wsarachai/smartfarm/web-server/wireframes/smart_farm_camera/screen.png

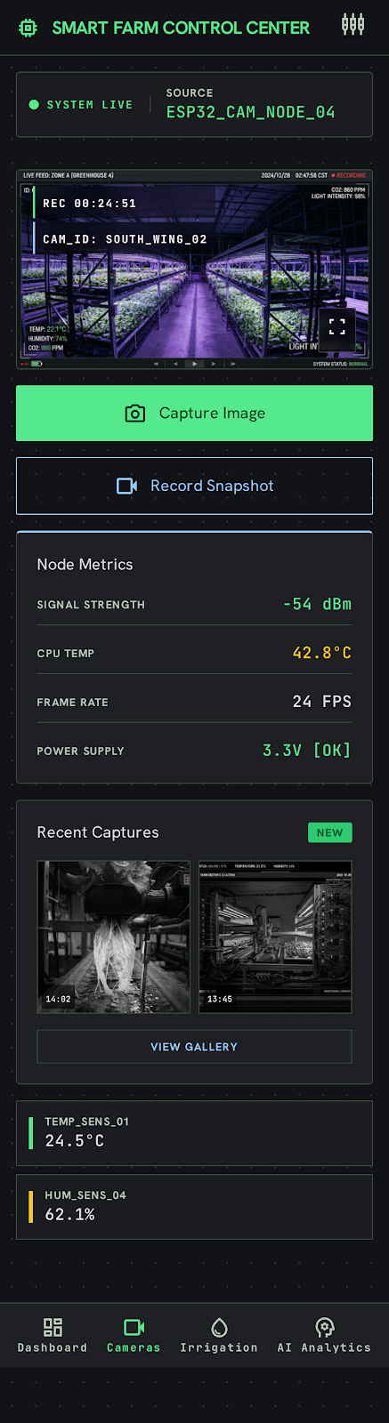
web-server/wireframes/smart_farm_camera/screen.png
