wsarachai/smartfarm/web-server/scripts/leaf.jpg

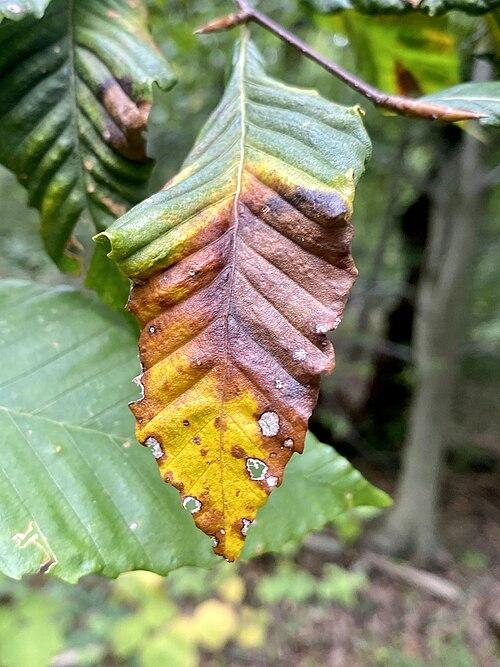
web-server/scripts/leaf.jpg
