wsarachai/smartfarm/water-temp-node/README.md

# water-temp-node

**Solar-powered** (24 V bank) **water + air** LoRa sensor node on a
**NUCLEO-WL55JC1** (STM32WL55JC). Every 15 minutes it wakes from **Stop2**, powers
the sensor rail through an **AO3401A P-MOSFET**, reads **water temperature from up
to six DS18B20 probes**, **air temperature + humidity from three remote SHT45s**
and **CO2** (Sensirion **SCD41** over I2C), measures the 24 V bank
through a divider, transmits one compact **AS923** LoRa uplink, and sleeps. It is
**uplink-only** — it never listens for a downlink.

**The MCU box lives outside the mushroom house; only sensors go inside.** Four
sensors sit at four places on ≤5 m cables, all four on the same I2C bus behind a
TCA9548A bus switch: SHT45s at the head of the house, at the tail, and one outside
as an ambient reference — and the **SCD41 at mid-house, at crop level**, which is
where CO2 stratifies and where a ventilation decision has to be made.

The probes and SHT45s sit on the **one gated rail**, so that part of the front-end
is dead between wakes; each probe owns its own pin, so all six convert **in
parallel** and rail-on time is one 750 ms conversion no matter how many are fitted.
**Everything is gated, including CO2** — the SCD41 takes on-demand single shots, so
so nothing on this board needs an always-on rail. See
[CO2 on a solar node](#co2-on-a-solar-node).

It does **not** talk to the web-server directly (that server only speaks HTTP on
the WiFi LAN). The uplink is received by [`../lora-gateway`](../lora-gateway),
whose host [`bridge`](../lora-gateway/bridge) POSTs it to `/api/v1/telemetry`.

```
water-temp-node --LoRa AS923--> lora-gateway --USB CDC JSON--> bridge.js --HTTP--> web-server:3000
```

## Signal chain

```
RTC wake (Stop2, 15 min)
  -> gate ON  (P-MOSFET, active-low)  -> settle 10 ms
  -> DS18B20 x6 start convert (12-bit, 750 ms)  <- one pin each, so they run
  |                                                CONCURRENTLY: 750 ms total,
  |                                                not 6 x 750 ms
  -> read probes P0..P5  (~7 ms each, inside the 750 ms conversion)
  -> SHT45 x3 read (~10 ms each)       -> air temp + humidity, one mux
  |                                       channel at a time (all three are 0x44,
  |                                       each at the end of its own 5 m cable)
  -> SCD41 CO2: 2x single shot (~10 s) <- LAST, still INSIDE the gate: 205 mA
  |  on mux ch3, warm-up shot discarded    bursts must not overlap the probes
  -> gate OFF -> park 1-Wire + I2C pins analog
  -> bank_mv: VREFINT (real VDDA) + 300k/30k divider on PB3
  -> pack 36-byte v5 frame -> LoRa TX (923.2 MHz SF9BW125, 14 dBm)
  -> radio cold-sleep -> Stop2
```

## Hardware / wiring

> Building the **real hardware**? It is two PCBs joined by a **cable** — the
> NUCLEO-WL55JC1 plus a large custom front-end carrying the six probe connectors,
> **four connectors for the remote I2C branches** (three SHT45s and the SCD41),
> the TCA9548A bus switch, the P-MOSFET gate, protection, and
> **a 24 V solar input feeding two off-the-shelf buck modules**. Logic
> travels one **2×19 IDC ribbon on morpho CN10**; the 3.3 V feed takes its own
> keyed 2-pin lead to **CN6**, deliberately kept off the ribbon so a reversed
> insertion cannot put the supply rail on a GPIO. See
> [`docs/hardware-interface.md`](docs/hardware-interface.md) for the full CN10
> pin map, the **eighteen** signals crossing the joint, the ribbon keying trick,
> the schematic + BOM, the power tree, and the bring-up order; and
> [`docs/sourcing-th.md`](docs/sourcing-th.md) for part numbers and where to buy
> them in Thailand. The wiring below is the bench setup.

Board: **NUCLEO-WL55JC1**. Powered from a **24 V solar bank behind a charge
controller** → a buck → **3.3 V** on the 3V3 domain at CN6-4. Radio uses the
board's TCXO (DIO3-powered) and the on-board RF switch.

Pins (see [`include/node_config.h`](include/node_config.h) — change to match your
build). They deliberately avoid the RF-switch pins **PC3/PC4/PC5**, SWD
**PA13/PA14**, and the TCXO **PB0**:

| Function | Pin  | Morpho |
|---|---|---|
| DS18B20 `DQ_P0` (1-Wire) | PA5  | CN10-11 |
| DS18B20 `DQ_P1` (1-Wire) | PA4  | CN10-17 |
| DS18B20 `DQ_P2` (1-Wire) | PA9  | CN10-19 |
| DS18B20 `DQ_P3` (1-Wire) | PC2  | CN10-21 |
| DS18B20 `DQ_P4` (1-Wire) | **PB8** | **CN10-27** |
| DS18B20 `DQ_P5` (1-Wire) | PB10 | CN10-25 |
| **SDA** (3x remote SHT45 via mux) | PA11 | CN10-5 |
| **SCL** (3x remote SHT45 via mux) | PA12 | CN10-3 |
| Sensor-rail power gate (P-MOSFET) | PA8  | CN10-16 |
| **24 V bank sense** (ADC1_IN2) | **PB3** | **CN10-31** |
| Signal grounds | — | CN10-9, CN10-20 |
| 3.3 V in (from the buck) | — | CN6-4 (own cable) |
| Debug log (**USART1 → 3-pin header**) | **PB6** (TX) / **PB7** (RX) | CN10-35/37 |

> **`DQ_P4` moved from PC1 to PB8** in 2026-08 to free PC1 for the Senseair S88.
> That sensor is gone and PC1 is free again, but `DQ_P4` **stays on PB8** — moving
> it back would churn the connector contract and the board for no gain.
> **The debug log moved off the ST-LINK VCP**: feeding 3V3 directly at CN6-4
> leaves the ST-LINK unpowered, and PA2/PA3 are not on the morpho at all — so
> USART1 goes out to a 3-pin header for a USB-serial adapter instead.

Every logic pin is on **morpho CN10**, so one 2×19 IDC ribbon carries the whole
interface — see [`docs/hardware-interface.md`](docs/hardware-interface.md). The
probe pins are not arbitrary: they were placed so each DQ line sits next to a
**GND or NC** position in the ribbon, since six bit-banged open-drain lines
sharing one flat cable is the new signal-integrity problem in this build.

The gate is **PA8** (CN10-16), inside the DQ block, so it rides the same ribbon
as the lines it powers. It has no boot strap on the WL (BOOT0 is PH3), so it
resets floating — which is what lets the external 100 k pull-up hold the sensor
rail off before firmware runs.

I2C is **PA11/PA12**. The alternatives are worse: I2C1 is **PA9/PA10** (PA9 is a
probe) and I2C3 is **PB10/PB11** (PB10 is a probe, and PB11 is the Nucleo's
LED3).

**The three SHT45s add no pins and no connector signals.** They sit behind a
TCA9548A bus switch, which is itself an I2C device. That is not a convenience:
the SHT4x address is fixed at the factory (`SHT45-AD1B` = 0x44, no address pin),
so three of them cannot share a bus — and power-gating them individually does
not work either. An unpowered SHT45 still clamps SDA/SCL to its own VDD through
its ESD diodes, so the bus pull-ups phantom-power it to ~2.7 V, where it answers
at 0x44 regardless. **What has to be switched is the bus, not the power.**

**The mux now does a second job.** Each channel drives its own ≤5 m cable to a
sensor somewhere else in the greenhouse, so only the selected branch's ~320 pF
loads the bus at any moment — three 5 m branches never add up to a 15 m bus. That
is what keeps plain I2C viable at this distance, and it is why the **downstream
pull-ups are 2.2 kΩ, not 4.7 kΩ**: at 5 m, 4.7 kΩ gives a 1.27 µs rise against a
1000 ns budget, so it passes on a bench lead and starts NACKing on the real cable.
**Nothing sits upstream of the switch** — the SCD41's 0x62 would not collide with
0x44, but it is 5 m away, and an unswitched branch would park ~320 pF on the bus
permanently. It gets **channel 3**. See
[`docs/hardware-interface.md`](docs/hardware-interface.md) §3.

Power gate + sensors (Q1 = **AO3401A** or equivalent — pick on the
R_DS(on) @ V_GS = −2.5 V row, not the −4.5 V one). The six probes, their pull-ups,
the bus switch, every I2C pull-up **and the SCD41** sit on the switched rail —
there is no always-on sensor rail in this revision:

```
                3V3 ──S│ Q1    │D──┬──────────── VSENS (switched rail)
                       │ (P-ch)│   │
              100k ────┤gate   │   ├──[4.7k]──┬── DQ_P0  (PA5)
             to 3V3    │       │   │          └── VDD P0
   (OFF when Hi-Z) ────┘       │   ├──[4.7k]──┬── DQ_P1  (PA4)
                  PA8 ─────────┘   │          └── VDD P1
              (LOW = ON)           │              ... x6, one per probe ...
                                   ├──[4.7k]──┬── DQ_P5  (PB10)
                                   │          └── VDD P5
                                   │
                                   ├──[4.7k]───── SDA (PA11) ─┬─ TCA9548A (0x70)
                                   ├──[4.7k]───── SCL (PA12) ─┘        │
                                   │      ch0 ─[2.2k x2]══5 m══ SHT45 #0  หัว
                                   │      ch1 ─[2.2k x2]══5 m══ SHT45 #1  ท้าย
                                   │      ch2 ─[2.2k x2]══5 m══ SHT45 #2  นอก
                                   └── GND rail ── probe + sensor GNDs

  24 V ─[F1]─[Q2]─[TVS]───[U7 TSR1-2433]─ 3.3 V ──> CN6-4 and Q1 above
```

The buck is a single **off-the-shelf module** — Traco **TSR 1-2433**, 36 V input,
1 A, three pins, no external network. A second module supplied 5 V until revision
2.0; nothing on the current BOM needs it. It
replaced two discrete TI LM5164 converters in revision 1.0 (2026-09) because ~30
hand-tuned passives were too much to get right on a first board; the price is a
36 V ceiling instead of 100 V and ~1.15 Wh/day of module no-load current. Why a
**36 V** module and not a cheaper 28 V one: a 24 V bank sits at 28.8 V every
afternoon. See [`docs/hardware-interface.md`](docs/hardware-interface.md) §5 *The
buck modules* ([ฉบับภาษาไทย](docs/hardware-interface.th.md)); the LM5164 design is
kept in [`docs/hardware-interface-back.md`](docs/hardware-interface-back.md).

Which probe is which is fixed by **which connector it is plugged into** — SKIP
ROM, no ROM addressing, so two probes can never get swapped in software and there
is no "which address is the inlet?" problem. That is also why each probe gets its
own pin rather than sharing one bus: a shorted or flooded probe takes down only
itself.

The **air** sensors are the opposite problem. All three SHT45s answer to the same
factory-fixed 0x44, so which one is which is decided by **which mux channel it is
wired to** (`I2C_MUX_CHANNELS` in `node_config.h`) — channel = frame slot =
dashboard metric name. Three identical parts are otherwise indistinguishable, so
silkscreen the channel number **and the destination** next to each: `CH0 หัว`,
`CH1 ท้าย`, `CH2 นอก`. Swapping two branch cables silently exchanges "inside the
greenhouse" for "ambient reference" and the data still looks plausible — label
both ends. CO2 needs no channel at all; it is not on this bus.

Fewer than six probes fitted? Leave the pin table alone and just don't plug them
in. An unconnected line sees no presence pulse, goes out as the invalid sentinel,
and is dropped by the gateway rather than showing up as a convincing `0.00 °C`.

> **The 205 mA CO2 burst is back on this rail**, and it is the number that sizes
> Q1: `VSENS` carries the six probes (~9 mA), the SHT45s and mux (µA) and the
> SCD41's 175 mA typ / 205 mA max bursts. `main.cpp` reads the SCD41 **last**, so
> those bursts never overlap a DS18B20 conversion. The AO3401A passes 205 mA with
> two orders of magnitude to spare. See the settle-time
> constraint in [`docs/hardware-interface.md`](docs/hardware-interface.md),
> because more bulk fights the 10 ms `DS_POWER_SETTLE_MS`.

## What goes over the air

A **36-byte binary** frame, **v5** (see
[`src/lora/lora_packet.h`](src/lora/lora_packet.h)):

| Bytes | Field | Notes |
|---|---|---|
| 0 | magic | `0xA5` = v5. Rejects noise and older/newer frames cheaply |
| 1–3 | node id, seq, flags | `flags` says which fields below are valid |
| 4–7 | probe 0, probe 1 | int16 centi-°C; sentinel `0x8000` if the probe failed |
| 8–9 | `battery_mv` | uint16 mV |
| 10–13 | `air_temp`, `humidity` | int16 centi-°C, uint16 %RH ×100 — **SHT45 #0** |
| 14–15 | `pressure` | uint16 deci-hPa; **0 on this node** (no barometer) |
| 16–17 | `co2` | uint16 ppm |
| 18–25 | probes 2, 3, 4, 5 | int16 centi-°C each; sentinel if absent or failed |
| 26–33 | air sensors 1, 2 | int16 centi-°C + uint16 %RH×100 each; sentinels if absent |
| 34–35 | reserved, CRC-8 | CRC over bytes 0..34 |

The gateway expands it to the server's `{device_id, metrics}` JSON and adds
`rssi`/`snr`. LoRa PHY (`src/lora/lora_params.h`) — **AS923 / 923.2 MHz / SF9 /
BW125 / CR4-5 / syncword 0x34-equiv / 14 dBm** — must stay identical to the
gateway's copy. Airtime grows ~41 ms per 8 bytes at SF9BW125: 20 B ≈ 185 ms,
28 B ≈ 226 ms, 36 B ≈ 267 ms. The whole v3→v5 growth costs ~4 mAs every 15
minutes — irrelevant beside a 24 V solar bank.

**Versioning:** v1 (12 B, water temps + battery), v2 (18 B, + BME280 ambient),
v3 (20 B, + CO2) and v4 (28 B, + probes 2–5) are still on the wire from other
builds and are **byte-for-byte unchanged**. Each version only appends, so a
field never moves, and `lora_packet_unpack()` accepts all five — an older node
in the field keeps working against a current gateway, and keeps its metric
names. (Verified, not asserted: regenerating the test vectors from the C header
after adding v5 reproduced every earlier vector byte for byte.)

**Probes 0 and 1 stay in the original two temperature slots.** That is deliberate:
the gateway labels them `temp_hot` and `temp_cold` by default (see
`lora-gateway/include/gateway_config.h`), so the dashboard's existing history is
one continuous series across the upgrade instead of dead-ending beside four new
ones. Probes 2–5 arrive as `temp_p2`…`temp_p5`. Rename any of them in the
gateway config to suit the install — but a renamed probe starts a **new** series.

**Air sensor 0 likewise keeps the v2 slots** (bytes 10–13) and its AIR/HUM flags,
so `air_temp`/`humidity` history is continuous; sensors 1 and 2 arrive as
`air_temp_2`/`humidity_2` and `air_temp_3`/`humidity_3`.

**v4 and v5 add no valid-flags, and cannot:** all eight `flags` bits are already
spoken for. Probes 2–5 and air sensors 1–2 therefore signal "no reading" with
sentinels — `LORA_TEMP_INVALID` for temperatures, `LORA_HUM_INVALID` (0xFFFF, a
value outside humidity's 0..10000 range) for humidity. Ask `lora_probe_valid()`,
`lora_air_valid()` and `lora_hum_valid()` rather than testing either mechanism by
hand — they know which slot uses which. A version that needs a genuine new flag
has to add a second flags byte.

`LORA_FLAG_SHT` (bit 7) says air temp/humidity came from an **SHT45** rather than
a BME280. Same units either way, so the receiver need not branch on it; it exists
so a swapped sensor is visible in the logs rather than silently changing what the
numbers mean.

## CO2 on a solar node

**This section has been rewritten twice, and the direction is the point.** It was
about rationing an SCD41; then about a Senseair S88 that could not be rationed at
all; it is now about a CO2 sensor that costs **0.0136 Wh/day** and is no longer
worth arguing about. The sensor is a **Sensirion SCD41** on I2C at `0x62`, on mux
channel 3, at mid-house crop level, and it is **power-cycled with everything else**.

### Why it goes back behind the gate

An NDIR CO2 sensor usually has to run continuously — warm-up, a filter needing
measurement history, a self-calibration period measured in days. None of those
bind here:

- **Warm-up** is handled per wake by a **throwaway first shot**. The first
  single-shot after the rail comes up reads low, so `scd41_read_single_shot(1)`
  takes two and discards one. ~10 s of sensor-on time per wake, and not optional.
- **Filter history** is irrelevant: τ63 is 60 s and the node samples every 15 min.
- **ASC is switched off here anyway** (below), so the 8-day period is moot — and
  the datasheet's warning that *ASC is unavailable in power-cycled single-shot
  operation* costs us nothing as a result.

So the node has **no always-on sensor rail at all**, and `SENS_GATE` can recover a
latched CO2 branch exactly as it recovers a latched SHT45 branch.

### ASC must be OFF, and this is the most dangerous default in the design

The SCD41 ships with **ASC enabled** and a 400 ppm baseline target. ASC assumes the
sensor sees outdoor air at 400 ppm for >3 minutes every week and calibrates the
lowest reading it has seen toward that.

**A mushroom house never reaches 400 ppm.** A well-ventilated fruiting room sits at
800–1500 ppm. ASC would drag every reading down, the controller would believe the
air is fine, the house would be **under-ventilated** — long stems, small caps —
and nothing on the dashboard would look wrong.

`scd41_ensure_asc()` therefore enforces ASC-off on **every** wake (a 1 ms read;
EEPROM is written only on a mismatch), and recalibration is done by hand with
**FRC in outdoor air at each crop changeover**, when the house is emptied and
cleaned anyway. Full procedure and its preconditions:
[`docs/hardware-interface.md`](docs/hardware-interface.md) §3.

### Why that is affordable

| Load | Draw | Per day |
|---|---|---|
| U7 no-load input current | 1 mA typ @ 24 V | **0.58 Wh** |
| MCU + LoRa + probes + SHT45s | ~1 mA avg @ 3.3 V | <0.1 Wh |
| Module conversion loss | | ~0.1 Wh |
| **SCD41** — 96 power-cycled single shots | 154 mC per useful shot | **0.0136 Wh** |
| **Total** | | **≈0.8 Wh/day** |

Against ~80 Wh/day from a 20 W panel at four peak-sun hours the whole node is
**~1 %** of the yield — of which **72 % is a regulator doing nothing** and the CO2
sensor is 3 %. There is no load left on this node worth optimising.

### The one thing the SCD41 is worse at

The SCD41 dissipates ~1.5 mW averaged, nowhere near enough to hold itself above
the dew point — and a sensor that runs a degree or two warm gets that protection
for free. **This board has no passive answer to condensation**, in a house that is
misted daily. A **heater resistor pad is laid out at the head and left DNP**:
~220 Ω / ~50 mW would add ~1.2 Wh/day, taking the node to ~2.0 Wh/day, still less
than this board drew before the 5 V rail was deleted. Whether to fit it is a
question for the SHT45 dew-point logs, not for the schematic.

### Staged deployment

1. **Build the full board and all cabling now** — including J12, the channel-3
   pull-ups and the heater pad. Nothing needs rework later.
2. **Deploy with the three SHT45s only.** Log T/RH for a few weeks, including at
   mid-house where the SCD41 will go, and compute the **dew point** — that, not RH
   alone, is what the sensor cares about.
3. **Fit the SCD41** (the `SEK-SCD41-SENSOR` breakout is the sane choice — the bare
   part is reflow-only), and the heater resistor only if the logs call for it.

Mount it in a vented, splash-protected housing with the **diffusion opening facing
downward**, behind a PTFE/Gore membrane, **never sealed**, and **not in a misting
nozzle's path**. **No radiation shield** — a mushroom house is dark.

**Why the F103 prototype also uses an SCD41:** it always did. The 2026-08 detour to
a Senseair part applied to the WL55 node only, and revision 2.0 brings the two back
into line — the same `src/scd41.{h,cpp}` driver now serves both.

## Build / flash

```
cd water-temp-node
pio run                 # first run pulls the STM32duino core (large, one-time)
pio run -t upload       # flash over the onboard ST-LINK (USB)
pio device monitor      # 115200 — shows the per-wake debug log
```

**Verified: compiles clean** — RAM 3.1%, Flash 15.5% of the STM32WL55JC.

### Why `framework = arduino`, not `stm32cube`

PlatformIO's ststm32 platform has **no** STM32Cube framework for the STM32WL
family (no `framework-stm32cubewl` package exists — the `nucleo_wl55jc` board only
advertises `arduino`/`zephyr`). **STM32duino *is* the STM32Cube HAL underneath**,
so the HAL SubGHz driver, DS18B20, and battery code compile unchanged; we only
enable `HAL_SUBGHZ` via `include/hal_conf_extra.h` (STM32duino's HAL override
hook). Deep sleep (Stop2) + RTC wake are done with **raw HAL** in `main.cpp` — we
avoid the STM32duino Low Power/RTC libraries because their 2.0.0 releases
hard-`#error` against the core PlatformIO bundles.

An **external ST-Link V2** works too (same `upload_protocol = stlink`): wire
SWDIO=PA13, SWCLK=PA14, NRST, GND, 3V3 and remove the onboard ST-LINK jumpers.

## Config knobs (`include/node_config.h`)

- `NODE_ID` — this node's wire id (the gateway maps it to `water-temp-01`).
- `WAKE_INTERVAL_S` — sleep interval (default `900`).
- `DS_*` pins, `DS_POWER_SETTLE_MS`, `DS_CONVERT_MS`.
- `I2C_SDA_PIN` / `I2C_SCL_PIN` / `I2C_CLOCK_HZ`, `SHT45_ADDR`,
  `I2C_MUX_ADDR` / `I2C_MUX_CHANNELS` (channel = greenhouse location = frame slot).
- `I2C_POWER_SETTLE_MS` — **10 ms**. It was 1000 ms for years, on the strength of
  an SCD41 power-up figure the datasheet does not give: SCD4x v1.7 Table 7 says
  **30 ms**. Corrected in 2026-09.
- `SCD41_ADDR` (`0x62`), `SCD41_MUX_CHANNEL` (3), **`SCD41_ASC_ENABLED` (0 — the
  factory default is 1 and it is wrong here)**, `SCD41_SITE_ALTITUDE_M` (330 m for
  Maejo; EEPROM-backed, unlike ambient pressure which would be lost every wake),
  and `SCD41_FRC_TARGET_PPM` for the service recalibration. See
  [CO2 on a solar node](#co2-on-a-solar-node).
- `VBAT_SENSE_PIN` / `VBAT_SENSE_NUM` / `VBAT_SENSE_DEN` — the 24 V divider.
  Change these two if you fit different resistors, or every reported bank voltage
  is wrong by exactly that ratio.
- `DEBUG_UART_ENABLED` / `DEBUG_UART_TX_PIN` / `DEBUG_UART_RX_PIN` — USART1 out to
  the 3-pin header, **not** the ST-LINK VCP. Comment out to drop serial logging.
- **Gone:** every `S88_*` symbol, and `CO2_ENABLED` / `CO2_EVERY_N_WAKES` /
  `CO2_SINGLE_SHOT_WARMUP` — the SCD41 is read once per wake with no pacing, and
  its warm-up is a discarded shot rather than a delay.

## DS18B20 bring-up test on an STM32F103C8T6 (Blue Pill)

While the NUCLEO-WL55JC1 boards are on back-order, extra PlatformIO envs let you
validate the DS18B20 wiring + the **same `ds18b20.cpp` driver** the node ships, on
a cheap Blue Pill — no LoRa, no sleep, just the sensor. **Hardware-verified:** both
probes read real, independent room temperature (`hot=23.75 C  cold=23.87 C`).

Two envs, differing only in how the readings get off the board — both reuse
`src/ds18b20.cpp` unchanged (`build_src_filter` compiles only that driver +
`src/test/ds18b20_test_main.cpp`; the WL55 firmware is filtered out, and vice-versa):

| Env | Output path | When to use |
|-----|---|---|
| `bluepill_f103c8` | **USB CDC** (`Serial`, the board's micro-USB) | if the board's native USB enumerates |
| `bluepill_f103c8_semihosting` | **semihosting over SWD** (the ST-Link) | no working USB / UART / adapter |

Output (~1 Hz), either path:

```
DS18B20 F103 test | hot=PB6 cold=PB7 | direct 3V3, external 4.7k pull-up
hot=23.62 C  cold=23.18 C
hot=23.62 C  cold=FAULT(no presence)
```
(the banner always states which pull-up the running build configured, so it can
never silently disagree with the wiring — see the switch below)

### Diagnosing a bad bus (`bluepill_f103c8_dump`)

When the test prints `FAULT(crc)` or a suspicious `0.00 C`, flash the dump env
instead: it probes each DQ pin electrically at boot, then prints the **raw 9-byte
scratchpad** + CRC verdict per probe (same pins, semihosting over SWD).

```
pio run -e bluepill_f103c8_dump -t upload
openocd -f interface/stlink.cfg -f target/stm32f1x.cfg \
        -c init -c "arm semihosting enable" -c "reset run"
```

Reading the output:

| Line | Meaning |
|---|---|
| `pull-up=1 pull-down=1` | a strong external pull-up (4.7 kΩ) is winning — wiring OK |
| `pull-up=1 pull-down=0` | **no** external pull-up; only the MCU's internal ~40 kΩ |
| `pull-up=0 pull-down=0` | DQ **held low** by something stronger than 40 kΩ — a short to GND, or the pull-up resistor tied to the GND rail instead of 3V3 |
| `FF FF FF …` | nothing drives the line — probe absent / DQ not connected |
| `00 00 00 …` | line stuck low (the fake-`0.00 C` case `ds18b20_read()` rejects) |
| `LO HI 4B 46 7F FF 0C 10 CRC` | a healthy 12-bit probe |

### Wiring (direct 3V3, **no** MOSFET gate — that's only for battery saving)

| Function | Blue Pill pin |
|---|---|
| DS18B20 **hot** data | PB6 |
| DS18B20 **cold** data | PB7 |
| Heartbeat LED (onboard) | PC13 |

Each probe: VDD→3V3, GND→GND, DQ→PB6/PB7, plus a pull-up on each DQ line.

**As wired today: an external 4.7 kΩ per line, DQ→3V3** — hardware-verified reading
both probes, with the dump env reporting `pull-up=1 pull-down=1` on both (the 4.7 kΩ
beating the MCU's internal 40 kΩ pull-down is the proof the resistor really is on
3V3). Mind that polarity: tying it to GND instead holds the bus low and every read
comes back all-zero (see *Diagnosing a bad bus* above).

### The pull-up switch

The pull-up is a fact about the **wiring**, so it lives in **one** place —
`ds18b20_pullup` in `[bluepill_base]` — and every F103 env interpolates it. Change
it there and reflash; no env needs touching:

| `ds18b20_pullup =` | Wiring it matches |
|---|---|
| *(empty)* | external 4.7 kΩ DQ→3V3 per probe; `ds18b20_init()` uses `GPIO_NOPULL` **← current** |
| `-D DS18B20_INTERNAL_PULLUP` | no resistor; the MCU's internal ~40 kΩ. Weaker, so a **short** bench bus only — never the WL55 node or a real cable run |

The WL55 env is separate and never sets the flag: the real node always has its
external resistors.

### Probe cable runs (design point: 5–10 m)

The node is built for **5–10 m** probe cables, and every value in
`docs/hardware-interface.md` §3 is sized for that. Plain 1-Wire covers it with
room to spare, and is good to **10–20 m** (per Maxim/ADI **AN148**) if you ever
extend — you do **not** need RS-485 for any of this. In particular a **MAX485 cannot
go on the DS18B20 data line**: 1-Wire is bidirectional open-drain with the
direction reversing *inside each bit slot*, while a MAX485 is a directional
differential UART transceiver (needs `DE/RE` control) and the DS18B20 only speaks
single-ended 1-Wire. RS-485 only helps if a small MCU at the sensor end digitizes
the reading first and sends it as serial/Modbus (an architecture change, warranted
only past ~30 m).

For a reliable 5–10 m run:

1. **External pull-up 4.7 kΩ** DQ→VDD **at the MCU end**. At the 10 m end of the
   range on Cat5 (~56 pF/m) the line reaches VIH in **~3 µs**, against the 9 µs
   the firmware allows between releasing the line and sampling it — 3× margin.
   Use **3.3 kΩ** if you run shielded (roughly double the capacitance per metre),
   and **2.2 kΩ** only past ~15 m. **Do not** use the internal ~40 kΩ
   (`DS18B20_INTERNAL_PULLUP`) on any real cable run — it is a bench-only
   shortcut.
2. **Twisted pair: DQ twisted with GND** (its return); VDD on a separate conductor.
   Cat5/telephone cable, one pair = DQ+GND. Biggest single reliability factor.
3. **3-wire power (VDD)** — already how the node is wired; never parasitic on long lines.
4. Optional: ~**100 Ω series** at the MCU DQ pin (reflection damping) + **100 nF**
   across VDD/GND at the sensor end.
5. Each probe is its **own point-to-point line** (separate GPIO) — no stubs, the
   most forgiving topology.

```
MCU DQ ──[100Ω opt]──┬─────── twisted pair (DQ + GND) ─────── DQ (DS18B20)
       [4.7k]→VDD ────┘
VDD ───────────────────── separate conductor ──────────────── VDD (+100nF)
GND ───────────────────── (paired with DQ) ─────────────────── GND
```

**Firmware:** no timing change needed (standard-speed slots are valid to ~100 m).
When you fit the external pull-up, **remove `-D DS18B20_INTERNAL_PULLUP`** from the
node env so `ds18b20_init()` uses `GPIO_NOPULL` + your resistor. If passive 2.2 kΩ
proves marginal past ~20–30 m, escalate to a **DS2483/DS2482** (I²C→1-Wire) or
**DS2480B** (UART→1-Wire) line-driver IC with hardware active pull-up.

### Option A — USB CDC (`bluepill_f103c8`)

```
pio run -e bluepill_f103c8 -t upload     # ST-Link V2 on the SWD header
pio device monitor -e bluepill_f103c8    # the board's micro-USB COM port
```

**USB caveat:** many Blue Pill *clones* have a wrong USB pull-up (R10 = 10 kΩ
instead of 1.5 kΩ) and never enumerate — no COM port appears at all. Fix with a
1.5 kΩ from PA12→3V3, or just use the semihosting env below (no USB needed).

### Option B — semihosting over SWD (`bluepill_f103c8_semihosting`)

Prints through the **ST-Link/SWD** you already use to flash — no USB, UART, or
adapter. The output shows only while a **debugger is attached** (the board's
`BKPT` faults standalone), so this is a bench-viewing mode.

**CLI:**
```
pio run -e bluepill_f103c8_semihosting -t upload
# then stream the readings (Ctrl+C to stop):
openocd -f interface/stlink.cfg -f target/stm32f1x.cfg \
        -c "init" -c "arm semihosting enable" -c "reset run"
```
(OpenOCD ships with PlatformIO at
`~/.platformio/packages/tool-openocd/bin/openocd` — pass its
`.../openocd/scripts` dir via `-s` if run from outside PlatformIO.)

**VSCode (PlatformIO extension):**
1. Bottom **status bar** → switch the active env to `env:bluepill_f103c8_semihosting`.
2. **Run → Start Debugging** (**F5**). It builds, flashes, and the env's
   `debug_extra_cmds = monitor arm semihosting enable` turns semihosting on.
3. It halts at `main()` — press **Continue (F5)**.
4. Readings stream into the **Debug Console** (`Ctrl+Shift+Y`); if empty, check the
   OpenOCD **Terminal** tab. Stop with the ■ button.

> Use **Debug (F5)**, not the Upload/Monitor buttons — the Monitor button grabs a
> serial COM port (semihosting isn't one), so it shows nothing here.

### The full prototype node (`bluepill_f103c8_node`)

Beyond the DS18B20-only bring-up envs, two envs run the **whole node** on the
Blue Pill — every sensor, the shared v3 frame, and an external **SX1278 at
433 MHz** talking to [`../lora-pi-receiver`](../lora-pi-receiver). This is where
the SHT45 and SCD41 drivers get their real-hardware hours before the WL55 boards
arrive, since both envs build the **same driver files** the WL55 node ships
(`build_src_filter`, no copies).

| Env | Output | Use |
|---|---|---|
| `bluepill_f103c8_node` | semihosting over SWD | Bench, with a debugger attached |
| `bluepill_f103c8_node_standalone` | none (silent) | Flash once, run from any USB/battery supply |

```
pio run -e bluepill_f103c8_node -t upload
```

Wiring beyond the DS18B20 probes (PB6/PB7):

| Part | Bus | Address | Supplies |
|---|---|---|---|
| BME280 | I2C2 PB10=SCL / PB11=SDA | `0x76` | `pressure` **only** |
| SHT45 | same bus | `0x44` | `air_temp` + `humidity` |
| SCD41 | same bus | `0x62` | `co2` |
| SX1278 | SPI1 | — | NSS=PA4 SCK=PA5 MISO=PA6 MOSI=PA7 RESET=PB0 DIO0=PB1 |

One pair of 4.7 k pull-ups serves the whole I2C bus. I2C**2** is used because
I2C1's PB6/PB7 are the DS18B20 probes.

Two behaviours differ from the WL55 node, deliberately:

- **The SCD41 runs in periodic mode** (free-running, one sample per 5 s) rather
  than single-shot. This board is mains-powered and awake continuously, so
  periodic is both simpler and more accurate — the cell stays warm.
- **The SHT45 supersedes the BME280 for temp/RH** (±0.1 °C / ±1 %RH beats it on
  both), and `LORA_FLAG_SHT` is set to record that. If the SHT45 does not answer,
  the BME280 takes those two fields back and the flag clears — a dead SHT45 costs
  accuracy, not telemetry.

The measured pressure is fed back to the SCD41 (`scd41_set_ambient_pressure`) for
CO2 density compensation, which is worth roughly 1 % of reading per 10 hPa.

> **Power:** the SCD41 peaks at ~205 mA. A marginal 3V3 LDO browns out
> mid-measurement, and the symptom looks like a flaky I2C bus rather than a power
> problem. Use a supply with headroom.

### Driver note
`ds18b20_read()` rejects an all-zero scratchpad: a data line stuck low (missing
pull-up / short) returns all zeros, which passes CRC (`crc8(0..0)=0`) and would
otherwise decode to a **fake 0.00 °C**. It now reports a fault instead — this
guard benefits the WL55 node too.

## Status / caveats

- **Compiles clean, but not yet hardware-verified.** `pio run` succeeds (RAM
  3.1%, Flash 15.5%); the radio, sleep current, and DS18B20 timing still need a
  real board. Do the first flash + monitor before trusting it.
- **The SHT45 and SCD41 are compile-verified only on this board.** Both drivers
  are hand-rolled from the datasheets against the shared
  [`sensirion_i2c`](src/sensirion_i2c.h) helper — no vendor library — and the
  wire format is cross-checked end to end (see below), but neither part has been
  on a WL55 yet. Bring them up on the F103 prototype env first, where the same
  driver files run against real sensors.
- **The frame format IS verified**, in both directions: the C header is compiled
  on the host to generate wire vectors, and
  [`lora-pi-receiver/test_lora_packet.py`](../lora-pi-receiver/test_lora_packet.py)
  decodes them, covering v1 through v5, a partly-populated six-probe node, a
  three-SHT45 node with only one sensor answering, a slot-0 failure, the
  `probe_valid()` / `air_valid()` / `hum_valid()` rules, and every single-byte
  corruption. Run it after any change to the wire format.
- The LoRa driver ([`src/lora/subghz_lora.c`](src/lora/subghz_lora.c)) is a lean,
  self-contained SX126x command driver over `HAL_SUBGHZ` — it does **not** vendor
  the full STM32CubeWL SubGHz_Phy middleware. RF-switch truth table and TCXO
  config are taken verbatim from ST's NUCLEO-WL55JC BSP.
- Advisory sensor only — this node never actuates anything.
