wsarachai/smartfarm/water-temp-node/docs/hardware-interface.th.md

# water-temp-node — สเปกอินเทอร์เฟซฮาร์ดแวร์

> **หมายเหตุเรื่องการแปล**
> เอกสารนี้เป็นฉบับแปลภาษาไทยของ [`hardware-interface.md`](hardware-interface.md)
> **ฉบับภาษาอังกฤษถือเป็นฉบับจริง (source of truth)** — เมื่อสองฉบับขัดแย้งกัน
> ให้ยึดฉบับภาษาอังกฤษ และเมื่อแก้สเปก **ต้องแก้ฉบับภาษาอังกฤษด้วยเสมอ**
> เพราะเป็นไฟล์ที่โค้ดเฟิร์มแวร์อ้างถึง
>
> สิ่งที่ **ไม่แปล** โดยเจตนา: เลขรุ่นอุปกรณ์ ชื่อขา (`PA8`) ชื่อสัญญาณ (`SENS_GATE`)
> ตำแหน่งขั้วต่อ (`CN10-16`) ชื่อตัวแปร/มาโครในโค้ด พาธไฟล์ และหน่วยวัด
> เพราะแปลแล้วใช้งานจริงไม่ได้
>
> **แผนภาพ ASCII ทุกอันคงไว้เป็นภาษาอังกฤษ** เพราะอักษรไทยมีความกว้างไม่คงที่
> ในฟอนต์ monospace ถ้าแปลข้างในแผนภาพจะเพี้ยนทั้งหมด — คำอธิบายภาษาไทยอยู่รอบ ๆ แทน

งานประกอบจริง (ไม่ใช่บนเบรดบอร์ด) คือ **PCB สองแผ่นเชื่อมกันด้วยสายเคเบิล**:

| บอร์ด | คืออะไร | มีอะไรอยู่บนนั้น |
|---|---|---|
| **Brain (สมอง)** | NUCLEO-WL55JC1 (ของสำเร็จรูป) | STM32WL55JC, ภาคสื่อสารวิทยุ, RF switch, TCXO, สายอากาศ, ST-LINK |
| **Front-end (ภาคหน้า)** | PCB ออกแบบเองขนาดใหญ่ ตามสเปกนี้ | **ขั้วต่อโพรบ DS18B20 6 ตัว**, **ขั้วต่อกิ่ง I2C ระยะไกล 4 เส้น** หลัง bus switch (SHT45 3 ตัว + หัววัด CO2 SCD41), เกตรางไฟ AO3401A, ตัวต้านทานพูลอัพ, วงจรป้องกันสาย, **อินพุตโซลาร์ 24 V และโมดูล buck สำเร็จรูปหนึ่งตัว** |

Front-end เป็น **บอร์ดใหญ่ที่วางอยู่ข้าง ๆ Nucleo** ไม่ได้ซ้อนทับ และเชื่อมกันด้วย
สายสั้น ๆ เอกสารนี้กำหนดรอยต่อนั้น: ตัวขั้วต่อ, สัญญาณที่วิ่งข้าม, และวงจร front-end
ที่อยู่หลังขั้วต่อ

ทุกอย่างในเอกสารนี้คือ **ข้อตกลงที่เฟิร์มแวร์สมมติไว้แล้ว** จุดไหนที่ค่าถูกบังคับด้วยโค้ด
จะมีการอ้างอิงโค้ดกำกับ — แก้อย่างหนึ่งต้องแก้อีกอย่างตามด้วย

- ตารางขาในเฟิร์มแวร์: [`include/node_config.h`](../include/node_config.h)
- การจัดการเกตและโหมดสลีป: [`src/main.cpp`](../src/main.cpp)
- รูปแบบเฟรมที่ส่งออกอากาศ (probe → metric): [`src/lora/lora_packet.h`](../src/lora/lora_packet.h)
- คำแนะนำเรื่องความยาวสาย: [README → *Probe cable runs*](../README.md)

> **รุ่น 2.0 (2026-09) — เซนเซอร์ CO2 เป็น Sensirion SCD41 บน I2C และระบบ RS-485
> หายไปพร้อมกับ Senseair S88 ที่ต้องใช้มัน** S88 ต้องการ 4.5–5.25 V และ Modbus
> บนสายคู่ดิฟเฟอเรนเชียล 5 ม. ซึ่งทำให้บอร์ดนี้ต้องมีเรกูเลเตอร์ตัวที่สอง ตัวรับส่งสองตัว
> LDO ที่หัววัด และสัญญาณ 3 เส้นจากทั้งหมด 18 เส้นที่ข้ามรอยต่อ ส่วน SCD41 ใช้ไฟ 3.3 V
> เดียวกับทุกอย่างบนบอร์ด พูด I2C ที่มี **CRC-8 ทุก word** และวัดแบบ single shot
> ตามคำสั่ง — มันจึงเข้าไปเป็นกิ่งที่สี่ของ bus switch และกลับไปอยู่หลัง `SENS_GATE`
> พร้อมกับ front-end ที่เหลือ contract ลดเหลือ **15 สัญญาณ** ราง 5 V และโมดูลของมัน
> ถูกลบ และงบพลังงานทั้งโหนดลงมาเหลือ **~0.8 Wh/วัน**
>
> สถานที่ติดตั้งคือ **โรงเรือนเพาะเห็ด** ซึ่งเป็นเหตุผลที่ต้องเปลี่ยนชิ้นส่วน: มืด,
> 90–95 %RH, ฉีดหมอก, 15–30 °C และมี CO2 สูงโดยตั้งใจ ข้อความที่เขียนไว้สำหรับ
> โรงเรือนพืช — ภาระความร้อนจากแดด, radiation shield, พืชดึง CO2 ลงตอนกลางวัน —
> ถูกแก้ทั้งเอกสาร ไม่ใช่เฉพาะในหัวข้อนี้
>
> รุ่น S88 เก็บไว้ที่ [`hardware-interface-s88.th.md`](hardware-interface-s88.th.md)
> และยังอ่านได้อยู่ เพราะ **S88 GH** คือทางถอยถ้าความต้องการช่วงวัด CO2 ขยายเกิน
> 400–5000 ppm ที่ SCD41 ระบุไว้ **ห้ามสร้างบอร์ดจากมัน**

> **รุ่น 1.0 (2026-09) — buck แบบ discrete ถูกถอดออกแล้ว** เดิม U6/U7 คือคอนเวอร์เตอร์
> constant-on-time TI LM5164 สองตัว พร้อมวงจรฉีดริปเปิล Type-3 ที่คำนวณด้วยมือ
> อุปกรณ์ passive ราว 30 ชิ้น และวงจรแบ่งแรงดัน UVLO ที่ใช้ร่วมกัน ทั้งหมดถูกแทนที่ด้วย
> **โมดูลสำเร็จรูป Traco TSR 1 สองตัว** (5 V และ 3.3 V, SIP-3, สามขาต่อตัว)
> ดีไซน์ LM5164 ฉบับเต็มเก็บไว้โดยไม่แก้ที่
> [`hardware-interface-back.th.md`](hardware-interface-back.th.md) — อ่านได้ถ้าวันหนึ่ง
> อยากได้กระแสนิ่งระดับ µA หรือพิกัดอินพุต 100 V กลับมา แต่ **ห้าม** สร้างบอร์ดจากมัน
> หัวข้อ *โมดูล buck* ใน §5 บันทึกว่าอะไรเปลี่ยนไปและอะไรที่ยอมเสีย

---

## 1. รอยต่อ — เลือกบัสแบบไหน และทำไม

ขั้วต่อโพรบ 6 ตัว ขั้วต่อสายเซนเซอร์ระยะไกล 4 เส้น วงจรป้องกัน buck สองตัว และอินพุตโซลาร์ 24 V
**ใส่ไม่ลง** ในขนาดบอร์ด ARDUINO 68.6 × 53.4 มม. เมื่อ front-end ต้องเป็นบอร์ดใหญ่
ของตัวเอง มันก็กลายเป็นอุปกรณ์ที่ต่อผ่านสาย ไม่ใช่อะไรที่เสียบซ้อนบน Nucleo อีกต่อไป
— และนั่นคือสิ่งที่ตัดสินคำถามเรื่องขั้วต่อ

### ข้อสรุปที่แนะนำ

**ใช้สองสาย แยกกันโดยเจตนา:**

| สาย | ส่งอะไร | ปลายฝั่ง Nucleo | ปลายฝั่ง Front-end |
|---|---|---|---|
| **สัญญาณ** | `SENS_GATE`, `DQ_Pn` 6 เส้น, `SDA`, `SCL`, `GND` 2 เส้น | **ซ็อกเก็ต IDC 2×20 ครอบ morpho CN10** โดยล้ำออกไปหนึ่งคอลัมน์ | box header **2×20** แบบมีกรอบและมีคีย์ |
| **ไฟเลี้ยง** | `V3V3_MCU`, `GND` | **ซ็อกเก็ต 1×8 ครอบเต็ม ARDUINO CN6** (ต่อจริงแค่ตำแหน่ง 4/6/7) | **เฮดเดอร์ 1×8 สะท้อนพินเอาต์ของ CN6 ทีละขา** |

สายสัญญาณ: ระยะพิทช์ 2.54 มม. สายแพสีรุ้ง **40 เส้น ใช้ทั้งเส้น** เข้าหัว IDC
แบบกดทั้งแพทั้งสองปลาย ความยาว **ไม่เกิน 30 ซม.**

### ทำไมเลือกแบบนี้ ไม่เลือกแบบอื่น

**ทำไมใช้ morpho ไม่ใช้ ARDUINO header** ขั้วต่อ ARDUINO เป็นแถวเดี่ยว 4 ชุด
(8/6/8/10) และให้ขา I/O ของ MCU มาแค่ **24 ขา** ถ้าต่อสายไปที่นั่นก็ต้องใช้ 4 สาย
และยังเข้าไม่ถึง PA8 ส่วน morpho **CN10** เป็นขั้ว 2×19 ชุดเดียวที่มีสัญญาณลอจิก
ครบทุกเส้นที่ดีไซน์นี้ต้องใช้ — สายแพเส้นเดียวจบ

**ทำไมใช้ซ็อกเก็ตยาวเต็มขั้ว ไม่ใช้ตัวสั้น** ซ็อกเก็ตที่กินความยาว CN10 ทั้งขั้ว
เหลือที่ให้วางน้อยที่สุด ในขณะที่ซ็อกเก็ต 1×10 บน ARDUINO header หรือ 2×5
บนบางส่วนของ morpho เสียบเยื้องได้ — และการเยื้องแค่หนึ่งตำแหน่งจะเลื่อนสัญญาณ
ทุกเส้นพร้อมกัน ซึ่งเป็นความผิดพลาดชนิดที่ไล่หาได้ทั้งบ่าย

> **ข้ออ้างนี้เคยแข็งกว่านี้ และความต่างนั้นสำคัญ** ตอนที่ซ็อกเก็ตยังเป็น 2×19
> มันกว้างเท่า CN10 พอดี การเยื้องจึง *เป็นไปไม่ได้ในเชิงเรขาคณิต* แต่ซ็อกเก็ต
> 2×20 ที่รุ่นนี้ใช้กว้างกว่าหนึ่งคอลัมน์ การเยื้องจึงกลับมาเป็นไปได้อีกครั้ง
> และสิ่งที่กันไว้แทนคือรูคีย์ที่อุดไว้ (§1 *การใส่คีย์ให้สายแพสัญญาณ*)
> การป้องกันจึงกลายเป็น *ขั้นตอนในการประกอบ* แทนที่จะเป็น *คุณสมบัติของชิ้นส่วน*
> ซึ่งอ่อนแอกว่า เพราะขั้นตอนถูกข้ามได้ **ห้ามข้าม**

**ทำไมแยกไฟออกมาเป็นอีกสาย และข้อนี้สำคัญที่สุด** ซ็อกเก็ตสายแพบนแถวขาที่ไม่มีกรอบ
*สามารถ* ถูกกดเสียบ **กลับด้าน 180°** ได้ ถ้า `V3V3_MCU` อยู่บนสายแพเส้นนั้น
การเสียบผิดครั้งเดียวจะเอาแรงดันรางไฟไปลงขา GPIO แต่ถ้าแยกไฟไปอยู่บนสาย 2 ขา
ที่มีคีย์ของตัวเอง สิ่งที่แย่ที่สุดที่สายแพกลับด้านทำได้ก็แค่ลัด GPIO แบบ open-drain
ลงกราวด์สองสามขาและสลับสัญญาณกัน — น่ารำคาญ แก้ได้ ไม่ถึงกับบอร์ดพัง
อีกทั้งยังกันกระแสจ่ายของไฟเลี้ยงออกจากมัดสายที่มี 1-Wire แบบ bit-bang 6 เส้น

**ทำไมไม่ใช้สายจัมเปอร์ Dupont** เพราะเป็นการย้ำหัว 12 จุดแยกกัน ไม่มีล็อก ไม่มีคีย์
ทุกจุดคือความล้มเหลวหน้างานที่รอรอบร้อน-เย็นรอบแรก ถ้าจะใช้แบบนั้นตอนทดสอบก็ได้
แต่อย่าส่งของออกไปแบบนั้น

**ทำไมไม่ใช้ RS-485 หรือลิงก์แบบดิฟเฟอเรนเชียลต่อโพรบ** เพราะที่ความยาวเท่านี้ไม่จำเป็น
สายโพรบยาว **5–10 ม.** และ 1-Wire ธรรมดารับได้ถึง 10–20 ม. (Maxim **AN148**)
ส่วน MAX485 *ต่อบนสาย 1-Wire ไม่ได้เลย*
ดูหัวข้อ "Probe cable runs" ใน README เกิน ~30 ม. ค่อยขยับไปใช้ไอซีไดรเวอร์ DS2483
ไม่ใช่ไปเปลี่ยนสายระหว่างสองบอร์ดนี้

### การทำคีย์ให้สายแพสัญญาณ — ทำเถอะ แทบไม่มีต้นทุน

**CN10-6 เป็น NC บน Nucleo** ดังนั้น:

1. **ตัด (หรือถอดบัดกรี) ขา CN10-6 ออก** ขานี้ไม่ได้ต่อกับอะไรเลย —
   วัดด้วยมัลติมิเตอร์ยืนยันก่อน แล้วค่อยเอาออก
2. **อุดรูที่ตรงกันในซ็อกเก็ต IDC** ด้วยตัวอุดคีย์ที่มักแถมมากับซ็อกเก็ต IDC
   หรือหยดอีพ็อกซี

รูที่อุดแล้วเสียบลงบนขาที่มีอยู่ไม่ได้ และ **CN10-6 เป็นขาเดียวที่ถูกตัดออก**
ซ็อกเก็ตจึงลงได้ในตำแหน่งเดียวเท่านั้นและปฏิเสธทุกตำแหน่งที่เหลือ
ตัวหยุดเชิงกายภาพดีกว่าลูกศรบนซิลค์สกรีนเสมอ

> **คีย์นี้ทำงานมากกว่าที่ออกแบบไว้ และนั่นคือสิ่งที่ทำให้ขั้ว 2×20 ปลอดภัย**
> J7 เป็นขั้ว **2×20** และสายเป็นริบบอน 40 ทางพร้อมซ็อกเก็ต 40 ทางทั้งสองปลาย (§4a)
> เพราะ 2×19 ไม่ใช่ขนาดที่ผู้ผลิต IDC รายใดทำ ที่ปลายฝั่ง Nucleo ซ็อกเก็ตจึงกว้างกว่า
> CN10 อยู่หนึ่งคอลัมน์ มันจะลงตรงหรือลงเหลื่อมหนึ่งคอลัมน์ก็ได้ — และการเหลื่อม
> หนึ่งคอลัมน์คือการเลื่อนทุกสัญญาณไปสองขา ซึ่งเป็นความล้มเหลวที่ร้ายที่สุดของขั้วนี้
>
> คีย์กันไว้อยู่แล้ว ตัวอุดอยู่ที่ตำแหน่ง 6 ซึ่งอยู่บนแถว **เลขคู่** ถ้าเลื่อนซ็อกเก็ต
> ไปหนึ่งคอลัมน์ ตัวอุดจะไปตรงกับ CN10-4 ซึ่งมีขาอยู่ ถ้าหมุน 180° ตัวอุดจะย้ายไปอยู่
> แถว **เลขคี่** ซึ่งขา 1 ถึง 37 มีอยู่ครบทุกขา จากสี่วิธีที่ซ็อกเก็ตนี้ถูกยกมาเสียบได้
> มีสามวิธีที่ถูกปิดด้วยรูที่อุดไว้เพียงรูเดียว
>
> ดังนั้น: ตัดขา CN10-6 และอุดรูที่ 6 ในรุ่นนี้มันไม่ใช่ของแถม

สิ่งที่ควรทำเพิ่มเติม:

- **พิมพ์สามเหลี่ยมชี้ขา 1 บนซิลค์สกรีน** ที่ box header ของ front-end
  และทำเครื่องหมายว่าแถบสีแดงของสายแพ = ขา 1 ที่ปลายทั้งสองข้าง
- **ขนาดขั้วที่ต่างกัน** ป้องกันการสลับสองสายอยู่แล้ว: สายแพ 40 ทาง เทียบกับสายไฟ 2 ขา

```
   ┌────────────────────────────────────────────┐
   │  FRONT-END PCB (large, custom)             │
   │  J1..J6 probe terminals · Q1 gate · TVS    │   <- this spec
   │  U3 mux -> J9..J12 (3x SHT45 + SCD41, 5 m) │
   │  U7 TSR 1-2433 · J14 24 V solar in         │
   │                                            │
   │   [2x20 box header, keyed]      [2-pin]    │
   └────────────┬──────────────────────┬────────┘
                │ 40-way ribbon        │ 3V3 + GND
                │ <= 30 cm             │ (keyed, latching)
   ┌────────────┴──────────────────────┴────────┐
   │  NUCLEO-WL55JC1                            │
   │  CN10 (2x19 morpho)              CN6 (1x8) │
   │  [antenna keep-out — keep the cable clear] │
   └────────────────────────────────────────────┘
```

**เชิงกล:** สายไม่ควรรับแรงใด ๆ ให้ใส่ **เสารองไนลอน M3** ที่รูยึดของบอร์ดทั้งสอง
และเพิ่ม **จุดรั้งสาย/เคเบิลไทร์** ภายในระยะ 30 มม. จากขั้วต่อแต่ละตัว ซ็อกเก็ต IDC
ที่ยึดด้วยแรงเสียดทานของหน้าสัมผัสเพียงอย่างเดียวจะคลอนหลวมจากการสั่นสะเทือน
และการขยายตัวตามอุณหภูมิ นานก่อนที่อะไรทางไฟฟ้าจะเสียเสียอีก

**เขตห้ามวางใกล้สายอากาศ:** อย่าเดินสายทั้งสองเส้นข้ามภาค RF ของ Nucleo หรือ
ขั้ว **CN12 SMA** ในดีไซน์นี้ทำได้ง่ายเพราะ front-end ไม่ได้อยู่เหนือภาควิทยุ —
แต่สายแพยาว 30 ซม. ที่พาดผ่านสายอากาศจะทำให้จูนเพี้ยน จึงต้องเดินสายอย่างตั้งใจ

---

## 2. สัญญาณที่วิ่งข้ามขั้วต่อ

**สิบห้า** สัญญาณ ตารางนี้ถือเป็นข้อตกลงตายตัว — นี่คือตัวอินเทอร์เฟซ
ตำแหน่งอื่น ๆ ทั้งหมดบน CN10 **ปล่อยไม่ต่อ** ที่ฝั่ง front-end

สังเกตสิ่งที่ *ไม่* อยู่ในตาราง: เซนเซอร์ระยะไกล **สี่ตัว** — SHT45 สามตัวกับ SCD41 —
**ไม่เพิ่มสัญญาณเลยแม้แต่เส้นเดียว** แม้จะอยู่คนละที่กันสี่จุดในโรงเรือนเห็ด
เพราะถูกแยกกันบน front-end ด้วย bus switch ซึ่งตัวมันเองก็เป็นอุปกรณ์ I2C (§3)
นั่นคือคุณสมบัติที่มีค่าที่สุดของอินเทอร์เฟซนี้: **จำนวนเซนเซอร์ไม่ผูกกับความกว้าง
ของขั้วต่อ**

> **ข้อตกลงเดินทาง 12 → 18 → 15 ให้ดูทิศทางของมัน** รุ่น 2026-08 ทำให้มัน *โต*:
> Senseair S88 เข้ามาแทน SCD41 และพูด UART/Modbus ไม่ใช่ I2C จึงพา
> `S88_TX`/`S88_RX`/`S88_DE` เข้ามา; ไฟเลี้ยงโซลาร์ 24 V ทำให้ MCU อยู่หลัง buck
> และทำให้วิธีอ่านแบตด้วย VREFINT ใช้ไม่ได้ จึงพา `VBAT_SENSE` เข้ามา; และ ST-LINK
> ที่ไม่ได้รับไฟทำให้ล็อกดีบักต้องมีขาของตัวเอง คือ `DBG_TX`/`DBG_RX`
>
> รุ่น 2.0 (2026-09) ทำให้มัน *เล็กลง*: SCD41 กลับมา สัญญาณ `S88_*` ทั้งสามจึงหายไป
> **`PC1`, `PC0` และ `PA7` ว่างแล้วและจงใจปล่อยไม่ใช้** — front-end ต้องไม่ต่อมัน
> ส่วน `DQ_P4` **อยู่ที่ PB8 ต่อไป** แม้ `PC1` จะว่างแล้ว การย้ายกลับจะทำให้ตารางนี้
> ตารางขาในเฟิร์มแวร์ และเลย์เอาต์บอร์ดต้องรื้อโดยไม่ได้อะไรกลับมา
>
> **บอร์ด front-end รุ่นเก่าใช้กับรุ่นนี้ไม่ได้ในทุกขั้น** — และบอร์ด 18 สัญญาณไม่ได้
> แค่มีของเกิน มัน *ผิด*: มันมีราง 5 V ที่ดีไซน์นี้ไม่ได้สร้างขึ้นมา

| สัญญาณ | ขา WL55 | ขั้วต่อ | ทิศทาง | คุณสมบัติทางไฟฟ้า | ถูกบังคับโดย |
|---|---|---|---|---|---|
| `V3V3_MCU` | — | **CN6-4** (`3V3`) | เข้าสู่ brain | **3.3 V ที่ผ่านการเรกูเลต** จาก buck 24 V, พีค ≤250 mA | §5 — *ไม่ใช่แบตเตอรี่อีกต่อไป* |
| `GND` (ไฟ) | — | **CN6-6/7** | — | เส้นทางกลับของไฟเลี้ยง แยกเส้นของตัวเอง | — |
| `SENS_GATE` | **PA8** | **CN10-16** | ออกจาก brain, push-pull | **LOW** = เปิดรางไฟ; Hi-Z = ปิดผ่าน 100 k | `node_config.h` `DS_PWR_*` |
| `DQ_P0` | **PA5** | **CN10-11** | สองทาง, open-drain | 1-Wire; พักเป็น **analog** ตอนสลีป | `node_config.h` `DS_PROBE_BUSES` |
| `DQ_P1` | **PA4** | **CN10-17** | สองทาง, open-drain | 1-Wire | `DS_PROBE_BUSES` |
| `DQ_P2` | **PA9** | **CN10-19** | สองทาง, open-drain | 1-Wire | `DS_PROBE_BUSES` |
| `DQ_P3` | **PC2** | **CN10-21** | สองทาง, open-drain | 1-Wire | `DS_PROBE_BUSES` |
| `DQ_P4` | **PB8** | **CN10-27** | สองทาง, open-drain | 1-Wire — ย้ายออกจาก PC1 ในปี 2026-08 และ **อยู่ที่นี่ต่อไป** | `DS_PROBE_BUSES` |
| `DQ_P5` | **PB10** | **CN10-25** | สองทาง, open-drain | 1-Wire | `DS_PROBE_BUSES` |
| `I2C_SDA` | **PA11** | **CN10-5** | สองทาง, open-drain | I2C @ 100 kHz; พักเป็น **analog** ตอนสลีป | `node_config.h` `I2C_SDA_PIN` |
| `I2C_SCL` | **PA12** | **CN10-3** | ออกจาก brain, open-drain | I2C @ 100 kHz | `node_config.h` `I2C_SCL_PIN` |
| `VBAT_SENSE` | **PB3** | **CN10-31** | เข้าสู่ brain, **analog** | แรงดันแบงก์ 24 V ที่ผ่านวงจรแบ่งแล้ว 0–3.0 V — ADC1_IN2 | `battery.cpp` |
| `DBG_TX` | **PB6** | **CN10-35** | ออกจาก brain, push-pull | USART1 TX, 115200 → เฮดเดอร์ดีบัก 3 ขา | `DEBUG_UART_*` |
| `DBG_RX` | **PB7** | **CN10-37** | เข้าสู่ brain | USART1 RX ← เฮดเดอร์ดีบัก | `DEBUG_UART_*` |
| `GND` (สัญญาณ) | — | **CN10-9**, **CN10-20** | — | เน็ตเดียวกัน (GND); ต่อ **ทั้งสองจุด** — ดู *Return เทียบกับ Guard* | — |
| `VSENS` | — | — | ภายใน front-end | ไฟ 3.3 V ที่ **ถูกสวิตช์** ไปเลี้ยงโพรบ, กิ่ง I2C **ทั้งสี่เส้น**, mux **และ** พูลอัพทั้งหมด | `main.cpp` `gate_on()` |

**front-end สร้างรางไฟภายในรางเดียวคือ `VSENS`** ถ้าเจอรางที่สองในแบบเก่าหรือบอร์ดเก่า
บอร์ดนั้นไม่ใช่ดีไซน์นี้ — ดูหมายเหตุด้านบน

**การกำหนดขนาด `V3V3_MCU`:** โหลดเดี่ยวที่ใหญ่ที่สุดยังเป็น **~150 mA ของ LoRa TX**
แต่ตอนนี้ SCD41 อยู่บนรางนี้ด้วยและกระแสพุ่งถึง **175 mA typ / 205 mA max** ขณะวัด
ทั้งสองตัวนี้ **ไม่เคยทำงานทับกัน** — วิทยุจะได้รับไฟหลังจากเกตปิดแล้วเท่านั้น
(§7 และ `main.cpp`) รางไฟจึงออกแบบที่ ~205 mA ไม่ใช่ผลบวกของทั้งสอง
ส่วนโพรบทั้งหกเพิ่มอีกราว 9 mA ตอนแปลงค่า

> **`VBAT_SENSE` เป็นสายอนาล็อกเส้นเดียวในสายแพ** อยู่ที่ CN10-31 ระหว่าง LED3
> (CN10-30 ปล่อยว่าง) กับ AGND (CN10-32 ปล่อยว่าง) ซึ่งเป็นย่านที่เงียบที่สุดบน
> ขั้วต่อ นี่คือเหตุผลที่มันไปอยู่ตรงนั้น ไม่ใช่ขาว่างข้าง ๆ สาย 1-Wire ที่ถูก
> bit-bang ให้กรองสัญญาณที่ฝั่ง front-end (ดู §5) และสุ่มอ่านตอนที่โพรบว่างอยู่

`VSENS` ถูกสร้างขึ้น **บน front-end** และไม่เคยวิ่งย้อนกลับไปที่ Nucleo
ไฟฟ้าที่ข้ามรอยต่อมีเพียง `V3V3_MCU` กับกราวด์ของมัน บนสายของตัวเองเท่านั้น
โมดูล buck และอินพุต 24 V ที่เลี้ยงมันอยู่บน front-end ทั้งหมด

### กฎสองข้อที่ front-end ต้องทำตาม

**1. ตัวพูลอัพต้องต่อกับ `VSENS` ห้ามต่อกับ 3V3 ที่จ่ายตลอดเวลา** ซึ่งตอนนี้มี
**สิบสี่ตัว** — 1-Wire หกตัว, คู่ I2C ฝั่งต้นทางหนึ่งคู่ และอีกหนึ่งคู่ต่อช่อง mux (§3)
ถ้าไปอยู่บนรางที่จ่ายตลอด อุปกรณ์ที่ถูกตัดไฟ
แต่ละตัวจะกลายเป็นเส้นทางกระแสรั่วผ่านไดโอดแคลมป์ของมัน แล้วรอบการทำงานทุก 15 นาที
ก็จะไม่มีความหมายอีกต่อไป ฟังก์ชัน `sensor_pins_park()` ใน `main.cpp`
พักขาทั้งหมดนั้นเป็น analog ด้วยเหตุผลเดียวกัน — บอร์ดต้องให้ความร่วมมือด้วย

**2. `SENS_GATE` เป็นแบบ active-low พร้อมพูลอัพ 100 k จากเกตไปซอร์ส**
ตัวต้านทานนี้ไม่ใช่ของเสริม: มันคือสิ่งที่กด **ปิด** รางไฟเซนเซอร์ไว้ขณะที่ PA8 เป็น Hi-Z
— ทั้งตอนรีเซ็ต ตอน BOOT0 และก่อนที่เฟิร์มแวร์จะเริ่มทำงาน

### ทำไมต้องเป็นขาเหล่านี้

**ตำแหน่งโพรบถูกเลือกจากความใกล้เคียงกันในสายแพ ไม่ใช่จากความสะดวก**
สาย 1-Wire แบบ bit-bang open-drain หกเส้นที่อยู่ในสายแพเส้นเดียวกัน คือปัญหา
signal integrity ที่แท้จริงเพียงข้อเดียวของดีไซน์นี้ ในสายแพ IDC มาตรฐาน
เส้นที่ *n* จะไปลงขาที่ *n* ดังนั้นสัญญาณที่ตำแหน่ง *p* จะถูกขนาบในสายด้วยตำแหน่ง
*p−1* และ *p+1* ขากราวด์ของ CN10 ถูกกำหนดมาตายตัวโดยบอร์ด — เพิ่มเองไม่ได้ —
สาย DQ ทั้งหกจึงถูกวางให้อยู่ติดตำแหน่ง **GND** หรือ **NC** เท่าที่ทำได้

```
   Conductor n of the ribbon lands on CN10 pin n, so a line's cable
   neighbours are simply pins n-1 and n+1:

   CN10 pin :    9   10   11   12   13   14   15   16   17   18   19   20   21   22   23   24   25   26
   carries  :  GND  [g]   P0    -    -    -    - GATE   P1  [g]   P2  GND   P3    -   P4  [g]   P5    -

   Every DQ line touches a GND (9, 20) or a guard [g] (10, 18, 24).
```

รายละเอียดเต็ม:

| โพรบ | ขา | CN10 | เพื่อนบ้านด้านล่าง | เพื่อนบ้านด้านบน |
|---|---|---:|---|---|
| `DQ_P0` | PA5 | 11 | **10 = NC** (guard) | 12 = PC6, ไม่ต่อ |
| `DQ_P1` | PA4 | 17 | 16 = `SENS_GATE` (ไฟ DC นิ่ง) | **18 = NC** (guard) |
| `DQ_P2` | PA9 | 19 | **18 = NC** (guard) | **20 = GND** ✅ |
| `DQ_P3` | PC2 | 21 | **20 = GND** ✅ | 22 = PB0, ไม่ต่อ |
| `DQ_P4` | PC1 | 23 | 22 = PB0, ไม่ต่อ | **24 = NC** (guard) |
| `DQ_P5` | PB10 | 25 | **24 = NC** (guard) | 26 = PB9, ไม่ต่อ |

`SENS_GATE` ที่ CN10-16 เป็นเพื่อนบ้านที่ไม่ก่อกวนสำหรับ `DQ_P1` โดยเจตนา:
มันเปลี่ยนสถานะแค่สองครั้งต่อการตื่นหนึ่งรอบ (15 นาที) นอกนั้นเป็นระดับ DC นิ่ง ๆ

#### Return เทียบกับ Guard

สองอย่างนี้ทำหน้าที่คนละแบบ และสายแพเส้นเดียวกันมีทั้งสองอย่าง
จึงควรระบุให้ชัดว่าเส้นไหนทำหน้าที่อะไร

**Return** คือ GND ธรรมดา ที่ต่อ **ทั้งสองปลาย** กระแสสัญญาณไม่ได้หายไปในขาปลายทาง
— มันไหลกลับ และไหลกลับตามเส้นกราวด์ที่ใกล้ที่สุด ถ้าให้เส้นกลับที่อยู่ใกล้
ลูปไป-กลับจะเล็ก ซึ่งคือสิ่งที่กันไม่ให้สาย bit-bang หกเส้นรบกวนกันเอง
ถ้าเส้นกลับอยู่ไกล ลูปจะใหญ่ และกลายเป็นสายอากาศทั้งรับและส่ง

CN10 มีตำแหน่ง GND ที่ใช้ได้เพียงสองจุดคือ **CN10-9** และ **CN10-20**
และทั้งสอง **เป็นเน็ตเดียวกัน** — ไม่มีกราวด์ "A" กับ "B" ที่นี่ มีกราวด์เดียว
แต่เข้าถึงได้สองจุด ให้ต่อทั้งคู่ ตำแหน่งของมันอยู่ในจุดที่ได้ประโยชน์สูงสุด:
CN10-9 ดูแลคู่ I2C และ `DQ_P0` ที่ปลายล่าง ส่วน CN10-20 อยู่กลางกลุ่มโพรบพอดี
(CN10-32 คือ **AGND** และใช้แทนกันไม่ได้ — การดันกระแสกลับฝั่งดิจิทัลผ่านกราวด์
อนาล็อกคือวิธีทำให้ `battery_read_mv()` เพี้ยน)

**Guard** เป็นคนละเรื่อง: ตำแหน่ง **6, 10, 18, 24 และ 34 ของ CN10 เป็น NC** บน Nucleo
เส้นเหล่านั้นจึงไม่ได้ต่อกับอะไรเลยที่ฝั่ง brain และสามารถผูกลง GND
**ที่ปลายฝั่ง front-end เท่านั้น** เมื่อกราวด์แค่ปลายเดียว เส้นนั้นจะนำกระแสกลับไม่ได้เลย
— มันทำงานเชิงประจุ เป็นฉากกั้นระหว่างเพื่อนบ้านสองข้าง มีประโยชน์ ได้มาฟรี
แต่ใช้แทน return จริงไม่ได้

| | กราวด์ที่ | นำกระแสกลับหรือไม่ | หน้าที่ |
|---|---|---|---|
| **Return** (CN10-9, CN10-20) | ทั้งสองปลาย | ใช่ | ทำให้ลูปกระแสเล็ก |
| **Guard** (CN10-6/10/18/24/34) | ฝั่ง front-end เท่านั้น | ไม่ | ฉากกั้นเชิงประจุระหว่างเพื่อนบ้าน |

> วัดด้วยมัลติมิเตอร์ยืนยันว่าตำแหน่ง NC เหล่านั้นเปิดวงจรจริงบนบอร์ด *ของคุณ*
> ก่อนจะต่อลงกราวด์ ในตาราง Table 18 ของ UM2592 ระบุว่าเป็น NC แต่การต่อกราวด์
> ลงตำแหน่งที่กลายเป็น GPIO คือการลัดวงจร

#### ในแผนผังวงจร ต้องเขียนอะไรลงบน J7

ทั้ง **40** ตำแหน่งต้องมีการตัดสินใจอย่างตั้งใจ และ "ต่อกราวด์ให้ขาว่างเพื่อความเรียบร้อย"
เป็นคำตอบที่ **ผิด** สำหรับ 21 ตำแหน่ง แบ่งเป็นห้ากลุ่ม — กลุ่มที่ห้าเป็นของใหม่
ในรุ่น 2×20 และลืมง่ายที่สุด เพราะสองตำแหน่งนั้นไม่มีอยู่บน Nucleo เลย:

> **ตารางนี้ผิดมาจนถึง 2026-09-04 และผิดในทิศทางที่แย่ที่สุด** มันยังบรรยายบอร์ด
> ก่อนรุ่น 2.0 อยู่: ให้ต่อเน็ตที่ **23** (`PC1` ซึ่ง `DQ_P4` ย้ายออกไปตั้งแต่ 2026-08)
> และให้ปล่อยลอย **27** (`PB8`, `DQ_P4`), **31** (`PB3`, `VBAT_SENSE`),
> **35** (`PB6`, `DBG_TX`) และ **37** (`PB7`, `DBG_RX`) ซึ่งเป็นสัญญาณตามข้อตกลงที่ใช้งานจริงทั้งสี่เส้น
>
> การทำตามมันทำให้เสียโพรบไปหนึ่งช่อง เสียการวัดแรงดันแบตเตอรี่ และเสียพอร์ตดีบัก
> **และธง no-connect ที่มันสั่งให้วางคือสิ่งที่ทำให้ ERC ไม่รายงานอะไรเลยสักอย่าง**
> ตารางสัญญาณด้านบนกับผังขา CN10 ด้านล่างถูกต้องมาตลอด มีตารางนี้ตารางเดียวที่หลุด
> เมื่อทั้งสามขัดกัน **ให้ยึดผังขา** เพราะมันคือตารางที่ถูกตรวจกับ UM2592
> และกับ `node_config.h`

| ตำแหน่ง | จำนวน | เขียนอะไร | เหตุผล |
|---|---:|---|---|
| 3, 5, 9, 11, 16, 17, 19, 20, 21, 25, **27**, **31**, **35**, **37** | 14 | **ชื่อเน็ต** | สัญญาณตามข้อตกลงจากตารางด้านบน รวมทั้ง GND return ทั้งสอง |
| 6, 10, 18, 24, 34 | 5 | **GND** | เป็น NC บน Nucleo การต่อกราวด์ที่ปลายนี้จึงปลอดภัย และได้ guard เชิงประจุมาด้วย |
| 1, 12, 13, 14, 15, **23**, 26, 28, 29, 30, 33, 36 | 12 | **ธง no-connect** | เป็นขา MCU จริงที่เราไม่ใช้ ปล่อยลอยไว้ |
| 2, 4, 7, 8, 22, 32, 38 | 7 | **ธง no-connect** | RF switch, TCXO, AVDD, AGND — ต่อกราวด์ตัวใดตัวหนึ่งคือทำบอร์ดพัง |
| **39, 40** | **2** | **ธง no-connect** | **ไม่มีอยู่บน Nucleo เลย** J7 เป็น 2×20 ส่วน CN10 เป็น 2×19 ตัวนำของคอลัมน์นี้จึงจบลงกลางอากาศเลยปลาย CN10 ห้ามต่อกราวด์: ตัวนำที่ต่อกราวด์แล้วปลายลอยคือเสาอากาศที่ถูกต่อเข้ากับทางกลับของสาย 1-Wire หกเส้น |

**ห้ามต่อกราวด์ให้ขา MCU ที่ไม่ได้ใช้เด็ดขาด** เพราะมันคือ GPIO:
ถ้าเฟิร์มแวร์สั่งให้ขานั้นเป็น push-pull ระดับสูงเมื่อไร ก็คือการลัดวงจรทันที
และตำแหน่ง 26/28/30 คือ LED ของผู้ใช้ ซึ่งจะกินกระแสตลอดเวลา
การปล่อยลอยคือคำตอบที่ถูก เพราะขาเหล่านั้นถูกตั้งค่าและเป็นของ Nucleo ไม่ใช่ของบอร์ดนี้

**ห้ามแตะกลุ่ม ⛔ ไม่ว่ากรณีใด รวมถึงการต่อกราวด์** การต่อกราวด์ที่ CN10-7 (`AVDD`)
คือการลัดแรงดันอ้างอิงของ ADC แล้ว `battery_read_mv()` จะไม่มีความหมายอีกต่อไป;
CN10-22 (`PB0`) คือไฟเลี้ยง TCXO ของภาควิทยุ; CN10-2/4/38 คือขาควบคุม RF switch;
CN10-32 คือ `AGND` ซึ่งเป็นกราวด์คนละตัวและต้องไม่นำกระแสกลับของสายแพเส้นนี้

**ใช้ธง no-connect ให้ชัดเจน อย่าปล่อยขาว่างเปล่า ๆ** ใน KiCad หรือ Altium
ขาที่ลืมต่อกับขาที่ตั้งใจไม่ต่อ หน้าตาเหมือนกันบนแผ่นแบบ มีแต่ธงเท่านั้นที่บันทึกเจตนา
และยังทำให้ ERC เงียบ เพื่อที่การลืมต่อ *จริง ๆ* จะโผล่มาเป็น error
แทนที่จะจมอยู่ในคำเตือน 22 อันที่คุณฝึกตัวเองให้มองข้ามไปแล้ว

> ตำแหน่งที่ต้องตรวจซ้ำก่อนสั่งผลิตคือตำแหน่ง **6** เพราะมันคือคีย์ (§1):
> ขาของมันถูกตัดออกที่ฝั่ง Nucleo และรูของมันถูกอุดในซ็อกเก็ต ดังนั้นเส้นนี้ตายที่ฝั่ง
> brain อยู่แล้วไม่ว่าทางใด — ซึ่งเป็นเหตุผลว่าทำไมจึงปลอดภัยที่จะต่อกราวด์ที่ฝั่งนี้
> ให้วัดยืนยันว่า 6, 10, 18, 24 และ 34 เปิดวงจรจริงบนบอร์ด *ของคุณ* ก่อนต่อกราวด์;
> การต่อกราวด์ลงตำแหน่งที่กลายเป็น GPIO คือการลัดวงจร

**`SENS_GATE` คือ PA8** (CN10-16) มันอยู่ในกลุ่ม DQ พอดี เกตกับสายที่มันจ่ายไฟให้
จึงเดินทางไปในสายแพเส้นเดียวกัน; ฟังก์ชันสำรองของขานี้ไม่ได้ถูกใช้ในดีไซน์นี้;
และ STM32WL ไม่มี boot strap ที่ขานี้ (BOOT0 คือ PH3 ส่วน nBOOT1 เป็น option byte)
มันจึงรีเซ็ตมาเป็นอินพุตลอย — ซึ่งตรงกับที่พูลอัพเกต 100 k ต้องการพอดี
เพื่อกดรางไฟให้ปิดไว้ก่อนเฟิร์มแวร์เริ่มทำงาน

**PA10 ถูกเว้นไม่ใช้โดยเจตนา** แม้จะเป็นขา 1-Wire ที่ดีมากก็ตาม เพราะมันอยู่บน
**CN7** ไม่ใช่ CN10 และสายเส้นเดียวไม่คุ้มกับการเพิ่มสายแพสัญญาณอีกเส้น

**I2C อยู่ที่ PA11/PA12** (CN10-5 / CN10-3) ทางเลือกอื่นแย่กว่า: I2C1 คือ PA9/PA10
(PA9 เป็นโพรบไปแล้ว) และ I2C3 คือ PB10/PB11 (PB10 เป็นโพรบ ส่วน PB11 คือ **LED3**
ของ Nucleo ซึ่งจะไปคร่อมอยู่บน SDA และกินกระแสทุกครั้งที่รับส่งข้อมูล)

> **มีป้ายชื่อหนึ่งจุดที่ต้องตรวจสอบ** Table 17 ของ UM2592 เรียก PA11/PA12 ว่า
> `I2C1_SDA`/`I2C1_SCL` แต่ไฟล์ `PeripheralPins.c` ของ STM32duino ซึ่งเป็นของ ST เอง
> และนิยามบอร์ดของ Zephyr ต่างระบุว่าเป็น **I2C2** เฟิร์มแวร์ไม่ได้รับผลกระทบทั้งสองทาง
> — STM32duino หาอินสแตนซ์จากตารางขา ไม่ใช่จากชื่อ — แต่ถ้าต้องรู้อินสแตนซ์จริง
> เพื่อพอร์ตแบบ bare-HAL ให้ไปดูตาราง alternate-function ของ RM0453
> แทนที่จะเชื่อแหล่งใดแหล่งหนึ่ง

> **SCL อยู่ระหว่างสายควบคุม RF switch ทั้งสองเส้นพอดี** (CN10-2 `PC4` และ
> CN10-4 `PC5`) ซึ่งเส้นเหล่านั้นเป็นปลายเปิดที่ฝั่ง front-end
> ที่ยอมรับได้ก็เพราะการแยกกัน *ในเชิงเวลา* เท่านั้น: เฟิร์มแวร์อ่านเซนเซอร์ทุกตัว
> ปิดรางไฟ แล้วจึงค่อยจ่ายไฟให้ภาควิทยุ บัส I2C จึงไม่เคยทำงานขณะที่สายเหล่านั้นสวิตช์
> **ห้ามสลับลำดับนี้ใน `main.cpp`** ถ้าวันหนึ่งจำเป็นต้องใช้ I2C พร้อมกับการส่งวิทยุ
> ให้กรีดแยกเส้นที่ 1–4 ออกจากสายแพ

### ผังตำแหน่งขา morpho CN10

นี่คือภาพที่ควรถือไว้ข้างบอร์ดขณะเดินสายขั้ว front-end — เป็นข้อมูลชุดเดียวกับ
ตารางด้านล่าง เพียงแต่จัดวางตามตำแหน่งจริงของขั้วต่อ

คำอธิบายสัญลักษณ์: `[+]` = front-end ต่อสายเส้นนี้ · `[K]` = คีย์ (ตัดขา อุดรูซ็อกเก็ต) ·
`[g]` = guard (ต่อ GND ที่ฝั่ง front-end เท่านั้น ห้ามที่ฝั่ง Nucleo) ·
`[X]` = ห้ามต่อ · `[!]` = ใช้ได้ แต่ให้อ่านหมายเหตุ · (ว่าง) = ปล่อยเส้นลอยที่ฝั่ง front-end

```
                  CN10 - 2x19 morpho, 2.54 mm
        Nucleo component side up. Odd pins are one row, even the other.
        Confirm pin 1 against the board's own silkscreen before wiring --
        this drawing fixes the ORDER, not which end of the board it starts.

        [+] front-end wires it      [K] key: clip pin, plug socket hole
        [g] guard: GND at the FRONT-END end only, never at the Nucleo
        [X] do NOT connect          [!] usable, but read the note
            (blank) leave the conductor floating at the front-end

   front-end                MCU     odd  even MCU     front-end
   ------------------------ ------- ---- ---- ------- ------------------------
       B1 button            PA0       1 o  o 2   PC4     [X] RF FE_CTRL1
   [+] I2C_SCL              PA12      3 o  o 4   PC5     [X] RF FE_CTRL2
   [+] I2C_SDA              PA11      5 o  o 6   NC      [K] KEY - clip this pin
   [X] VREF+ - do not load  AVDD      7 o  o 8   5V_USB_CHGR
   [+] GND return 1 of 2    GND       9 o  o 10  NC      [g] guard
   [+] DQ_P0                PA5      11 o  o 12  PC6         B3 button
       spare                PA6      13 o  o 14  PC0         spare
       spare                PA7      15 o  o 16  PA8     [+] SENS_GATE
   [+] DQ_P1                PA4      17 o  o 18  NC      [g] guard
   [+] DQ_P2                PA9      19 o  o 20  GND     [+] GND return 2 of 2
   [+] DQ_P3                PC2      21 o  o 22  PB0     [X] VDD_TCXO
   [+] DQ_P4                PC1      23 o  o 24  NC      [g] guard
   [+] DQ_P5                PB10     25 o  o 26  PB9         LED2
       spare                PB8      27 o  o 28  PB15        LED1
       spare                PB5      29 o  o 30  PB11        LED3
   [!] also TRACESWO        PB3      31 o  o 32  AGND    [X] not a signal return
       spare                PB12     33 o  o 34  NC      [g] guard
   [X] VCP TX               PB6/PA2  35 o  o 36  PA1         B2 button
   [X] VCP RX               PB7/PA3  37 o  o 38  PC3     [X] RF FE_CTRL3
```

### ตารางขา morpho CN10

ถอดความจาก **UM2592 Rev 1, Table 18** และตรวจสอบซ้ำกับไฟล์ PDF ด้วยสคริปต์
ขั้ว morpho ทั้งสองเป็นแบบ 2×19 ระยะ 2.54 มม.; ขาเลขคี่อยู่แถวหนึ่ง ขาเลขคู่อยู่อีกแถว
สัญญาณที่โหนดนี้ใช้จะเป็น **ตัวหนา** ✅; เครื่องหมาย ⛔ คือตำแหน่งที่ front-end
ต้องไม่ต่อ ส่วนตาราง CN7 อยู่ใน [ภาคผนวก A](#ภาคผนวก-a--st-morpho-cn7-ไม่ได้ใช้กับสายสัญญาณ)

| คี่ | ชื่อ | การใช้งาน | คู่ | ชื่อ | การใช้งาน |
|----:|---|---|---:|---|---|
| 1 | PA0 | ปุ่ม B1 — ปล่อยว่าง | 2  | PC4 | ⛔ RF switch FE_CTRL1 |
| 3 | **PA12**  | ✅ `I2C_SCL` | 4 | PC5 | ⛔ RF switch FE_CTRL2 |
| 5 | **PA11**  | ✅ `I2C_SDA` | 6 | NC | 🔑 **คีย์: ตัดขานี้** |
| 7 | AVDD | ⛔ VREF+ — ห้ามโหลด | 8 | 5V_USB_CHGR | ปล่อยว่าง |
| 9 | **GND** | ✅ GND return 1 จาก 2 | 10 | NC | guard (GND ที่ฝั่ง front-end เท่านั้น) |
| 11  | **PA5** | ✅ `DQ_P0` | 12 | PC6 | ปุ่ม B3 — ปล่อยว่าง |
| 13  | PA6 | สำรอง | 14 | PC0 | สำรอง — **ว่างในรุ่น 2.0** ปล่อยไม่ต่อ |
| 15  | PA7 | สำรอง — **ว่างในรุ่น 2.0** ปล่อยไม่ต่อ | 16 | **PA8** | ✅ `SENS_GATE` |
| 17  | **PA4** | ✅ `DQ_P1` | 18 | NC | guard (GND ที่ฝั่ง front-end เท่านั้น) |
| 19  | **PA9** | ✅ `DQ_P2` | 20 | **GND** | ✅ GND return 2 จาก 2 |
| 21  | **PC2** | ✅ `DQ_P3` | 22 | PB0 | ⛔ VDD_TCXO |
| 23  | PC1 | สำรอง — **ว่างในรุ่น 2.0** ปล่อยไม่ต่อ | 24 | NC | guard (GND ที่ฝั่ง front-end เท่านั้น) |
| 25  | **PB10**  | ✅ `DQ_P5` | 26 | PB9 | LED2 — ปล่อยว่าง |
| 27  | **PB8** | ✅ `DQ_P4` (ย้ายจาก PC1) | 28 | PB15  | LED1 — ปล่อยว่าง |
| 29  | PB5 | สำรอง | 30 | PB11 | LED3 — ปล่อยว่าง |
| 31  | **PB3** | ✅ `VBAT_SENSE` (ADC1_IN2) | 32 | AGND | ⛔ กราวด์อนาล็อก ไม่ใช่เส้นกลับสัญญาณ |
| 33  | PB12 | สำรอง (ช่วยกันซ็อกเก็ตกลับด้าน) | 34 | NC | guard (GND ที่ฝั่ง front-end เท่านั้น) |
| 35  | **PB6** | ✅ `DBG_TX` (USART1 TX) | 36 | PA1 | ปุ่ม B2 — ปล่อยว่าง |
| 37  | **PB7** | ✅ `DBG_RX` (USART1 RX) | 38 | PC3 | ⛔ RF switch FE_CTRL3 |

> **ข้อผิดพลาดในเอกสารต้นทาง** UM2592 Rev 1 พิมพ์ขา CN10 ตำแหน่ง 37 ว่า "PB6 / PA3"
> แต่ที่ถูกคือ **PB7 / PA3** เพราะ PB6 อยู่ที่ขา 35 ไปแล้ว และ PB7 ไม่ปรากฏที่อื่นเลย
> ในตารางที่คำนำของมันเองระบุว่ามี I/O ของ MCU *ครบทุกขา* บน morpho อีกทั้งหมายเหตุ
> เหนือตารางนั้นก็ระบุว่า D0/D1 คือ USART1 บน **PB6 และ PB7** ไฟล์ variant ของ
> STM32duino ซึ่งเป็นของ ST เองก็ตรงกัน (`D0 = PB7` และ `PA3` "อาจอยู่ที่ D0")
> ตารางด้านบนใช้ค่าที่แก้ไขแล้ว

ยังเหลือขา I/O สำรองอีกสามขา (**PA6, PB5, PB12**) เผื่องานรุ่นถัดไปต้องใช้ —
และ **ไม่มีขาไหนทำ ADC ได้เลย** `PinMap_ADC` วาง ADC1 ไว้ที่ PA10–PA15, PB1–PB4,
PB13, PB14 ซึ่งในจำนวนนั้นมีเพียง **PB3** ที่อยู่บน CN10 และยังไม่ถูกใช้
(PA11/PA12 คือคู่ I2C, PA13/PA14 คือ SWD, ที่เหลืออยู่บน CN7 หรือไม่ได้ต่อออกมา)
นั่นคือเหตุผลที่ `VBAT_SENSE` ต้องไปอยู่ที่ PB3 และเหตุผลที่ **ไม่มีอินพุตอนาล็อก
เหลืออีกแล้ว** ถ้ารุ่นถัดไปต้องการอีกหนึ่งช่อง ต้องไปเอาจาก CN7

### ห้ามเดินสายไปที่ขาเหล่านี้

ทุกตำแหน่งต่อไปนี้เข้าถึงได้จริงบน CN10 ดังนั้น front-end ต้องหลีกเลี่ยงมันด้วยเจตนา
ไม่ใช่ด้วยข้อจำกัดทางกายภาพ:

| ตำแหน่ง | สัญญาณ | เหตุผล |
|---|---|--- |
| CN10-2, -4, -38 | PC4, PC5, PC3 | **RF switch** FE_CTRL1/2/3 — ภาควิทยุเป็นเจ้าของ |
| CN10-22 | PB0 | **VDD_TCXO** — ไฟเลี้ยงตัวอ้างอิงของภาควิทยุ |
| ~~CN10-35, -37~~  | PB6, PB7 | **ใช้แล้ว** — `DBG_TX`/`DBG_RX`; ดูหมายเหตุด้านล่าง |
| CN10-7 | AVDD / VREF+ | **แรงดันอ้างอิง** การโหลดขานี้ทำให้ `battery_read_mv()` เพี้ยน |
| CN10-32 | AGND | กราวด์อนาล็อก — ห้ามใช้เป็นเส้นกลับสัญญาณ |
| ~~CN10-31~~ | PB3 | **ใช้แล้ว** — `VBAT_SENSE` เสียแค่ TRACESWO เท่านั้น |
| CN10-1, -36, -12  | PA0, PA1, PC6 | ปุ่มผู้ใช้ B1/B2/B3 — มีสวิตช์ + พูลอัพติดตั้งอยู่แล้ว |
| CN10-26, -28, -30 | PB9, PB15, PB11  | LED ผู้ใช้ — LED คร่อมสาย 1-Wire ทำให้ใช้ไม่ได้ |
| CN7-13/15 | PA13, PA14 | **SWD** — เว้นไว้ให้ดีบักเกอร์ |

SWD ที่ CN7-13/15 เข้าถึงได้ ดังนั้น front-end จะเดินสายดีบักออกไปยัง test header
ก็ได้ถ้าต้องการ — เพียงแต่อย่าเดินผ่านสายแพ CN10

> **ทำไม CN10-35/37 ถึงเลิกเป็นขาต้องห้าม** เดิมมันเป็น ⛔ เพราะเข้าใจว่าเป็น
> ST-LINK VCP ซึ่งไม่จริง: **PA2/PA3 ไม่ได้ออกมาที่ morpho เลย** (ดูภาคผนวก A —
> ไม่มีอยู่ใน CN7) และทั้งหมายเหตุของ UM2592 เองกับไฟล์ variant ของ STM32duino
> ต่างระบุว่า **D0/D1 = USART1 บน PB6/PB7** ที่ตำแหน่งเหล่านั้น ส่วน `/PA2`, `/PA3`
> ในตาราง 18 คือ *ทางเลือกผ่าน solder bridge* ไม่ใช่ค่าเริ่มต้น และเมื่อ §5
> จ่ายไฟ `3V3` เข้าที่ CN6-4 โดยตรง ST-LINK จึง **ไม่ได้รับไฟโดยเจตนา** —
> "ฟีเจอร์โปรแกรมและดีบักใช้ไม่ได้ เพราะ ST-LINK ไม่ได้รับไฟ" — VCP จึงใช้งาน
> หน้างานไม่ได้อยู่แล้ว ล็อกดีบักจึงใช้ PB6/PB7 ออกไปที่เฮดเดอร์ 3 ขาของตัวเอง
> แล้วต่อ USB-serial adapter เอา **ให้ตรวจสอบ solder bridge บนบอร์ดจริงก่อนออกแบบ
> PCB** — นี่เป็นจุดเดียวในเอกสารนี้ที่อ้างอิงค่าเริ่มต้นของ bridge แทนการวัดจริง

> **ข้อควรระวัง รูปแบบเดียวกับกรณี SCL** `DBG_RX` ที่ CN10-37 อยู่ติดกับ
> **CN10-38 = PC3** (RF switch FE_CTRL3) ต่างจากกรณี I2C ตรงที่ดีบัก UART *อาจ*
> ทำงานขณะภาควิทยุสวิตช์ เพราะการล็อกเกิดระหว่าง TX มันคือ 115200 baud เทียบกับ
> สายควบคุมที่ช้ามาก ความเสี่ยงจึงต่ำ — แต่อย่าย้ายอะไรที่เร็วกว่านี้มาไว้ที่
> CN10-37 และถ้าเห็นไบต์ล็อกเพี้ยนเฉพาะตอนส่งอัปลิงก์ นี่คือสาเหตุ

### จุดต่อไฟที่ CN6

| ขา | ชื่อ | การใช้งาน |
|----:|---|-----|
| 1 | NC | — |
| 2 | IOREF | — |
| 3 | NRST | — |
| 4 | **3V3** | ✅ **ไฟ 3.3 V จาก buck เข้า** |
| 5 | 5V | — |
| 6 | **GND** | ✅ เส้นกลับของไฟเลี้ยง |
| 7 | **GND** | ✅ เส้นกลับของไฟเลี้ยง |
| 8 | VIN | อินพุต 7–12 V, ไม่ได้ใช้ |

ให้ใช้ **ซ็อกเก็ต 1×8 ครอบเต็มขั้ว** โดยต่อสายจริงเฉพาะตำแหน่ง 4, 6 และ 7
ซ็อกเก็ตที่สั้นกว่าจะเลื่อนไปตามแถวได้ และอาจเอา `V3V3_MCU` ไปลงที่ `NRST` หรือ `5V`
ส่วนตัวที่ยาวเต็มขั้วทำแบบนั้นไม่ได้ `CN7-16` เป็นเน็ต 3V3 เดียวกันถ้าอยากจ่ายไฟ
จากฝั่ง morpho แทน — แต่ก็ต้องใช้ซ็อกเก็ตยาวเต็มขั้วเช่นกัน มิฉะนั้นก็กลับไปเจอ
ขั้วต่อที่เลื่อนได้อีก

> **ต้องใส่คีย์ให้สายเส้นนี้ด้วย การครอบเต็มขั้วกันการเลื่อนได้ แต่กันการเสียบ
> กลับด้านไม่ได้** ตั้งแต่ 2026-09-04 บอร์ด front-end มี **เฮดเดอร์ 1×8 ของตัวเอง
> ที่สะท้อน CN6** — ขั้วต่อไฟ 2 ขาแบบมีคีย์อย่าง J8 ถูกลบไปแล้ว — ปลายทั้งสองข้าง
> ของสายจึงเป็น 1×8 เหมือนกัน และเสียบกลับด้าน 180° ได้ทั้งคู่
>
> ดูจากตารางด้านบนว่าสายที่กลับด้านทำอะไร: ตำแหน่ง 4 ไปลงที่ **5** คือดัน 3.3 V
> ของบอร์ดเข้ารางไฟ `5V` ของ Nucleo, ตำแหน่ง 6 ไปลงที่ **3** คือกด `NRST` ไว้ที่
> กราวด์, ตำแหน่ง 7 ไปลงที่ **2** คือกราวด์ `IOREF` ผลคือ MCU ค้างรีเซ็ตถาวรเพราะสาย
> และอาการที่เห็นคือ "บอร์ดตาย" ไม่ใช่ "สายเสียบกลับ"
>
> **CN6-1 เป็น NC** (ตารางด้านบนบอกไว้) จึงใช้กลไกเดียวกับที่ §1 ใช้กับ CN10 ได้:
> **ตัดขา CN6-1 และอุดรูที่ 1** พอหมุนกลับด้าน ตัวอุดจะไปตรงกับตำแหน่ง 8 คือ `VIN`
> ซึ่งมีขาอยู่ ซ็อกเก็ตจึงเสียบไม่ลง
>
> นี่คือการป้องกันที่เคยได้มาฟรีจากการที่ J8 เป็นขั้ว 2 ขามีคีย์ซึ่งเสียบเข้ากับ
> อะไรอื่นไม่ได้เลย การลบ J8 ย้ายความปลอดภัยข้อนี้จาก *ชิ้นส่วน* ไปเป็น
> *ขั้นตอนการประกอบ* ซึ่งอ่อนแอกว่า — ต้องทำ

---

## 3. วงจร front-end ของเซนเซอร์

มีสองโดเมนการวัดที่เป็นอิสระต่อกันแต่ใช้รางไฟที่ถูกสวิตช์ร่วมกัน: **โพรบ 1-Wire**
(อยู่นอกบอร์ด บนสาย) และ **เซนเซอร์อากาศ I2C** (อยู่บนบอร์ด) ทั้งสองไม่มีอะไร
เกี่ยวข้องกันทางไฟฟ้าเลยนอกจาก `VSENS` และ GND

### โพรบ 1-Wire — หกช่องเหมือนกันทุกประการ

หนึ่งสายต่อหนึ่งโพรบแบบจุดต่อจุด **ไม่ใช้บัสร่วม** และนี่คือการตัดสินใจเชิงออกแบบ
ไม่ใช่อุบัติเหตุทางประวัติศาสตร์:

- มันคือสิ่งที่ทำให้ **SKIP ROM** ของไดรเวอร์ถูกต้องตามหลัก — ไม่ต้องค้นหา ROM
  ไม่ต้องจดรหัส ROM ไม่มีปัญหา "แอดเดรสไหนคือโพรบขาเข้า" ตัวตนของโพรบคือ
  "เสียบอยู่ที่ขั้วไหน" เท่านั้น
- ทั้งหกตัวแปลงค่า **พร้อมกัน**: `main.cpp` สั่งเริ่มแปลงทุกตัว รอครั้งเดียว แล้วค่อยอ่าน
  โพรบหกตัวใช้เวลาแปลง 750 มิลลิวินาทีครั้งเดียว ไม่ใช่หกครั้ง
- **โพรบที่ลัดวงจรหรือน้ำเข้าจะพังแค่ตัวเอง** ถ้าอยู่บนบัสร่วม มันจะลากอีกห้าตัวไปด้วย
  — ซึ่งเมื่ออยู่บนเสากลางทุ่ง นั่นคือความต่างระหว่าง "ค่าเสียหนึ่งตัว" กับ "โหนดตายทั้งตัว"

ต้นทุนคือขา 6 ขา (เหลือว่างอยู่ 15 ขา) และชุดอุปกรณ์พาสซีฟ 6 ชุด — สามชิ้นต่อช่อง
บน PCB และอีกหนึ่งชิ้นที่ตัวโพรบ

เขียนเป็นรายการการเชื่อมต่อ (connection list) เพราะแผนผัง ASCII ของวงจรนี้
ลงเอยด้วยการลากขาของตัวเก็บประจุ 100 nF ตัดผ่านสาย DQ เสมอ ซึ่งอ่านแล้วเหมือน
เป็นจุดต่อทั้งที่ไม่ใช่:

```
   ONE channel, n = 0..5.  Repeat SIX times.
   "DQ node" is the front-end net between the series resistor and the connector.

   ON THE FRONT-END PCB
     VSENS      --[4.7k]--   DQ node        pull-up, on the SWITCHED rail
     MCU DQ_Pn  --[100R]--   DQ node        series damping
     DQ node    --[TVS ]--   GND            bidirectional, <50 pF

   ACROSS THE CABLE   (3 conductors; DQ twisted with GND)
     VSENS      -----------  probe V   (VDD)
     DQ node    -----------  probe DQ  (data)
     GND        -----------  probe G   (GND)

   AT THE PROBE  (far end of the cable)
     probe V    --[100nF]--  probe G        <-- VDD to GND.
                                                NOT to DQ. See below.
```

**ต่อหนึ่งช่องคือสามชิ้นบน PCB และหนึ่งชิ้นที่โพรบ:** พูลอัพ 4.7 kΩ หนึ่งตัว
ตัวต้านทานอนุกรม 100 Ω หนึ่งตัว และ TVS หนึ่งตัวบนบอร์ด บวกกับ **100 nF หนึ่งตัว
ที่ปลายไกลของสาย คร่อมขา VDD และ GND ของโพรบตัวนั้น**

> **100 nF ไม่เคยแตะสาย DQ และถ้าเอาไปต่อตรงนั้นบัสจะตายสนิท ไม่ใช่แค่แย่ลง**
> 100 nF เทียบกับพูลอัพ 4.7 kΩ ให้ค่า RC เท่ากับ **470 µs** แต่ช่วงอ่านของ 1-Wire
> ต้องการให้สายกลับขึ้นสูงภายในราว **9 µs** หลังปล่อย ซึ่ง ณ จุดนั้นแรงดันจะขึ้นไปได้
> เพียง **2 % ของ VDD**; แม้แต่หน้าต่างตรวจ presence ที่ 70 µs ของสัญญาณรีเซ็ต 480 µs
> ก็ขึ้นได้แค่ 14 % จะไม่มีอะไรตอบกลับเลย เทียบให้เห็นภาพ: เอกสารนี้จำกัด *TVS*
> บนโหนดเดียวกันไว้ที่ **< 50 pF** — 100 nF คือ **2000 เท่า** ของงบนั้น
> ค่าคาปาซิแตนซ์เดียวที่ DQ ยอมให้มีได้คือสิ่งที่สายเคเบิลพามาอย่างหลีกเลี่ยงไม่ได้
> ที่ระยะ **5–10 ม.** ค่านั้นคือ **250–530 pF** ซึ่งพูลอัพ 4.7 kΩ ดันขึ้นถึงระดับสูง
> ที่ถูกต้องได้ใน **1.6–3.0 µs** — อยู่ในงบ 9 µs โดยมีระยะเผื่อ 3 เท่า

### มีตัวเก็บประจุกี่ตัว และอยู่ตรงไหนบ้าง

ตัว 100 nF ข้างต้นคือตัวที่ทำให้คนสับสน เพราะมันเป็นชิ้นเดียวในช่องสัญญาณที่อยู่
**นอก** PCB นับรวมทั้ง front-end:

| Ref | ค่า | จำนวน | อยู่ที่ไหน |
|---|---|---:|---|
| *(ไม่มี ref — ไม่ได้อยู่บน PCB)* | **100 nF** | **6** | **ที่ตัวโพรบ** หนึ่งตัวต่อโพรบ คร่อม VDD/GND ของโพรบนั้นที่ปลายไกลของสาย |
| C2 | 100 nF | 1 | บน PCB — ดีคัปปลิ้งของ `VSENS` |
| C4–C6 | 100 nF | 3 | บน PCB — ตัวละหนึ่งที่ SHT45 แต่ละตัว |
| C8 | 100 nF | 1 | บน PCB — ที่ bus switch TCA9548A |
| C1 | 1–10 µF | 1 | บน PCB — บัลค์ของ `VSENS` (ถูกจำกัดโดย `DS_POWER_SETTLE_MS` ดูหัวข้อถัดไป) |
| *(ไม่มี ref — ไม่ได้อยู่บน PCB)* | **100 µF low-ESR + 100 nF** | 1 ชุด | **ที่หัววัด SCD41** รับกระแสพุ่ง 205 mA ของมัน และเป็นขาชันต์ของฟิลเตอร์ริปเปิลด้วย — ดู §3 *คำถามเรื่อง 30 mV* |

รวมแล้ว **มี 100 nF ทั้งหมดสิบสองตัวในดีไซน์นี้: หกตัวอยู่ที่โพรบ หกตัวอยู่บนบอร์ด**
— และหกตัวที่โพรบซื้อมาพร้อมชุดสายโพรบ ไม่ได้อยู่ในรายการประกอบ PCB
การเพิ่ม SHT45 จากหนึ่งเป็นสามตัวทำให้ตัวบนบอร์ดเพิ่มมาสองตัว และ mux เพิ่มอีกหนึ่ง

**หกตัวนั้นขนานกันหรือเปล่า? บนกระดาษใช่ ในทางปฏิบัติไม่ — และความต่างนี้คือประเด็นทั้งหมด**
ทั้งหกตัวอยู่ระหว่างเน็ตคู่เดียวกันจริง (`VSENS` และ `GND`) ที่ไฟ DC จึงรวมกันได้ 600 nF
แต่แต่ละตัวถูกแยกออกจากบอร์ดและจากอีกห้าตัวด้วยสายของมันเอง: ประมาณ
**0.5 µH และ 0.08 Ω ต่อเมตร** สำหรับสายคู่ตีเกลียว 24 AWG ดังนั้นโพรบที่ระยะ 10 ม.
จะอยู่หลังอิมพีแดนซ์ราว **5 µH กับ 1.7 Ω** เมื่อคิดไป-กลับ และที่ระยะ 5 ม. ก็ครึ่งหนึ่งของนั้น
ที่ความถี่ซึ่งทรานเซียนต์ไฟเลี้ยงของ DS18B20 สนใจ อิมพีแดนซ์อนุกรมนั้นแยกพวกมัน
ออกจากกันโดยสมบูรณ์ มันคือแหล่งเก็บประจุ *เฉพาะที่* หกจุด ไม่ใช่ตัวเก็บประจุบัลค์
600 nF ตัวเดียว

และนั่นคือเหตุผลว่าทำไมจึงระบุให้อยู่ที่ตัวโพรบ:

| | 100 nF หกตัวที่โพรบ | 100 nF หกตัวรวมกันบน PCB |
|---|---|---|
| รายการเน็ต | เหมือนกัน | เหมือนกัน |
| จำนวนชิ้น / ต้นทุน | เท่ากัน | เท่ากัน |
| สิ่งที่ DS18B20 เห็น | แหล่งเก็บประจุของตัวเอง ห่างไม่เกิน 100 มม. | สายยาว 5–10 ม. แล้วค่อยเจอตัวเก็บประจุ |
| ผลลัพธ์ | ใช้งานได้ | ได้บัลค์บนบอร์ด 600 nF ที่ไร้ประโยชน์ |

ให้ต่อคร่อม **ขา** VDD/GND ของตัวโพรบเอง ที่ปลายสายฝั่งเซนเซอร์
100 nF ที่วางอยู่บน PCB แทน ไม่ได้ช่วยอะไรโพรบที่อยู่ห่างออกไป 5–10 เมตรเลย

อีกทั้งมันเป็น **ของต่อโพรบ ไม่ใช่ของต่อบอร์ด**: ติดตั้งโพรบสี่ตัวก็ใช้ตัวเก็บประจุสี่ตัว
โดยไม่ต้องแก้อะไรบน front-end

โพรบที่ไม่ได้ติดตั้งไม่ต้องใส่อุปกรณ์อะไรเลย และถ้าใส่ไว้ก็ไม่เป็นอันตราย:
สายที่ไม่ได้ต่อจะไม่เห็นพัลส์ presence จึงถูกส่งออกไปเป็นค่า sentinel ที่ไม่ถูกต้อง
และถูกเกตเวย์ตัดทิ้ง แทนที่จะโผล่มาเป็น `0.00 °C` ปลอม ๆ

### เซนเซอร์ I2C — SHT45 สามตัวกับ SCD41 ทั้งหมดอยู่ปลายสาย

**สี่กิ่ง ช่องละหนึ่งกิ่ง** ทุกเซนเซอร์บนบัสนี้อยู่ปลายสายของตัวเอง ไม่มีอะไรวัดค่า
อยู่ในกล่องเลย:

| เซนเซอร์ | แอดเดรส | ช่อง mux | ตำแหน่ง | ช่องในเฟรม |
|---|---|---|---|---|
| SHT45 #0 | 0x44 | 0 | **หัวโรงเรือน** | `air_temp0` / `humidity0` |
| SHT45 #1 | 0x44 | 1 | **ท้ายโรงเรือน** | `air_temp1` / `humidity1` |
| SHT45 #2 | 0x44 | 2 | **นอกโรงเรือน** — ค่าอ้างอิงสภาพแวดล้อม | `air_temp2` / `humidity2` |
| **SCD41** | **0x62** | **3** | **กลางโรงเรือน ระดับก้อนเชื้อ** | `co2` |

กล่อง MCU อยู่ **นอกโรงเรือน** เพราะโรงเรือนเห็ดชื้นและถูกฉีดหมอก ส่วนอุปกรณ์
อิเล็กทรอนิกส์ไม่ควรอยู่ในนั้น มีเพียงเซนเซอร์เท่านั้นที่เข้าไปข้างใน ทุกสายยาว
**ไม่เกิน 5 ม.**

**SCD41 ได้ช่องของตัวเองแม้แอดเดรสจะไม่ชนกัน** 0x62 กับ 0x44 อยู่ต้นทางร่วมกันได้
และรุ่นก่อนหน้าก็เคยทำแบบนั้นจริง — ตอนที่ SCD41 ยังอยู่ *บนบอร์ด* แต่ตอนนี้ทำไม่ได้:
มันอยู่ห่างออกไป 5 ม. และกิ่งที่ไม่ผ่านสวิตช์จะเอาคาปาซิแตนซ์ ~320 pF ของมัน
มาแขวนบนบัสตลอดเวลา ด้วยพูลอัพต้นทาง 4.7 kΩ นั่นคือเวลาขอบขาขึ้นราว 2 µs
เทียบกับขีดจำกัด 1 µs ของ standard mode และแย่ลงอีกเมื่อมีช่อง SHT45 เปิดอยู่พร้อมกัน
การซ้อนทับของโหลดคือเหตุผลทั้งหมดที่มีสวิตช์ตัวนี้ เซนเซอร์ CO2 จึงไม่ได้รับการยกเว้น

เซนเซอร์ #0 ยังคงใช้ช่อง mux 0 เพราะประวัติข้อมูลของมันต่อเนื่องกับชุดข้อมูลเดิม
สมัยที่มี SHT45 ตัวเดียว — ดู *ตัวไหนคือตัวไหน* ด้านล่าง **เซนเซอร์ #2 คือค่าอ้างอิง
สภาพแวดล้อม** และเป็นตัวเดียวที่โดนแดด มันจึงต้องมี **radiation shield** ไม่ใช่แค่
กล่องธรรมดา เพราะเซนเซอร์ที่โดนแดดไทยโดยไม่มีที่บังจะอ่านค่าสูงกว่าอุณหภูมิอากาศจริง
10–15 °C และค่าอ้างอิงก็จะไร้ประโยชน์ **ส่วนสามตัวที่อยู่ในโรงเรือนไม่ต้องมีที่บังแดด**
— โรงเรือนเห็ดมืด

> **ทำไม 5 ม. จึงสำคัญ และมันพังตรงไหน** ข้อจำกัดของ I2C standard mode คือ
> ค่าคาปาซิแตนซ์บัส **400 pF** และเวลาขอบขาขึ้น **1000 ns** สาย Cat5 มีราว 56 pF/m
> และ SHT45 ยังต้องซิงก์กระแส 3 mA ที่ 0.4 V ดังนั้นพูลอัพที่แข็งที่สุดที่ใช้ได้คือ
> ราว 1.5 kΩ:
>
> | ความยาว | C ของสาย | 2.2 kΩ | 1.5 kΩ |
> |---|---|---|---|
> | **5 ม.** | ~320 pF | **0.60 µs** ✅ | 0.41 µs |
> | 10 ม. | ~600 pF | 1.12 µs ❌ | 0.76 µs ⚠️ |
> | 15 ม. | ~880 pF | 1.64 µs ❌ | 1.12 µs ❌ |
>
> ที่ **≤5 ม. ด้วย 2.2 kΩ** เหลือระยะเผื่อ 40 % และไม่ต้องเพิ่มไอซีใด ๆ เกินราว
> 10 ม. ให้ใส่ **P82B715** บัฟเฟอร์ I2C ที่ฝั่งบอร์ดของ *สายเส้นนั้นเส้นเดียว* —
> มันเพิ่มกระแสขับราว 10 เท่า ไม่ต้องแก้เฟิร์มแวร์ และสายที่มีบัฟเฟอร์กับไม่มี
> ใช้ mux ตัวเดียวกันได้ **อย่าไปใช้** PCA9615 แบบ differential I2C: มันต้องใช้ชิป
> ที่ *ปลายทั้งสองข้าง* ของ *ทุกเส้น* รวมหกตัวพร้อมไฟเลี้ยงในจุดที่เปียกสามจุด
> เพื่อแก้ปัญหาที่ P82B715 ตัวเดียวต่อเส้นก็แก้ได้

เซนเซอร์ CO2 **กลับมาอยู่บนบัสนี้แล้ว** ตั้งแต่รุ่น 2.0 — ดู *เซนเซอร์ CO2* ด้านล่าง
ว่าทำไม และมีข้อเดียวที่มันไม่เหมือนอีกสามตัว: มันกินกระแส **พุ่งถึง 205 mA**
ซึ่งมากกว่าทุกอย่างที่ front-end จ่ายไฟให้ถึงสิบเท่า

#### ทำไมต้องมี bus switch

**แอดเดรส I2C ของ SHT4x ถูกกำหนดตายตัวจากโรงงานตามรหัสสั่งซื้อ** รุ่น `SHT45-AD1B`
คือ 0x44 และไม่มีขาสำหรับตั้งแอดเดรส ดังนั้นสามตัวจึงใช้บัสร่วมกันไม่ได้
นี่คือจุดเดียวที่การมีอุปกรณ์สามตัวยากกว่าการมีตัวเดียว

**การตัดไฟทีละตัวแก้ปัญหานี้ไม่ได้** ซึ่งควรบันทึกไว้เพราะเป็นไอเดียที่คนคิดถึงก่อน
และมันล้มเหลวแบบเงียบ ๆ SHT45 ที่ไม่มีไฟเลี้ยงยังคงมีไดโอดแคลมป์ ESD จากขา SDA
และ SCL ไปยังขา VDD ของตัวมันเอง ตัวพูลอัพบัส 4.7 kΩ จะชาร์จรางไฟของอุปกรณ์
ที่ถูกตัดไฟผ่านไดโอดเหล่านั้นขึ้นไปถึงราว **3.3 − 0.6 = 2.7 V** และ SHT4x ทำงานได้
ตั้งแต่ **1.08 V** — มันจึงตื่นขึ้นมาและตอบที่ 0x44 อยู่ดี การเพิ่มตัวต้านทานพูลดาวน์
ที่รางไฟที่ถูกตัดก็ไม่ช่วยเช่นกัน:

| พูลดาวน์ที่ VDD ที่ถูกตัดไฟ | อุปกรณ์ที่ถูกตัดไฟอยู่ที่ | ผลลัพธ์ |
|---|---|---|
| ไม่มี (ลอย) | ~2.7 V | ยังทำงาน ตอบที่ 0x44 — ชนกัน |
| 10 kΩ | ~1.8 V | ยังสูงกว่า 1.08 V — ยังทำงานอยู่ดี |
| 1 kΩ | ~0.5 V | อุปกรณ์ตาย แต่ SDA ถูกดึงลงมาราว **1.1 V** ต่ำกว่า VIH ที่ 2.31 V — บัสค้างต่ำ |

ไม่มีค่าไหนที่ทั้งทำให้อุปกรณ์หยุดทำงานและปล่อยให้บัสยังใช้ได้
**สิ่งที่ต้องสวิตช์คือบัส ไม่ใช่ไฟเลี้ยง**

ดังนั้น SHT45 ทั้งสามจึงอยู่หลัง bus switch **TCA9548A** (หรือ PCA9548A)
โดยเชื่อมต่อทีละช่อง ตัวมันเองเป็นอุปกรณ์ I2C จึงไม่กิน **ขา MCU และไม่กินสัญญาณ
บนขั้วต่อเลย** ซึ่งเป็นเหตุผลที่เซนเซอร์สามตัวในสามจุดของโรงเรือนยังอยู่ในข้อตกลง
เดิมได้ — และตัวที่สี่คือ SCD41 เข้ามาสมทบในรุ่น 2.0 โดยไม่ขยายข้อตกลงแม้แต่สัญญาณเดียว
**ไม่มีอะไรอยู่ต้นทางของสวิตช์**: แอดเดรส 0x62 ของ SCD41 ไม่ชนกับ 0x44 ก็จริง
แต่มันอยู่ห่างออกไป 5 ม. จึงต้องใช้ช่อง 3 แทนการแขวนโหลดไว้บนบัสตลอดเวลา

เขียนเป็นรายการเน็ตแทนการวาดภาพ:

```
   UPSTREAM  (the MCU's bus)
     VSENS ─┬─ [4.7k] ─── SDA (PA11) ─── U3 mux SDA
            ├─ [4.7k] ─── SCL (PA12) ─── U3 mux SCL
            └─ U3 TCA9548A VDD   0x70, with [100nF] to GND at the part

   DOWNSTREAM  (one channel connected at a time, each on its OWN <=5 m cable)
     U3 ch0 SD0/SC0 ══5 m══ U1a SHT45 #0  0x44, [2.2k] pull-ups, [100nF]
     U3 ch1 SD1/SC1 ══5 m══ U1b SHT45 #1  0x44, [2.2k] pull-ups, [100nF]
     U3 ch2 SD2/SC2 ══5 m══ U1c SHT45 #2  0x44, [2.2k] pull-ups, [100nF]
     U3 ch3 SD3/SC3 ══5 m══ U2  SCD41     0x62, [2.2k] pull-ups,
                                          [100uF + 100nF], 22 AWG on V/G

   GND ─────┬─ U1a GND  ├─ U1b GND  ├─ U1c GND  └─ U3 GND
```

พูลอัพฝั่งต้นทางต่อเข้ากับ `VSENS` ไม่ใช่ 3V3 ที่จ่ายตลอด — กฎเดียวกับพูลอัพ
1-Wire ทั้งหกตัว ส่วน 100 nF ของ mux อยู่บน PCB แต่ **100 nF ของ SHT45 แต่ละตัว
ย้ายไปอยู่ที่ตัวเซนเซอร์แล้ว** คร่อม VDD/GND ที่ปลายไกลของสายเส้นนั้น เหมือนกับ
ตัวเก็บประจุที่โพรบ และด้วยเหตุผลเดียวกัน

> **ตอนนี้ bus switch ทำงานสองหน้าที่ และหน้าที่ที่สองคือสิ่งที่ช่วยดีไซน์นี้ไว้**
> เมื่อเซนเซอร์อยู่บนสายคนละเส้น mux ทำให้ MCU **เห็นค่าคาปาซิแตนซ์ของสายเพียง
> เส้นเดียวในแต่ละขณะ** สายยาว 5 ม. สามเส้นจึงไม่เคยรวมกันเป็นบัสยาว 15 ม.
> แต่ละเส้นเป็น ~320 pF ของตัวเอง นั่นคือเหตุผลที่ I2C ธรรมดายังใช้ได้อยู่เลย
> ถ้าเซนเซอร์สามตัวใช้สาย multi-drop เส้นเดียวกันจะใช้ไม่ได้ (และแอดเดรส 0x44
> ที่ตายตัวก็ห้ามอยู่แล้ว) โครงสร้างแบบดาวที่มีสายสั้นหลังสวิตช์คือรูปแบบ *ที่ถูก*
> สำหรับงานนี้ ไม่ใช่การแก้ขัด

| อุปกรณ์ | แอดเดรส | อยู่ที่ | ให้ค่าอะไร | หมายเหตุ |
|---|---|---|---|---|
| U1a SHT45 | `0x44` | mux ch0 | อุณหภูมิอากาศ 0, ความชื้น 0 | สล็อตที่ 0 ของเฟรม — ซีรีส์ `air_temp`/`humidity` เดิม วางตัวนี้ไว้ที่ **ช่องระบายอากาศ** |
| U1b SHT45 | `0x44` | mux ch1 | อุณหภูมิอากาศ 1, ความชื้น 1 | `air_temp_2` / `humidity_2` |
| U1c SHT45 | `0x44` | mux ch2 | อุณหภูมิอากาศ 2, ความชื้น 2 | `air_temp_3` / `humidity_3` |
| U3 TCA9548A | `0x70` | upstream | — | bus switch 8 ช่อง; A2/A1/A0 ลง GND **ใช้ช่อง 0–3** เหลือว่างอีกสี่ช่อง |

**ไม่มีอะไรอยู่ต้นทางของสวิตช์นอกจากตัวสวิตช์เอง** ซึ่งเป็นสิ่งที่ทำให้ขั้นตอน
**สแกน I2C โดยปิดทุกช่อง** ใน §7 เป็นการทดสอบที่สะอาด: เมื่อปิดทุกช่อง ควรเห็น
**`0x70` และไม่มีอะไรอื่นเลย** เปิดช่อง 0–2 ทีละช่องจะเห็น **`0x44`** และเปิดช่อง 3
จะเห็น **`0x62`**

**ทุกช่องปลายทางต้องมีพูลอัพของตัวเอง** เพราะ mux ส่งผ่านสัญญาณ ไม่ได้ส่งผ่านพูลอัพ:
ช่องที่ไม่มีพูลอัพจะลอย และ SHT45 บนช่องนั้นจะไม่ตอบเลย นั่นคืออีกสามคู่ —
**2.2 kΩ ไม่ใช่ 4.7 kΩ แล้ว** เพราะแต่ละคู่ขับสายยาว 5 ม. แทนลายวงจร 30 มม.
ทั้งหมดต่อกับ `VSENS` เหมือนทุกอย่างในบอร์ดนี้

> **ให้วางพูลอัพฝั่งปลายทางไว้ที่ฝั่งบอร์ด ไม่ใช่ที่ตัวเซนเซอร์** มันต้องอยู่บน
> `VSENS` เพื่อไม่ให้สายที่ถูกตัดไฟรั่วกระแส และ `VSENS` ถูกสร้างบน front-end
> ถ้าเอาไปไว้ปลายสายก็ต้องลากรางไฟออกไปด้วย และมันจะไปนั่งอยู่ในหยดน้ำ

#### วิธีต่อสาย

เป็นรายการเน็ต ไม่ใช่แผนผังวงจร ทุกบรรทัดด้านล่างระบุหนึ่งเน็ตและทุกสิ่งที่อยู่
บนเน็ตนั้น สังเกตว่าพูลอัพฝั่งปลายทางเป็น **2.2 kΩ ไม่ใช่ 4.7 kΩ** เพราะแต่ละคู่
ต้องขับสายยาว 5 ม. ส่วนคู่ฝั่งต้นทางยังเป็น 4.7 kΩ เพราะขับแค่ลายวงจร 30 มม.

```
  ON THE FRONT-END PCB
  VSENS  ─┬─ R15 4k7 ── SDA_UP          upstream pull-ups (board-local, 30 mm)
          ├─ R16 4k7 ── SCL_UP
          ├─ R23 10k ── U3.RESET        active-LOW: must NOT float
          ├─ R17 2k2 ── SD0   ┐
          ├─ R18 2k2 ── SC0   │  ONE PAIR PER CHANNEL, and 2k2 not 4k7
          ├─ R19 2k2 ── SD1   │  because each pair drives 5 m of cable.
          ├─ R20 2k2 ── SC1   │  The mux passes signals, NOT pull-ups: a
          ├─ R21 2k2 ── SD2   │  channel with no pair of its own floats
          ├─ R22 2k2 ── SC2   │  and that sensor never answers.
          ├─ R39 2k2 ── SD3   │  Channel 3 is the CO2 branch and is no
          ├─ R40 2k2 ── SC3   ┘  exception: same value, same reason.
          ├─ U3.VCC     + C8 100nF to GND     TCA9548A
          └─ J9/J10/J11/J12 pin V             3V3 out to the four branches

  SDA_UP ─┬─ PA11  (CN10-5)             SCL_UP ─┬─ PA12  (CN10-3)
          └─ U3.SDA                             └─ U3.SCL

  SD0    ─┬─ U3.SD0                     SC0    ─┬─ U3.SC0
          └─ J9.SDA                             └─ J9.SCL      -> หัวโรงเรือน
  SD1    ─┬─ U3.SD1                     SC1    ─┬─ U3.SC1
          └─ J10.SDA                            └─ J10.SCL     -> ท้ายโรงเรือน
  SD2    ─┬─ U3.SD2                     SC2    ─┬─ U3.SC2
          └─ J11.SDA                            └─ J11.SCL     -> นอกโรงเรือน
  SD3    ─┬─ U3.SD3                     SC3    ─┬─ U3.SC3
          └─ J12.SDA                            └─ J12.SCL     -> CO2 กลางโรงเรือน

  ACROSS AN SHT45 BRANCH  (4 conductors, <=5 m, 24 AWG; SDA twisted with GND)
     VSENS  ───────────  SHT45 VDD
     SDn    ───────────  SHT45 SDA
     SCn    ───────────  SHT45 SCL
     GND    ───────────  SHT45 VSS

  ACROSS THE CO2 BRANCH  (same 4 conductors, but 22 AWG -- see the 205 mA problem)
     VSENS  ───────────  SCD41 VDD + VDDH      <-- BOTH, tied at the sensor
     SD3    ───────────  SCD41 SDA
     SC3    ───────────  SCD41 SCL
     GND    ───────────  SCD41 GND

  AT EACH SHT45  (far end of the branch)
     SHT45 VDD --[100nF]-- SHT45 VSS      <-- at the SENSOR, not on the PCB

  AT THE CO2 HEAD  (far end of channel 3)
     SCD41 VDD --[100uF]-- SCD41 GND      <-- low-ESR; the burst reservoir
     SCD41 VDD --[100nF]-- SCD41 GND      <-- ceramic, right at the pads
     SCD41 VDD -- VDDH                    <-- short link, AT the sensor
     heater resistor pad ..............   <-- DNP, see "Condensation"

  GND    ─┬─ U3.GND, J9/J10/J11/J12 pin G
          ├─ U3.A0, U3.A1, U3.A2      all three LOW = address 0x70
          └─ C8 low side

  open   ─── U3.SD4..SD7, U3.SC4..SC7   four unused channels, leave unconnected
```

**ชื่อขา** ด้านบนคือสิ่งที่ต้องใช้อ้างอิงในการต่อสาย ส่วน **เลขขา** จะต่างกันระหว่าง
แพ็กเกจ TSSOP-24 กับ QFN-24 ของ TCA9548A ให้ดูจากดาต้าชีตของเบอร์ที่ซื้อจริง
สำหรับอ้างอิง SHT4x แบบ DFN-4 คือ `1 = SDA`, `2 = VSS`, `3 = VDD`, `4 = SCL` —
ตรวจสอบกับฟุตพรินต์ของคุณก่อนสั่งผลิต เพราะเซนเซอร์ทั้งสามตัวใช้ฟุตพรินต์เดียวกัน
และฟุตพรินต์ที่กลับด้านคือความผิดพลาดสามจุด ไม่ใช่จุดเดียว

#### ห้าวิธีที่วงจรนี้จะพลาด

1. **ปล่อย `RESET` ลอย** ขานี้เป็น active-LOW และไม่มีพูลอัพภายใน ดังนั้นขาที่ลอย
   หมายความว่าสวิตช์อาจค้างอยู่ในสถานะรีเซ็ต แล้ว *ไม่มีอะไร* ที่ปลายทางตอบเลย
   — อุปกรณ์ I2C ทุกตัวบนโหนดนี้อยู่หลังสวิตช์ **ไม่มีอะไรที่ต้นทางเหลือให้ทำงาน
   ได้ปกติ** เพื่อหลอกให้สบายใจ อาการที่ได้คือ I2C เงียบสนิททั้งบัส รวมทั้ง CO2
   ตัว R23 ที่ต่อไป `VSENS` แก้ปัญหานี้ได้ หรือจะต่อตรงเข้า `VSENS` เลยก็ยอมรับได้
   ถ้าไม่คิดจะสั่งรีเซ็ตจากเฟิร์มแวร์
2. **ปล่อย `A0`/`A1`/`A2` ลอย** แอดเดรสจะไม่นิ่ง และสวิตช์จะไปตอบที่แอดเดรสอื่น
   ที่ไม่ใช่ 0x70 หรือตอบบ้างไม่ตอบบ้าง ให้ผูกทั้งสามขาลง GND
3. **ลืมพูลอัพฝั่งปลายทาง** นี่คือความผิดพลาดที่มีโอกาสเกิดมากที่สุดบนบอร์ดนี้
   ตัว mux คือชุดสวิตช์อนาล็อก: มันส่งผ่าน SDA และ SCL แต่พูลอัพไม่ได้ถูกส่งผ่านไปด้วย
   ช่องที่ต่อเซนเซอร์แต่ไม่มีตัวต้านทานจะสแกนแล้วว่างเปล่า เหมือนกับเซนเซอร์ที่ตายทุกประการ
4. **ต่อ SHT45 ผิดไปอยู่ฝั่งต้นทาง** มันจะชนกับอีกสองตัวทันทีที่มีการเปิดช่องใดช่องหนึ่ง
   ขั้นตอนทดสอบข้อ 8 จะจับได้: เมื่อปิดทุกช่อง ต้องเห็นแค่ `0x62` และ `0x70`
   และ **ต้องไม่มี** `0x44`
5. **ต่อสิ่งใดก็ตามเข้ากับ 3V3 ที่จ่ายตลอด แทนที่จะเป็น `VSENS`** กฎเดียวกับทุกอย่าง
   บนบอร์ดนี้ — รวมถึง R17–R22 ซึ่งลืมง่ายเพราะอยู่คนละฝั่งของสวิตช์

> **ตัวไหนเป็นเซนเซอร์ตัวไหน ถูกกำหนดโดยช่องของ mux ไม่ใช่โดยตัวอุปกรณ์**
> ลำดับเซนเซอร์ = ช่องของ mux = สล็อตในเฟรม = ชื่อ metric บนแดชบอร์ด
> ซึ่งผูกเข้าด้วยกันโดย `I2C_MUX_CHANNELS` ใน `node_config.h` อุปกรณ์ 0x44
> สามตัวที่เหมือนกันทุกประการแยกไม่ออกด้วยวิธีอื่น ดังนั้น
> **ให้พิมพ์หมายเลขช่องบนซิลค์สกรีนข้างเซนเซอร์แต่ละตัว**

**กฎการวางตำแหน่งเดิมหายไปแล้ว เพราะเซนเซอร์ออกจากบอร์ดไปหมด** ไม่มีประเด็นเรื่อง
SHT45 อยู่ใต้ลมของเซนเซอร์ CO2 หรืออยู่เหนือทองแดงของเกต FET อีกต่อไป —
ไม่มีอะไรบน PCB นี้ที่วัดอากาศแล้ว สิ่งที่มาแทนคือ:

1. **เซนเซอร์แต่ละตัวต้องมีกล่องระบายอากาศเล็ก ๆ ของตัวเองที่จุดติดตั้งของมัน**
   และตัว #2 ต้องมี **radiation shield** (§6) ส่วนกล่อง front-end เองไม่ต้องมี
   ช่องระบายอากาศเพื่อวัดความชื้นอีกแล้ว — แต่ดูหัวข้อ *เซนเซอร์ CO2* ด้วย
   เพราะ *หัววัด* ของ SCD41 ยังต้องระบายอากาศอย่างยิ่ง
2. **พิมพ์ปลายทางลงบนซิลค์สกรีน ไม่ใช่แค่หมายเลขช่อง** `CH0 → หัว`,
   `CH1 → ท้าย`, `CH2 → นอก` ข้าง J9/J10/J11 ขั้วต่อสามตัวที่เหมือนกัน ป้อนอุปกรณ์
   สามตัวที่เหมือนกัน ผ่านสายสามเส้นที่เหมือนกัน คือสถานการณ์ที่สลับคู่กันแล้ว
   ไม่มีใครรู้ทั้งฤดู — ข้อมูลยังดูสมเหตุสมผล เพียงแต่ถูกยกให้ผิดปลายโรงเรือน
3. **ติดป้ายที่ปลายสายทั้งสองข้างของทุกเส้น** ความล้มเหลวที่ป้องกันได้ตรงนี้ไม่ใช่
   เรื่องไฟฟ้า แต่คือการที่ใครสักคนต่อ J10 กับ J11 สลับกันหลังซ่อมบำรุง แล้วสลับ
   "ในโรงเรือน" กับ "ค่าอ้างอิงภายนอก" ไปเงียบ ๆ

### เซนเซอร์ CO2 — Sensirion SCD41 บน I2C

**รุ่น 2.0 (2026-09)** ชิ้นส่วน CO2 คือ **Sensirion SCD41** (`SCD41-D-R2`,
Digi-Key TH ฿673.73) เป็น NDIR แบบ photoacoustic, I2C ที่ **0x62**, อยู่บน
**ช่อง mux 3** และสาย 5 ม. ไปกลางโรงเรือนที่ระดับก้อนเชื้อ ทุกอย่างด้านล่างมาจาก
ดาต้าชีต SCD4x **v1.7 เมษายน 2025**

มันเข้ามาแทน **Senseair S88 LP** และเหตุผลคือตัวอาคาร S88 LP มีพิกัด
**0–50 °C, 0–85 %RH** โดยขีด RH ลดลงเหลือ 45 % ที่ 50 °C ส่วนโรงเรือนเห็ดอยู่ที่
**90–95 %RH** ถูกฉีดหมอกโดยตรง และมีการควบแน่น ข้อนั้นไม่มีทางผ่านไปได้

| | S88 LP (ที่ถูกแทน) | **SCD41** |
|---|---|---|
| ไฟเลี้ยง | 4.5–5.25 V | **2.4–5.5 V** — ไฟ 3.3 V เดียวกับทุกอย่างบนบอร์ด |
| อินเทอร์เฟซ | UART/Modbus บน RS-485 | **I2C พร้อม CRC-8 ทุก 16-bit word** |
| ช่วงใช้งาน | 0–50 °C, 0–85 %RH (ลดพิกัด) | **−10–60 °C, 0–95 %RH** ห้ามควบแน่น |
| การทำงาน | ต่อเนื่อง — ABC ต้องการ | **single shot ตามคำสั่ง** |
| กระแสเฉลี่ย | 18 mA ตลอดเวลา | **0.45 mA** ที่ 1 ครั้ง/5 นาที |
| กระแสพีค | 300 mA | 175 typ / **205 max mA** |
| ช่วงเอาต์พุต | 400–10 000 ppm | **0–40 000 ppm** (ระบุสเปก 400–5000) |
| ความแม่นยำ | ±40 ppm ±3 % | ±(50 ppm + 2.5 %) 400–1000 · ±(50 + 3 %) ถึง 2000 · ±(40 + 5 %) ถึง 5000 |
| เวลาตอบสนอง τ63 | <40 วินาที | 60 วินาที |
| ต้นทุนบนบอร์ด | เรกูเลเตอร์ตัวที่ 2, U4, U5, LDO ที่หัว, TVS บน A/B, 3 สัญญาณ | **ช่อง mux หนึ่งช่อง** |

ตารางนั้นกำลังบอกว่า: **เซนเซอร์ตัวนี้ทำให้บอร์ดเสียไปแค่ขั้วต่อหนึ่งตัว** มันไม่ต้องการ
เรกูเลเตอร์ของตัวเอง ไม่ต้องการตัวรับส่งที่ปลายทั้งสองข้าง และไม่ต้องการสัญญาณข้ามรอยต่อ
— มันคือกิ่งที่สี่บน bus switch ที่มีอยู่แล้ว

> **การใช้ I2C ที่นี่ไม่ได้เสียความสมบูรณ์ของข้อมูล** ข้อโต้แย้งที่มักได้ยินคือทรานแซกชัน
> I2C ที่เสียหายให้ตัวเลขผิดที่ดูสมเหตุสมผล ในขณะที่โปรโตคอลแบบมีเฟรมจะเช็คซัมไม่ผ่าน
> แล้วส่งซ้ำ ข้อนั้นใช้ไม่ได้กับชิ้นส่วนของ Sensirion: **ทุก 16-bit word มี CRC-8 ของตัวเอง**
> (poly 0x31, init 0xFF) ซึ่ง `src/sensirion_i2c.cpp` ตรวจอยู่แล้วสำหรับ SHT45
> ค่าที่อ่านผิดจะไม่มีวันไปถึงแคชใน `main.cpp`

#### อยู่ตรงไหน และทำไมต้องตรงนั้น

**กลางโรงเรือน ที่ระดับก้อนเชื้อ** CO2 หนักกว่าอากาศ และก้อนเชื้อคือสิ่งที่ผลิตมันออกมา
มันจึงแบ่งชั้นและเข้มที่สุดที่ระดับก้อน ตัวเลขที่ควรใช้สั่งพัดลมระบายอากาศคือตัวเลข
ที่ก้อนเชื้ออยู่กับมันจริง ๆ — ไม่ใช่ที่สันหลังคา และไม่ใช่ตรงประตู

นั่นเป็นคนละจุดกับ SHT45 ทั้งสามตัว (หัว ท้าย นอก) ซึ่งเป็นเหตุผลที่ SCD41 ได้
สายของตัวเองและช่องของตัวเอง แทนที่จะไปแชร์หัววัด

#### โหนดนี้วัดอะไร และไม่วัดอะไร

**กรณีที่ออกแบบไว้คือคุมการระบายอากาศช่วงออกดอก 400–3000 ppm** นั่นคือย่านที่
SCD41 แม่นที่สุด — ±(50 ppm + 2.5 %) ที่ต่ำกว่า 1000 ppm — และเป็นย่านที่การตัดสินใจ
อยู่จริง เพราะเห็ดนางฟ้า/นางรมตอบสนอง CO2 สูงด้วยก้านที่ยืดยาวและหมวกที่เล็กลง

**ช่วงเดินเส้นใย โรงเรือนมี CO2 สูงโดยตั้งใจและจะอ่านได้เกิน 5000 ppm** SCD41 ยัง
ให้เอาต์พุตถึง **40 000 ppm** ข้อมูลจึงไม่ตัน — แต่เกิน 5000 ppm มันอยู่นอกช่วง
ความแม่นยำที่ระบุ ให้ถือว่าตัวเลขเหล่านั้นเป็นข้อมูลเชิงคุณภาพ ("ยังเดินเส้นใยอยู่")
ไม่ใช่ค่าวัดระดับงานวิจัย ถ้าแผนการเพาะในอนาคตต้องการตัวเลข spawn run ที่สอบเทียบได้
นั่นคือจุดที่ **S88 GH** (0–20 000 ppm, 0–95 %RH) ใน
[`hardware-interface-s88.th.md`](hardware-interface-s88.th.md) จะกลับมา — และมันจะ
พาราง 5 V กับ RS-485 กลับมาด้วย

#### ทำไมมันอยู่หลังเกต

เซนเซอร์ CO2 แบบ NDIR มักต้องการไฟตลอดเวลาด้วยเหตุผลสี่ข้อ ลองตรวจทีละข้อกับตัวนี้
เพราะถ้าข้อใดข้อหนึ่งเป็นจริง บอร์ดจะต้องมีรางไฟที่เปิดตลอดเวลา และ `SENS_GATE`
ก็จะมีรูโหว่:

| เหตุผลปกติที่ต้องเปิดเซนเซอร์ CO2 ทิ้งไว้ | ผูกที่นี่ไหม? |
|---|---|
| อุ่นเครื่องหลังเปิดไฟ | **ไม่** — จัดการทุกครั้งที่ตื่นด้วย **throwaway shot** ด้านล่าง |
| ฟิลเตอร์ที่ต้องมีประวัติการวัด | **ไม่** — τ63 = 60 วินาที และโหนดสุ่มทุก 15 นาที |
| ความร้อนในตัวกันเลนส์ให้อยู่เหนือจุดน้ำค้าง | **ใช้ไม่ได้** ที่ 1.5 mW — ดู *การควบแน่น* ด้านล่าง |
| คาบสอบเทียบตัวเองที่นับเป็นวัน | **ไม่** — **ASC ถูกปิดที่นี่** ดู *ASC* ด้านล่าง |

เซนเซอร์ CO2 จึงกลับไปอยู่บน `VSENS` พร้อมกับโพรบและ SHT45 และบอร์ดนี้
**ไม่มีรางไฟเซนเซอร์ที่เปิดตลอดเวลาเลย** `SENS_GATE` กู้คืนกิ่ง CO2 ที่ค้างได้
เหมือนที่กู้คืนกิ่ง SHT45

**ราคาที่ต้องจ่ายคือ throwaway shot** และ Sensirion เรียกโหมดนี้และต้นทุนนี้
ไว้ตรง ๆ การตัดไฟระหว่างการวัดคือ *power-cycled single shot operation* และกฎของมันคือ
*"เนื่องจากเซนเซอร์ต้องการการวัด single shot หนึ่งครั้งเพื่อเข้าที่หลังการตัดไฟ
ค่า CO2 จาก single shot ครั้งแรกหลังเริ่มทำงานจึงควรถูกทิ้งเสมอ"* ดังนั้น
`scd41_read_single_shot(warmup=1)` จึงวัดสองครั้งแล้วทิ้งครั้งแรก — **เวลาเปิด
เซนเซอร์ราว 10 วินาทีต่อการตื่นหนึ่งครั้ง** ไม่ใช่ของเลือกได้บนโหนดที่ตัดไฟเซนเซอร์
วันละ 96 ครั้ง

> **ข้อนี้มีความขัดแย้งของเอกสารอยู่เบื้องหลังจริง ๆ และคนถัดไปที่เปิดดาต้าชีต
> จะเจอสิ่งที่ตรงข้ามกับหัวข้อนี้** อ่านจากตรงนี้ดีกว่าไปค้นพบเอง:
>
> | เอกสาร | บอกว่า |
> |---|---|
> | ดาต้าชีต **v1.3–v1.6** | *"หลังการตัดไฟ ค่า single shot ครั้งแรกควรถูกทิ้งเพื่อความแม่นยำสูงสุด"* และมีอีกข้อแยกต่างหากบอกให้ทิ้งค่าแรกหลัง `wake_up` ด้วย |
> | ดาต้าชีต **v1.7** (เม.ย. 2025) | **ลบทั้งสองข้อออก** ประวัติการแก้ไขระบุชัด: *"removed recommendation to discard initial single shot measurement after power cycle (Section 3.11)"* |
> | App note *SCD4x Low Power Operation* v1.0 (ก.ค. 2022) §2.4 | ยังบอกอยู่ และบอกหนักกว่าเดิม — *"should always be discarded"* |
>
> Sensirion ไม่ได้บอกว่า **ทำไม** ถึงลบออก และการลบข้อความออกไม่ใช่การยืนยันว่า
> ค่าแรกใช้ได้แล้ว อีกทั้ง app note ตัวนั้นก็เก่าในอีกประเด็นหนึ่งอย่างเห็นได้ชัด —
> flowchart ของมันยังคงเวลาเปิดเครื่อง 1000 ms ที่ดาต้าชีตแก้เป็น 30 ms ไปแล้วใน
> v1.4 — ดังนั้นจะยกให้ฉบับไหนชนะขาดก็ไม่ได้
>
> **บอร์ดนี้เก็บ throwaway shot ไว้** ด้วยเหตุผลเรื่องต้นทุนที่ไม่สมมาตร ไม่ใช่
> เรื่องว่าเอกสารฉบับไหนใหม่กว่า:
>
> - **ถ้ามันไม่จำเป็น เราเสีย 0.007 Wh/วัน** บนโหนดที่ใช้ 0.8 จาก 80 ที่มี — ไม่มีนัยสำคัญ
> - **ถ้ามันจำเป็นแล้วเราข้าม เซนเซอร์จะอ่านค่าต่ำ** ซึ่งคือความล้มเหลวแบบเดียวกับ
>   หัวข้อ ASC: ตัวควบคุมเชื่อว่าอากาศปกติ โรงเรือนระบายอากาศไม่พอ และ
>   **ไม่มีอะไรบนแดชบอร์ดดูผิดปกติเลย**
>
> จ่าย 0.007 Wh/วันเพื่อสิ่งนั้น จะกลับมาทบทวนก็ต่อเมื่อ Sensirion ระบุในเชิงบวกว่า
> ค่าแรกใช้ได้ ไม่ใช่แค่เพราะดาต้าชีตฉบับหน้าเงียบอีกครั้ง

App note ยืนอยู่บนพื้นที่มั่นคงกว่าในเรื่องตัวโหมดเอง และมันยืนยันว่าเลือกถูก:
power-cycled single shot คุ้มกว่าการปล่อยเซนเซอร์ idle ระหว่างการวัด **เมื่อคาบ
การสุ่มเกิน 380 วินาที** และโหนดนี้ตื่นทุก **900 วินาที** ต่ำกว่าเส้นนั้น กระแส idle
200 µA ของเซนเซอร์ถูกกว่าการจ่ายค่า stabilisation shot ทุกครั้ง สูงกว่านั้นเกตชนะ
ดีไซน์นี้อยู่ฝั่งที่ถูกของเส้นอย่างสบาย — แต่มันเป็นเส้น และการตัดสินใจในอนาคตที่จะ
สุ่มทุก 5 นาทีจะข้ามกลับไปอีกฝั่ง

พลังงาน คำนวณจากตัวเลขของ app note เองสำหรับโหมดนี้ (สมการที่ 2: **154 mC ต่อ
single shot ที่ใช้ได้จริงหนึ่งครั้ง ที่ 3.3 V** ซึ่งรวมครั้งที่ถูกทิ้งไปแล้ว):

`154 mC × 96 ครั้ง/วัน × 3.3 V = 48.8 J ≈` **0.0136 Wh/วัน**

เทียบกับงบทั้งโหนด ~0.8 Wh/วัน และผลผลิตของแผง ~80 Wh/วัน มันคือแถวที่เล็กที่สุด
ในตารางของ §5 แบบทิ้งห่างหนึ่งอันดับ

#### ASC — ปิดมัน และเข้าใจให้ได้ก่อนจะเปิดกลับ

**SCD41 ส่งมาโดยเปิด ASC (Automatic Self-Calibration)** พร้อมเป้าเบสไลน์
**400 ppm** ASC สมมติว่าเซนเซอร์ *"ได้สัมผัสอากาศบริสุทธิ์นอกอาคารที่ 400 ppm
อย่างน้อยหนึ่งครั้งนานกว่า 3 นาที ในทุกสัปดาห์ของการทำงาน"* (ดาต้าชีต §3.8)
แล้วค่อย ๆ สอบเทียบค่าต่ำสุดที่มันเคยเห็นเข้าหาเป้านั้น

**โรงเรือนเห็ดไม่มีวันแตะ 400 ppm** ห้องออกดอกที่ระบายอากาศดีก็ยังอยู่ 800–1500 ppm
ถ้าค่าต่ำสุดจริงในสัปดาห์คือ 700 ppm แต่ ASC เชื่อว่ามันคือ 400 ASC จะดึงค่าที่อ่านได้
ลงราว 300 ppm และทำต่อไปทุกคาบจนอิ่มตัว

ตามผลลัพธ์ไปให้สุด: เซนเซอร์อ่านต่ำ → ตัวควบคุมเชื่อว่าอากาศดี →
**โรงเรือนถูกระบายอากาศน้อยเกินไป** → ก้านยืด หมวกเล็ก นั่นคือผลลัพธ์ที่ติดเซนเซอร์
มาเพื่อป้องกันพอดี และ **ไม่มีอะไรบนแดชบอร์ดดูผิดปกติเลยขณะที่มันเกิดขึ้น**
นี่คือค่าเริ่มต้นที่อันตรายที่สุดในดีไซน์นี้

และมีเหตุผลที่สองที่ตรงกว่าและไม่ขึ้นกับโรงเรือนเห็ดเลย: **ASC ใช้ไม่ได้ในโหมด
power-cycled single shot ตั้งแต่ต้น** ดาต้าชีตระบุชัด — *"for power-cycled single
shot operation, ASC functionality is not available in either case"* (§3.11 และ
"either case" หมายถึงทั้งการตัด VDD และการใช้ `power_down`/`wake_up`) การนับ
ของมันอาศัยประวัติที่ไม่รอดการตัดรางไฟ การเปิด ASC ทิ้งไว้ที่นี่จึงไม่ได้ให้เซนเซอร์
ที่สอบเทียบผิด แต่ให้เซนเซอร์ที่พฤติกรรมไม่นิยาม

นั่นทำให้การตัดสินใจปิด ASC ถูกกำหนดซ้ำสองชั้น: ผิดสำหรับอาคารนี้ และใช้ไม่ได้
ในโหมดนี้ แต่ยังต้องเขียนสั่งอย่างชัดเจนแทนที่จะปล่อยให้เป็นไปตามเซนเซอร์ เพราะ
สถานะที่ `persist_settings` เก็บไว้คือสิ่งที่เซนเซอร์ *ตัวเปลี่ยน* จะมาพร้อมกับมัน
และเซนเซอร์ตัวเปลี่ยนมาพร้อม ASC เปิด

ดังนั้น:

- **ปิด ASC** `set_automatic_self_calibration_enabled` (0x2416) ด้วยค่า 0 แล้วตามด้วย
  `persist_settings` (0x3615, 800 ms) เพื่อให้รอดการตัดไฟ
- **เฟิร์มแวร์บังคับทุกครั้งที่ตื่น** ไม่ใช่ครั้งเดียว — `scd41_ensure_asc()` อ่านก่อน
  (1 ms) และเขียนเฉพาะเมื่อไม่ตรง เซนเซอร์ที่ถูกเปลี่ยนตัวจึงถูกแก้อัตโนมัติ และ
  EEPROM ไม่เคยถูกเขียนซ้ำด้วยค่าเดิม ต่างจากทุกอย่างบนบอร์ดนี้ ข้อนี้คือค่าที่
  เฟิร์มแวร์ต้อง *เปลี่ยน* จริง ๆ เพราะค่าโรงงานคือค่าที่ผิด
- **สอบเทียบด้วยมือด้วย FRC** ในอากาศกลางแจ้ง ตามรอบการเพาะแต่ละรุ่น — ซึ่งเป็นตอนที่
  โรงเรือนถูกล้างและพักอยู่แล้ว จึงเป็นจังหวะที่มีอยู่ ไม่ใช่ภาระที่คิดขึ้นใหม่

**ขั้นตอน FRC** และเงื่อนไขก่อนหน้าเข้มงวด (ดาต้าชีต §3.8.1):

1. เอาหัววัด **ออกไปกลางแจ้ง** ในที่โล่ง ห่างจากคนและช่องระบายอากาศ
2. ให้มันทำงานในอากาศที่ CO2 นิ่งและสม่ำเสมอก่อน ดาต้าชีตบอกว่ามากกว่า 3 นาที
   ส่วน app note (§5.1) เจาะจงกว่าสำหรับโหมดที่โหนดนี้ใช้จริง และให้ยึดตามฉบับนั้น:
   **วอร์มอัพ 5 นาทีที่คาบการสุ่ม 1 นาที** — single shot ห้าครั้ง ห่างกันครั้งละหนึ่งนาที
   — *"the same procedure also applies to performing FRC if the sensor is to be
   operated in power-cycled single shot mode in the field."* FRC บนเซนเซอร์ที่ยังไม่ได้วัด
   จะคืนค่า `0xFFFF` และไม่ทำอะไรเลย
3. ต้องตั้งการชดเชยระดับความสูงไว้ก่อน (ด้านล่าง) และไฟเลี้ยงต้องเป็น 3.3 V ปกติ
   ไม่ใช่ 5 V บนโต๊ะทดลอง
4. `perform_forced_recalibration` (0x362f, 400 ms) พร้อมค่าอ้างอิง — **~420 ppm**
   สำหรับอากาศกลางแจ้ง คือ `SCD41_FRC_TARGET_PPM` ใน `node_config.h`
5. อ่านค่าการแก้ที่มันใช้กลับมา ถ้ากระโดดมากควรจดไว้

`scd41_perform_frc()` ทำตามนี้แต่ **ไม่บังคับเงื่อนไขก่อนหน้าให้** — มันเป็นคำสั่ง
สำหรับโต๊ะทดลอง/งานบำรุงรักษา และจงใจไม่ถูกต่อเข้ากับลูปการตื่น

> **อย่า "แก้" ASC ด้วยการยกเป้าขึ้นแทน** การตั้ง
> `set_automatic_self_calibration_target` เป็นค่าต่ำสุดปกติของโรงเรือนดูน่าทำและ
> เป็นกับดัก: ค่านั้นเปลี่ยนตามระยะการเพาะ จังหวะรุ่น และตารางระบายอากาศ —
> มันคือปริมาณที่คุณกำลังพยายามวัดอยู่

#### ระดับความสูง ไม่ใช่ความดัน

SCD41 อ่านสูงหรือต่ำตามความหนาแน่นของอากาศ และมันไม่มีบารอมิเตอร์
มีสองคำสั่งที่บอกมันได้ว่าอยู่ที่ไหน:

- `set_ambient_pressure` (0xe000) — อยู่ใน **RAM** และโหนดนี้ตัดรางไฟของเซนเซอร์
  ทุก 15 นาที มันจึงหายทุกครั้งที่ตื่น ใช้ไม่ได้ที่นี่
- `set_sensor_altitude` (0x2427) — **เก็บใน EEPROM** หลัง `persist_settings`
  เขียนครั้งเดียวแล้วรอดการตัดไฟ นี่คือตัวที่ต้องใช้

`SCD41_SITE_ALTITUDE_M` ใน `node_config.h` เก็บค่านี้ (**330 ม.** สำหรับแม่โจ้) และ
`scd41_ensure_altitude()` ใช้กฎอ่านก่อนเขียนแบบเดียวกับ ASC ตั้งค่านี้ก่อน FRC ครั้งแรก
— การสอบเทียบที่ทำที่ระดับความสูงผิดจะฝังความผิดพลาดนั้นไว้

#### ปัญหา 205 mA และสามอย่างที่ทำกับมัน

นี่คือแกนเดียวที่ SCD41 *ยากกว่า* ชิ้นส่วนที่มันแทน เมื่อเทียบกับทุกอย่างบนรางไฟ
มันกิน **175 mA typ / 205 mA max** เป็นช่วงพุ่งขณะวัด — สิบเท่าของค่าเฉลี่ยตัวเอง
และสิบเท่าของทุกอย่างที่ front-end จ่ายไฟให้ ดาต้าชีตยังขอว่าแรงดันไฟเลี้ยง
เมื่อวัดโดยไม่มีโหลดของเซนเซอร์เอง *"ต้องไม่แกว่งเกิน 30 mV (เช่น ริปเปิลหรือแรงดันตก
ที่เกิดจากโหลดอื่น)"* และแนะนำให้มี LDO เฉพาะตัว

สามมาตรการ และรวมกันแล้วเพียงพอ:

1. **ใช้ 22 AWG บนกิ่ง CO2** ไม่ใช่ 24 AWG แบบที่ใช้กับ SHT45 ความต้านทานไป-กลับ
   ลดเหลือ **0.53 Ω** (22 AWG คือ 52.96 Ω/กม. และ 5 ม. ไป-กลับคือ 10 ม.)
   แรงดันตกกรณีแย่สุดที่ 205 mA จึงเป็น **109 mV**: ที่หัววัดเห็น ~3.12 V เทียบกับ
   ค่าต่ำสุด 2.4 V (24 AWG จะได้ 173 mV — ยังใช้ได้ แต่ไม่มีเหตุผลที่จะจ่าย
   ระยะเผื่อนั้นทิ้ง)
2. **100 µF + 100 nF ที่หัววัด** คร่อม VDD/GND และวางใกล้เซนเซอร์ นี่คือแหล่งสำรอง
   ที่กันกระแสพุ่งไม่ให้ออกมาบนสายตั้งแต่แรก และเป็นตัวแทนที่ใช้ได้จริงของ LDO
   เฉพาะตัวที่ดาต้าชีตขอ
3. **อ่านมันเป็นตัวสุดท้าย ในหน้าต่างที่เกตเปิด** `main.cpp` จะติดต่อ SCD41 หลังจาก
   อ่านค่าการแปลงของ DS18B20 ครบทุกตัวและ SHT45 ทั้งสามเสร็จแล้วเท่านั้น ไม่มีอะไร
   ที่ต้องการไฟ 3.3 V ที่นิ่งกำลังทำงานอยู่ตอนที่กระแสพุ่งเริ่ม ลำดับนี้ยังจ่ายค่า
   เวลารอเปิดเครื่องให้ด้วย: ถึงตอนนั้นรางไฟขึ้นมาตลอด 750 ms ของการแปลงค่าแล้ว
   `SCD41_POWER_UP_MS` จึงไม่มีต้นทุน

> **`VDD` กับ `VDDH` ต้องต่อถึงกัน** ที่ตัวเซนเซอร์ และดาต้าชีตระบุชัดว่าทั้งคู่มาจาก
> รางเดียวกัน — *"VDD and VDDH must be connected to each other close to the sensor
> on the customer PCB"* (§2.3) บนบอร์ด breakout ทำมาให้แล้ว ส่วนบน LGA เปล่า
> เป็นความผิดพลาดที่พลาดง่ายครั้งเดียว และสาย 5 เมตรไม่ใช่ "close to the sensor" แน่นอน

#### คำถามเรื่อง 30 mV — สวิตชิงเรกูเลเตอร์กับข้อกำหนดที่ขอ LDO

ประโยคที่ยกมาข้างบนสมควรได้คำตอบจริง ไม่ใช่ปัดผ่าน เพราะ **ถ้าวัดที่ตัวเรกูเลเตอร์
บอร์ดนี้สอบตก**:

| | |
|---|---|
| SCD41 ขอ (§2.3 วัดตอนไม่มีโหลด) | **≤ 30 mV p-p** และ *"operating the sensor with a separate LDO is recommended"* |
| U7 ให้ (TSR 1 รุ่นอินพุต 24 V, แบนด์วิดท์ 20 MHz) | **75 mV p-p typ** ที่ **400–600 kHz** (500 kHz typ) |

บอร์ดนี้ไม่มี LDO และจะไม่มี — §5 ใช้ทั้งหัวข้ออธิบายไปแล้วว่าทำไมการเอาเรกูเลเตอร์
ตัวที่สองกลับมาไม่คุ้ม ข้อกำหนดจึงต้องถูกทำให้ผ่านที่อื่น และมันผ่าน: **ที่ตัวเซนเซอร์
ซึ่งเป็นจุดเดียวที่ดาต้าชีตระบุไว้จริง ๆ**

**สาย 5 เมตรคือฟิลเตอร์** นี่คือส่วนที่น่าพอใจของดีไซน์นี้ และควรเขียนไว้เพราะมัน
กลับด้านการอ่านแบบผิวเผิน — กิ่งที่ยาวดูเหมือนภาระที่บังคับให้ต้องใช้ 22 AWG และ
*ในเวลาเดียวกัน* มันคือสิ่งที่ทำให้สวิตชิงเรกูเลเตอร์ใช้ได้กับชิ้นส่วนที่ขอ LDO:

- สายตีเกลียว 5 เมตรมีความเหนี่ยวนำของลูปราว **0.7 µH/ม. → ~3.5 µH**
  (ค่านี้ประมาณจากเรขาคณิต ไม่ใช่ตัวเลขจากดาต้าชีต — ซึ่งเป็นเหตุผลว่าทำไม
  ขั้นตอน bring-up ต้องวัดจริงแทนที่จะเชื่อ)
- เทียบกับ **100 µF** ที่หัววัด นั่นคือโลว์พาสที่มีจุดตัดราว **8 kHz** — ต่ำกว่า
  ความถี่สวิตชิงของ U7 เกือบสองอันดับ
- ที่ 500 kHz อิมพีแดนซ์อนุกรมของสายเป็นแบบเหนี่ยวนำ ωL ≈ **11 Ω** ขณะที่
  คาปาซิเตอร์ที่หัววัดแสดงค่า ESR ของมัน — ระดับไม่กี่ร้อย mΩ สำหรับ 100 µF
  แบบ low-ESR และยังถูกชันต์ด้วย 3.2 Ω ของเซรามิก 100 nF อีก ตัวหารจึงอยู่ราว
  **1:40** และริปเปิล 75 mV p-p ของ U7 ไปถึง SCD41 เหลือ **~2 mV**
- ระยะเผื่อเกินหนึ่งอันดับ ข้อสรุปจึงยังอยู่แม้ประมาณค่าความเหนี่ยวนำผิดไป 2 เท่า
  หรือ ESR ผิดไป 5 เท่า

**มันไม่แกว่ง** ข้อโต้แย้งที่ชัดเจนต่อการเอา LC ไปคั่นระหว่างเรกูเลเตอร์กับโหลดแบบ
เป็นพัลส์คือการเปิดกิ่งจะกระตุ้นให้มันแกว่ง ความต้านทาน **0.53 Ω** ของสายเองหน่วงมันไว้:
`Q = (1/R)·√(L/C) = (1/0.53)·√(3.5 µH / 100 µF) ≈ 0.35` ต่ำกว่า 1 อย่างสบาย
สังเกตว่า 22 AWG ถูกเลือกในหัวข้อข้างบนเพราะ *ความต้านทานต่ำ* ส่วนตรงนี้ต้องการ
ความต้านทานตัวเดียวกันเพื่อการหน่วง — 20 AWG ก็ยังได้ Q ≈ 0.5 การเลือกจึงไม่ละเอียดอ่อน
ทั้งสองทิศทาง

> **100 µF ที่หัววัดทำงานสองหน้าที่ ไม่ใช่หน้าที่เดียว** มันเป็นแหล่งสำรองสำหรับ
> กระแสพุ่ง 205 mA *และ* เป็นขาชันต์ของฟิลเตอร์ริปเปิล นั่นคือเหตุผลที่ §4b ระบุว่า
> ต้องเป็น **low-ESR** ไม่ใช่แค่ "100 µF ชนิดไหนก็ได้": ตัวที่ ESR สูงทำให้เสียทั้งสองหน้าที่พร้อมกัน

เพราะค่าความเหนี่ยวนำเป็นค่าประมาณ **ขั้นตอน bring-up จึงวัดจริงแทนที่จะสมมติ** —
ดู §7 ที่ VDD ของหัววัดถูกจับด้วยออสซิลโลสโคปขณะกิ่งมีไฟแต่เซนเซอร์ยังไม่วัด
ต่ำกว่า 30 mV p-p คือผ่าน ถ้าเข้าใกล้แปลว่าสายไม่ใช่อย่างที่หัวข้อนี้สมมติไว้

#### หัววัด

SCD41 เป็น **LGA ขนาด 10.1 × 10.1 × 6.5 มม., MSL 1, บัดกรีแบบ reflow** ไม่มีรุ่นเสียบรู
มีสองวิธีที่ซื่อสัตย์ในการสร้างหัววัด:

| | ชิ้นส่วน | หมายเหตุ |
|---|---|---|
| **Breakout** | Sensirion **`SEK-SCD41-SENSOR`** (Digi-Key TH) | VDD/VDDH เชื่อมมาให้แล้ว มีพูลอัพ ขา 2.54 มม. **เป็นตัวเลือกที่ถูกต้องสำหรับงานวิจัย** — ไม่ต้อง reflow ไม่มีความเสี่ยงรื้อซ่อมบนชิ้นส่วนราคา ฿674 |
| เปล่า | **`SCD41-D-R2`** บนบอร์ดหัววัดเล็ก ๆ ที่ทำเอง | ถูกกว่าต่อชิ้นและเล็กกว่า แต่ต้อง reflow หรือลมร้อน และต้องใช้ land pattern ในดาต้าชีต §4.2 |

ไม่ว่าทางไหน หัววัดจะมีเซนเซอร์, 100 µF + 100 nF, คู่พูลอัพ 2.2 kΩ ของกิ่งนั้น
และ **แพดฮีตเตอร์ DNP** ด้านล่าง

##### การสร้างหัววัดจาก LGA เปล่า

ข้ามหัวข้อนี้ไปได้ถ้าซื้อ breakout ซึ่งเป็นคำแนะนำ หัวข้อนี้มีอยู่เพื่อให้ทางเลือกที่สอง
เป็นทางเลือกจริง ไม่ใช่แค่การยักไหล่

**ผังขา** (ดาต้าชีต §2.3 ตารางที่ 6; มองจากด้านบน 21 แพดบนตัวถัง 10.1 × 10.1 มม.):

| แพด | เน็ต | แพด | เน็ต |
|---|---|---|---|
| 1–5 | DNC | 11–18 | DNC |
| **6** | **GND** | **19** | **VDDH** |
| **7** | **VDD** | **20** | **GND** |
| 8 | DNC | **21** | **GND** — แพดกลางสี่แพด เป็นแพด 21 ทั้งหมด |
| **9** | **SCL** | | |
| **10** | **SDA** | | |

สามเรื่องในตารางนั้นพลาดง่าย และทั้งสามเรื่องล้มเหลวแบบเงียบ ๆ:

1. **แพด 8 เป็น DNC และอยู่คั่นระหว่าง VDD กับ SCL** แถวล่างคือ
   `GND · VDD · DNC · SCL · SDA` ไม่ใช่สัญญาณสี่ตัวเรียงติดกัน ฟุตพรินต์ที่วาดจาก
   ความจำจะทำให้ SCL กับ SDA เลื่อนไปทางซ้ายหนึ่งแพด แล้วเซนเซอร์จะไม่ตอบเลย
2. **"Do not connect" ไม่ได้แปลว่า "ไม่ต้องมีแพด"** ดาต้าชีตกำหนดว่าแพด DNC
   *"pads must be soldered to a floating pad on the customer PCB"* — มันทำหน้าที่
   ทางกล และตัวชิ้นส่วนยึดอยู่ได้ด้วยแพดเหล่านี้ ให้วาดครบทั้ง 21 แพด
3. **ขา 1 ถูกทำเครื่องหมายไว้สองแบบ**: จุดวงกลม และ **มุมบากบนเมมเบรนป้องกัน**
   ใช้ทั้งสองอย่าง เพราะตัวถังเกือบเป็นสี่เหลี่ยมจัตุรัสพอดี

**พูลอัพ** อยู่ที่หัววัด ไม่ใช่บนบอร์ด front-end ซึ่งเป็นเหตุผลทั้งหมดของการวาง
R39/R40 ไว้ฝั่งปลายทาง ค่าตัวอย่างในดาต้าชีตคือ 10 kΩ สำหรับบัสสั้น ๆ ส่วนกิ่งนี้
ยาว 5 เมตรและใช้ **2.2 kΩ** (§ *การต่อสาย*) เฟิร์มแวร์ **ต้องขับ SDA และ SCL
ให้ต่ำได้อย่างเดียว** ห้ามขับให้สูง — เพอริเฟอรัล I2C ของ STM32WL เป็น open-drain
อยู่แล้วจึงไม่มีปัญหา แต่โค้ด bit-bang ที่เขียนลวก ๆ ตอนแก้ปัญหาคือที่ที่กฎนี้ถูกละเมิด

**การจับต้องและการ reflow** — ชิ้นส่วนนี้บอบบางต่อกระบวนการผลิตมากกว่าตอนใช้งาน:

- **MSL 1** ตาม IPC/JEDEC J-STD-033B1 เวลาที่อยู่นอกถุงบนสายการผลิตไม่จำกัด
  ภายใต้สภาวะโรงงานปกติ (≤30 °C / 85 %RH) และควรใช้ภายในหนึ่งปีนับจากวันส่งมอบ
  นี่คือข่าวดีข้อเดียว — ไม่ต้องอบ ไม่ต้องมีตู้ควบคุมความชื้น
- **Reflow ตาม J-STD-020 อุณหภูมิสูงสุด ≤ 245 °C ไม่เกิน 30 วินาที**, อัตราการขึ้น
  < 3 °C/วินาที, อยู่เหนือ T_L = 220 °C ไม่เกิน 60 วินาที, อัตราการลง < 4 °C/วินาที
  ขณะยังอยู่เหนือ T_L
- **245 °C ต้องไม่ถูกเกินที่จุดใดของชิ้นส่วน ไม่ใช่แค่ที่แพด** ดาต้าชีตเตือนว่า
  อุณหภูมิภายในฝาครอบสูงกว่าที่เทอร์โมคัปเปิลบนแลนด์อ่านได้ ถ้าวัดโปรไฟล์ที่แพด
  ให้เผื่อระยะไว้
- **ใช้กับ vapour-phase reflow ไม่ได้** ใช้ลมร้อนหรือเตา IR/convection เท่านั้น
- **ห้ามถอด ทำให้เปียก หรือแตะต้องแผ่นกันฝุ่นสีขาว** ไม่ว่าก่อน ระหว่าง หรือหลัง
  มันไม่ใช่วัสดุห่อหุ้ม
- **ห้ามเติมฟลักซ์เพิ่ม ห้าม reflow รอบที่สอง และห้ามล้างบอร์ดหลังบัดกรี**
  บอร์ดหัววัดที่ถูกล้างหลังบัดกรีคือเซนเซอร์ที่ต้องทิ้ง
- **เคารพพื้นที่ห้ามวาง** รอบรูระบายความร้อนใน land pattern (ดาต้าชีต §4.2)
  ตะกั่วไหลเข้าไปในรูนั้นคือข้อบกพร่องคลาสสิก
- **การ reflow ทำให้ค่า CO2 เพี้ยนชั่วคราว** ความแม่นยำเต็มที่กลับมา
  **ภายในไม่เกินห้าวัน** หลังบัดกรี ไม่ว่าจะจ่ายไฟให้เซนเซอร์หรือไม่ ดังนั้น:
  อย่าตัดสินหัววัดที่เพิ่งประกอบเสร็จ และ **อย่ารัน FRC กับมัน** — ดาต้าชีตระบุชัดว่า
  การสอบเทียบควรทำหลังการประกอบไม่น้อยกว่าห้าวัน ประกอบหัววัดแล้วทิ้งไว้หนึ่งสัปดาห์
  ก่อนจะสอบเทียบอะไรก็ตาม

เลเซอร์มาร์กบน **ผนังด้านข้างของฝาครอบ** ระบุรุ่น (SCD40 / SCD41 / SCD43) และ
ซีเรียลแบบ data matrix ให้ตรวจดู: SCD40 กับ SCD41 หน้าตาเหมือนกันเมื่อมองจากด้านบน
ใช้แอดเดรส 0x62 เหมือนกัน และ SCD40 **ไม่มีคำสั่ง `measure_single_shot`**
(ดาต้าชีต §3.11: เฉพาะ SCD41 และ SCD43) ซึ่งเป็นคำสั่งเดียวที่โหนดนี้พึ่งพา
ดาต้าชีตไม่ได้บอกว่า SCD40 ตอบสนองต่อคำสั่งนั้นอย่างไร จึงอย่าวางแผนตรวจจับ
ความผิดพลาดนี้ด้วยเฟิร์มแวร์ — ให้อ่านที่ฝาครอบ

**การติดตั้ง สำหรับโรงเรือนเห็ดโดยเฉพาะ:**

- **ไม่ต้องมี radiation shield** โรงเรือนเห็ดมืด ไม่มีภาระความร้อนจากแดดให้บัง
  ข้อกำหนดนั้นเป็นของรุ่นโรงเรือนพืชและถูกลบทิ้ง ไม่ใช่แค่ผ่อนปรน
- **กล่องระบายอากาศที่กันละอองน้ำ** โดยให้ **ช่องแพร่แก๊สหันลงล่าง** เพื่อให้หยดน้ำ
  หยดทิ้งแทนที่จะขัง และมี **เมมเบรน PTFE/Gore** ที่ยอมให้ CO2 ผ่านแต่ไม่ให้น้ำเหลวผ่าน
- **ห้ามปิดผนึก** กล่องที่ปิดสนิทจะวัด CO2 ของอากาศภายในตัวเอง ซึ่งเป็นตัวเลขที่ไม่มี
  ความหมาย
- **ห้ามอยู่ในแนวที่หัวฉีดหมอกพ่นใส่โดยตรง** นี่คือกฎการวางตำแหน่งข้อเดียวที่เฉพาะกับ
  อาคารนี้ ให้เลือกจุดก่อนเจาะเคเบิลแกลนด์

#### การควบแน่น และฮีตเตอร์ที่ยังไม่ได้ใส่

**SCD41 กระจายความร้อนเฉลี่ยราว 1.5 mW** (0.45 mA × 3.3 V) ซึ่งไม่พอเลยที่จะทำให้
ตัวเองอุ่นกว่าอากาศรอบข้าง เซนเซอร์ที่อุ่นกว่าอากาศหนึ่งถึงสององศาจะกันความชื้นเฉพาะที่
ไม่ให้ถึงจุดน้ำค้างได้ฟรี ๆ ตัวนี้ทำไม่ได้ และมันกำลังจะเข้าไปอยู่ในอาคารที่ถูกฉีดหมอก
ทุกวันและอยู่ที่ 90–95 %RH พูดตรง ๆ: **นี่คือแกนเดียวที่ดีไซน์นี้ไม่มีคำตอบแบบ passive**
ส่วนบอร์ดรุ่นก่อนมีการป้องกันข้อนี้โดยบังเอิญ เพราะเซนเซอร์ของมันเผาไป 90 mW

คำตอบคือ **แพดตัวต้านทานฮีตเตอร์ที่หัววัด วางลายไว้ตอนนี้และปล่อยเป็น DNP**:

- ราว **220 Ω คร่อมไฟ 3.3 V ของกิ่งนั้น** คือราว 50 mW, 15 mA — พอที่จะทำให้กล่องเล็ก ๆ
  อุ่นกว่าอากาศราวหนึ่งองศา
- มันจะเพิ่ม **~1.2 Wh/วัน** ทำให้โหนดจาก ~0.8 เป็น ~2.0 Wh/วัน — **2.5 % ของแผง**
  และยังน้อยกว่าที่บอร์ดนี้เคยกินก่อนลบราง 5 V ทิ้ง พลังงานที่การลบนั้นปลดปล่อยออกมา
  จ่ายค่าฮีตเตอร์ได้หลายเท่า
- **มันจำเป็นหรือไม่เป็นคำถามสำหรับล็อก ไม่ใช่สำหรับเอกสารนี้** ให้ติดตั้งด้วย SHT45
  ก่อน เก็บล็อก T/RH ที่กลางโรงเรือน คำนวณจุดน้ำค้าง แล้วค่อยใส่ตัวต้านทานถ้าการควบแน่น
  เกิดขึ้นจริง การวางแพดไว้ตอนนี้คือสิ่งที่ทำให้มันเป็นงานบัดกรี ไม่ใช่งานออกแบบกล่องใหม่

> ฮีตเตอร์ต่อกับ **ไฟ 3.3 V ของกิ่งเอง** ซึ่งอยู่ปลายน้ำของเกต มันจึงให้ความร้อน
> เฉพาะตอนที่โหนดตื่น — ~11 วินาทีใน 900 วินาที ถ้าล็อกแสดงว่าการควบแน่นตอนเช้ามืด
> เกิดสม่ำเสมอ ดิวตี้ไซเคิลนั้นไม่พอ และทางแก้ที่ซื่อสัตย์คือตัวต้านทานที่รับไฟจาก
> `V3V3_MCU` ก่อนเกต อย่าไปค้นพบเรื่องนี้บนเสา — ให้ตัดสินจากล็อก

#### สิ่งที่ SCD41 รายงานแต่โหนดนี้ทิ้ง

`read_measurement` คืนค่า CO2 **และ** อุณหภูมิ **และ** ความชื้น และ `scd41_read()`
ส่งกลับมาทั้งสามค่า แต่ส่งออกอากาศเฉพาะ CO2

นั่นเป็นความตั้งใจ: SCD41 มีความร้อนในตัว ค่า T/RH ของมันเองจึงอ่านสูง — ดาต้าชีต
มีทั้งหัวข้อ (§3.7) ว่าด้วยค่าออฟเซ็ตอุณหภูมิที่ต้องใช้แก้ ส่วน SHT45 คือ ±0.1 °C /
±1 %RH และไม่มีความร้อนในตัว ค่า T/RH ของ SCD41 ถูกเปิดออกมาเพียงเพราะมันมาฟรี
และมีประโยชน์ตอน bring-up: **ถ้าอุณหภูมิของ SCD41 อ่านสูงกว่า SHT45 ตัวใกล้ที่สุดมาก
แปลว่าหัววัดระบายอากาศไม่ได้**

### เกตรางไฟ — ตอนนี้เป็นกลไกกู้คืน ไม่ใช่มาตรการประหยัดพลังงาน

**วัตถุประสงค์ของมันเปลี่ยนไปทั้งหมดเมื่อไฟเลี้ยงกลายเป็นโซลาร์** บนแบตเตอรี่
เกตมีไว้เพื่อไม่ให้กระแสรั่วระดับไมโครแอมป์มีความหมายเมื่อสะสมเป็นเดือน ๆ
งบ I_DSS 5 µA ด้านล่างเคยเป็นข้อจำกัดจริง แต่บนแบงก์ 24 V ที่มีแผงโซลาร์เลี้ยง
เลขนั้นไม่มีความหมายอีกแล้ว — ทั้งโหนดเฉลี่ยไม่ถึงหนึ่งมิลลิแอมป์ และแผงผลิตได้
มากกว่าที่ใช้แปดสิบเท่า

**แต่ให้คงเกตไว้ ด้วยเหตุผลใหม่** ตอนนี้มีสาย I2C ไม่มีชีลด์ยาว 5 ม. **สี่เส้น** วิ่ง
ผ่านโรงเรือนเห็ดที่ถูกฉีดหมอก และความล้มเหลวประจำของ I2C คือกลิตช์ที่
ล็อก SDA ค้างต่ำจนกว่าจะมีอะไรมาคล็อกบัสให้หลุด การตัดไฟแล้วจ่ายใหม่คือวิธีกู้คืน
วิธีเดียวที่ได้ผลเสมอ เกตจึงกลายเป็น **ปุ่มรีเซ็ต I2C และ 1-Wire** ของโหนดนี้
และเฟิร์มแวร์ควรใช้มันแบบนั้น: เมื่อทรานแซกชันล้มเหลว ให้ปิดเกต รอ เปิดเกต ลองใหม่

> **ทุกอย่างที่ front-end อ่านถูกสวิตช์หมด รวมทั้ง CO2** ข้อนี้ควรพูดให้ชัด เพราะมันคือ
> สิ่งที่ทำให้เกตเป็นกลไกกู้คืนที่สมบูรณ์ ไม่ใช่กู้คืนได้แค่บางส่วน: ไม่มีเซนเซอร์ตัวไหน
> บนบอร์ดนี้ที่ `SENS_GATE` ตัดไฟไม่ได้ และไม่มีรางไฟที่เปิดตลอดเวลาให้ต้องคิดถึง
> ข้อนี้ไม่เป็นจริงก่อนรุ่น 2.0 — ดู *เซนเซอร์ CO2*

อยู่ต้นทางของโพรบหกตัว กิ่ง I2C ทั้งสี่เส้น และ bus switch ที่แยกมันออกไป —
ซึ่งตอนนี้คือทุกอย่าง:

```
  U7 3V3 ─────┬──────────────── S │ Q1 (P-MOSFET) │ D ──┬──── VSENS
              │                     G                   │
            [100k]                  │                 [C1 bulk]
              │                     │                   │
              └─────────────────────┤                  GND
                                    │
   PA8 (SENS_GATE) ──[100R..1k]─────┘
```

`SENS_GATE` เป็น LOW จะดึงเกตให้ต่ำกว่าซอร์ส → P-FET นำกระแส → `VSENS` มีไฟ
ถ้าเป็น Hi-Z หรือ HIGH → ตัว 100 k จะดึงเกตให้เท่ากับซอร์ส → ปิด

| อุปกรณ์ | ค่า | เหตุผล |
|---|---|---|
| พูลอัพ DQ ×6 | **4.7 kΩ** | สำหรับสายยาว **5–10 ม.** กรณีเลวร้ายสุด (10 ม. ของ Cat5 ~56 pF/m) สายขึ้นถึง VIH ใน **3.0 µs** เทียบกับงบ **9 µs** ของช่วงอ่านในเฟิร์มแวร์ — เผื่อ 3 เท่า ใช้ **3.3 kΩ** เฉพาะเมื่อเดินสายแบบชีลด์ (~100 pF/m) ที่ปลายระยะ 10 ม. ส่วน 2.2 kΩ คือค่าของระยะ 20 ม. ยังใช้ได้อยู่ แต่กินกระแสตอนดึงลงเป็นสองเท่า |
| ตัวต้านทานอนุกรม DQ ×6 | **100 Ω** | หน่วงการสะท้อนของสัญญาณ และเป็นชิ้นส่วนที่ยอมเสียสละก่อนถึง TVS |
| TVS ×6 | สองทิศทาง, **<50 pF**, V_RWM **≥ 3.6 V** | สายเปียกกลางแจ้งยาว 5–10 ม. ก็ยังเป็นสายอากาศดี ๆ นี่เอง ระยะที่สั้นลงทำให้งบนี้ผ่อนคลายขึ้นแต่ไม่ได้ทำให้หายไป ค่าคาปาซิแตนซ์คือสเปกที่สำคัญ — อุปกรณ์ป้องกันที่ค่า C สูงจะทำให้ขอบบิตมนจนใช้ไม่ได้ ดู *การเลือก TVS* ด้านล่าง: เกณฑ์นี้ตัดอุปกรณ์ส่วนใหญ่ที่ค้นเจอจากคำว่า "TVS" ออกไป |
| ตัวเก็บประจุที่โพรบ ×6 | **100 nF** | อยู่ที่ปลาย **ไกล** คร่อม VDD/GND ของโพรบ ไม่ใช่บน PCB |
| บัลค์บน `VSENS` | **1–10 µF** | ถูกจำกัดด้วยเวลาเซตเทิลด้านล่าง |
| พูลอัพ I2C | **4.7 kΩ** | ต่อกับ `VSENS` เหมือนของ 1-Wire ที่ 100 kHz บนระยะไม่กี่เซนติเมตรบนบอร์ด ไม่ต้องการค่าที่เร็วกว่านี้ **สี่คู่**: หนึ่งคู่ต้นทาง และคู่ละหนึ่งช่อง mux |
| บัลค์เฉพาะที่ของ SCD41 | **10 µF** | รับขั้นกระแส 205 mA ไว้ใกล้ตัวชิป เพื่อไม่ให้ไปปรากฏบน `VSENS` |

> **พูลอัพหกตัวไม่ได้กินกระแสตอนสแตนด์บาย** มันอยู่ที่ระดับสูงตอนสายถูกปล่อย
> และจะดึงกระแสเฉพาะตอนที่อุปกรณ์หรือ MCU ดึงสายลงต่ำเท่านั้น — ไม่กี่มิลลิแอมป์
> เป็นเวลาไม่กี่มิลลิวินาทีต่อการตื่นหนึ่งครั้ง แต่มัน *เป็น* อุปกรณ์อีกหกชิ้น
> บนรางที่ถูกสวิตช์ ซึ่งเป็นเหตุผลข้อที่สอง (ต่อจากกระแสรั่ว) ที่มันต้องอยู่บน
> `VSENS` ไม่ใช่บน 3V3 ที่จ่ายตลอด

#### การเลือก TVS

อุปกรณ์ชิ้นเดียวนี้มีวิธีเลือกผิดง่าย ๆ อยู่สองแบบ และทั้งสองแบบทำให้บัสพัง
ไม่ใช่แค่ป้องกันได้ไม่ดี

**มันไม่ใช่ไดโอดเรียงกระแส** ตระกูล `SS` — SS110, SS120, SS210, SS220, SS310,
SS320, SS510, SS515, SS520 — คือ **ไดโอด Schottky เรียงกระแส** อ่านรหัสได้ว่า
`SS<กระแสเป็นแอมป์><แรงดัน/10>`; แพ็กเกจ SMA/SMB/SMC คือสิ่งที่ทำให้มันดูเหมือน
เป็นตัวเลือก การใส่มันลงตรงนี้ล้มเหลวพร้อมกันสามทาง:

- **มันไม่แคลมป์เลย** ไดโอดเรียงกระแส 100 V ไม่ทำอะไรบนสาย 3.3 V เลย
  จนกระทั่งนานหลังจาก DS18B20 (พิกัดสูงสุดสัมบูรณ์ +6.0 V ที่ขา DQ)
  และขา MCU พังไปแล้ว
- **ค่าคาปาซิแตนซ์** คาปาซิแตนซ์ของรอยต่อแปรตามพื้นที่ไดย์ จึงเพิ่มขึ้นตามพิกัดกระแส:
  แม้แต่ตัว 1 A ก็อยู่ในระดับหลายสิบถึงหลายร้อย pF และตัว 5 A แย่กว่ามาก
  อะไรที่ใกล้ 50 pF จะทำให้ขอบบิตของ 1-Wire มนเมื่อใช้สายยาว
- **กระแสรั่วย้อนกลับที่อุณหภูมิสูง** ข้อนี้เจ็บที่สุด กระแสรั่วของ Schottky
  เพิ่มเป็นสองเท่าทุก ๆ 10 °C โดยประมาณ ตัว TVS อยู่ระหว่าง DQ กับ GND
  ขณะที่ DQ ถูกดึงสูงผ่าน 4.7 kΩ: ระดับหลายสิบ µA คิดเป็น 47 mV ซึ่งไม่เป็นไร
  แต่ระดับมิลลิแอมป์ที่อุณหภูมิบอร์ด 60–70 °C ต้องใช้แรงดันคร่อมพูลอัพถึง 4.7 V
  สายจึงไม่มีวันขึ้นถึงระดับสูงที่ถูกต้อง นั่นคือโหนดที่ผ่านการทดสอบบนโต๊ะ แต่ตายกลางแดด
  พูลอัพ 4.7 kΩ ที่อ่อนกว่าเดิมทำให้ความล้มเหลวแบบนี้ *ไวขึ้น* กว่าตอนใช้ 2.2 kΩ
  ไม่ใช่น้อยลง — ให้คิดงบกระแสรั่วของ TVS เป็นระดับ µA เท่านั้น ห้ามถึง mA

**และมันก็ไม่ใช่ TVS แบบทั่วไปด้วย** TVS สำหรับงานกำลังที่แรงดันต่ำ — SMAJ5.0CA,
SMBJ5.0CA, SMF5.0CA และพวกเดียวกัน — โดยทั่วไปมีค่าตั้งแต่หลายร้อยถึงเกิน 1000 pF
เพราะแรงดันพังทลายต่ำหมายถึงไดย์ใหญ่ พวกมันจะทำให้บัสพังด้วยเหตุผลเดียวกันกับ Schottky

สิ่งที่ต้องการคืออุปกรณ์กลุ่ม **signal-line / ESD-array**:

| พารามิเตอร์ | ค่า |
|---|---|
| ชนิด | TVS สองทิศทาง ที่ระบุขายว่าเป็นแบบ **low-capacitance** ชัดเจน |
| แรงดันใช้งาน `V_RWM` | **≥ 3.6 V** — `VSENS` ขึ้นถึง 3.6 V เมื่อแบตเตอรี่ใหม่ ดังนั้นอุปกรณ์ 3.3 V จึงก้ำกึ่ง กลุ่ม 5 V คือตัวเลือกที่ใช้งานได้จริง |
| แรงดันแคลมป์ | ต่ำที่สุดเท่าที่หาได้; ตัว 100 Ω ของ R9–R14 รับส่วนที่เหลือ |
| คาปาซิแตนซ์ | **≤ 50 pF** และระดับ ≤ 15 pF หาซื้อได้ง่าย |
| แพ็กเกจ | SOD-323 / SOT-23 |

สังเกตว่างบคาปาซิแตนซ์นั้นหลวมมาก ช่วงบิตของ 1-Wire คือราว 60 µs; นี่ไม่ใช่ USB
อะไรก็ตามในกลุ่มอุปกรณ์ป้องกัน ESD ผ่านเกณฑ์ 50 pF ได้สบาย ๆ ดังนั้น
**อย่าจ่ายแพงเพื่อค่า 0.3 pF** — เอาความพยายามในการเลือกไปทุ่มที่ `V_RWM`
และที่กระแสรั่วแทน

อุปกรณ์สามตัวที่ตรวจสอบกับสเปกนี้แล้ว (ราคา/สต็อกจาก LCSC เดือน ส.ค. 2026):

| เบอร์ | `V_RWM` | C ทั่วไป | แพ็กเกจ | แคลมป์ | กระแสรั่ว | ราคา | คำตัดสิน |
|---|---|---|---|---|---|---|---|
| Bourns **CDSOD323-T05LC** | 5.0 V | 1.0 pF | SOD-323 | 9.8 V @ 1 A, 18.3 V @ 15 A | สูงสุด 5 µA | ~$0.47–0.71 | **แนะนำ** บัดกรีมือได้ 350 W มีระยะเผื่อเหลือเฟือทุกด้าน |
| onsemi **ESD9B5.0ST5G** | 5.0 V | 15 pF | **SOD-923** | 12.5 V | ต่ำ | ~$0.018 | **ตัวเลือกประหยัด** ถูกกว่า 30 เท่า และ 15 pF ก็ยังใช้ได้ดี — แต่ SOD-923 ขนาด 0.8 × 0.6 มม. เหมาะกับโรงงานประกอบ ไม่เหมาะกับการบัดกรีมือ |
| BORN **BSD3C031L2** | **3.3 V** | 1.4 pF | SOD-323 | 17 V | 200 nA | ~$0.06 | **ไม่ผ่าน — และเป็นตัวที่สอนอะไรได้มากที่สุด** ทุกอย่างของมันดีหมด แต่ `VSENS` ขึ้นถึง **3.6 V** เมื่อแบตเตอรี่ใหม่ ซึ่งเกินพิกัดแรงดันใช้งานของมัน และค่ากระแสรั่ว 200 nA รับประกันไว้ที่ 3.3 V เท่านั้น |

แถวสุดท้ายคือกับดักที่บรรทัด `V_RWM ≥ 3.6 V` มีไว้ดักพอดี: อุปกรณ์ 3.3 V
ดูเหมือนของถูกจนกระทั่งแบตเตอรี่ก้อนใหม่ไบแอสมันเกินพิกัด แล้วมันก็เริ่มโหลดบัส

> **วิธีคัดแยกอย่างรวดเร็ว:** ดาต้าชีตของ TVS สำหรับสายสัญญาณจะใส่ค่าคาปาซิแตนซ์
> ไว้ในสเปกหลัก ส่วนดาต้าชีตของ TVS สำหรับงานกำลังจะซ่อนหรือไม่ระบุค่านั้น
> ถ้าต้องไล่หาตัวเลข pF อยู่นาน แสดงว่าเลือกอุปกรณ์ผิดกลุ่มแล้ว

**TVS ฝั่งบอร์ดป้องกันอะไรกันแน่** มันป้องกัน **MCU** ไม่ใช่โพรบ ตัว DS18B20
อยู่ห่างออกไป 5–10 ม. หลังค่าเหนี่ยวนำของสายราว 2.5–5 µH ซึ่งที่อัตรา di/dt ของเสิร์จ
ถือว่าเป็นวงจรเปิดโดยปริยาย — ไม่มีอะไรบน PCB นี้ป้องกันมันได้ และก็ไม่มีที่ที่
เหมาะสมจะใส่วงจรป้องกันไว้ที่โพรบสามสายซึ่งหล่ออีพ็อกซีมาแล้ว
นี่คือข้อแลกเปลี่ยนที่ยอมรับได้: โพรบราคาถูกและเปลี่ยนได้ ส่วน Nucleo ไม่ใช่

**เรื่องแรงดันแคลมป์** ค่า 18.3 V ที่ 15 A สูงกว่าทั้งพิกัดสูงสุดสัมบูรณ์ +6.0 V
ของ DS18B20 และความทนทานของ MCU อยู่มาก และนั่นไม่เป็นไร — เพราะนั่นคือหน้าที่
ของ R9–R14 ตัว 100 Ω ที่ต่ออนุกรมจำกัดกระแสที่ฉีดเข้าไดโอดแคลมป์ภายในของ MCU
ไว้ที่ราว (18.3 − 3.8) / 100 ≈ 145 mA ที่พัลส์กรณีเลวร้ายสุด และราว 60 mA
ที่จุดแคลมป์ 1 A ถ้าต้องการระยะเผื่อมากขึ้น **220 Ω ก็ใช้ได้**: ระดับต่ำของ DQ
จะกลายเป็น 3.3 × 220 / 4920 ≈ **0.15 V** เมื่อใช้พูลอัพ 4.7 kΩ (เดิมคือ 0.30 V
ตอนใช้ 2.2 kΩ) ซึ่งยังต่ำกว่าเกณฑ์ 0.3 × VDD
ของ DS18B20 อย่างสบาย และกระแสที่ฉีดเข้าไปลดลงครึ่งหนึ่ง อย่าเพิ่มเกินกว่านั้นมาก
มิฉะนั้นระดับต่ำจะเริ่มไม่น่าเชื่อถือ

**ใช้อุปกรณ์แยกหกตัว ไม่ใช้อาร์เรย์** อาร์เรย์แบบ 4 หรือ 6 สายจะประหยัดพื้นที่บอร์ด
แต่อาร์เรย์ชนิด rail-clamp อ้างอิงกับขาไฟเลี้ยง ซึ่งบนบอร์ดนี้คือ `VSENS`
ที่ *ถูกสวิตช์* — เท่ากับมีอีกเรื่องให้ต้องคิดตอนปิดเกต โดยไม่ได้อะไรกลับมาเลย
บนบอร์ดที่มีพื้นที่เหลือเฟือ อีกทั้งอุปกรณ์สองขาที่เหมือนกันหกตัวยังทำให้แต่ละช่อง
เป็นอิสระต่อกันจริง ๆ ซึ่งเป็นเหตุผลเดียวกับที่ให้โพรบแต่ละตัวมี GPIO ของตัวเอง

### ข้อจำกัดเรื่องเวลาเซตเทิล

มีหน้าต่างเวลาเซตเทิล **สอง** ช่วง และทั้งสองดึงไปคนละทาง:

| ค่าคงที่ | ค่า | สิ่งที่ต้องเป็นจริงภายในเวลานั้น |
|---|---|---|
| `DS_POWER_SETTLE_MS` | **10 ms** | `VSENS` ขึ้นเต็มที่ เพื่อให้สัญญาณรีเซ็ต 1-Wire ครั้งแรกเห็นบัสที่ถูกต้อง |
| `I2C_POWER_SETTLE_MS` | **10 ms** | SHT45 พร้อมรับคำสั่ง (เวลา soft-reset ราว 1 ms) |

**หน้าต่าง 1000 ms ไม่เคยมีอยู่จริง** เฟิร์มแวร์เคยมีค่าคงที่เวลาเริ่มทำงานของ SCD41
เป็น 1000 ms และเอกสารฉบับนี้ก็เคยพูดซ้ำว่าเป็นข้อเท็จจริง มันครอบงำทุกครั้งที่ตื่น
และลำดับการทำงานถูกออกแบบมาเพื่อเอามันไปซ้อนกับการแปลงค่า 750 ms ของ DS18B20
**แต่ SCD4x v1.7 Table 7 ระบุว่าเวลาเริ่มทำงานคือ 30 ms สูงสุด** และไม่มีอะไรใน
เอกสารรุ่นนั้นรองรับเลข 1000 ค่าคงที่ถูกแก้ในปี 2026-09 ส่วนการซ้อนเวลายังอยู่
เพราะเป็นแนวปฏิบัติที่ดีและตอนนี้ไม่มีต้นทุนเลย ส่วน SHT45 ต้องการราวหนึ่งมิลลิวินาที
`I2C_POWER_SETTLE_MS` จึงอยู่ที่ **10 ms** และเวลาที่รางไฟเปิดถูกกำหนดโดย
**การแปลงค่า 750 ms**

**สิ่งที่ SCD41 เพิ่มเข้ามาคือเวลาวัด ไม่ใช่เวลาเซตเทิล:** single shot 5 วินาทีสองครั้ง
ทำให้หน้าต่างที่เกตเปิดจาก ~1 วินาทีเป็น **~11 วินาที** เฉลี่ยต่อการตื่นแล้วคือ
0.0136 Wh/วัน ซึ่งเป็นแถวที่เล็กที่สุดในงบของ §5

ให้คุมบัลค์รวมบน `VSENS` ไว้ที่ **≤10 µF** และใส่ **100 Ω–1 kΩ อนุกรมกับเกต**
เพื่อลดกระแสกระชาก — ซึ่งจะได้เวลาราวหนึ่งมิลลิวินาที ส่วนบัลค์เฉพาะที่ 10 µF
ของ SCD41 ถูกลบทิ้งไปพร้อมกับตัวอุปกรณ์ ถ้าเพิ่มบัลค์ขึ้นอีก ก็ต้องเพิ่ม
`DS_POWER_SETTLE_MS` ตามไปด้วย ทั้งสองเป็นการตัดสินใจเดียวกัน

**อย่าลืมนับตัวเก็บประจุที่โพรบเข้าไปในงบนี้ด้วย** พวกมันทำหน้าที่ดีคัปปลิ้ง ณ
ตำแหน่งที่มันอยู่ แต่เกตก็ยังต้องชาร์จมันผ่านสายอยู่ดี: 100 nF หกตัว = **0.6 µF**
ที่เพิ่มเข้ามาบน `VSENS` เทียบกับ C1 ที่ 1–10 µF คิดเป็น 6–40 % — น้อย แต่มีจริง
และจะโตขึ้นถ้าเพิ่มโพรบหรือต่อสายให้ยาวขึ้น ความต้านทานของสายเป็นตัวหน่วง
การชาร์จมากกว่าตัว FET แต่เวลา 10 ms ก็ยังมีระยะเผื่อเหลือเฟือสำหรับ 0.6 µF
ผ่านความต้านทาน 0.8–1.7 Ω ของสายยาว 5–10 ม.

> ถ้าใส่ตัวเก็บประจุใหญ่เกินไปโดยไม่แก้ค่าคงที่ อาการที่ได้คือ CRC ผิดเป็นครั้งคราว
> ในการอ่านครั้งแรกหลังตื่นแต่ละรอบ — และเมื่อมีโพรบหกตัว คุณจะได้สนุกกับการเดา
> ว่าตัวไหนใน "หกตัวคือตัวที่มีปัญหา" ซึ่งเป็นเรื่องน่าปวดหัวมากเมื่อต้องไล่หาหน้างาน

### เรื่องของ P-FET

เซนเซอร์ CO2 คือสิ่งที่กำหนดว่าอุปกรณ์ตัวนี้ต้องทำอะไรได้ และโพรบหกตัวไม่ได้
เปลี่ยนเรื่องนั้น:

1. **กระแสเดรนต่อเนื่องและ R_DS(on)** ที่แรงดันขับเกต 3.3 V โหลดคือ SCD41
   ราว 205 mA บวกโพรบอีกราว 9 mA — อุปกรณ์ระดับ AO3401 ที่ราว 50 mΩ
   ทำให้เกิดแรงดันตกราว 11 mV ซึ่งสบาย ๆ แต่ก็ไม่ได้เหลือเฟือจนไม่ต้องตรวจสอบ
2. **กระแสรั่วเดรน-ซอร์ส (I_DSS)** ยังคงเป็นพารามิเตอร์ที่สำคัญที่สุด: ที่รอบการทำงาน
   15 นาที อุปกรณ์นี้ปิดอยู่ 99.9 % ของเวลา ที่ราว 1 µA มันอยู่ในระดับเดียวกับ
   กระแส Stop2 ของ STM32 นั่นคือเกตจ่ายไฟกลายเป็นสัดส่วนที่มีนัยสำคัญของงบแบตเตอรี่
   ทางอัปเกรดคือ P-FET ที่กระแสรั่วต่ำ หรือไอซี load switch ที่ระบุกระแสขณะปิด
   ต่ำกว่า 100 nA
3. **กระแสกระชากเข้าสู่บัลค์ที่ใหญ่ขึ้น** คาปาซิแตนซ์บน `VSENS` ที่มากขึ้นหมายถึง
   กระแสกระชากตอนเปิดที่ใหญ่ขึ้นผ่าน FET ตัวเดิม ตัวต้านทานอนุกรมที่เกตคือสิ่งที่จำกัดมัน

ให้เดินลายทองแดง **3.3 V ของ U7** → Q1 → `VSENS` แบบ **กว้าง** และให้เส้นกลับ GND
ของ SCD41 สั้นและอ้วน กระแส 205 mA ที่วิ่งผ่านลายบาง ๆ คือแรงดันตกที่มองเห็นได้
บนรางที่ SHT45 และ DS18B20 ทั้งหกตัวใช้ร่วมกัน บนบอร์ดใหญ่มักมีความคิดอยากให้
`VSENS` เดินอ้อมไปหาขั้วต่อทั้งหก — อย่าทำ ให้เดินเป็นแกนหลักแล้วแยกแขนงสั้น ๆ ออกไป

---

## 4. รายการวัสดุ (BOM)

แบ่งเป็นสองส่วน เพราะบอร์ดไม่ใช่ทั้งหมดของดีไซน์อีกต่อไป: อุปกรณ์ที่อยู่บน
**PCB front-end** ในกล่องแห้ง และอุปกรณ์ที่อยู่ **ปลายสายที่ตัวเซนเซอร์**

> **ซื้อได้ที่ไหน:** ดู [`sourcing-th.md`](sourcing-th.md) ซึ่งมีเลขรุ่นของผู้ผลิต
> สำหรับทุกอย่างที่ไม่ใช่อุปกรณ์ทั่วไป สิ่งที่ต้องตรวจสอบเมื่อจะใช้ของทดแทน และ
> รายการที่ควรซื้อจากร้านในไทยมากกว่าสั่ง Digi-Key TH

> **จะวาดลงบอร์ดจริง:** ดู [`pcb-altium.md`](pcb-altium.md) (ภาษาอังกฤษ) ซึ่งพา
> ตารางนี้เข้า Altium Designer 17 ตั้งแต่การจัดโปรเจ็ค, footprint ที่แต่ละ ref ต้องใช้,
> การวางชิ้นส่วนตามกฎใน §5 ไปจนถึงไฟล์สั่งผลิต และมีหัวข้อตรวจชีต schematic
> ที่วาดไว้แล้วเทียบกับหัวข้อนี้ด้วย

### 4a. PCB front-end

| Ref | อุปกรณ์ | ค่า / สเปก | หมายเหตุ |
|---|---|---|---|
| J7 | Box header **2×20** มีกรอบ | 2.54 มม. มีคีย์ มีตัวล็อก | สายสัญญาณไป Nucleo CN10 **15 สัญญาณ** ในรุ่น 2.0 **40 ตำแหน่ง โดย 39 กับ 40 ไม่ต่อกับอะไรเลย** — 2×19 ไม่ใช่ขนาดที่ผู้ผลิต IDC ทำ ขั้วจึงกว้างกว่า CN10 หนึ่งคอลัมน์ และตัวนำส่วนเกินยื่นเลยปลาย CN10 ออกไป (§1) |
| CN6 | เฮดเดอร์ 1×8 | 2.54 มม. | **ทางออกของไฟ 3.3 V** สะท้อนพินเอาต์ของ CN6 บน Nucleo ทีละขา ต่อสายจริงเฉพาะตำแหน่ง 4, 6 และ 7 **ตัดขา CN6-1 บน Nucleo และอุดรูที่ 1 ของซ็อกเก็ต** — ดู §2 *จุดต่อไฟที่ CN6* |
| J14 | ขั้วต่ออินพุตโซลาร์ 2 ขา | มีคีย์ มีตัวล็อก ≥5 A | **ไฟเข้า 24 V** จากชาร์จคอนโทรลเลอร์ |
| J1–J6 | เทอร์มินอลบล็อกถอดได้ 3 ขา | Phoenix MC 1,5/3-ST-3,5 หรือเทียบเท่า | **หนึ่งตัวต่อโพรบ** รวมหกตัว |
| J9–J12 | เทอร์มินอลบล็อกถอดได้ 4 ขา | ตระกูลเดียวกัน | **หนึ่งตัวต่อกิ่ง I2C หนึ่งเส้น — ขั้วต่อเหมือนกันสี่ตัว เบอร์เดียว** `V / SDA / SCL / G` พิมพ์ปลายทางบนซิลค์สกรีน: `CH0 หัว`, `CH1 ท้าย`, `CH2 นอก`, **`CH3 CO2 กลาง`** |
| J13 | Pin header 1×3 | 2.54 มม. | **ดีบัก UART** `TX / RX / GND` สำหรับ USB-serial adapter |
| **เกตรางไฟ** ||||
| Q1 | P-MOSFET SOT-23 | **AO3401A** หรือเทียบเท่า: R_DS(on) ที่ **V_GS = −2.5 V** ≤85 mΩ, ≥0.5 A | เกตด้านสูงของรางไฟเซนเซอร์ 3.3 V |
| R1 | ตัวต้านทาน 0805 | 100 kΩ | พูลอัพเกต→ซอร์ส — **กดรางไฟให้ปิดตอนรีเซ็ต** |
| R2 | ตัวต้านทาน 0805 | 100 Ω–1 kΩ | อนุกรมที่เกต จำกัดกระแสกระชาก |
| **โพรบ 1-Wire** ||||
| R3–R8 | ตัวต้านทาน 0805 | **4.7 kΩ** | พูลอัพ DQ หกตัว ต่อกับ **`VSENS`** สำหรับสายโพรบ 5–10 ม. |
| R9–R14 | ตัวต้านทาน 0805 | 100 Ω | อนุกรม DQ หกตัว |
| D1–D6 | TVS สองทิศทาง ชนิด low-C สำหรับสายสัญญาณ | Bourns **CDSOD323-T05LC** (1 pF) หรือ onsemi **ESD9B5.0ST5G** (15 pF) | หนึ่งตัวต่อสาย DQ, `V_RWM` ≥ 3.6 V |
| **I2C / สาย SHT45** ||||
| U3 | **TCA9548A** | I2C `0x70`, bus switch 8 ช่อง | A2/A1/A0 ลง GND ใช้แค่ ch0–ch2 **ไม่มีอะไรอื่นบนบัสนี้แล้ว** |
| R23 | ตัวต้านทาน 0805 | 10 kΩ | พูลอัพ `RESET` ของ U3 ไป `VSENS` **ไม่ใช่ของเลือกได้** |
| R15, R16 | ตัวต้านทาน 0805 | 4.7 kΩ | พูลอัพ SDA/SCL **ฝั่งต้นทาง** บนบอร์ด ระยะ 30 มม. |
| R17–R22 | ตัวต้านทาน 0805 | **2.2 kΩ** | **ฝั่งปลายทาง** หนึ่งคู่ต่อช่อง **2.2 kΩ ไม่ใช่ 4.7 kΩ** เพราะแต่ละคู่ขับสาย 5 ม. |
| C8 | เซรามิก | 100 nF | ดีคัปปลิ้ง U3 |
| R39, R40 | ตัวต้านทาน 0805 | **2.2 kΩ** | คู่พูลอัพ SDA/SCL ฝั่งปลายทางของช่อง 3 — กิ่ง SCD41 ค่าเดียวกันและเหตุผลเดียวกับ R17–R22 |
| **ไฟเลี้ยง — ภาคป้องกันอินพุต (§5)** ||||
| Q2 | P-MOSFET ≥60 V | **DMP6023LE-13** แพ็กเกจ SOT-223 | กันต่อกลับขั้วที่อินพุต 24 V **เดรน (และแท็บ) ไปที่ J14 ซอร์สไปที่โหลด** — ดูหัวข้อ *Q2 — จงใจต่อ FET กลับด้าน* **ห้าม** ใช้เบอร์ 30 V |
| R38 | ตัวต้านทาน 0805 | 470 kΩ | เกต Q2 → GND ทำหน้าที่ทั้งเปิด FET **และ** จำกัดกระแสของ D10 — สองตัวนี้เป็นคู่กัน |
| D10 | ซีเนอร์ 250 mW | **12 V** (BZX84C12 SOT-23 / MMSZ5242B SOD-123) | เกต Q2 → ซอร์ส แคโทดอยู่ที่ซอร์ส **ไม่ใช่ของเสริม** — ถ้าไม่มี V_GS จะไปถึง −32 V เทียบกับขีด ±20 V |
| D9 | TVS ทิศทางเดียว | **SMBJ33A** (standoff 33 V, 600 W) | คร่อมอินพุต 24 V **หลัง Q2** — นั่นคือสิ่งที่ทำให้ใช้แบบทิศทางเดียวได้ |
| F1 | ฟิวส์ **หน่วงเวลา (T)** แนะนำแบบหลอด 5×20 มม. | 2 A, **I²t ≥ 0.5 A²s** | อินพุต 24 V กำหนดขนาดด้วย I²t ไม่ใช่แอมป์: กระแสกระชากตอนเสียบไฟผ่านไดโอดบอดีของ Q2 อยู่ราว 0.1 A²s และจะทำให้ฟิวส์ 1206 ที่ I²t ต่ำขาดโดยไม่มีเหตุ |
| C11 | อิเล็กโทรไลต์ / โพลิเมอร์ | 100 µF, **≥63 V** | บัลค์ 24 V ก่อนเข้า buck **63 V ไม่ใช่ 50 V** — D9 แคลมป์ได้สูงถึง 53.3 V |
| **ไฟเลี้ยง — โมดูล buck (§5)** ||||
| U7 | โมดูล buck **3.3 V คงที่** | Traco **TSR 1-2433**, SIP-3 เสียบรู | อินพุต 4.75–36 V, 1 A, ±2 % **เรกูเลเตอร์ตัวเดียวบนบอร์ด**: MCU (ผ่าน CN6) + `VSENS` และทุกอย่างบนนั้น ขา **1 = +V_in, 2 = GND, 3 = +V_out** (ดาต้าชีต rev. 2026-07-02) **ห้ามเดินลายใต้โมดูล** **ต้องเป็นเอาต์พุตคงที่เท่านั้น** — ห้ามใช้โมดูลปรับค่าได้ที่มีโพเทนชิโอมิเตอร์ CN6-4 และ STM32WL ตายที่ 3.6 V |
| C19 | อิเล็กโทรไลต์ — **ชิ้นเดียวกับ C11** | 100 µF, **≥63 V** (Nichicon **UVR1J101MPD**) | `C_IN` คร่อมขา 1 กับ 2 **22 µF คือค่า*ต่ำสุด*ของ Traco ไม่ใช่ค่าเป้าหมาย** C19 อยู่บนโหนด `24V_PROT` เดียวกับ C11 ซึ่งตารางนี้กำหนดเองแล้วว่าต้อง 63 V และ X7R 1210 ขนาด 22 µF/50 V ที่ไบอัส 24–29 V เหลือความจุไม่ถึงครึ่ง จึงให้ 22 µF ไม่จริง **ดังนั้นมันมีขั้ว** ดูตารางเน็ตลิสต์ด้านล่าง **ของที่ประกอบจริงห่างขา U7 6.9 มม. ไม่ใช่ ≤5 มม.** ดูหมายเหตุใต้กฎเลย์เอาต์ข้อ 3 |
| C21 | เซรามิก X7R | 22 µF, 16 V | `C_OUT` **ทางเลือก** — โมดูลไม่ต้องการ ใส่ไว้รับ step กระแสของ LoRa TX และ SCD41 ไม่ใส่ (DNP) ก็ไม่มีผล |
| — | LED + ตัวต้านทานอนุกรม | ×1 | **DNP** ไฟแสดงรางไฟสำหรับ bring-up เท่านั้น — ถ้าใส่ค้างไว้กินราว 0.5 Wh/วัน ซึ่งมากกว่าครึ่งหนึ่งของงบทั้งโหนด |
| **การวัดไฟเลี้ยง** ||||
| R24 | ตัวต้านทาน 0805, 1 % | 300 kΩ | ด้านสูงของวงจรแบ่ง `VBAT_SENSE` |
| R25 | ตัวต้านทาน 0805, 1 % | 30 kΩ | ด้านต่ำ — อัตราส่วน 11:1 ดังนั้น 32 V → 2.9 V |
| C10 | เซรามิก | 100 nF | คร่อม R25 ทำให้แหล่งจ่ายมีอิมพีแดนซ์ต่ำสำหรับ ADC |
| **ดีคัปปลิ้ง** ||||
| C1 | เซรามิก | 1–10 µF | บัลค์ `VSENS` |
| C2 | เซรามิก | 100 nF | ดีคัปปลิ้ง `VSENS` |
| **กลไก** ||||
| — | **สายแพ 40 เส้น + ซ็อกเก็ต IDC 2×20 สองตัว** | 2.54 มม. ≤30 ซม. | ซ็อกเก็ตชนิดเดียวกันทั้งสองปลาย **ตัดขา CN10-6 และอุดรูที่ 6** — ในรุ่นนี้ตัวอุดคือสิ่งที่กันไม่ให้ซ็อกเก็ตที่กว้างกว่าลงเหลื่อมไปหนึ่งคอลัมน์ (§1) |
| — | ปลั๊กคีย์ IDC | — | คีย์ (§1) กันทั้งการเสียบกลับด้าน **และ** การเลื่อนหนึ่งคอลัมน์ที่ซ็อกเก็ต 2×20 จะเปิดช่องให้เกิดได้ |
| — | สาย 8 ทาง + ซ็อกเก็ต 1×8 สองตัว | 2.54 มม. | จุดต่อ CN6 มีตัวนำจริงเฉพาะตำแหน่ง 4/6/7 **อุดรูที่ 1 ที่ปลายฝั่ง Nucleo** |
| — | ตัวอุดคีย์ของซ็อกเก็ต CN6 | — | คีย์ของ CN6 (§2) ถ้าไม่มี สายที่เสียบกลับด้านจะเอา 3.3 V ไปลง `5V` และกด `NRST` ค้างไว้ |
| — | สแตนด์ออฟไนลอน M3 + สกรู | ×8 | ทั้งสองบอร์ด |
| — | เคเบิลไทร์ / ตัวรั้งสาย | ×11 | ภายใน 30 มม. จากทุกจุดที่สายเข้า |
| ~~TP1–TP26~~ | แพดทดสอบ | **ไม่ใส่** | **บอร์ดรุ่น 2.0 ไม่มีแพดทดสอบเฉพาะ** เจตนาในการวินิจฉัยด้านล่างไม่เปลี่ยน — การวัดเหล่านั้นยังต้องทำอยู่ แต่ไปวัดที่แพดของชิ้นส่วนแทน ดูหัวข้อ *วัดที่ไหนเมื่อไม่มีแพดทดสอบ* |

> **แบบของจุดทดสอบ เก็บไว้เพราะมันคือเหตุผล ไม่ใช่ตัวชิ้นงาน**
> เคยกำหนดไว้สองชุดและถูกตัดออกจากบอร์ดเมื่อ 2026-09 เพื่อลดงานวาง ไม่ใช่เพราะ
> เหตุผลเปลี่ยน ถ้า bring-up ห้าแผ่นแรกทรมาน ให้ใส่กลับในรุ่นถัดไป — เลขด้านล่าง
> ถูกจองไว้เพื่อการนั้นโดยเฉพาะ และห้ามเอาเลข `TP` ไปใช้กับอย่างอื่น
>
> **ชุดภาคไฟ** — TP1 `VSENS` · TP9 `24V_PROT` · TP11 `GND` · TP23/TP24 คือ V_in กับ
> V_out ของ U7 (TP23 เป็นจุดที่จะวัดกระแสตอนไม่มีโหลด) · TP25 `24V_RAW` ·
> TP26 เกตของ Q2 สามจุด TP25/TP9/TP26 รวมกันแยกอาการ F1 ขาด, Q2 เสีย
> และแคลมป์เกตหายออกจากกันได้ในการวัดครั้งเดียว
>
> **ชุด I2C** — TP15–TP22 คือคู่ SDA/SCL ฝั่งปลายทางทั้งสี่ บวก TP14 เป็น `GND`
> ตัวที่สองวางอยู่กลางกลุ่ม ถ้าไม่มีทางเข้าถึงรายกิ่ง *เซนเซอร์ที่ตายกับช่อง mux
> ที่ตายจะแยกไม่ออก* และโพรบสโคปต้องการทางกลับใกล้จุดวัด — §3 คำนวณเวลาขาขึ้น I2C
> ไว้ที่ **0.60 µs เทียบงบ 1000 ns** ส่วนสายกราวด์ที่ยาวคือตัวเหนี่ยวนำที่ต่ออนุกรม
> อยู่กับขอบที่กำลังจะดู
>
> **ที่เหลือไม่เคยตั้งใจจะใส่อยู่แล้ว** — สาย `DQ` หกเส้น, `SENS_GATE`,
> `VBAT_SENSE` และคู่ SDA/SCL ฝั่งต้นทาง ทุกตัวมีแพดของชิ้นส่วนหรือเทอร์มินัล
> แบบขันสกรูถอดได้อยู่ห่างไม่กี่มิลลิเมตร

#### วัดที่ไหนเมื่อไม่มีแพดทดสอบ

ทุกค่าที่ §7 สั่งวัดยังวัดได้ บนแพดที่ใหญ่พอจะรับโพรบ ไม่มีตัวไหนเป็น 0805 —
เป็นขาสอดรูกับแท็บ SOT-223 ทั้งนั้น:

| ค่าที่วัด | ไปวัดที่ |
|---|---|
| `24V_RAW` | **แท็บของ Q2** แพด SOT-223 ขนาดใหญ่ ซึ่ง*คือ*เดรน |
| `24V_PROT` | **ขา 1 ของ U7** หรือขา **+** ของ C11 |
| เกตของ Q2 | **แพดของ R38** ฝั่งเกต หรือแพด**แอโนดของ D10** |
| `GND` | **ขา 2 ของ U7** หรือขา **−** ของ C11 |
| `VSENS` | **C1** หรือ **C2** ข้างที่เอื้อมถึงง่ายกว่า |
| V_out ของ U7 | **ขา 3 ของ U7** หรือ C21 |
| SDA/SCL ฝั่งปลายทางแต่ละช่อง | คู่พูลอัพของช่องนั้น — R17/R18, R19/R20, R21/R22, R39/R40 |

**แถวสุดท้ายคือแถวเดียวที่ยากขึ้นจริง** การจิ้มแพด 0805 บนบัสที่มีไฟด้วยมือเปล่า
เสี่ยงลัดกับแพดข้างเคียงที่ห่างไป 1 มม. ซึ่งแพดเฉพาะไม่มีปัญหานี้ ถ้าขั้นที่ 15
หรือ 16 พาคุณไปตรงนั้นมากกว่าหนึ่งครั้ง นั่นคือสัญญาณว่าควรใส่ชุด I2C ในรุ่นถัดไป
>
> กราวด์ตัวที่สองไปอยู่ตรงที่ที่การวัดต้องการมัน ไม่ใช่ตรงที่ที่ภาพวาดดูสมดุล

**ที่ถูกลบออกจากรุ่นก่อน:** U2 (SCD41), C3 (บัลค์ 10 µF ของมัน), C7 (100 nF ของมัน)
และ U1a/U1b/U1c พร้อม C4–C6 — SHT45 ไม่ได้อยู่บนบอร์ดนี้แล้ว

**ที่ถูกลบในรุ่น 1.0 (2026-09) พร้อมกับ buck LM5164:** L1, L2, C13, C16–C18, C20,
C22–C25, R26–R37 — ตัวเหนี่ยวนำ คาปาซิเตอร์ bootstrap วงจร `R_RON`/feedback/ฉีดริปเปิล
วงจรแบ่ง EN/UVLO ที่ใช้ร่วมกัน และพูลอัพ `PGOOD` รวมราวสามสิบชิ้น ทั้งหมดยังมีบันทึกอยู่ใน
[`hardware-interface-back.th.md`](hardware-interface-back.th.md)

### 4b. อยู่ที่ตัวเซนเซอร์ — ไม่ได้อยู่บน PCB

| ตำแหน่ง | อุปกรณ์ | หมายเหตุ |
|---|---|---|
| โพรบแต่ละตัว ×6 | **100 nF** | คร่อม VDD/GND ของโพรบตัวนั้นที่ปลาย **ไกล** |
| SHT45 แต่ละตัว ×3 | **SHT45-AD1B** + **100 nF** | คาปาซิเตอร์คร่อม VDD/VSS ที่ตัวเซนเซอร์ กล่องเล็กที่ระบายอากาศได้ |
| เฉพาะ SHT45 #2 | **Radiation shield** | แบบมีบานเกล็ด/Stevenson เซนเซอร์อยู่ใต้ที่บัง หันไปทางทิศเหนือ ถ้าไม่มี ค่าอ้างอิงจะอ่านสูงเกินจริง 10–15 °C กลางแดด |
| หัววัด CO2 | **Sensirion `SEK-SCD41-SENSOR`** breakout (แนะนำ) หรือ **`SCD41-D-R2`** เปล่าบนบอร์ดหัววัดเล็ก ๆ | กล่องระบายอากาศกันละอองน้ำ **หันช่องแพร่แก๊สลงล่าง** เมมเบรน PTFE/Gore **ห้ามปิดผนึก** และ **ห้ามอยู่ในแนวที่หัวฉีดหมอกพ่นใส่** **ไม่ต้องมี radiation shield** — โรงเรือนเห็ดมืด |
| หัววัด CO2 | **100 µF แบบ low-ESR** + **100 nF** | คร่อม VDD/GND ที่ตัวเซนเซอร์ ไม่ใช่ของเลือกได้ และ **low-ESR เป็นส่วนหนึ่งของสเปก**: คาปาซิเตอร์ตัวนี้เป็นทั้งแหล่งสำรองกระแสพุ่ง 205 mA และขาชันต์ของฟิลเตอร์ริปเปิลที่ทำให้สวิตชิงเรกูเลเตอร์จ่ายไฟให้ชิ้นส่วนที่ขอ LDO ได้ (§3 *คำถามเรื่อง 30 mV*) |
| หัววัด CO2 | **2.2 kΩ ×2** | คู่พูลอัพของช่อง 3 ถ้าบอร์ด breakout ยังไม่มีมาให้ |
| หัววัด CO2 | **แพดตัวต้านทานฮีตเตอร์ — DNP** | ราว 220 Ω คร่อมไฟ 3.3 V ของกิ่ง (~50 mW) **วางแพดไว้ ไม่ต้องใส่ของ** SCD41 มีความร้อนในตัวเพียงราว 1.5 mW จึงทำให้ตัวเองอยู่เหนือจุดน้ำค้างไม่ได้ จะต้องช่วยมันหรือไม่เป็นคำถามสำหรับล็อกของ SHT45 ดู *การควบแน่น* ใน §3 |
| หัววัด CO2 | **เชื่อม VDD กับ VDDH** | บังคับ ทั้งคู่มาจากรางเดียวกัน **และต้องเชื่อมใกล้ตัวเซนเซอร์** บอร์ด breakout ทำมาให้แล้ว บน LGA เปล่าพลาดง่าย |
| หัววัด CO2 (เฉพาะ LGA เปล่า) | **แพดลอย 21 จุด** | แพด DNC ทุกจุดต้องบัดกรีลงบนแพดที่ไม่ต่อไปไหน — ดู *การสร้างหัววัดจาก LGA เปล่า* ใน §3 |

---

## 5. ไฟเลี้ยง — โซลาร์ 24 V

**สิ่งนี้เข้ามาแทนแบตเตอรี่ทั้งหมดในปี 2026-08** โหนดรับไฟจาก **แบงก์แบตเตอรี่
24 V ที่อยู่หลังชาร์จคอนโทรลเลอร์** ไม่ใช่จากเซลล์โดยตรง และการเปลี่ยนนี้ส่งผล
ไกลกว่าสิ่งอื่นใดในรุ่นนั้น: มันคือสิ่งที่ทำให้ `battery_read_mv()` ใช้ไม่ได้อีกต่อไป
และเป็นเหตุผลที่ชิ้นส่วนหลัง J14 มีพิกัด 60 V แทนที่จะเป็นแค่ 5 mA ที่โหนดกินจริง

### สิ่งที่โหนดต้องทนได้

| พารามิเตอร์ | ค่า | เหตุผล |
|---|---|---|
| ค่าปกติ | 24 V | ตะกั่วกรด 12 V สองลูก หรือ LiFePO4 8S |
| ช่วงใช้งานจริง | **21–29 V** | คายประจุหมด → absorb/equalise |
| **ช่วงที่ออกแบบไว้** | **18–32 V ต่อเนื่อง** | เผื่อทั้งสองทาง |
| **พิกัดอุปกรณ์** | ภาคอินพุต (Q2, D9, C11) **≥60 V** เท่าเดิม; U7 **สูงสุด 36 V** | ตอนนี้โมดูลคือเพดาน คอนโทรลเลอร์เสีย แบตหลุด หรือ V_oc ของแผงตอนเช้าที่อากาศเย็น อาจดันแรงดันเกิน 29 V ไปมาก และ **ไม่มีอะไรบนบอร์ดนี้กันสิ่งนั้นได้** — ดู *สิ่งที่ภาคอินพุตไม่ได้คุ้มครองอีกต่อไป* ใน *โมดูล buck* |

ให้ใส่ **F1 (2 A หน่วงเวลา) → Q2 (P-FET กันกลับขั้ว) → D9 (SMBJ33A TVS) →
C11 (100 µF)** เรียงตาม **ลำดับการวางบนลายทองแดง** นี้จาก J14 — F1 กับ Q2
เป็นอุปกรณ์อนุกรม ส่วน D9 กับ C11 ต่อลงกราวด์แบบขนาน และหัวข้อ
*โหนด `24V_PROT`* ด้านล่างวาดให้เห็นว่ามันหมายความว่าอย่างไรจริง ๆ นี่คือสาย DC ที่ลากยาวเข้าอาคารโลหะ
ให้ปฏิบัติกับมันเหมือนสายกลางแจ้ง ไม่ใช่แหล่งจ่ายบนโต๊ะทดลอง

### Q2 — จงใจต่อ FET กลับด้าน

`Q2` เคยมีแค่หนึ่งแถวใน BOM กับหนึ่งกล่องในไดอะแกรม และมันมีวิธีต่อผิดอยู่สองแบบ
ที่ **ผ่านการทดสอบบนโต๊ะได้ทั้งคู่** หัวข้อนี้คือวงจรของมัน

**ตัวอุปกรณ์** Diodes Incorporated **DMP6023LE-13** มอสเฟตแบบ P-channel
enhancement mode ในแพ็กเกจ **SOT-223** (3 ขา + แท็บ) ตัวเลขที่สำคัญ:

| พารามิเตอร์ | ค่า | ความหมายกับดีไซน์นี้ |
|---|---|---|
| V_DS | **−60 V** | ผ่านกฎ ≥60 V ของ §5 มันต้องรับแรงดันแบงก์กลับขั้วเต็ม ๆ |
| **V_GS สูงสุด** | **±20 V** | **ตัวเลขที่กำหนดรูปร่างของวงจรทั้งหมด** — ดู *ทำไมซีเนอร์ถึงไม่ใช่ของเสริม* |
| R_DS(on) | **28 mΩ** ที่ V_GS = −10 V (35 mΩ ที่ −4.5 V) | แรงดันตก 2.8 mV ที่พีค 100 mA ของเรา |
| I_D | 7 A (T_a) / 18.2 A (T_c) | ราว 70 เท่าของพีคที่โหนดนี้กิน |
| V_GS(th) | ≤ **3 V** ที่ 250 µA | **ไม่ใช่** อุปกรณ์ระดับลอจิกแม้จะมี "LE" ในชื่อ — อย่าขับเกตด้วย 3.3 V |
| C_iss | ≈ **2.6 nF** | กำหนดความชันตอนเปิดร่วมกับตัวต้านทานเกต |
| P_D | 2 W (T_a) | เทียบกับที่สูญเสียจริงราว 0.3 mW |
| **แท็บ / ตัวถัง** | **เดรน (DRAIN)** | อยู่ที่อินพุต **ดิบ ยังไม่ผ่านการป้องกัน** มีผลต่อการวางลาย ดูด้านล่าง |

เหมือนกับ Q1 อุปกรณ์ตัวนี้ **เลือกจากพิกัดแรงดัน ไม่ใช่พิกัดกระแส**
โหนดนี้กิน **ต่ำกว่า 1 mA เฉลี่ย และราว 30 mA พีค** ที่ 24 V (กระแส 150 mA ของ
LoRa TX และ 205 mA ของ SCD41 ถูกสะท้อนผ่านโมดูล จึงมาถึงจุดนี้โดยหารด้วยราว
24/3.3) ทุกแกนของกระแสจึงเหลือเฟือเกินสองอันดับขนาด

#### วงจร

```
   J14 (+)
      │
   [ F1 ]   ฟิวส์หน่วงเวลา 2 A แบบหลอด
      │
      ●──── 24V_RAW             แท็บ (= เดรน) อยู่ที่ศักย์ไฟฟ้าจุดนี้
      │
      │ D
   ┌──┴───┐
   │  Q2  │  DMP6023LE       ไดโอดบอดี:  D ──►|── S   (ชี้ไปทาง "โหลด")
   └──┬───┘
      │ S                  G ──●
      │                        │
      ●──── 24V_PROT         ├──[ D10  12 V ]──── ไปที่ S  (แคโทดอยู่ที่ S)
      │                        │
      ├──► D9, C11, U7         └──[ R38  470 k ]─── GND
      │    (ต่อ "ขนาน" กันทั้งหมด — ดูหัวข้อถัดไป)
      │
   J14 (−) ─────────────────────────────────────── GND
```

อ่านเป็นรายการเน็ตอีกรอบ เพราะรูปข้างบนคือส่วนที่คนต่อผิดกันบ่อยที่สุด:

| ขั้ว | เน็ต | หมายเหตุ |
|---|---|---|
| **เดรน** (และแท็บ) | `24V_RAW` — ฝั่ง J14 หลัง F1 | ใช่ครับ **เดรนหันเข้าหาแหล่งจ่าย** |
| **ซอร์ส** | `24V_PROT` — ฝั่งโหลด ไปเลี้ยง D9/C11/U7 | |
| **เกต** | จุดต่อร่วมของ `R38` (ลง GND) กับแอโนดของ `D10` | |
| แคโทดของ `D10` | **ซอร์ส** คือ `24V_PROT` | ซีเนอร์คร่อมเกต-ซอร์ส วางชิดตัว FET |

> **หมายเลขขา:** มอสเฟต SOT-223 ของ Diodes โดยทั่วไปคือขา 1 = G, ขา 2 = D,
> ขา 3 = S และแท็บผูกกับ D ส่วน **แท็บ = เดรน** นั้นยืนยันจากหมายเหตุ
> case connection ในดาต้าชีตแล้ว แต่ **ให้ตรวจการไล่ขา 1/2/3 กับรูป
> "Pin Out — Top View" ในดาต้าชีตอีกครั้งก่อนยืนยันฟุตพรินต์**

#### ทำไมเดรนถึงหันเข้าหาแหล่งจ่าย

ไดโอดบอดีของมอสเฟต P-channel นำกระแสจาก **เดรน → ซอร์ส** ข้อเท็จจริงข้อเดียวนี้
เป็นตัวกำหนดทิศทางทั้งหมด และมันเป็นทิศ **ตรงข้าม** กับการต่ออุปกรณ์ตัวเดียวกัน
ในวงจร ideal-diode / ORing ซึ่งเป็นเหตุผลที่คนพลาดกันตรงนี้

- **ต่อถูกขั้ว** ไดโอดบอดีถูกไบอัสตรงทันทีที่จ่ายไฟ `24V_PROT` จึงขึ้นมาต่ำกว่า
  `24V_RAW` อยู่หนึ่งแรงดันตกคร่อมไดโอด จากนั้นเกตที่ถูก `R38` ดึงลง GND
  จะมีศักย์ต่ำกว่าซอร์สอย่างมาก ช่องนำกระแสจึงเปิด และแรงดันตก 0.7 V
  ยุบเหลือ 2.8 mV **ไดโอดทำหน้าที่สตาร์ต ช่องนำกระแสทำงานจริง**
- **ต่อกลับขั้ว** `24V_RAW` จะอยู่ *ต่ำกว่า* GND ส่วน `24V_PROT` ถูกโหลดดึงไว้ที่
  GND ไดโอดบอดีจึงถูกไบอัสกลับและบล็อก เกตอยู่ที่ GND ผ่าน `R38` และซอร์สก็อยู่ที่
  GND ดังนั้น **V_GS = 0** ช่องนำกระแสก็ปิดด้วย ไม่มีกระแสไหลที่ไหนเลย
  ไม่มีอะไรร้อน และ **F1 ไม่ขาด** — ต่อผิดขั้วแล้วไม่เสียอะไรนอกจากเวลาที่ใช้สังเกต

**ถ้าต่อกลับด้าน** — ซอร์สไปหาแหล่งจ่าย เดรนไปหาโหลด — มันจะยังทำงานได้ปกติดี
ทุกประการบนโต๊ะเมื่อต่อถูกขั้ว แต่พอต่อกลับขั้ว ไดโอดบอดีจะชี้จากโหนดโหลด
ย้อนกลับเข้าหาขั้วลบของแหล่งจ่าย กระแสจึงวิ่ง GND → โหลด → ไดโอดบอดี → แหล่งจ่าย
และ "วงจรป้องกัน" จะไม่ทำอะไรเลยนอกจากทำให้ F1 ขาดถ้าโชคดี และทำลาย buck
ถ้าโชคไม่ดี **ความผิดพลาดแบบนี้มองไม่เห็นจนถึงวันที่มันสำคัญ** นั่นคือเหตุผลที่
การทดสอบต่อกลับขั้วเป็นขั้นตอนที่มีเลขกำกับใน bring-up ไม่ใช่ของแถม

#### ทำไมซีเนอร์ถึงไม่ใช่ของเสริม

เมื่อดึงเกตลง GND และซอร์สอยู่ที่แรงดันแบงก์ จะได้ **V_GS = −V_bank** คือ
−24 V ที่ค่าปกติ และ **−32 V ที่ขอบบนของช่วงออกแบบ** เทียบกับพิกัดเกตสูงสุด
สัมบูรณ์ **±20 V** การใช้ตัวต้านทานเกตเปล่า ๆ จะทำลาย FET ตัวนี้ — ไม่ใช่ทันที
และไม่ใช่บนแหล่งจ่าย 12 V บนโต๊ะ แต่บนแบงก์ 24 V ตอนชาร์จช่วง absorb

`D10` แคลมป์ V_GS ไว้ที่ราว −12 V ส่วน `R38` คือตัวจำกัดกระแสซีเนอร์
ทั้งสองตัวจึงเป็นคู่กัน ขาดตัวใดตัวหนึ่งใช้ไม่ได้:

| ชิ้นส่วน | ค่า | ทำไมต้องค่านี้ |
|---|---|---|
| `R38` เกต → GND | **470 kΩ** | ตั้งกระแสซีเนอร์ที่ 26 µA ที่ 24 V และ 43 µA ที่ 32 V — คิดเป็น **0.6 mW หรือ 15 mWh/วัน** เทียบกับงบ 2500 mWh/วันของโหนด ถ้าใช้ 100 kΩ จะกิน 5 เท่าโดยไม่ได้อะไร ถ้าใช้ 1 MΩ จะเริ่มไวต่อสัญญาณรบกวนบนสายอินพุตกลางแจ้งที่ยาว |
| `D10` เกต → ซอร์ส | **12 V**, 250 mW (BZX84C12 แบบ SOT-23 หรือ MMSZ5242B แบบ SOD-123) | สูงกว่า −10 V ที่ใช้ระบุค่า R_DS(on) อย่างสบาย และต่ำกว่าขีด ±20 V อย่างสบายเช่นกัน **แคโทดไปที่ซอร์ส แอโนดไปที่เกต** |

> **ซีเนอร์ทำงานที่กระแสต่ำกว่าจุดทดสอบมาก และในที่นี้ไม่เป็นไร** ซีเนอร์ 12 V
> ที่ระบุค่าไว้ที่ 5 mA จะอยู่ราว 10–11 V เมื่อกระแสเพียง 26 µA ซึ่งยังสูงกว่า
> −10 V ที่ใช้ระบุค่า 28 mΩ จึงไม่เสียอะไร แต่หมายความว่า **ห้าม** เลือกตัว 16 V
> หรือ 18 V แล้วหวังว่าหัวเข่าที่นิ่มจะช่วยที่อินพุต 32 V — ให้อยู่ที่ 12 V

`R38` × `C_iss` = 470 kΩ × 2.6 nF ≈ **1.2 ms** เกตจึงค่อย ๆ ไต่ ไม่ได้กระชาก
นั่นเป็นผลพลอยได้เล็ก ๆ ต่อ EMI และต่อขั้นแรงดันที่อินพุตของโมดูล
แต่ให้อ่านกับดักเรื่องกระแสกระชากด้านล่างก่อนจะคิดว่ามันคือ soft-start — มันไม่ใช่

#### ทำไมลำดับต้องเป็น F1 → Q2 → D9 ไม่ใช่ F1 → D9 → Q2

ข้อนี้ตั้งใจ และเป็นเหตุผลที่ `D9` เป็น TVS แบบ **ทิศทางเดียว** (SMBJ33A) ได้
โดยไม่ต้องใช้แบบสองทิศทาง

ถ้าวาง TVS ไว้ **หน้า** FET การต่อกลับขั้วจะไบอัสตรงมันเต็ม ๆ คร่อมแบงก์
SMBJ นำกระแสได้หลายร้อยแอมป์ในทิศนั้น F1 จะขาดถ้าโชคดี และ TVS พังทั้งสองกรณี
ทุกครั้งที่มีคนเดาขั้วจากสายสองเส้นที่สีซีด แต่ถ้าวางไว้ **หลัง** FET อย่างในดีไซน์นี้
แรงดันกลับขั้วจะไปไม่ถึงมันเลย เพราะ `Q2` บล็อกก่อน TVS จึงเห็นแต่ทรานเซียนต์
ด้านบวกเท่านั้น ซึ่งเป็นสิ่งที่อุปกรณ์ทิศทางเดียวมีไว้ทำพอดี

ราคาที่ต้องจ่ายคือเดรนของ `Q2` ต้องเผชิญอินพุตที่ยังไม่ถูกแคลมป์อยู่ไม่กี่นาโนวินาที
ก่อน `D9` จะนำกระแส ซึ่งรอดได้ที่ระดับพลังงานนี้เพราะตอนนั้น FET **เปิดอยู่**:
เสิร์จวิ่งผ่านช่องนำกระแส `D9` แคลมป์ `24V_PROT` ไว้ที่ ≤53.3 V และ V_DS ของ
`Q2` เองอยู่ใกล้ศูนย์เทียบกับพิกัด −60 V ส่วน V_GS ถูก `D10` แคลมป์ไว้ตลอด

**อุปกรณ์แต่ละตัวมีไว้ทำอะไรกันแน่** เพราะอุปกรณ์ป้องกันสามตัวเรียงกัน
ชวนให้เข้าใจว่ามันทำงานทับซ้อนกัน:

- **F1** — กัน *การลัดวงจรฝั่งปลายน้ำ*: buck เสียแบบช็อต หรือ C11 เสียแบบช็อต
  มันไม่ได้ช่วยเรื่องต่อกลับขั้วเลย เพราะถ้า `Q2` ถูกต้อง จะไม่มีกระแสให้ฟิวส์ขาด
- **Q2** — ต่อกลับขั้ว และแค่นั้น
- **D9** — ทรานเซียนต์ด้านบวก: การสวิตช์ที่ชาร์จคอนโทรลเลอร์ ฟ้าผ่าใกล้เคียง
  และสาย DC ยาว ๆ ที่ทำตัวเป็นเสาอากาศ
- **C11** — เป็นบัลค์ และหน่วงการกำทอนระหว่างอินดักแตนซ์ของสายอินพุต
  กับคาปาซิเตอร์เซรามิกที่อินพุตของโมดูล

> **`Q2` ไม่ใช่ ideal diode และไม่ได้บล็อก *กระแส* ย้อนกลับ** เมื่อช่องนำกระแส
> เปิดแล้ว มันนำได้ทั้งสองทิศทาง ถ้าแรงดันแบงก์ตกลงต่ำกว่า `24V_PROT` เมื่อไร
> C11 จะคายประจุย้อนกลับเข้าไป ซึ่งไม่เป็นอันตรายที่ระดับพลังงานนี้ และเขียนไว้
> เพียงเพื่อไม่ให้ใครออกแบบบนสมมติฐานว่ามันเกิดขึ้นไม่ได้

#### กับดักสองข้อ

**1. กระแสกระชากตอนเสียบไฟวิ่งผ่านไดโอดบอดี ไม่ใช่ผ่านช่องนำกระแส — ดังนั้น
ความชันเกต 1.2 ms ไม่ใช่ soft-start** การต่อแบงก์ที่ชาร์จเต็มเข้ากับบอร์ดที่ยังไม่มีไฟ
จะอัดประจุราว 2.6 mC เข้า `C11` บวกกับคาปาซิเตอร์อินพุตในพื้นที่ของโมดูลอีก
ราว 44 µF ผ่านไดโอดบอดี โดยมีเพียงความต้านทานของสายเป็นตัวจำกัด ประเมิน I²t
ได้ราว 0.1 A²s **ให้ระบุ F1 ด้วยค่า I²t ไม่ใช่แค่แอมป์**: ฟิวส์หลอด 5×20 มม.
แบบ **T2A** มีระยะเผื่อเหลือเฟือ ขณะที่ฟิวส์ SMD 1206 แบบ "slow-blow" 2 A
บางเบอร์มีพิกัดราว 0.1 A²s และจะขาดโดยไม่มีเหตุตั้งแต่ตอนเสียบไฟ §4a ให้ทั้งสอง
ฟุตพรินต์ — **ให้เลือกแบบหลอด** ซึ่งเป็นแบบที่เปลี่ยนได้บนเสาด้วยไขควงอยู่แล้ว
ถ้าเพิ่มค่า `C11` ให้ตรวจพิกัดกระแสพัลส์ของไดโอดบอดีของ FET ควบคู่ไปกับฟิวส์ด้วย

**2. แท็บคือเดรน ซึ่งแปลว่ามันอยู่ที่ `24V_RAW` — อินพุตดิบที่ยังไม่ถูกป้องกัน
และยังไม่ถูกแคลมป์** มันเป็นผืนทองแดงที่ใหญ่ที่สุดบนตัวอุปกรณ์ และเป็นจุดที่ชวนให้
เทเพลนเพื่อระบายความร้อน **อย่าทำ** เหตุผลด้านความร้อนใช้ไม่ได้ที่นี่ (0.3 mW)
และทองแดงผืนนั้นอยู่ผิดฝั่งของทั้ง FET และ TVS ให้เทเพลนเดรนเท่าที่จำเป็น
เว้นระยะจากเพลน GND และจากตัวกล่องให้เหมาะกับอุปกรณ์ 60 V ที่ต่อกับสายกลางแจ้งยาว ๆ
แล้วเอาความพยายามเรื่องระบายความร้อนไปใช้ที่จุดที่ต้องการจริง ซึ่งไม่มีเลยบนบอร์ดนี้

### โหนด `24V_PROT` — D9, C11 และโมดูลต่อขนานกันทั้งหมด

**"F1 → Q2 → D9 → C11" หมายถึงลำดับการวางบนลายทองแดง ไม่ใช่การต่ออนุกรมทางไฟฟ้า**
และคำย่อนี้ทำให้เข้าใจผิดมาพอแล้ว จึงขอแทนที่ด้วยรูป มีเพียง **F1 กับ Q2 เท่านั้น
ที่เป็นอุปกรณ์อนุกรม** ทุกอย่างหลัง Q2 ห้อยอยู่บนโหนดเดียวกันหมด:

```
   ซอร์สของ Q2
       │
       ●━━━━━━┳━━━━━━━━┳━━━━━━━━━━━━┳━━━━━━━━━━┳━━━  24V_PROT
       │      │        │            │          │
            ══╪══     ═╪═         ══╪══     [R24 300k]
              │        │            │          │
            [D9]     [C11]       [C19]         ●──── VBAT_SENSE
           SMBJ33A   100 µF        22 µF       │      → PB3
          แคโทด ↑     + ↑         50 V     [R25 30k]
              │        │            │          │
              │        │        U7 V_in        │
              │        │        (TSR 1)        │
       ───────┴────────┴────────────┴──────────┴──── GND
              ↑        ↑            ↑
          ที่ J14   ถัดมาติดกัน  ≤5 มม. จาก
                                 ขาของ U7
```

อ่านเป็นรายการเน็ต เพราะขั้วคือจุดที่ทำให้โหนดนี้พัง:

| ชิ้นส่วน | ขั้ว | ต่อไปที่ |
|---|---|---|
| **D9** SMBJ33A | **แคโทด — ด้านที่มีแถบคาด** | `24V_PROT` |
| | แอโนด | `GND` ตรงกลับไปที่ขากราวด์ของ J14 |
| **C11** 100 µF ≥63 V | **`+`** | `24V_PROT` |
| | `−` | `GND` |
| **C19** 100 µF ≥63 V | **`+`** | `24V_PROT` ที่ **ขา 1 (+V_in) ของ U7** |
| | `−` | `GND` ที่ขา 2 ของ U7 |
| **U7** V_in (ขา 1) | — | `24V_PROT` |
| **R24** 300 kΩ | — | `24V_PROT` (ด้านบนของวงจรแบ่ง `VBAT_SENSE`) |
| **D10** ซีเนอร์ 12 V | **แคโทด — ด้านที่มีแถบคาด** | `24V_PROT` เพราะ **ซอร์สของ Q2 *คือ* โหนดนี้** |
| | แอโนด | **เกต** ของ Q2 ร่วมกับ R38 |

> **D10 ไม่เคยอยู่ในตารางนี้จนถึง 2026-09-09** และการที่มันหายไปควรบันทึกไว้
> มากกว่าจะแก้เงียบ ๆ มันถูกมองข้ามง่ายเพราะ D10 เป็นส่วนหนึ่งของเรื่อง *Q2* —
> มันคือ gate clamp และถูกอธิบายไว้ในหัวข้อ **Q2 — the reverse-polarity FET is
> wired backwards on purpose** จึงไม่เคยถูกลิสต์ในกลุ่มที่แขวนอยู่บนโหนดนี้
> แต่ P-FET ที่ต่อเดรนเข้าฝั่งไฟเข้า จะมี **ซอร์สอยู่ฝั่งโหลด** และฝั่งโหลดคือ
> `24V_PROT` แคโทดของ D10 จึงอยู่ตรงนี้ด้วย
>
> เรื่องนี้สำคัญเพราะตารางนี้ประกาศจุดประสงค์ตัวเองว่าเรื่องขั้ว และ **D10 ใส่กลับ
> เป็นอาการพังที่เอกสารบันทึกไว้แล้ว** (§1 ของ [`pcb-altium.md`](pcb-altium.md):
> แคโทดที่เกตแทนที่จะเป็นซอร์ส เปลี่ยน clamp 12 V ให้เหลือ 0.7 V แล้วบอร์ดดูเหมือนตาย)
> ตารางที่มีไว้จับความผิดพลาดนั้นโดยเฉพาะ กลับเป็นที่เดียวที่ไม่มีชิ้นส่วนนั้นอยู่
>
> **นับโหนดนี้: เจ็ดจุด** ซอร์ส Q2, แคโทด D10, แคโทด D9, `+` ของ C11, R24 และ —
> **เฉพาะบน `STM32WL_PT`** — เดรนของ Q3 กับ R41 ส่วนบน `STM32WL_FE` จะเป็นหกจุด
> คือไม่มี Q3 กับ R41 แต่มี C19 และขา 1 ของ U7 แทนที่จะไปอยู่บน `24V_PRE`
> เน็ตที่นับได้ไม่ตรงแปลว่ามีอะไรอยู่ผิดที่ และตรวจแบบนี้เร็วกว่าไล่อ่านรูป

**มีโมดูลตัวเดียวแตะโหนดนี้ และกฎการวางลายด้านล่างยังสำคัญอยู่** เมื่อมีคอนเวอร์เตอร์
ตัวเดียวก็ไม่มีประเด็นเรื่องรางไฟใช้อินพุตร่วมกัน — แต่กระแสเสิร์จของ D9 กับจุดแตะ
อนาล็อกอิมพีแดนซ์สูงของ R24 ใช้ทองแดงผืนนี้ร่วมกัน และนั่นคือสิ่งที่กฎเรื่องลำดับ
พูดถึงจริง ๆ (รุ่นก่อนมีโมดูลตัวที่สองแขวนอยู่ตรงนี้ข้าง U7; บอร์ดที่มีสองตัวไม่ใช่ดีไซน์นี้)

**`VBAT_SENSE` วัดที่จุดนี้ ไม่ได้วัดที่ `24V_RAW`** และนั่นเป็นความตั้งใจ:
วงจรแบ่งแรงดันจึงอยู่ในเขตที่ D9 แคลมป์และอยู่หลัง Q2 มันจึงไม่เคยเห็นทรานเซียนต์ดิบ
และจะอ่านได้ 0 V แทนที่จะเป็นแรงดันลบถ้ามีคนต่อไฟกลับขั้ว ส่วนความคลาดเคลื่อน
2.8 mV ที่ Q2 เพิ่มเข้ามานั้นต่ำกว่าค่าความคลาดเคลื่อนของตัววงจรแบ่งเองถึงสามอันดับ

#### ทำไมลำดับการวางยังสำคัญ ทั้งที่มันเป็นโหนดเดียวกัน

ทางไฟฟ้าอุปกรณ์เหล่านี้ขนานกัน แต่บนทองแดงไม่ใช่ และลำดับตามแนวลายคือ
ข้อกำหนดจริง ๆ ข้อหนึ่ง:

1. **D9 อยู่ใกล้ J14/Q2 ที่สุด** เสิร์จควรถูกทิ้งลงกราวด์ *ตั้งแต่ที่ประตู*
   เพื่อไม่ให้กระแสของมันวิ่งผ่านทองแดงส่วนที่เหลือของบอร์ด SMBJ33A ปล่อยกระแสได้
   ถึง **11.3 A** ขณะแคลมป์ (600 W ÷ 53.3 V) ถ้าวางมันไว้หลัง C11 ไป 40 มม.
   กระแสก้อนนั้นจะได้เที่ยวชมบอร์ดของคุณก่อน
2. **C11 อยู่ถัดมาทันที** เพื่อให้อิเล็กโทรไลต์อยู่ในเขตที่ถูกแคลมป์แล้ว
   ไม่ใช่เป็นสิ่งแรกที่ทรานเซียนต์เจอ
3. **`C_IN` ของโมดูลแต่ละตัวอยู่ห่างจากขา V_in/GND ของตัวเองไม่เกิน 5 มม.**
   C11 ทำหน้าที่นี้แทนไม่ได้ — ดูกฎการวางลายข้อ 1 ในหัวข้อ *โมดูล buck*
   และกฎด้านกลับก็ใช้ด้วย: โมดูลที่รับไฟผ่านลายยาวเกินไม่กี่เซนติเมตร หรือผ่านสาย
   ความยาวใด ๆ ต้องมีคาปาซิเตอร์บัลค์อยู่ต้นทาง — ซึ่งคือหน้าที่ของ C11
4. **R24/R25 อยู่ท้ายสุด** และห่างจากโมดูลทั้งสองมากที่สุด มันเป็นแหล่งสัญญาณ
   แอนะล็อกอิมพีแดนซ์ 27 kΩ ไม่มีธุระอะไรใกล้ทองแดงที่กำลังสวิตช์

**ความกว้างลายกำหนดโดยเสิร์จ ไม่ใช่โดยโหลด** กระแส DC ที่นี่พีคแค่ 100 mA
ซึ่งลายขนาดไหนก็รับได้ แต่พัลส์ 11.3 A ของ D9 และเส้นทางกลับของมันต้องการลายกว้าง
ดังนั้น **อย่าเดิน `24V_PROT` เป็นลายบาง ๆ แบบสัญญาณเพียงเพราะโหลดมันน้อย**
และ **ให้แอโนดของ D9 กับขั้ว `−` ของ C11 มีทองแดงกว้างของตัวเองกลับตรงไปที่
ขากราวด์ของ J14** โดยให้เส้นทางกลับนั้นอยู่ห่างจากกราวด์แอนะล็อกและห่างจาก R25
นี่คือโหนดเดียวบนบอร์ดนี้ที่ความคิดว่า "กราวด์ก็คือกราวด์" ใช้ไม่ได้

#### สามวิธีที่โหนดนี้ถูกสร้างผิด

**1. D9 ใส่กลับขั้ว** SMBJ33A เป็นแบบ **ทิศทางเดียว** ด้านที่มีแถบคาด (แคโทด)
ไปที่ `24V_PROT` ด้านที่ไม่มีแถบไปที่ GND ถ้าใส่กลับด้าน มันก็คือไดโอดธรรมดา
ที่ไบอัสตรงคร่อมรางไฟ 24 V ของคุณ — F1 ขาดทันทีถ้าโชคดี และ TVS ตายทั้งสองกรณี
**Q2 ช่วยไม่ได้** เพราะ D9 อยู่ปลายน้ำของมัน

**2. C11 ใส่กลับขั้ว** มันเป็นคาปาซิเตอร์มีขั้ว: `+` ไปที่ `24V_PROT`
อิเล็กโทรไลต์ 100 µF ที่ใส่กลับด้านบนรางไฟ 24 V จะระเบิดออก หมายเหตุเดียวกับข้อบน:
เมื่ออยู่ปลายน้ำของ Q2 แล้ว FET กันกลับขั้วไม่ได้ป้องกันอะไรเลยสำหรับอุปกรณ์
ที่ใส่กลับด้าน *บนบอร์ด* — Q2 กันเฉพาะ *แหล่งจ่าย* ที่ต่อกลับขั้ว แค่นั้น

**3. เลือกโพลิเมอร์ ESR ต่ำให้ C11 เพราะคิดว่า ESR ต่ำย่อมดีกว่า** ที่นี่ไม่ดีกว่า
อินดักแตนซ์ของสายอินพุต (~5 µH สำหรับระยะ 5 ม.) กำทอนกับคาปาซิเตอร์เซรามิก
ราว 44 µF ที่อินพุตของโมดูลที่ราว **11 kHz** และการต่อแบงก์ที่ชาร์จเต็มเข้าไป
จะกระตุ้นการแกว่งนั้น ความต้านทานของสายเพียงอย่างเดียว (~0.2 Ω สำหรับสาย 18 AWG
ยาว 5 ม. ไป-กลับ) ก็ให้การหน่วงส่วนใหญ่แล้ว และ D9 ยังรองรับ
ส่วนที่เหลือ — จึงเป็นเรื่องระยะเผื่อ ไม่ใช่วิกฤต แต่ **หน้าที่ของ C11 ที่นี่คือ
การหน่วง ไม่ใช่การรับกระแสริปเปิล** (เซรามิกในพื้นที่รับริปเปิล 500 kHz ไปแล้ว)
ค่า ESR ของมันจึงเป็นข้อดี **ให้เลือกอะลูมิเนียมอิเล็กโทรไลต์มากกว่าโพลิเมอร์**
และให้อ่านข้อกำหนด "≥63 V" ว่าครอบคลุมทั้งแรงดันแคลมป์ 53.3 V ของ D9 *และ*
การแกว่งนี้ด้วย

### รางไฟเดียว และทำไมรางที่สองจึงหายไป

```
  24 V ──[F1]──[Q2 rev]──[D9 TVS]──┬──[U7 TSR1-2433]── 3.3 V ──┬── CN6 ─> Nucleo CN6-4
                                   │                           │
                                   │                           └──[Q1 gate]── VSENS
                                   │                               (โพรบ, SHT45,
                                   │                                mux, SCD41)
                                   └──[R24/R25]── VBAT_SENSE ─> PB3 (ADC1_IN2)
```

**ทุกโหลดบนบอร์ดนี้ใช้ไฟ 3.3 V บอร์ดจึงสร้าง 3.3 V และไม่สร้างอะไรอีก** นั่นคือ
สถาปัตยกรรมไฟเลี้ยงทั้งหมด รางที่สองเคยมีอยู่จนถึงรุ่น 2.0 เพียงเพราะเซนเซอร์ CO2
ในตอนนั้นต้องการ 4.5–5.25 V ส่วนชิ้นส่วนใน BOM ปัจจุบันไม่มีตัวไหนต้องการ

รุ่นก่อนยังโต้แย้งว่าการมีรางแยกช่วยป้องกันวิทยุจากกิ่ง CO2 ที่เสีย ข้อโต้แย้งนั้น
ไม่รอดการเปลี่ยนแปลงครั้งนี้ และควรบอกว่าทำไม แทนที่จะปล่อยให้มันหายไปเงียบ ๆ:

- **กระแสตอนผิดพลาดเล็กลงสิบเท่า** กิ่ง CO2 ที่ช็อตเป็นโหลด 205 mA และ TSR 1-2433
  จำกัดกระแสที่ 250 % ของ 1 A แล้วกู้คืนเอง
- **ความเสี่ยงนี้ไม่เคยเป็นของ CO2 เท่านั้น** กิ่ง SHT45 สามเส้น แต่ละเส้นเป็นสาย
  ไม่มีชีลด์ 5 ม. ในอาคารเดียวกัน อยู่บนราง 3.3 V มาตลอด กิ่งที่สี่แบบเดียวกัน
  จึงไม่ใช่ความเสี่ยงชนิดใหม่
- **กู้คืนด้วยเกตได้** ทุกอย่างบน `VSENS` ถูกเฟิร์มแวร์ตัดไฟแล้วจ่ายใหม่ได้
  รางที่เกตเอื้อมไม่ถึงต่างหากคือกรณีที่ต้องเดินทางไปหน้างาน และดีไซน์นี้ไม่มีแล้ว

> **เอาต์พุตของ U7 ต้องไม่เกิน 3.6 V เด็ดขาด** CN6-4 มีพิกัด **3.0–3.6 V**
> (UM2592 ตาราง 9) และพิกัดสูงสุดสัมบูรณ์ของ VDD บน STM32WL คือ 3.6 V
> ให้ใช้อุปกรณ์แบบค่าคงที่ 3.3 V ไม่ใช่แบบปรับได้ที่มีโพเทนชิโอมิเตอร์ให้ใครมาหมุน

### โมดูล buck — U7

โมดูลสำเร็จรูป **Traco TSR 1** ตัวเดียวจ่ายไฟให้ทั้งบอร์ด (กว่าจะมาถึงจุดนี้ผ่านมา
สองรุ่น: รุ่น 1.0 เปลี่ยนคอนเวอร์เตอร์ LM5164 แบบ discrete คู่หนึ่งเป็นโมดูลคู่หนึ่ง
และรุ่น 2.0 ตัดหนึ่งในคู่นั้นทิ้ง)

| | **U7** |
|---|---|
| ชิ้นส่วน | Traco **TSR 1-2433** |
| เอาต์พุต | **3.3 V ±2 %** (3.23–3.37 V) |
| ช่วงอินพุต | 4.75–36 V |
| กระแสเอาต์พุต | 1 A |
| โหลดที่นี่ | MCU + วิทยุ (พีค ~150 mA) และทั้งหมดของ `VSENS` (SCD41 พีค 205 mA, โพรบ ~9 mA) — **ไม่เคยพร้อมกัน** ดูด้านล่าง |
| กันลัดวงจร | ต่อเนื่อง กู้คืนอัตโนมัติ จำกัดกระแสที่ **250 %** ของ I_out (typ) |
| กันความร้อนเกิน | 150 °C ภายใน กู้คืนอัตโนมัติ |
| กระแสอินพุตตอนไม่มีโหลด | **1 mA typ** |
| ริปเปิลเอาต์พุต | 50 mV_pp typ (BW 20 MHz) |
| ความถี่สวิตชิ่ง | 500 kHz typ (400–600) |
| โหลดคาปาซิทีฟสูงสุด | 470 µF |
| แพ็กเกจ | SIP-3 เสียบรู ลำดับขาแบบ 78xx, 11.7 × 7.5 × 10.1 มม. |
| อุณหภูมิใช้งาน | −40…+85 °C |
| ราคา / แหล่งซื้อ (2026-09-02) | ฿206.49 Digi-Key TH |

**โหลดใหญ่สองตัวไม่เคยเกิดพร้อมกัน และนั่นเป็นเรื่องของการออกแบบ** `main.cpp`
ปิดเกต — ซึ่งเอา SCD41 กับโพรบออกจากรางไฟทั้งหมด — *ก่อน* ที่วิทยุจะได้รับไฟ
เพื่อส่งข้อมูล โมดูลจึงเห็น ~205 mA ตอนวัด และ ~150 mA ตอนส่ง ไม่ใช่ 355 mA
ตัว 1 A มีที่เหลือทั้งสองทางอยู่แล้ว แต่ลำดับนี้เป็นสิ่งที่รับน้ำหนักไว้จริง
และ §7 ทดสอบมัน

**กรณีแย่สุดของ U7 คือ 3.37 V ต่ำกว่าเพดาน 3.6 V ของ CN6-4 และ STM32WL**
นั่นคือเหตุผลที่ต้องเป็นตัวเอาต์พุตคงที่ ไม่ใช่โมดูลปรับค่าได้: ตัวเลขที่ปกป้อง MCU
คือการทริมจากโรงงาน ไม่ใช่สิ่งที่โพเทนชิโอมิเตอร์หมุนไปถึงได้

#### ขา

สามขาตามลำดับ 78xx ยืนยันจากดาต้าชีต TSR 1 (rev. 2026-07-02 ตาราง *Pinout*)
Traco เพิ่มคำสั่งการวางลายของตัวเองอีกหนึ่งข้อ: *"หลีกเลี่ยงการเดินลาย PCB
ใต้คอนเวอร์เตอร์"*

| ขา | ชื่อ | ต่อไปที่ |
|---|---|---|
| 1 | `+V_in` | `24V_PROT` **`C_IN` = C19, 100 µF / 63 V คร่อมขา 1 กับ 2** — 22 µF ของ Traco เป็นค่าต่ำสุด ดูหัวข้อ *ตัวเก็บประจุ* |
| 2 | `GND` | กราวด์เพลน พร้อมทองแดงกว้างของตัวเองกลับไปทางขากราวด์ของ J14 |
| 3 | `+V_out` | รางไฟ 3.3 V: C21, CN6 และซอร์สของ Q1 |

ไม่มีขา enable ไม่มี power-good ไม่มี feedback — ไม่มีอะไรต้องจูน ไม่มีอะไรต้อง
ส่องสโคป และไม่มีวงจรริปเปิลของ COT ให้ทำผิด นั่นคือจุดประสงค์ของรุ่น 1.0
และมันยังเป็นจริงอยู่

```
                        ┌───────────────┐
   24V_PROT ────┬───────┤1 +Vin  +Vout 3├───────┬─────────── 3.3 V
                │       │               │       │
            [ C_IN ]    │  TSR 1-2433   │   [ C_OUT ]
         100 µF/63 V   │      U7       │  22 µF/16 V
                │       │    2 GND      │       │
               GND      └───────┬───────┘      GND
                               GND
```

#### ตัวเก็บประจุ

- **`C19` — 100 µF / ≥63 V ชิ้นเดียวกับ C11 (UVR1J101MPD)** ดาต้าชีต Traco กำหนด
  *"ต้องมีคาปาซิเตอร์อินพุตภายนอก 22 µF / 50 V เมื่อแรงดันอินพุตสูงกว่า 32 VDC"* —
  22 µF คือค่า**ต่ำสุด** และ C19 อยู่บนโหนด `24V_PROT` ที่ต้อง 63 V อยู่แล้ว ส่วน X7R
  1210 ที่ไบอัส 24–29 V เหลือความจุไม่ถึงครึ่ง จึงใช้อิเล็กโทรไลต์ตัวเดียวกับ C11
  **มันมีขั้ว ต่อกลับด้านจะระเบิด**

  > **ของที่ประกอบจริง C19 ห่างขา 1–2 ของ U7 อยู่ 6.9 มม. ไม่ใช่ ≤5 มม.** นั่นคือ
  > ขีดจำกัดทางกายภาพ — กระป๋อง φ8 มม. ข้างตัวถัง SIP-3 กว้าง 11.5 มม. เข้าใกล้กว่านี้
  > ไม่ได้ **ยอมรับได้** เพราะตัวเลข 5 มม. ของ Traco เขียนไว้สำหรับเลย์เอาต์ที่ไม่รู้ว่า
  > ทางไหลกลับเป็นอย่างไร ส่วนบอร์ดนี้มี **เพลนกราวด์ทึบที่ไม่ถูกเฉือนเลยอยู่ใต้ลาย
  > กว้าง 1.0 มม. พอดี** ลูปจึงเป็นลายต่อเพลนห่างกันแค่ FR4 หนา 1.6 มม. ระยะที่เกินมา
  > 2 มม. คิดเป็นราว 0.8 nH เทียบกับริปเปิลของ U7 เองที่ 75 mV p-p **พิสูจน์ตอน
  > bring-up:** จับสโคปที่ขา 1–2 ของ U7 ควรได้ราว 75 mV p-p และถือว่า **เกิน
  > 150 mV p-p** คือลูปอินพุตมีปัญหาจริง ส่วนเกณฑ์ ≤30 mV ที่หัว SCD41 (§7) เข้มกว่า
  > และจะจับได้ก่อน ถ้าวันหนึ่งต้องแก้จริง **อย่าย้าย C19** ให้เพิ่ม 22 µF/50 V X7R
  > 1210 สองถึงสามตัวขนานกัน ติด**ใต้บอร์ด**ตรงขา 1–2 พอดี ชั้นนั้นว่างทั้งแผ่นและ
  > 1210 หนาแค่ 1.4 มม.
- **`C21` — 22 µF / 16 V เป็นทางเลือก** โมดูลมีการชดเชยภายในและไม่ต้องการคาปาซิเตอร์
  เอาต์พุต ใส่ไว้เพราะถูกและช่วยลดขอบของ step กระแส LoRa TX และ SCD41 จะ DNP ก็ได้
- **`C11` — อิเล็กโทรไลต์ 100 µF / ≥63 V คงไว้ และคงพิกัดแรงดันไว้ด้วย** มันนั่งอยู่
  ฝั่งที่ถูกแคลมป์ของ D9 ซึ่งขึ้นถึง 53.3 V ระหว่างเสิร์จ การที่โมดูลเป็นตัว 36 V
  ไม่ได้ลดสิ่งที่ C11 ต้องเจอ
- **ไม่มีคาปาซิเตอร์บัลค์บนบอร์ดสำหรับเซนเซอร์ CO2 และนั่นเป็นความตั้งใจ**
  แหล่งสำรองของมันคือ **100 µF ที่หัววัด** — อยู่อีกฝั่งของสาย ซึ่งเป็นฝั่งเดียวที่
  กันกระแสพุ่ง 205 mA ไม่ให้ออกมาบนสายได้จริง (§3 *ปัญหา 205 mA*) รุ่นก่อนมี `C15`
  ทำหน้าที่เดียวกันอยู่ตรงนี้ และมันอยู่ผิดปลายของสาย 5 ม.

#### การวางลาย — สี่กฎ

1. **`C_IN` คร่อมขา 1 กับ 2 ภายใน 5 มม.** ลูปสวิตชิ่งอยู่ในโมดูล แต่ดีคัปปลิ้งอินพุต
   บนตัวโมดูลมีน้อย และกระแสริปเปิลอินพุต 500 kHz ยังต้องมาจากที่ใกล้ ๆ อยู่ดี
2. **โมดูลอยู่มุมเดียวกับอินพุต 24 V ห่างจาก J1–J12** สาย 1-Wire แบบ bit-bang หกเส้น
   กิ่ง I2C 5 ม. ไม่มีชีลด์สี่เส้น วงจรแบ่ง ADC 27 kΩ และวิทยุ 923 MHz อยู่บนบอร์ดนี้ทั้งหมด
3. **พาขา 2 ลงกราวด์เพลนด้วยเส้นทางที่สั้นที่สุด และกันจุดอ้างอิงอนาล็อกออกจากทางของมัน**
   มันเป็นขากราวด์ขาเดียวที่โมดูลมี บนบอร์ดสองชั้นที่ชั้นล่างเป็น `GND` ทึบ —
   ซึ่งคือสิ่งที่ §6.3 ของ `pcb-altium.md` กำหนด — แปลว่า **วาง via ติดแพดเลย**
   ไม่ใช่เดินรางยาว เพราะเพลนเป็นทางกลับที่ดีกว่ารางใด ๆ ที่วาดได้อยู่แล้ว
   และอิมพีแดนซ์ที่เหลือคืออิมพีแดนซ์ของ via เอง สิ่งเดียวที่มีผลจึงคือความสั้น

   > **กฎข้อนี้เคยเขียนว่า "ให้ขา 2 มีเส้นกลับ GND กว้างของตัวเองไปที่ J14"
   > ซึ่งเขียนขึ้นสำหรับบอร์ดที่เดินกราวด์เป็นราง** ถ้าทำตามตัวอักษรบนบอร์ดนี้
   > จะได้รางกว้าง 1 มม. ยาว 73 มม. พาดกลางบอร์ด ขนานอยู่กับเพลนที่รับกระแสนั้น
   > อยู่แล้ว และไปกีดขวางแถบที่เป็นที่อยู่ของภาค 24 V กับเกตราง
   > ถ้อยคำเปลี่ยนเมื่อ 2026-09 แต่เจตนาไม่เปลี่ยน

   ส่วนที่ยังกัดอยู่คือครึ่งหลัง: **อย่าให้กระแสกลับของสวิตเชอร์ใช้เส้นทางร่วมกับ
   จุดอ้างอิงอนาล็อก** บนเพลนกระแสกระจายตัว แต่มันหนาแน่นที่สุดบนเส้นตรงระหว่าง
   ขา 2 กับจุดที่ไฟเข้า — ให้วาง via กราวด์ของ **R25 กับ C10 นอกเส้นนั้น**
   คืออยู่ฝั่งตรงข้ามของ U7 ไม่ใช่อยู่ระหว่าง U7 กับ J14
4. **ไม่เดินอะไรใต้โมดูล** — คำสั่งของ Traco เอง ตัวโมดูลลอยเหนือบอร์ด 0.5 มม.
   ให้พื้นที่ footprint นั้นปลอดทองแดงบนชั้นบน

#### สิ่งที่ภาคอินพุตไม่ได้คุ้มครองอีกต่อไป

รุ่น LM5164 กำหนด **≥60 V** ให้ทุกชิ้นหลัง F1 เพราะ *"คอนโทรลเลอร์เสีย แบตหลุด
หรือ V_oc ของแผงตอนเช้าที่อากาศเย็น อาจดันแรงดันเกิน 29 V ไปมาก"* สิ่งนั้นยังจริง
และโมดูลเป็นตัว **36 V** จึงต้องพูดให้ชัดว่า F1/Q2/D9/C11 ทำและไม่ทำอะไรให้มัน:

- **D9 (SMBJ33A) รับ *พลังงาน* เสิร์จ ไม่ใช่กันแรงดันเกิน** มัน standoff ที่ 33 V และ
  แคลมป์ได้สูงถึง **53.3 V** ขณะทำงาน — สูงกว่าพิกัดของโมดูล ไม่มี TVS ตัวไหนที่ยังปิด
  อยู่ที่ 32 V แล้วแคลมป์ต่ำกว่า ~45 V ได้ นั่นคือฟิสิกส์ของ TVS ไม่ใช่การเลือกเบอร์ผิด
  D9 กันทรานเซียนต์ไม่ให้ทำลายบอร์ด แต่ไม่ได้รักษาโมดูลให้อยู่ในพิกัดระหว่างนั้น
  ดาต้าชีตไม่ระบุพิกัดสูงสุดสัมบูรณ์ใด ๆ นอกจากขีดใช้งาน 36 V ให้ถือ 36 V เป็นเพดาน
- **ชาร์จคอนโทรลเลอร์ที่เสียแล้วปล่อย V_oc ของแผง (~44 V สำหรับแผง "24 V") ผ่านมา
  จะฆ่าโมดูล** ไม่มีอะไรแบบ passive บนบอร์ดนี้กันได้ และการเพิ่ม OVP disconnect
  แบบ active ก็คือการเอาวงจรชนิดที่รุ่น 1.0 ตั้งใจถอดออกกลับเข้ามา
  **นี่คือข้อจำกัดที่รู้อยู่แล้ว** ทางบรรเทาเป็นเรื่องขั้นตอนและฟรี: ก่อนที่บอร์ดจะถูก
  ต่อเข้าระบบจริงครั้งแรก ให้วัด V_oc ของแผงและยืนยันว่าคอนโทรลเลอร์ไม่ปล่อยมันผ่านมา
  ตอนถอดแบต (§7 *ก่อนขั้นตอนที่ 1*)
- **ทุกอย่างอื่นที่ภาคนี้ทำยังเหมือนเดิม:** F1 กำหนดด้วย I²t สำหรับกระแสกระชากตอน
  เสียบไฟ, Q2 กันกลับขั้ว, C11 หน่วงการกำทอนของสาย

#### กับดักสองข้อเฉพาะของโมดูลนี้

**1. อย่าเอาโมดูล 28 V มาแทน** DFRobot DFR0570/0571, MP1584 และบอร์ด LM2596
ล้วนมีพิกัดอินพุตสูงสุด 28 V แบงก์ตะกั่วกรด 24 V อยู่ที่ **28.8 V ตอน absorb**
แบงก์ LiFePO4 8S เต็มที่ **29.2 V** นั่นไม่ใช่กรณีขัดข้อง แต่คือทุกบ่ายที่แดดดี
ความล้มเหลวมาช้า: โมดูลรอด 24.0 V บนโต๊ะ แล้วตายครั้งแรกที่แบงก์ขึ้นถึง absorb

**2. ลำดับขาคือ 78xx — 1 = +V_in, 2 = GND, 3 = +V_out — ยืนยันแล้ว แต่ก็ยังต้องวัด
footprint ก่อนบัดกรีโมดูลอยู่ดี** footprint ที่กลับด้านจะเอา 24 V ไปวางที่ขาเอาต์พุต
และ Nucleo อยู่ปลายน้ำของมัน

### ส่ง 3.3 V ลงสาย CO2 และขนาดสายเป็นส่วนหนึ่งของสเปก

กิ่ง CO2 พาไฟ 3.3 V เดียวกับกิ่ง SHT45 ทั้งสาม และเหมือนกันทางไฟฟ้าทุกประการ —
โดยมีข้อยกเว้นข้อเดียวที่ควรเขียนไว้หนึ่งย่อหน้า เพราะมันเป็นที่เดียวบนบอร์ดนี้
ที่ขนาดสายเป็นข้อกำหนด ไม่ใช่ความชอบ

**SCD41 กิน 175 mA typ / 205 mA max เป็นช่วงพุ่ง** บนระยะ 5 ม.:

| ขนาดสาย | Ω/กม. | R ไป-กลับ ที่ 5 ม. | ตกที่ 205 mA | VDD ที่หัววัด |
|---|---|---|---|---|
| 24 AWG (แบบที่ใช้กับ SHT45) | 84.22 | 0.84 Ω | 173 mV | 3.06 V |
| **22 AWG — ที่ระบุ** | **52.96** | **0.53 Ω** | **109 mV** | **3.12 V** |
| 20 AWG | 33.31 | 0.33 Ω | 68 mV | 3.16 V |

(VDD ที่หัววัดคำนวณจากกรณีแย่สุด ±2 % ของ U7 คือ 3.23 V ลบด้วยแรงดันตก)

ทั้งสามค่าผ่านค่าต่ำสุด **2.4 V** ของ SCD41 อย่างเหลือเฟือ เรื่องนี้จึงไม่ใช่เรื่อง
เซนเซอร์ไฟตก แต่เป็นเรื่องคำขอในดาต้าชีตที่ว่าแรงดันไฟเลี้ยง *"ต้องไม่แกว่งเกิน
30 mV (เช่น ริปเปิลหรือแรงดันตกที่เกิดจากโหลดอื่น)"* และคำแนะนำให้มี LDO เฉพาะตัว

**ไม่มี LDO และข้อกำหนด 30 mV ก็ยังผ่าน — ที่ตัวเซนเซอร์ ซึ่งเป็นจุดที่ดาต้าชีต
ระบุไว้จริง ๆ** U7 ให้ริปเปิล 75 mV p-p และสายกับคาปาซิเตอร์ที่หัววัดซึ่งคั่นอยู่
ระหว่างมันกับ SCD41 ลดทอนเหลือราว 2 mV การคำนวณ สมมติฐานที่มันตั้งอยู่ และ
ขั้นตอนตรวจตอน bring-up อยู่ใน §3 หัวข้อ *คำถามเรื่อง 30 mV* อย่าคำนวณซ้ำที่นี่
สิ่งที่ §5 ต้องให้กับข้อโต้แย้งนั้นคือขนาดสาย: **22 AWG รับภาระสองอย่างพร้อมกัน**
— ความต้านทานต่ำเพื่อแรงดันตกข้างบน และความต้านทานที่มากพอจะหน่วง LC ของฟิลเตอร์

**ทำไมไม่ส่งแรงดันที่สูงกว่าแล้วเรกูเลตที่หัววัด?** เพราะมันจะเอาเรกูเลเตอร์ตัวที่สอง
กลับขึ้นบอร์ด พร้อมคาปาซิเตอร์ของมันและครึ่งหนึ่งของกระแสว่างทั้งโหนด เพื่อแก้ปัญหา
109 mV ที่สายหนาขึ้นแก้ได้อยู่แล้ว คำตอบตามตำราถูกต้องเมื่อเซนเซอร์ต้องการแรงดันที่
บอร์ดไม่ได้สร้าง ตัวนี้ไม่ต้องการ

### งบพลังงาน และเหตุผลที่มันเลิกน่าสนใจจริง ๆ เสียที

| โหลด | กระแส | ต่อวัน |
|---|---|---|
| **กระแสอินพุตตอนไม่มีโหลดของ U7** | 1 mA typ × 24 V = 24 mW | **0.58 Wh** |
| MCU + LoRa + โพรบ + SHT45 | เฉลี่ย ~1 mA @ 3.3 V | <0.1 Wh |
| การสูญเสียในการแปลงของโมดูล | | ~0.1 Wh |
| **SCD41** — power-cycled single shot 96 ครั้ง | 154 mC ต่อ shot ที่ใช้ได้จริง @ 3.3 V | **0.0136 Wh** |
| TCA9548A ตอน standby | 0.1 µA typ | ~0 |
| ST-LINK **ถ้า** จ่ายไฟให้ | ~5 mA @ 3.3 V | ~0.4 Wh |
| **รวม** | | **≈0.8 Wh/วัน** |

เทียบกับราว 80 Wh/วันจากแผง 20 W ที่แดดเต็ม 4 ชั่วโมง ทั้งโหนดคิดเป็น **ราว 1 %**
ของพลังงานที่ผลิตได้ การแบกข้ามคืนคือ 12 ชม. × ~33 mW ประมาณ **0.4 Wh**
สามวันที่ฟ้าปิดราว 2.4 Wh เทียบกับ 480 Wh ของแบงก์ 24 V 20 Ah

**ให้ดูรูปร่างของตาราง ไม่ใช่แค่ยอดรวม** **72 % ของงบเป็นเรกูเลเตอร์ที่ไม่ได้ทำอะไรเลย**
และเซนเซอร์ CO2 — ชิ้นส่วนที่ครอบงำทุกรุ่นก่อนหน้าด้วย 2.16 Wh/วัน — คิดเป็น **3 %**
ไม่มีโหลดใดเหลืออยู่ที่คุ้มค่ากับการไปปรับแต่ง: ลดเซนเซอร์ลงครึ่งหนึ่งได้กลับมา
0.012 Wh/วัน เทียบกับแผงที่ผลิตได้แปดสิบ วัตต์-ชั่วโมงถัดไปถ้าจะใช้ ควรใช้กับฮีตเตอร์
ที่หัววัด (§3 *การควบแน่น*) ซึ่งทำให้รวมเป็น ~2.0 Wh/วัน และยังน้อยกว่าที่บอร์ดนี้
เคยกินก่อนลบราง 5 V ทิ้ง

### กับดักสามข้อ

**1. `battery_read_mv()` ใช้ไม่ได้แล้ว และทางแก้คือวงจรแบ่งแรงดัน** VREFINT วัด
VDDA ซึ่งตอนนี้คือเอาต์พุต 3.3 V ที่เรกูเลตแล้วของ U7 — ตัวเลขที่เท่าเดิมไม่ว่า
แบงก์จะเต็มหรือใกล้หมด §2 ทำนายเรื่องนี้ไว้แล้ว: *"ถ้าใส่เรกูเลเตอร์ระหว่าง
แบตเตอรี่กับ MCU มันจะเริ่มรายงานเอาต์พุตของเรกูเลเตอร์แทน"* สิ่งที่มาแทนคือ
**R24/R25 (300 kΩ / 30 kΩ อัตราส่วน 11:1) → PB3 (ADC1_IN2)** ให้ 2.9 V ที่แบงก์
32 V ส่วน C10 ที่คร่อม R25 ทำให้แหล่งจ่ายมีอิมพีแดนซ์ต่ำ ณ จังหวะสุ่มสัญญาณ
เพราะ 300 k ขนาน 30 k เท่ากับ 27 kΩ ซึ่งต้องใช้เวลาสุ่มสัญญาณ ADC ที่ยาว

> **VREFINT ยังจำเป็นอยู่ แต่ทำหน้าที่ใหม่** ให้อ่านมันเพื่อหา VDDA *จริง*
> แล้วค่อยสเกลค่าที่อ่านจากวงจรแบ่งเทียบกับค่านั้น มิฉะนั้นความคลาดเคลื่อน 3 %
> 2 % ของโมดูลจะกลายเป็นความคลาดเคลื่อน 2 % ของทุกค่าแรงดันแบงก์ที่รายงานออกไป
> เฟิร์มแวร์ยังคงอ่าน VREFINT และเพิ่มช่องที่สองเข้ามา ไม่ได้ตัดของเดิมทิ้ง

**2. ST-LINK ไม่ได้รับไฟ ดังนั้น VCP ตายไปด้วย** การจ่ายไฟ 3V3 ตรงเข้าที่ CN6-4
ทำให้ภาคดีบักไม่ได้รับไฟ — UM2592: *"ฟีเจอร์โปรแกรมและดีบักใช้ไม่ได้ เพราะ
ST-LINK ไม่ได้รับไฟ"* บนแบตเตอรี่นั่นเป็นการแลกที่ถูกต้อง บนโซลาร์ตอนนี้จ่ายไฟให้
มันได้แล้ว (~0.4 Wh/วัน) แต่ต้องตั้งจัมเปอร์ 5V/E5V ให้ถูก ดีไซน์นี้จึงเลือกเดิน
**USART1 (PB6/PB7) ออกไปที่ J13** แล้วต่อ USB-serial adapter แทน ใช้ได้ตลอด
ไม่ต้องพึ่งจัมเปอร์ ไม่ต้องพึ่ง ST-LINK ให้หักภาค ST-LINK ออกหรือปล่อยให้มันดับไว้

**3. Low-voltage disconnect ของชาร์จคอนโทรลเลอร์อาจตัดไฟคุณ** คอนโทรลเลอร์ส่วนใหญ่
มีขั้ว LOAD ที่จะตัดการเชื่อมต่อราว 11.5 V/เซลล์เพื่อป้องกันแบงก์ โหนดที่ต่ออยู่กับ
ขั้วนั้นจะเงียบไปพอดีตอนที่คุณอยากได้ข้อมูลเกี่ยวกับระบบโซลาร์ที่กำลังมีปัญหาที่สุด
**ให้ต่อกับขั้วแบตเตอรี่โดยตรง** โดยใช้ F1/Q2/D9 เป็นวงจรป้องกันของคุณเอง —
และยอมรับว่าโหนดต้องรับผิดชอบไม่ให้แบงก์หมด ซึ่งที่ ~0.8 Wh/วัน มันไม่ทำแน่นอน:
แบงก์ 20 Ah อยู่ได้เกินหนึ่งปีที่ไม่มีแดด รุ่น LM5164 เคยมี UVLO 15 V เป็น backstop
สุดท้ายใต้จุดนี้ ส่วน TSR 1 ไม่มีและทำงานลงถึง 6.5 V ดังนั้นตอนนี้โหนดจะรายงานได้จน
แบงก์ตายจริง — ซึ่งสำหรับโหนดที่หน้าที่หนึ่งคือวัดแบงก์ นั่นคือพฤติกรรมที่ต้องการ

---

## 6. สายและกล่องอุปกรณ์

**กล่องไม่ใช่กล่องเดียวอีกต่อไป** มีกล่องแห้งนอกโรงเรือนที่บรรจุ PCB ทั้งสองแผ่น
และมี **จุดติดตั้งเซนเซอร์สี่จุด** อยู่บนสาย:

| # | ปลายทาง | สาย | สิ่งที่อยู่ในสาย |
|--:|---|---|---|
| 1–6 | โพรบน้ำ `P0`–`P5` | 5–10 ม. ต่อเส้น | DQ ตีเกลียวกับ GND, VDD แยกเส้น |
| 7 | SHT45 #0 — **หัวโรงเรือน** | ≤5 ม. | `V / SDA / SCL / G` |
| 8 | SHT45 #1 — **ท้ายโรงเรือน** | ≤5 ม. | `V / SDA / SCL / G` |
| 9 | SHT45 #2 — **นอกโรงเรือน** | ≤5 ม. | `V / SDA / SCL / G` |
| 10 | **SCD41 — กลางโรงเรือน ระดับก้อนเชื้อ** | 5 ม. **22 AWG** | `V / SDA / SCL / G` |
| 11 | อินพุตโซลาร์ | — | 24 V + GND จากชาร์จคอนโทรลเลอร์ |

**สายเข้ากล่องสิบเอ็ดเส้น** และ **สี่เส้นในนั้นเป็นสายแบบเดียวกันกับขั้วต่อแบบเดียวกัน**:
`V / SDA / SCL / G` บนเทอร์มินอลบล็อกถอดได้ 4 ขา ตั้งแต่ J9 ถึง J12 กิ่ง CO2 ของรุ่น 2.0
ไม่ใช่กรณีพิเศษอีกต่อไป — มันคือกิ่ง I2C เส้นที่สี่ ต่างกันแค่ขนาดสาย นี่แหละคือสิ่งที่
กำหนดขนาดกล่อง ไม่ใช่ตัว PCB — บทเรียนเดียวกับที่เอกสารนี้เคยเรียนรู้แล้วครั้งหนึ่ง
ตอนเพิ่มโพรบเป็นหกตัว

**อาคารคือโรงเรือนเพาะเห็ด ไม่ใช่โรงเรือนพืช** และมีสามอย่างที่ตามมา ซึ่งพลาดง่าย
ถ้ารับข้อความมาจากรุ่นก่อน: มัน **มืด** (ไม่ต้องมี radiation shield ข้างใน ไม่มีภาระ
ความร้อนจากแดด) มัน **ถูกฉีดหมอก** (น้ำเหลวเกาะพื้นผิวเป็นเรื่องปกติ ไม่ใช่อุบัติเหตุ)
และมัน **มี CO2 สูงโดยตั้งใจ** (ไม่มีอะไรในนั้นเข้าใกล้อากาศภายนอกเลย ซึ่งคือสิ่งที่
หัวข้อ ASC ใน §3 พูดถึง)

- **โพรบ:** เทอร์มินอลบล็อกถอดได้ 3 ขา หกตัว การเข้าสายใหม่หน้างานด้วยมือที่เย็น
  คือกรณีที่ต้องออกแบบเผื่อ หัวย้ำ JST ไม่รอด ให้พิมพ์ `V / DQ / G` บนซิลค์สกรีน
  ทุกตัว และ **ใส่หมายเลข `P0`–`P5` ให้ตรงกับ `DS_PROBE_BUSES`** และชื่อเมตริก
- **ความยาวสายโพรบ: 5–10 ม.** ทุกค่าใน §3 ถูกกำหนดมาสำหรับระยะนี้ เกิน 20 ม.
  พูลอัพ DQ ต้องลดเหลือ 2.2 kΩ และเกิน ~30 ม. ต้องใช้ไอซีไดรเวอร์ DS2483
- **สายโพรบ:** หนึ่งคู่ตีเกลียว = **DQ + GND**, VDD ใช้เส้นแยก สาย Cat5 เหมาะที่สุด
  ให้เลือก **UTP ธรรมดามากกว่าแบบชีลด์** — ชีลด์เพิ่มคาปาซิแตนซ์ต่อเมตรราวสองเท่า
- **กิ่ง I2C: ≤5 ม. ทั้งสี่เส้น และนี่คือตัวเลขที่เข้มงวด** ที่ 5 ม. ด้วย 2.2 kΩ
  เวลาขอบขาขึ้นคือ 0.60 µs เทียบกับงบ 1000 ns ที่ 10 ม. มันพัง ถ้าจำเป็นต้องยาวกว่านี้
  ให้ใส่ P82B715 บนเส้นนั้น (§3) — อย่าแค่ต่อสายให้ยาวขึ้นเฉย ๆ
  ให้ตีเกลียว **SDA กับ GND** และเดิน SCL ในคู่ที่สอง หนึ่งเส้น Cat5 ต่อหนึ่งกิ่ง
- **กิ่ง CO2 ใช้ 22 AWG บน `V`/`G` และนั่นเป็นข้อกำหนด** มันเป็นกิ่งเดียวที่พา
  กระแสพุ่ง 205 mA ที่ 24 AWG แรงดันตกจะเป็น 173 mV แทนที่จะเป็น 109 mV
  ดู §5 *ส่ง 3.3 V ลงสาย CO2* สาย Cat5 คือ 24 AWG — สำหรับกิ่งนี้ให้ใช้สาย 4 แกน
  ที่หนากว่า หรือใช้ตัวนำคู่ขนานบน `V` และ `G`
- **ติดป้ายที่ปลายทั้งสองข้างของทุกเส้น** ขั้วต่อสี่ตัวที่เหมือนกัน และสายสี่เส้นที่
  เกือบเหมือนกัน การสลับ J10 กับ J11 จะสลับ "ในโรงเรือน" กับ "ค่าอ้างอิงภายนอก"
  ไปเงียบ ๆ และข้อมูลก็ยังดูสมเหตุสมผล ส่วนการสลับ J12 จะเอากระแสพุ่ง 205 mA
  ของเซนเซอร์ CO2 ไปลงสาย 24 AWG โดยไม่มีอะไรร้องเลย
- **กล่องเซนเซอร์ — แต่ละจุดต้องมีของตัวเอง** เล็ก ระบายอากาศได้ หันเซนเซอร์ลงล่าง
  SHT45 ทน 100 %RH และฟื้นจากการควบแน่นได้ จึงต้องการการป้องกันจากน้ำ *เหลว*
  และแดด ไม่ใช่การปิดผนึกสนิท
- **SHT45 #2 ต้องมี radiation shield ไม่ใช่แค่กล่อง** — มันเป็นเซนเซอร์ตัวเดียวที่
  เห็นแดด แบบมีบานเกล็ดหรือ Stevenson เซนเซอร์อยู่ใต้ที่บัง หันไปทางทิศเหนือ
  เซนเซอร์ที่ไม่มีที่บังกลางแดดไทยจะอ่านค่า **สูงกว่าอุณหภูมิอากาศจริง 10–15 °C**
  และค่าอ้างอิงจะแย่ยิ่งกว่าไร้ประโยชน์ — มันจะกลายเป็นค่าที่ทำให้เข้าใจผิด
  **ส่วนสามตัวที่อยู่ในโรงเรือนไม่ต้องมีที่บังแดด** ในนั้นมืด
- **หัววัด CO2 คือตัวที่เรื่องมากที่สุด** กล่องระบายอากาศที่กันละอองน้ำ โดย
  **หันช่องแพร่แก๊สลงล่าง** เพื่อให้หยดน้ำหยดทิ้งแทนที่จะขังบนทางเดินแสง
  มีเมมเบรน **PTFE/Gore** **ห้ามปิดผนึก** และ **ห้ามอยู่ในแนวที่หัวฉีดหมอกพ่นใส่โดยตรง**
  ไม่ต้องมี radiation shield SCD41 มีพิกัด 0–95 %RH ห้ามควบแน่น และอาคารนี้จะอยู่
  ชิดขีดนั้น — ดู *การควบแน่น* ใน §3 สำหรับแพดฮีตเตอร์ที่อาจต้องใส่
- **กล่อง front-end ไม่ต้องมีช่องระบายอากาศ** ไม่มีอะไรในกล่องที่วัดอากาศ
  มันควรเป็น **IP65 และปิดสนิทเท่าที่เคเบิลแกลนด์จะอำนวย** แต่ยังควรใส่สารดูดความชื้น
  ไว้ถ้าต้องเปิดกล่องบ่อยในอากาศชื้น
- **RF:** ให้เสาอากาศห่างจากโลหะ และให้สายแพห่างจากภาควิทยุและ CN12 SMA
  สายแพ 30 ซม. ที่พาดทับเสาอากาศคือปัญหาการจูนเสาจริง ๆ และตอนนี้มีสายสิบเอ็ดเส้น
  แย่งพื้นที่กันอยู่ ให้วางแผนการเดินสายไว้ก่อน อย่ารอให้ค้นพบเอาหน้างาน
- **จุดทดสอบ:** รุ่นนี้ไม่มีแพดทดสอบ ดู §4a *วัดที่ไหนเมื่อไม่มีแพดทดสอบ* — และสังเกตว่าชุด I2C ที่ถูกตัดออกคือคู่ SDA/SCL ฝั่งปลายทาง
  **สี่คู่** กิ่งละคู่ เมื่อมีโพรบหกตัวและกิ่ง I2C สี่เส้น คำถามแรกของทุกความล้มเหลว
  หน้างานคือ "เส้นไหน?"

---

## 7. ลำดับการทดสอบเปิดเครื่องครั้งแรก (bring-up)

ทำสิ่งเหล่านี้ก่อนที่บอร์ดจะเข้าไปอยู่ในกล่องที่ปิดสนิทบนเสา

**ไฟเลี้ยงก่อน และทำแยกต่างหาก** — ข้อนี้เป็นของใหม่ และเป็นขั้นตอนที่ปกป้อง
ทุกอย่างที่เหลือ:

> **ก่อนขั้นตอนที่ 1 — ทำครั้งเดียว ที่จุดติดตั้งจริง ด้วยมัลติมิเตอร์** วัดแรงดันวงจรเปิด
> ของแผงที่ขั้ว PV ของคอนโทรลเลอร์ จากนั้นถอดแบตแล้วตรวจว่าขั้วแบต/LOAD ของ
> คอนโทรลเลอร์ **ไม่** วิ่งตามขึ้นไป V_oc ของแผง "24 V" อยู่ราว 44 V ส่วน U7 เป็น
> ตัว 36 V และไม่มีอะไรบนบอร์ดนี้กันคอนโทรลเลอร์ที่ปล่อย V_oc ผ่านมาได้ ห้านาที
> และมันคือด่านป้องกันเดียวที่มี — ดู *สิ่งที่ภาคอินพุตไม่ได้คุ้มครองอีกต่อไป*

1. **เปิดภาคอินพุต 24 V โดยยังไม่ต่อโหลดใด ๆ บน PCB** F1 → Q2 → D9 → C11 แล้ว
   ยืนยันว่า **U7 = 3.3 V ±2 %** บนแหล่งจ่ายที่กวาดแรงดัน
   **18 → 32 V** ค่านี้ต้องไม่เกิน **3.6 V** ที่แรงดันอินพุตใด ๆ ถ้าเกิน ให้หยุด —
   ทั้ง CN6-4 และ STM32WL มีพิกัดสูงสุดสัมบูรณ์ 3.6 V เท่ากัน มัลติมิเตอร์พอสำหรับ
   รางไฟ ส่วนออสซิลโลสโคปที่เอาต์พุตควรเห็นริปเปิล **ราว 50 mV_pp** (ค่า
   typical ตามดาต้าชีต) ที่ราว 500 kHz และไม่มีอะไรช้ากว่านั้น ไม่มีโหนด `SW` ให้ส่อง และไม่มี COT bursting
   ให้จับ — คอนเวอร์เตอร์อยู่ในโมดูล
   **วัดและจดกระแสอินพุตตอนไม่มีโหลด** ตรงนี้ จากค่าที่แหล่งจ่ายบนโต๊ะแสดง โดยไม่ต่อ
   โหลดที่เอาต์พุต: ตารางพลังงานใน §5 ใช้ค่า typical จากดาต้าชีต 1 mA และไม่มีค่าสูงสุด
   ระบุไว้ และแถวเดียวนั้นคือ **72 % ของงบพลังงานทั้งโหนด** ให้เขียนตัวเลขที่วัดได้
   ลงในตารางนั้น
2. **จงใจลัดวงจร `VSENS` ที่ J12** U7 ต้องเข้าโหมดจำกัดกระแสและกลับมาทำงานเมื่อเอา
   การลัดวงจรออก สิ่งที่ขั้นตอนนี้พิสูจน์แคบแต่คุ้มค่า: **กิ่งเซนเซอร์ที่ช็อตไม่ทำลาย
   โมดูล** และ `SENS_GATE` เคลียร์มันได้ (รุ่นก่อนทดสอบข้อนี้ที่ราง 5 V เพื่อแสดงว่า
   CO2 ที่เสียทำให้วิทยุไฟตกไม่ได้ เมื่อเหลือรางเดียวกรอบคิดนั้นหายไป สิ่งที่สำคัญคือ
   เส้นทางกู้คืน)
   ให้ลองตัดเกตขณะที่ยังลัดวงจรอยู่แล้วยืนยันว่ารางไฟกลับมา — นั่นคือเส้นทางกู้คืนที่
   เฟิร์มแวร์พึ่งพา และเป็นเหตุผลที่เอาเซนเซอร์ CO2 กลับมาไว้หลังเกต
3. **อ่านค่าภาคอินพุตที่แท็บของ Q2, ขา 1 ของ U7 และแพดฝั่งเกตของ R38 โดยอ้างอิงขา 2 ของ U7 ก่อนอย่างอื่นทั้งหมด** บอร์ดรุ่นนี้ไม่มีแพดทดสอบ (§4a) จึงใช้แพดเหล่านี้แทน — แท็บ SOT-223 หนึ่งจุดกับขาสอดรูอีกสามจุด ใหญ่พอรับโพรบทั้งหมด
   สามค่าจากมัลติมิเตอร์ที่อินพุต 24.0 V ต่อถูกขั้ว แยกทุกรูปแบบที่ภาคนี้ถูกสร้างผิดได้:

   | `24V_RAW` ที่แท็บ Q2 | `24V_PROT` ที่ U7-1 | เกตที่ R38 | การวินิจฉัย |
   |---|---|---|---|
   | 24 V | ≈24 V | **≈12 V** | **ถูกต้อง** V_GS = −12 V ช่องนำกระแสเปิดเต็มที่ |
   | **0 V** | 0 V | 0 V | **F1 ขาด** หรือไม่มีไฟมาถึง J14 |
   | 24 V | **≈23.3 V** | ≈ เท่ากับ `24V_PROT` | **`R38` ขาด/ไม่ได้ใส่ หรือ `D10` ช็อต** → V_GS ≈ 0 กำลังวิ่งผ่านไดโอดบอดี |
   | 24 V | ≈24 V | **≈0 V** | **`D10` หาย ใส่กลับด้าน หรือผิดค่า** → V_GS = −24 V เกินขีด ±20 V แล้ว ต้องเปลี่ยนทั้ง D10 **และ** Q2 |
   | 24 V | **0 V** | 0 V | Q2 เปิดวงจร — เสีย หรือบัดกรีไม่ติดจริง |

   **แถวที่ 3 เป็นการทดสอบแบบ 0 V เทียบกับ 0.7 V ไม่ใช่การวัดที่ต้องการความละเอียด**
   ที่โหลดเฉลี่ย 5 mA แรงดันตกคร่อม Q2 จริง ๆ คือ 0.14 mV ซึ่งไม่มีมิเตอร์ภาคสนาม
   ตัวไหนอ่านออก สิ่งที่กำลังมองหาคือมันเป็น *0.7 V* หรือไม่ ซึ่งแปลว่าช่องนำกระแส
   ไม่เคยเปิดและทั้งโหนดกำลังถูกจ่ายไฟผ่านไดโอดบอดี อาการนี้รอดการทดสอบบนโต๊ะได้
   แล้วไปร้อนและแรงดันตกเอาในสนาม

   **สิ่งที่การวัดนี้จับไม่ได้: Q2 ใส่กลับด้าน** (สลับซอร์สกับเดรน) ทุกค่าข้างบน
   จะอ่านได้ปกติหมด มีแค่ขั้นตอนที่ 4 เท่านั้นที่จับได้
4. **จงใจต่อแหล่งจ่ายกลับขั้ว** Q2 ต้องบล็อก: **กระแสเป็นศูนย์** `24V_PROT`
   อยู่ที่ 0 V และต้องไม่มีอะไรร้อนที่ใดเลย ถ้ามีกระแสไหล แปลว่า Q2 ใส่กลับด้าน
   คือสลับซอร์สกับเดรน ซึ่งเป็นความผิดพลาดเดียวที่ผ่านการทดสอบขั้วถูกทุกอย่าง
   ทำตอนนี้บนโต๊ะ ดีกว่าไปค้นพบที่ชาร์จคอนโทรลเลอร์ซึ่งเดาขั้วจากฉนวนที่สีซีดแล้ว
5. **จากนั้นจึงต่อสาย CN6 เข้ากับ Nucleo** โดยตัดขา CN6-1 และอุดรูที่ 1 แล้ว (§2)

**ทดสอบสายอย่างเดียว ยังไม่ต่ออะไร** — ห้านาทีที่คุ้มค่า:

6. **ไล่วัดความต่อเนื่องของสายแพจากปลายถึงปลาย** เทียบกับตารางใน §2 ยืนยัน
   ความต่อเนื่องที่ตำแหน่งตามข้อตกลงทั้ง **สิบห้า** ตำแหน่ง และที่สำคัญที่สุดคือ
   **ต้องไม่มี** อะไรต่อถึง CN10-2, -4, -7, -22, -32 หรือ -38 สังเกตว่า
   **-35 และ -37 ถูกใช้แล้ว** (`DBG_TX`/`DBG_RX`) — มันออกจากรายการต้องห้ามในรุ่นนี้
   สายแพที่ประกอบเลื่อนไปหนึ่งตำแหน่งคือความผิดพลาดที่มีโอกาสเกิดสูงสุดในดีไซน์นี้
   และนี่คือจังหวะสุดท้ายที่การตรวจยังราคาถูก
7. **ตรวจคีย์ ขั้นนี้สำคัญกว่าที่เคยเป็น** เมื่อตัดขา CN10-6 และอุดรูที่ 6 แล้ว
   ซ็อกเก็ตต้องเสียบลงได้ใน **ตำแหน่งเดียวเท่านั้น** และปฏิเสธทุกตำแหน่งที่เหลือ
   ลองให้ครบทั้งสี่แบบ: ลงตรง, เลื่อนไปหนึ่งคอลัมน์, และทั้งสองแบบนั้นหมุน 180°
   ต้องมีสามแบบที่เสียบไม่ลง ถ้าเสียบลงได้มากกว่าหนึ่งแบบแปลว่ายังทำคีย์ไม่เสร็จ
   ให้กลับไปทำ เพราะซ็อกเก็ตกว้างกว่า CN10 อยู่หนึ่งคอลัมน์ (§1)
   และไม่มีอะไรอื่นกันไม่ให้มันลงเหลื่อมไปสองขา

**ทดสอบ front-end อย่างเดียว โดยยังไม่เสียบสายแพเข้า Nucleo** — นี่คือเหตุผลที่
ต้องมีแพดทดสอบ:

8. ดึง `SENS_GATE` ขึ้นสูง → `VSENS` = 0 V ดึงลงต่ำ → `VSENS` = 3.3 V และสาย
   สัญญาณที่ถูกสวิตช์ทั้งแปดเส้น (DQ หกเส้น, SDA และ SCL ฝั่งต้นทาง) ต้องพักที่
   ระดับสูงผ่านพูลอัพของมัน **ทุกอย่างต้องลงไปที่ 0 V** — ในรุ่นนี้ไม่มีรางไฟเซนเซอร์
   ที่ไม่ถูกสวิตช์เลย อะไรที่ยังมีไฟตอนดึงเกตขึ้นสูงคือพูลอัพที่ไปลงบน 3V3 ถาวร
9. **วัดระดับพักของทุกสาย DQ** → ต้องได้ `pull-up=1 pull-down=1` ทั้งหกเส้น
   (พิสูจน์ว่าพูลอัพอยู่บน `VSENS` จริง ไม่ใช่ลง GND) ข้อ 6 และ 7 จับความผิดพลาด
   ประเภทตัวต้านทานต่อลง GND ได้ ซึ่งให้ scratchpad ที่เป็นศูนย์ทั้งหมด ผ่าน CRC
   และถอดออกมาได้เป็น `0.00 °C` ที่ดูน่าเชื่อ
10. **ตรวจ `VBAT_SENSE` ก่อนจะเชื่อค่าแรงดันใด ๆ ที่รายงานออกมา** เมื่อป้อน 24.0 V
   ที่ J14 ขา PB3 ควรอยู่ที่ **24.0 / 11 = 2.18 V** ให้กวาดแรงดันแล้วยืนยันว่ามัน
   เปลี่ยนตามแบบเชิงเส้น วงจรแบ่งที่ผิดไปหนึ่งหลักจะรายงานค่าคงที่ที่ดูสมเหตุสมผล
   และคุณจะเชื่อมันไปอีกหลายเดือน

**ต่อครบแล้ว:**

11. ปิดเกต → เมื่อรางไฟดับ SDA และ SCL ต้องอ่านได้ **0 V** ไม่ใช่ต่ำกว่า 3.3 V
   อยู่หนึ่งไดโอดดรอป ถ้าไม่ใช่ แปลว่ามีพูลอัพ I2C ไปอยู่บน 3V3 ที่จ่ายตลอด
   แทนที่จะเป็น `VSENS`
12. **เสียบโพรบทีละตัว** เริ่มจาก `P0` และยืนยันว่าค่าปรากฏใต้ชื่อเมตริกที่ถูกต้อง
    ก่อนจะเสียบตัวถัดไป ให้ใช้มืออุ่นโพรบทีละตัวแล้วดูว่าซีรีส์ที่ถูกต้องขยับ
13. เมื่อครบหกตัว → ต้องได้อุณหภูมิหกค่าที่สมเหตุสมผลและ **อิสระต่อกัน** CRC ผ่าน
    สองช่องที่ขยับตามกันเป๊ะคือขั้วต่อสองตัวที่ต่อเข้าขา MCU ขาเดียวกัน
14. **สแกน I2C โดยปิดทุกช่องของ mux** → ต้องเจอ **`0x70` และไม่มีอะไรอื่นเลย**
    ไม่มี `0x44` (ซึ่งแปลว่ามี SHT45 ต่ออยู่ต้นทาง และจะชนกันทันทีที่เปิดช่อง)
    และไม่มี `0x62` ด้วย — SCD41 หายไปแล้ว ถ้ามีอะไรตอบที่นั่น แปลว่าคุณกำลังดู
    บอร์ดผิดตัว
15. **สแกนอีกครั้งโดยเปิดทีละช่อง** → ต้องเจอ `0x44` หนึ่งตัวพอดีในแต่ละครั้ง
    เจอสองตัวพร้อมกันแปลว่ามีมากกว่าหนึ่งช่องเปิดอยู่ ไม่เจอเลยแปลว่าช่องนั้นไม่มี
    พูลอัพหรือไม่มีเซนเซอร์ ให้ทำขั้นตอนนี้ก่อนจะลองอ่านค่า: แอดเดรสที่ไม่ปรากฏคือ
    ปัญหาการต่อสายหรือพูลอัพ ส่วนแอดเดรสที่ปรากฏแต่ CRC ไม่ผ่านคือปัญหา
    signal integrity ซึ่งต้องแก้คนละแบบ
16. **อ่าน SHT45 ทั้งสามตัวโดยใช้สายจริงยาว 5 ม. ไม่ใช่สายทดสอบสั้น ๆ**
    ขั้นตอนนี้คือตัวจับพูลอัพ 4.7 kΩ ที่ฝั่งปลายทาง: มันทำงานได้บนสายยาว 300 มม.
    แล้วเริ่ม NACK เมื่อใช้สายจริง จากนั้น **เป่าลมใส่เซนเซอร์ตัวเดียว** —
    ต้องมีซีรีส์เดียวเท่านั้นที่ขยับ ถ้าขยับสองตัวแปลว่าสองช่องเชื่อมถึงกัน
    ถ้าตัวที่ขยับเป็นคนละตัวกับที่เป่า แปลว่าการจับคู่ช่องกับตำแหน่งผิด และค่าทุกค่า
    จะถูกติดป้ายผิดตั้งแต่นั้นไป ให้ตรวจกับซิลค์สกรีน: `CH0 หัว`, `CH1 ท้าย`, `CH2 นอก`
17. **อ่านหมายเลขเครื่องของ SCD41 บนช่อง 3 โดยเสียบสาย 22 AWG จริงแล้ว**
    `get_serial_number` (0x3682) คือการพิสูจน์ว่ามันมีชีวิต และ `scd41_init()` ทำอยู่แล้ว
    ขั้นตอนนี้แยก "กิ่งใช้ได้" ออกจาก "เซนเซอร์วัดได้" ซึ่งเป็นความผิดพลาดคนละแบบและ
    แก้คนละวิธี — และเป็นขั้นตอนที่จับได้ว่ากิ่ง CO2 ถูกเดินด้วยสาย Cat5 24 AWG
    เหมือนอีกสามเส้นโดยไม่ตั้งใจ
18. **อ่านค่า CO2 และตรวจสามค่าที่เฟิร์มแวร์รับผิดชอบ** ล็อกดีบักพิมพ์
    `co2=… asc=0 t=… rh=…`:
    - **`asc=0`** ถ้าอ่านได้ 1 แปลว่า `scd41_ensure_asc()` ไม่สำเร็จ และเซนเซอร์จะค่อย ๆ
      สอบเทียบตัวเองจนใช้ไม่ได้ในอาคารที่ไม่มีวันเห็น 400 ppm นี่คือตัวเลขที่สำคัญที่สุด
      ในการ bring-up ทั้งหมด
    - **ระดับความสูง** — อ่านกลับด้วย `get_sensor_altitude` (0x2322) ต้องได้
      `SCD41_SITE_ALTITUDE_M` (330) ตั้งก่อน FRC เสมอ ไม่ใช่หลัง
    - **ตัวค่าเอง** อากาศกลางแจ้งอยู่ที่ **~420 ppm** โรงเรือนเห็ดอยู่ *สูงกว่า*
      อากาศภายนอกตลอดเวลา และสูงที่สุดตอนปิดโรงเรือน — ตรงข้ามกับโรงเรือนพืช
      อย่าใช้สัญชาตญาณเดิม ช่วงเดินเส้นใยจะอ่านได้เกิน 5000 ppm ซึ่งอยู่นอกช่วง
      ความแม่นยำที่ระบุแต่ยังอยู่ในสเกล ดู §3
    - **อุณหภูมิของ SCD41 เอง** เทียบกับ SHT45 ตัวที่ใกล้ที่สุด มันอ่านสูงกว่าโดย
      ธรรมชาติ (มีความร้อนในตัว) แต่ถ้าสูงกว่า *มาก* แปลว่าหัววัดระบายอากาศไม่ได้
    CRC ที่ไม่ผ่านคือปัญหาสาย ส่วนค่าที่อ่านได้ถูกต้องแต่ไม่สมเหตุสมผลคือปัญหาการ
    สอบเทียบ และคำตอบของข้อนั้นคือขั้นตอน FRC ใน §3 — ไม่ใช่การเปิด ASC กลับ
19. **ทดสอบด้วยการขยับสาย** เมื่อทุกอย่างอ่านค่าได้แล้ว ให้ดัดสายแพและดึงสายทั้ง
    สิบเอ็ดเส้นเบา ๆ ต้องไม่มีอะไรกระตุก นี่คือการทดสอบที่หาหัวย้ำ IDC ที่ก้ำกึ่ง
    เจอก่อนที่เสาจะหาเจอ
20. รอบการทำงานเต็มรูปแบบ → ตื่น อ่านค่า ส่ง แล้วสลีป ยืนยันว่าเกตเวย์บันทึกว่า
    `6/6 probes and 3/3 air sensors reading` พร้อมค่า CO2 และยืนยันว่า `VSENS` ดับ
    **ระหว่าง** สลีปจริง ไม่ใช่ตอนตื่นครั้งถัดไป ระหว่างนั้นให้จับเวลาหน้าต่างที่เกตเปิด
    ด้วย: ควรเป็น **~11 วินาที** โดยมี single shot 5 วินาทีสองครั้งของ SCD41 เป็นตัวหลัก
    ถ้าสั้นกว่านั้นมากแปลว่า warm-up shot ถูกข้าม ถ้ายาวกว่านั้นมากแปลว่ามีอะไรกำลัง retry
21. **ส่องออสซิลโลสโคปที่ `VSENS` ตลอดหนึ่งรอบการตื่น โดยต่อกิ่ง CO2 ไว้ด้วย**
    นี่คือการวัดข้อเดียวที่เป็นของใหม่ในรุ่น 2.0 และไม่มีในรุ่นก่อน ๆ เลย:
    กระแสพุ่ง **205 mA** ของ SCD41 ตอนนี้อยู่บนรางเดียวกับทุกอย่าง ยืนยันว่ามันเกิด
    *หลัง* การแปลงค่าของ DS18B20 และการอ่าน SHT45 เสร็จแล้ว — ถ้ามันทับกัน แปลว่า
    ลำดับใน `main.cpp` ถูกแก้ และโพรบกำลังถูกสุ่มค่าผ่านไฟเลี้ยงที่ถูกรบกวน
22. **ส่องออสซิลโลสโคปที่ VDD *ตรงหัววัด CO2* แล้วตรวจสองค่า** หัวข้อ *คำถามเรื่อง
    30 mV* ใน §3 ให้เหตุผลว่าสาย 5 เมตรกรองริปเปิลสวิตชิงของ U7 เหลือราว 2 mV
    ที่ตัวเซนเซอร์ แต่ข้อโต้แย้งนั้นตั้งอยู่บนค่าความเหนี่ยวนำของสายที่ *ประมาณเอา*
    ตรงนี้คือจุดที่ค่าประมาณถูกทดสอบ วัดคร่อม 100 nF ที่หัววัด สายกราวด์สั้น ๆ แล้วอ่าน:

    | | ควรได้ | ถ้าไม่ผ่าน |
    |---|---|---|
    | **ริปเปิล ตอนเซนเซอร์ยังไม่วัด** (AC-coupled, จำกัดแบนด์วิดท์ 20 MHz) | **< 30 mV p-p** และการคำนวณบอกว่า ~2 mV | ถ้าใกล้หรือเกิน 30 mV แปลว่าคาปาซิเตอร์ที่หัววัด ESR สูง หายไป หรือไม่ได้อยู่ที่ตัวเซนเซอร์จริง นี่คือขีดจำกัดในดาต้าชีต ไม่ใช่คำแนะนำ |
    | **แรงดันตก ขณะวัด** | VDD ที่หัววัดยังอยู่ **สูงกว่า 2.4 V มาก** (คาดไว้ ~3.12 V) | ถ้าตกลงมาใกล้ 2.4 V แปลว่าใช้ 24 AWG แทน 22 AWG หรือไม่มี 100 µF |

    ทั้งสองความผิดพลาดเงียบทั้งคู่: เซนเซอร์ยังตอบ และยังคืนค่าที่ผ่าน CRC วัดครั้งเดียว
    ตอนประกอบ แล้วจดสองค่านั้นไว้ในบันทึกการสร้าง — ไม่มีอาการตอนใช้งานใดที่จะพา
    คุณกลับมาที่จุดนี้

---

## เอกสารอ้างอิง

- **UM2592** — คู่มือผู้ใช้บอร์ด STM32WL Nucleo-64 (MB1389): เป็นเอกสารอ้างอิงหลัก
  ของบอร์ดนี้ **Table 18** ("Pin assignment of the ST morpho connectors") คือที่มา
  ของตาราง CN10 ใน §2 และตาราง CN7 ในภาคผนวก A; **Table 17** ("ARDUINO connectors
  pinout") คือที่มาของจุดต่อไฟ CN6; **Table 9** ("External power sources: 3V3")
  คือที่มาของจุดรับไฟแบตเตอรี่ที่ CN6-4; ส่วน §6.6.5 และตาราง solder-bridge
  ครอบคลุมการจัดวาง VCP/D0-D1
- ดาต้าชีต Sensirion **SCD4x** **v1.7 (เมษายน 2025)** — เซนเซอร์ CO2 §1.1 ย่านความแม่นยำ,
  §2.1 กระแสพีค 175/205 mA และค่าเฉลี่ยของ single shot, §2.2 ช่วง −10…60 °C / 0–95 %RH,
  §2.3 ตารางแพด การเชื่อม VDD/VDDH และคำขอเรื่องไฟเลี้ยงที่ต้องนิ่งภายใน 30 mV,
  §2.4 เวลาเปิดเครื่อง **30 ms**, §3.8 **ASC กับข้อสมมติเรื่อง 400 ppm ทุกสัปดาห์**
  และ FRC, §3.11 โหมด single shot และหมายเหตุว่า **ASC ใช้ไม่ได้เมื่อถูกตัดไฟเป็นรอบ**,
  §3.12 CRC-8 ที่ `src/sensirion_i2c.cpp` ทำไว้แล้ว และ §4.1–4.6 ตัวถัง land pattern
  MSL 1 กับโปรไฟล์ reflow
  **ให้อ่าน §6 ประวัติการแก้ไขด้วย** — มีสองรายการในนั้นที่เปลี่ยนวิธีอ่านส่วนที่เหลือ
  v1.4 *"[แก้ไข] power-up time and soft reset time"* (1000 ms → 30 ms; ตัวเลขเก่ายังวนอยู่
  ใน app note ของ Sensirion เอง) และ **v1.7 คือฉบับที่ลบคำแนะนำเรื่อง "ให้ทิ้งค่า
  single shot ครั้งแรกหลังตัดไฟ" ซึ่งบอร์ดนี้ยังทำตามอยู่** — ดู §3
  *ราคาที่ต้องจ่ายคือ throwaway shot* ว่าทำไมจึงยังทำตาม
- Application note ของ Sensirion **"SCD4x Low Power Operation"** v1.0 (กรกฎาคม 2022)
  — เอกสารอ้างอิงหลักของโหมดที่โหนดนี้ใช้จริง §2.4 power-cycled single shot,
  ค่าแรกที่ถูกทิ้ง และเกณฑ์ **380 วินาที** ที่การตัดไฟเริ่มคุ้มกว่าการปล่อย idle;
  §3.3 **สมการที่ 2** (154 mC ต่อ shot ที่ใช้ได้จริง ที่ 3.3 V) ซึ่งเป็นที่มาของแถว
  พลังงาน CO2 ใน §5; §5.1 การวอร์มอัพก่อน FRC **5 นาทีที่คาบ 1 นาที**
  ให้ระวัง flowchart เรื่องเวลาในเอกสารนี้ — มันยังแสดงเวลาเปิดเครื่อง 1000 ms ที่ถูกแทนที่ไปแล้ว
- ดาต้าชีต Traco Power **ซีรีส์ TSR 1** rev. 2026-07-02 — U7 (TSR 1-2433):
  ช่วงอินพุต ความแม่นยำ ±2 % จำกัดกระแส 250 % กระแสอินพุตตอนไม่มีโหลด
  1 mA typ ลำดับขา SIP-3 (1 = +V_in, 2 = GND, 3 = +V_out) ขีดจำกัดโหลดคาปาซิทีฟ 470 µF
  **คาปาซิเตอร์อินพุต 22 µF / 50 V ที่บังคับเมื่อ V_in > 32 V** และ *"หลีกเลี่ยงการเดินลาย
  PCB ใต้คอนเวอร์เตอร์"*
- ดาต้าชีต TI **TCA9548A** (SCPS207H) — bus switch §5.5: กระแส standby
  **0.1 µA typ / 2 µA max** ซึ่งเป็นเหตุผลที่การมีสี่กิ่งอยู่หลังมันไม่มีต้นทุน
- Senseair **PSP14281 / TDE14367 / TDE15154 / PSP14808** — ตระกูล S88 ที่รุ่นก่อนใช้
  และเก็บไว้ที่ [`hardware-interface-s88.th.md`](hardware-interface-s88.th.md)
  ไม่ได้ใช้กับบอร์ดรุ่นนี้ แต่ **S88 GH** (0–20 000 ppm, 0–95 %RH) คือทางถอยที่บันทึกไว้
  ถ้าความต้องการช่วงวัด CO2 โตเกิน SCD41
- ดาต้าชีต TI **LM5164** (SNVSAU4) และ **AN-1481** — buck แบบ discrete ของรุ่นก่อน
  เก็บไว้ที่ [`hardware-interface-back.th.md`](hardware-interface-back.th.md)
  ไม่ได้ใช้กับบอร์ดรุ่นนี้
- Maxim/ADI **AN148** — แนวทางการทำเครือข่าย 1-Wire ระยะไกลให้เชื่อถือได้
- ดาต้าชีต DS18B20 — ค่า **VDD 3.0–5.5 V** คือข้อจำกัดที่กำหนดการเลือกแบตเตอรี่
- ดาต้าชีต Sensirion **SHT4x** — ชุดคำสั่ง จังหวะเวลา และฟังก์ชันแปลงค่าที่พอร์ตไว้ใน
  [`src/sht45.cpp`](../src/sht45.cpp)
- ดาต้าชีต Sensirion **SCD4x** — ชุดคำสั่ง เวลาเริ่มทำงาน 1 วินาที ระยะเวลาวัดครั้งเดียว
  5 วินาที และตัวเลขกระแสพีคที่ใช้กำหนดขนาดของ Q1 พอร์ตไว้ใน
  [`src/scd41.cpp`](../src/scd41.cpp)

---

## ภาคผนวก A — ST morpho CN7 (ไม่ได้ใช้กับสายสัญญาณ)

ตัว CN10 รับสัญญาณทั้งหมดไปแล้ว (§2) ดังนั้น CN7 จึงว่าง ที่เก็บตารางนี้ไว้เพราะขา
เหล่านั้นยังเปิดโล่งอยู่บนโหนดที่ประกอบเสร็จแล้ว และเป็นจุดที่เหมาะสมที่สุดสำหรับ
ต่อออสซิลโลสโคป แหล่งจ่ายไฟทดสอบ หรือดีบักเกอร์ — อีกทั้งตารางนี้ยังหาใหม่ได้ยาก

ถอดความจาก **UM2592 Rev 1, Table 18** และตรวจสอบซ้ำกับไฟล์ PDF ด้วยสคริปต์

| คี่ | ชื่อ | | คู่ | ชื่อ | |
|---:|---|---|---:|---|---|
| 1 | NC | | 2 | NC | |
| 3 | NC | | 4 | NC | |
| 5 | VDD_MCU | | 6 | E5V | |
| 7 | BOOT0 | | 8 | GND |  |
| 9 | NC | | 10 | NC | |
| 11 | NC | | 12 | IOREF | |
| 13 | PA13 | ⛔ SWD | 14 | NRST | |
| 15 | PA14 | ⛔ SWD | 16 | 3V3 | จุดรับไฟแบตเตอรี่ทางเลือก |
| 17 | PA15 | | 18 | 5V | |
| 19 | GND |  | 20 | GND |  |
| 21 | NC | | 22 | GND | |
| 23 | PC13 | | 24 | VIN | |
| 25 | PC14 | | 26 | NC | |
| 27 | PC15 | | 28 | PB1 | |
| 29 | NC | | 30 | PB2 | สำรอง |
| 31 | NC | | 32 | PA10 | สำรอง — เป็นขา 1-Wire ที่ใช้ได้ดี แต่อยู่ผิดขั้วต่อ |
| 33 | VBAT | ⛔ **ขา RTC backup ไม่ใช่ขารับไฟ** | 34 | PB4 | |
| 35 | NC | | 36 | PB14 | |
| 37 | NC | | 38 | PB13 | |

สามตำแหน่งที่ควรรู้ไว้:

- **CN7-16 `3V3`** — เป็นจุดรับไฟแบตเตอรี่เดียวกันกับ `CN6-4` ถ้าอยากจ่ายไฟจากฝั่งนี้แทน
  ถ้าทำเช่นนั้นให้ใช้ซ็อกเก็ตยาวเต็มขั้วด้วย (§2)
- **CN7-33 `VBAT`** — คือขา **RTC backup** ของ STM32 *ไม่ใช่* ขารับไฟ
  มันจ่ายไฟให้ MCU หรือภาควิทยุไม่ได้ ชื่อของมันคือกับดัก อย่าต่อแบตเตอรี่เข้ากับขานี้
- **CN7-13/15 `PA13`/`PA14`** — คือ SWD ซึ่งเป็นที่เดียวที่จะเอาสัญญาณดีบักออกมาได้
  ตัว front-end อาจเดินสายเหล่านี้ออกไปยัง test header ได้
