wsarachai/smartfarm/water-temp-node/docs/hardware-interface-back.th.md

# water-temp-node — สเปกอินเทอร์เฟซฮาร์ดแวร์

> ⚠ **ถูกแทนที่แล้ว — 2026-09 และตอนนี้ตามหลังอยู่สองรุ่น** ไฟล์นี้คือ
> **รุ่น buck แบบ discrete ด้วย LM5164** เก็บไว้ทั้งฉบับเพื่อการอ้างอิง
> **ห้ามสร้างบอร์ดจากไฟล์นี้** มีการเปลี่ยนแปลงเกิดขึ้นสองครั้งหลังจากนี้:
>
> - **รุ่น 1.0** เปลี่ยน buck แบบ discrete `U6`/`U7` เป็นโมดูลสำเร็จรูป
>   **Traco TSR 1** สองตัว นี่คือการเปลี่ยนแปลงที่ไฟล์นี้มีไว้เพื่อเก็บอีกด้านหนึ่ง
>   ส่วนที่ต่างกันคือ §5 และแถวไฟเลี้ยงใน §4
> - **รุ่น 2.0** เปลี่ยนเซนเซอร์ CO2 จาก Senseair S88 เป็น **Sensirion SCD41
>   บน I2C** ซึ่งลบรางไฟ 5 V, โมดูลตัวที่สอง, ระบบย่อย RS-485 ทั้งหมด และ
>   สัญญาณสามเส้นออกจากสัญญาที่ขั้วต่อ (สิบแปด → สิบห้า)
>
> ดังนั้นหัวข้อเรื่องไฟเลี้ยงในไฟล์นี้เก่าไปหนึ่งรุ่น ส่วนที่เหลือเก่าไปสองรุ่น
> สเปกปัจจุบันคือ [`hardware-interface.th.md`](hardware-interface.th.md)
> (ฉบับจริงภาษาอังกฤษ: [`hardware-interface.md`](hardware-interface.md))
> ส่วนรุ่น S88 ที่อยู่ตรงกลาง ถ้านั่นคือสิ่งที่กำลังหา อยู่ที่
> [`hardware-interface-s88.th.md`](hardware-interface-s88.th.md)

> **หมายเหตุเรื่องการแปล**
> เอกสารนี้เป็นฉบับแปลภาษาไทยของ [`hardware-interface.md`](hardware-interface.md)
> **ฉบับภาษาอังกฤษถือเป็นฉบับจริง (source of truth)** — เมื่อสองฉบับขัดแย้งกัน
> ให้ยึดฉบับภาษาอังกฤษ และเมื่อแก้สเปก **ต้องแก้ฉบับภาษาอังกฤษด้วยเสมอ**
> เพราะเป็นไฟล์ที่โค้ดเฟิร์มแวร์อ้างถึง
>
> สิ่งที่ **ไม่แปล** โดยเจตนา: เลขรุ่นอุปกรณ์ ชื่อขา (`PA8`) ชื่อสัญญาณ (`SENS_GATE`)
> ตำแหน่งขั้วต่อ (`CN10-16`) ชื่อตัวแปร/มาโครในโค้ด พาธไฟล์ และหน่วยวัด
> เพราะแปลแล้วใช้งานจริงไม่ได้
>
> **แผนภาพ ASCII ทุกอันคงไว้เป็นภาษาอังกฤษ** เพราะอักษรไทยมีความกว้างไม่คงที่
> ในฟอนต์ monospace ถ้าแปลข้างในแผนภาพจะเพี้ยนทั้งหมด — คำอธิบายภาษาไทยอยู่รอบ ๆ แทน

งานประกอบจริง (ไม่ใช่บนเบรดบอร์ด) คือ **PCB สองแผ่นเชื่อมกันด้วยสายเคเบิล**:

| บอร์ด | คืออะไร | มีอะไรอยู่บนนั้น |
|---|---|---|
| **Brain (สมอง)** | NUCLEO-WL55JC1 (ของสำเร็จรูป) | STM32WL55JC, ภาคสื่อสารวิทยุ, RF switch, TCXO, สายอากาศ, ST-LINK |
| **Front-end (ภาคหน้า)** | PCB ออกแบบเองขนาดใหญ่ ตามสเปกนี้ | **ขั้วต่อโพรบ DS18B20 6 ตัว**, **ขั้วต่อสาย SHT45 ระยะไกล 3 เส้น** หลัง bus switch, **ตัวรับส่ง RS-485** สำหรับหัววัด CO2 S88, เกตรางไฟ AO3401A, ตัวต้านทานพูลอัพ, วงจรป้องกันสาย, **อินพุตโซลาร์ 24 V และ buck สองตัว** |

Front-end เป็น **บอร์ดใหญ่ที่วางอยู่ข้าง ๆ Nucleo** ไม่ได้ซ้อนทับ และเชื่อมกันด้วย
สายสั้น ๆ เอกสารนี้กำหนดรอยต่อนั้น: ตัวขั้วต่อ, สัญญาณที่วิ่งข้าม, และวงจร front-end
ที่อยู่หลังขั้วต่อ

ทุกอย่างในเอกสารนี้คือ **ข้อตกลงที่เฟิร์มแวร์สมมติไว้แล้ว** จุดไหนที่ค่าถูกบังคับด้วยโค้ด
จะมีการอ้างอิงโค้ดกำกับ — แก้อย่างหนึ่งต้องแก้อีกอย่างตามด้วย

- ตารางขาในเฟิร์มแวร์: [`include/node_config.h`](../include/node_config.h)
- การจัดการเกตและโหมดสลีป: [`src/main.cpp`](../src/main.cpp)
- รูปแบบเฟรมที่ส่งออกอากาศ (probe → metric): [`src/lora/lora_packet.h`](../src/lora/lora_packet.h)
- คำแนะนำเรื่องความยาวสาย: [README → *Probe cable runs*](../README.md)

---

## 1. รอยต่อ — เลือกบัสแบบไหน และทำไม

ขั้วต่อโพรบ 6 ตัว ขั้วต่อสายเซนเซอร์ระยะไกล 3 เส้น ขั้วต่อหัววัด RS-485 วงจรป้องกัน buck สองตัว และอินพุตโซลาร์ 24 V
**ใส่ไม่ลง** ในขนาดบอร์ด ARDUINO 68.6 × 53.4 มม. เมื่อ front-end ต้องเป็นบอร์ดใหญ่
ของตัวเอง มันก็กลายเป็นอุปกรณ์ที่ต่อผ่านสาย ไม่ใช่อะไรที่เสียบซ้อนบน Nucleo อีกต่อไป
— และนั่นคือสิ่งที่ตัดสินคำถามเรื่องขั้วต่อ

### ข้อสรุปที่แนะนำ

**ใช้สองสาย แยกกันโดยเจตนา:**

| สาย | ส่งอะไร | ปลายฝั่ง Nucleo | ปลายฝั่ง Front-end |
|---|---|---|---|
| **สัญญาณ** | `SENS_GATE`, `DQ_Pn` 6 เส้น, `SDA`, `SCL`, `GND` 2 เส้น | **ซ็อกเก็ต IDC 2×19 ครอบเต็ม morpho CN10** | box header 2×19 แบบมีกรอบและมีคีย์ |
| **ไฟเลี้ยง** | `V3V3_MCU`, `GND` | **ซ็อกเก็ต 1×8 ครอบเต็ม ARDUINO CN6** (ต่อจริงแค่ขา 4/6/7) | ขั้ว 2 ขาแบบมีคีย์และล็อกได้ (JST-XH หรือ Micro-Fit 3.0) |

สายสัญญาณ: ระยะพิทช์ 2.54 มม. สายแพสีรุ้ง 40 เส้น ตัดเหลือ **38 เส้น** เข้าหัว IDC
แบบกดทั้งแพทั้งสองปลาย ความยาว **ไม่เกิน 30 ซม.**

### ทำไมเลือกแบบนี้ ไม่เลือกแบบอื่น

**ทำไมใช้ morpho ไม่ใช้ ARDUINO header** ขั้วต่อ ARDUINO เป็นแถวเดี่ยว 4 ชุด
(8/6/8/10) และให้ขา I/O ของ MCU มาแค่ **24 ขา** ถ้าต่อสายไปที่นั่นก็ต้องใช้ 4 สาย
และยังเข้าไม่ถึง PA8 ส่วน morpho **CN10** เป็นขั้ว 2×19 ชุดเดียวที่มีสัญญาณลอจิก
ครบทุกเส้นที่ดีไซน์นี้ต้องใช้ — สายแพเส้นเดียวจบ

**ทำไมใช้ซ็อกเก็ตยาวเต็มขั้ว ไม่ใช้ตัวสั้น** ซ็อกเก็ต IDC 2×19 ครอบ CN10 *ทั้งขั้ว*
จึงเสียบเยื้องตำแหน่งไม่ได้เลยในทางกายภาพ ในขณะที่ซ็อกเก็ต 1×10 บน ARDUINO header
หรือ 2×5 บนบางส่วนของ morpho เสียบเยื้องได้ — และการเยื้องแค่หนึ่งตำแหน่ง
จะเลื่อนสัญญาณทุกเส้นพร้อมกัน ซึ่งเป็นความผิดพลาดชนิดที่ไล่หาได้ทั้งบ่าย

**ทำไมแยกไฟออกมาเป็นอีกสาย และข้อนี้สำคัญที่สุด** ซ็อกเก็ต 2×19 บนแถวขาที่ไม่มีกรอบ
*สามารถ* ถูกกดเสียบ **กลับด้าน 180°** ได้ ถ้า `V3V3_MCU` อยู่บนสายแพเส้นนั้น
การเสียบผิดครั้งเดียวจะเอาแรงดันรางไฟไปลงขา GPIO แต่ถ้าแยกไฟไปอยู่บนสาย 2 ขา
ที่มีคีย์ของตัวเอง สิ่งที่แย่ที่สุดที่สายแพกลับด้านทำได้ก็แค่ลัด GPIO แบบ open-drain
ลงกราวด์สองสามขาและสลับสัญญาณกัน — น่ารำคาญ แก้ได้ ไม่ถึงกับบอร์ดพัง
อีกทั้งยังกันกระแสจ่ายของไฟเลี้ยงออกจากมัดสายที่มี 1-Wire แบบ bit-bang 6 เส้น

**ทำไมไม่ใช้สายจัมเปอร์ Dupont** เพราะเป็นการย้ำหัว 12 จุดแยกกัน ไม่มีล็อก ไม่มีคีย์
ทุกจุดคือความล้มเหลวหน้างานที่รอรอบร้อน-เย็นรอบแรก ถ้าจะใช้แบบนั้นตอนทดสอบก็ได้
แต่อย่าส่งของออกไปแบบนั้น

**ทำไมไม่ใช้ RS-485 หรือลิงก์แบบดิฟเฟอเรนเชียลต่อโพรบ** เพราะที่ความยาวเท่านี้ไม่จำเป็น
สายโพรบยาว **5–10 ม.** และ 1-Wire ธรรมดารับได้ถึง 10–20 ม. (Maxim **AN148**)
ส่วน MAX485 *ต่อบนสาย 1-Wire ไม่ได้เลย*
ดูหัวข้อ "Probe cable runs" ใน README เกิน ~30 ม. ค่อยขยับไปใช้ไอซีไดรเวอร์ DS2483
ไม่ใช่ไปเปลี่ยนสายระหว่างสองบอร์ดนี้

### การทำคีย์ให้สายแพสัญญาณ — ทำเถอะ แทบไม่มีต้นทุน

**CN10-6 เป็น NC บน Nucleo** ดังนั้น:

1. **ตัด (หรือถอดบัดกรี) ขา CN10-6 ออก** ขานี้ไม่ได้ต่อกับอะไรเลย —
   วัดด้วยมัลติมิเตอร์ยืนยันก่อน แล้วค่อยเอาออก
2. **อุดรูที่ตรงกันในซ็อกเก็ต IDC** ด้วยตัวอุดคีย์ที่มักแถมมากับซ็อกเก็ต IDC
   หรือหยดอีพ็อกซี

ถ้าเสียบกลับด้าน 180° รูที่อุดไว้จะไปตรงกับ **ตำแหน่ง 33 (PB12)** ซึ่ง *มีขาอยู่* —
ซ็อกเก็ตจึงเสียบไม่ลง ตัวหยุดเชิงกายภาพดีกว่าลูกศรบนซิลค์สกรีนเสมอ

สิ่งที่ควรทำเพิ่มเติม:

- **พิมพ์สามเหลี่ยมชี้ขา 1 บนซิลค์สกรีน** ที่ box header ของ front-end
  และทำเครื่องหมายว่าแถบสีแดงของสายแพ = ขา 1 ที่ปลายทั้งสองข้าง
- **ขนาดขั้วที่ต่างกัน** ป้องกันการสลับสองสายอยู่แล้ว: สายแพ 2×19 เทียบกับสายไฟ 2 ขา

```
   ┌────────────────────────────────────────────┐
   │  FRONT-END PCB (large, custom)             │
   │  J1..J6 probe terminals · Q1 gate · TVS    │   <- this spec
   │  U3 mux -> J9..J11 (3x SHT45, 5 m each)    │
   │  U4 RS-485 -> J12 (S88 CO2 head, 5 m)      │
   │  U6/U7 bucks · J14 24 V solar in           │
   │                                            │
   │   [2x19 box header, keyed]      [2-pin]    │
   └────────────┬──────────────────────┬────────┘
                │ 38-way ribbon        │ 3V3 + GND
                │ <= 30 cm             │ (keyed, latching)
   ┌────────────┴──────────────────────┴────────┐
   │  NUCLEO-WL55JC1                            │
   │  CN10 (2x19 morpho)              CN6 (1x8) │
   │  [antenna keep-out — keep the cable clear] │
   └────────────────────────────────────────────┘
```

**เชิงกล:** สายไม่ควรรับแรงใด ๆ ให้ใส่ **เสารองไนลอน M3** ที่รูยึดของบอร์ดทั้งสอง
และเพิ่ม **จุดรั้งสาย/เคเบิลไทร์** ภายในระยะ 30 มม. จากขั้วต่อแต่ละตัว ซ็อกเก็ต IDC
ที่ยึดด้วยแรงเสียดทานของหน้าสัมผัสเพียงอย่างเดียวจะคลอนหลวมจากการสั่นสะเทือน
และการขยายตัวตามอุณหภูมิ นานก่อนที่อะไรทางไฟฟ้าจะเสียเสียอีก

**เขตห้ามวางใกล้สายอากาศ:** อย่าเดินสายทั้งสองเส้นข้ามภาค RF ของ Nucleo หรือ
ขั้ว **CN12 SMA** ในดีไซน์นี้ทำได้ง่ายเพราะ front-end ไม่ได้อยู่เหนือภาควิทยุ —
แต่สายแพยาว 30 ซม. ที่พาดผ่านสายอากาศจะทำให้จูนเพี้ยน จึงต้องเดินสายอย่างตั้งใจ

---

## 2. สัญญาณที่วิ่งข้ามขั้วต่อ

**สิบแปด** สัญญาณ ตารางนี้ถือเป็นข้อตกลงตายตัว — นี่คือตัวอินเทอร์เฟซ
ตำแหน่งอื่น ๆ ทั้งหมดบน CN10 **ปล่อยไม่ต่อ** ที่ฝั่ง front-end

สังเกตสิ่งที่ *ไม่* อยู่ในตาราง: SHT45 ทั้งสามตัว **ไม่เพิ่ม** สัญญาณเลย แม้ตอนนี้
จะไปอยู่คนละที่กันสามจุดในโรงเรือน เพราะถูกแยกกันบน front-end ด้วย bus switch
ซึ่งตัวมันเองก็เป็นอุปกรณ์ I2C (§3) รอยต่อจึงไม่โตตามจำนวนเซนเซอร์

> **อะไรทำให้ข้อตกลงโตจาก 12 เป็น 18 (2026-08)** SCD41 ถูกแทนที่ด้วย
> **Senseair S88 LP** ซึ่งสื่อสารด้วย **UART/Modbus ไม่ใช่ I2C** และใช้ไฟ
> **4.5–5.25 V** จึงพา `S88_TX`/`S88_RX`/`S88_DE` เข้ามา; ไฟเลี้ยงเปลี่ยนเป็น
> **แบงก์แบตเตอรี่ 24 V จากโซลาร์** ทำให้ MCU อยู่หลัง buck และวิธีอ่านแบตเตอรี่
> ด้วย VREFINT ใช้ไม่ได้อีก จึงต้องมี `VBAT_SENSE` จากวงจรแบ่งแรงดัน; และเมื่อ
> ST-LINK ไม่ได้รับไฟโดยเจตนา ล็อกดีบักก็ต้องมีขาของตัวเอง คือ `DBG_TX`/`DBG_RX`
> **บอร์ด front-end รุ่นเก่าใช้กับรุ่นนี้ไม่ได้**

| สัญญาณ | ขา WL55 | ขั้วต่อ | ทิศทาง | คุณสมบัติทางไฟฟ้า | ถูกบังคับโดย |
|---|---|---|---|---|---|
| `V3V3_MCU` | — | **CN6-4** (`3V3`) | เข้าสู่ brain | **3.3 V ที่ผ่านการเรกูเลต** จาก buck 24 V, พีค ≤250 mA | §5 — *ไม่ใช่แบตเตอรี่อีกต่อไป* |
| `GND` (ไฟ) | — | **CN6-6/7** | — | เส้นทางกลับของไฟเลี้ยง แยกเส้นของตัวเอง | — |
| `SENS_GATE` | **PA8** | **CN10-16** | ออกจาก brain, push-pull | **LOW** = เปิดรางไฟ; Hi-Z = ปิดผ่าน 100 k | `node_config.h` `DS_PWR_*` |
| `DQ_P0` | **PA5** | **CN10-11** | สองทาง, open-drain | 1-Wire; พักเป็น **analog** ตอนสลีป | `node_config.h` `DS_PROBE_BUSES` |
| `DQ_P1` | **PA4** | **CN10-17** | สองทาง, open-drain | 1-Wire | `DS_PROBE_BUSES` |
| `DQ_P2` | **PA9** | **CN10-19** | สองทาง, open-drain | 1-Wire | `DS_PROBE_BUSES` |
| `DQ_P3` | **PC2** | **CN10-21** | สองทาง, open-drain | 1-Wire | `DS_PROBE_BUSES` |
| `DQ_P4` | **PB8** | **CN10-27** | สองทาง, open-drain | 1-Wire — **ย้ายออกจาก PC1** ซึ่งตอนนี้เป็น `S88_TX` | `DS_PROBE_BUSES` |
| `DQ_P5` | **PB10** | **CN10-25** | สองทาง, open-drain | 1-Wire | `DS_PROBE_BUSES` |
| `I2C_SDA` | **PA11** | **CN10-5** | สองทาง, open-drain | I2C @ 100 kHz; พักเป็น **analog** ตอนสลีป | `node_config.h` `I2C_SDA_PIN` |
| `I2C_SCL` | **PA12** | **CN10-3** | ออกจาก brain, open-drain | I2C @ 100 kHz | `node_config.h` `I2C_SCL_PIN` |
| `S88_TX` | **PC1** | **CN10-23** | ออกจาก brain, push-pull | LPUART1 TX, 9600 8N1 Modbus RTU → ตัวขับ RS-485 | `node_config.h` `S88_UART_*` |
| `S88_RX` | **PC0** | **CN10-14** | เข้าสู่ brain | LPUART1 RX ← ตัวรับ RS-485 | `S88_UART_*` |
| `S88_DE` | **PA7** | **CN10-15** | ออกจาก brain, push-pull | เปิดตัวขับ RS-485: HIGH ขณะส่ง, LOW ตอนอื่น | `node_config.h` `S88_DE_PIN` |
| `VBAT_SENSE` | **PB3** | **CN10-31** | เข้าสู่ brain, **analog** | แรงดันแบงก์ 24 V ที่ผ่านวงจรแบ่งแล้ว 0–3.0 V — ADC1_IN2 | `battery.cpp` |
| `DBG_TX` | **PB6** | **CN10-35** | ออกจาก brain, push-pull | USART1 TX, 115200 → เฮดเดอร์ดีบัก 3 ขา | `DEBUG_UART_*` |
| `DBG_RX` | **PB7** | **CN10-37** | เข้าสู่ brain | USART1 RX ← เฮดเดอร์ดีบัก | `DEBUG_UART_*` |
| `GND` (สัญญาณ) | — | **CN10-9**, **CN10-20** | — | เน็ตเดียวกัน (GND); ต่อ **ทั้งสองจุด** — ดู *Return เทียบกับ Guard* | — |
| `VSENS` | — | — | ภายใน front-end | ไฟ 3.3 V ที่ **ถูกสวิตช์** ไปเลี้ยงโพรบ, สาย SHT45 ทั้งสามเส้น, mux **และ** พูลอัพทั้งหมด | `main.cpp` `gate_on()` |
| `V5_S88` | — | — | ภายใน front-end | ไฟ 5.1 V **ที่ไม่ถูกสวิตช์** ไปยังหัววัด S88 — ทำงานตลอดเวลา | §5 |

**ตัวเลขกระแสพีคเปลี่ยนไปพร้อมกับเซนเซอร์ CO2** ตอนนี้คือ **~150 mA ของ LoRa TX**
เพราะ S88 LP ไม่ได้ใช้รางไฟนี้ร่วมด้วยแล้ว — มันอยู่บนเอาต์พุต buck 5.1 V ที่ไม่ถูก
สวิตช์ของตัวเอง (§5) และกระแสพีค 300 mA ของมันถูกดึงจากที่นั่น ไม่ใช่จาก
`V3V3_MCU` ส่วนโพรบทั้งหกเพิ่มอีกราว 9 mA ตอนแปลงค่า ให้ออกแบบ `V3V3_MCU`
ตามภาควิทยุ ไม่ใช่ตามเซนเซอร์

> **`VBAT_SENSE` เป็นสายอนาล็อกเส้นเดียวในสายแพ** อยู่ที่ CN10-31 ระหว่าง LED3
> (CN10-30 ปล่อยว่าง) กับ AGND (CN10-32 ปล่อยว่าง) ซึ่งเป็นย่านที่เงียบที่สุดบน
> ขั้วต่อ นี่คือเหตุผลที่มันไปอยู่ตรงนั้น ไม่ใช่ขาว่างข้าง ๆ สาย 1-Wire ที่ถูก
> bit-bang ให้กรองสัญญาณที่ฝั่ง front-end (ดู §5) และสุ่มอ่านตอนที่โพรบว่างอยู่

`VSENS` ถูกสร้างขึ้น **บน front-end** และไม่เคยวิ่งย้อนกลับไปที่ Nucleo
ไฟฟ้าที่ข้ามรอยต่อมีเพียง `V3V3_MCU` กับกราวด์ของมัน บนสายของตัวเองเท่านั้น
ทั้ง buck สองตัวและอินพุต 24 V ที่เลี้ยงมันอยู่บน front-end ทั้งหมด

### กฎสองข้อที่ front-end ต้องทำตาม

**1. ตัวพูลอัพต้องต่อกับ `VSENS` ห้ามต่อกับ 3V3 ที่จ่ายตลอดเวลา** ซึ่งตอนนี้มี
**สิบสี่ตัว** — 1-Wire หกตัว, คู่ I2C ฝั่งต้นทางหนึ่งคู่ และอีกหนึ่งคู่ต่อช่อง mux (§3)
ถ้าไปอยู่บนรางที่จ่ายตลอด อุปกรณ์ที่ถูกตัดไฟ
แต่ละตัวจะกลายเป็นเส้นทางกระแสรั่วผ่านไดโอดแคลมป์ของมัน แล้วรอบการทำงานทุก 15 นาที
ก็จะไม่มีความหมายอีกต่อไป ฟังก์ชัน `sensor_pins_park()` ใน `main.cpp`
พักขาทั้งหมดนั้นเป็น analog ด้วยเหตุผลเดียวกัน — บอร์ดต้องให้ความร่วมมือด้วย

**2. `SENS_GATE` เป็นแบบ active-low พร้อมพูลอัพ 100 k จากเกตไปซอร์ส**
ตัวต้านทานนี้ไม่ใช่ของเสริม: มันคือสิ่งที่กด **ปิด** รางไฟเซนเซอร์ไว้ขณะที่ PA8 เป็น Hi-Z
— ทั้งตอนรีเซ็ต ตอน BOOT0 และก่อนที่เฟิร์มแวร์จะเริ่มทำงาน

### ทำไมต้องเป็นขาเหล่านี้

**ตำแหน่งโพรบถูกเลือกจากความใกล้เคียงกันในสายแพ ไม่ใช่จากความสะดวก**
สาย 1-Wire แบบ bit-bang open-drain หกเส้นที่อยู่ในสายแพเส้นเดียวกัน คือปัญหา
signal integrity ที่แท้จริงเพียงข้อเดียวของดีไซน์นี้ ในสายแพ IDC มาตรฐาน
เส้นที่ *n* จะไปลงขาที่ *n* ดังนั้นสัญญาณที่ตำแหน่ง *p* จะถูกขนาบในสายด้วยตำแหน่ง
*p−1* และ *p+1* ขากราวด์ของ CN10 ถูกกำหนดมาตายตัวโดยบอร์ด — เพิ่มเองไม่ได้ —
สาย DQ ทั้งหกจึงถูกวางให้อยู่ติดตำแหน่ง **GND** หรือ **NC** เท่าที่ทำได้

```
   Conductor n of the ribbon lands on CN10 pin n, so a line's cable
   neighbours are simply pins n-1 and n+1:

   CN10 pin :    9   10   11   12   13   14   15   16   17   18   19   20   21   22   23   24   25   26
   carries  :  GND  [g]   P0    -    -    -    - GATE   P1  [g]   P2  GND   P3    -   P4  [g]   P5    -

   Every DQ line touches a GND (9, 20) or a guard [g] (10, 18, 24).
```

รายละเอียดเต็ม:

| โพรบ | ขา | CN10 | เพื่อนบ้านด้านล่าง | เพื่อนบ้านด้านบน |
|---|---|---:|---|---|
| `DQ_P0` | PA5 | 11 | **10 = NC** (guard) | 12 = PC6, ไม่ต่อ |
| `DQ_P1` | PA4 | 17 | 16 = `SENS_GATE` (ไฟ DC นิ่ง) | **18 = NC** (guard) |
| `DQ_P2` | PA9 | 19 | **18 = NC** (guard) | **20 = GND** ✅ |
| `DQ_P3` | PC2 | 21 | **20 = GND** ✅ | 22 = PB0, ไม่ต่อ |
| `DQ_P4` | PC1 | 23 | 22 = PB0, ไม่ต่อ | **24 = NC** (guard) |
| `DQ_P5` | PB10 | 25 | **24 = NC** (guard) | 26 = PB9, ไม่ต่อ |

`SENS_GATE` ที่ CN10-16 เป็นเพื่อนบ้านที่ไม่ก่อกวนสำหรับ `DQ_P1` โดยเจตนา:
มันเปลี่ยนสถานะแค่สองครั้งต่อการตื่นหนึ่งรอบ (15 นาที) นอกนั้นเป็นระดับ DC นิ่ง ๆ

#### Return เทียบกับ Guard

สองอย่างนี้ทำหน้าที่คนละแบบ และสายแพเส้นเดียวกันมีทั้งสองอย่าง
จึงควรระบุให้ชัดว่าเส้นไหนทำหน้าที่อะไร

**Return** คือ GND ธรรมดา ที่ต่อ **ทั้งสองปลาย** กระแสสัญญาณไม่ได้หายไปในขาปลายทาง
— มันไหลกลับ และไหลกลับตามเส้นกราวด์ที่ใกล้ที่สุด ถ้าให้เส้นกลับที่อยู่ใกล้
ลูปไป-กลับจะเล็ก ซึ่งคือสิ่งที่กันไม่ให้สาย bit-bang หกเส้นรบกวนกันเอง
ถ้าเส้นกลับอยู่ไกล ลูปจะใหญ่ และกลายเป็นสายอากาศทั้งรับและส่ง

CN10 มีตำแหน่ง GND ที่ใช้ได้เพียงสองจุดคือ **CN10-9** และ **CN10-20**
และทั้งสอง **เป็นเน็ตเดียวกัน** — ไม่มีกราวด์ "A" กับ "B" ที่นี่ มีกราวด์เดียว
แต่เข้าถึงได้สองจุด ให้ต่อทั้งคู่ ตำแหน่งของมันอยู่ในจุดที่ได้ประโยชน์สูงสุด:
CN10-9 ดูแลคู่ I2C และ `DQ_P0` ที่ปลายล่าง ส่วน CN10-20 อยู่กลางกลุ่มโพรบพอดี
(CN10-32 คือ **AGND** และใช้แทนกันไม่ได้ — การดันกระแสกลับฝั่งดิจิทัลผ่านกราวด์
อนาล็อกคือวิธีทำให้ `battery_read_mv()` เพี้ยน)

**Guard** เป็นคนละเรื่อง: ตำแหน่ง **6, 10, 18, 24 และ 34 ของ CN10 เป็น NC** บน Nucleo
เส้นเหล่านั้นจึงไม่ได้ต่อกับอะไรเลยที่ฝั่ง brain และสามารถผูกลง GND
**ที่ปลายฝั่ง front-end เท่านั้น** เมื่อกราวด์แค่ปลายเดียว เส้นนั้นจะนำกระแสกลับไม่ได้เลย
— มันทำงานเชิงประจุ เป็นฉากกั้นระหว่างเพื่อนบ้านสองข้าง มีประโยชน์ ได้มาฟรี
แต่ใช้แทน return จริงไม่ได้

| | กราวด์ที่ | นำกระแสกลับหรือไม่ | หน้าที่ |
|---|---|---|---|
| **Return** (CN10-9, CN10-20) | ทั้งสองปลาย | ใช่ | ทำให้ลูปกระแสเล็ก |
| **Guard** (CN10-6/10/18/24/34) | ฝั่ง front-end เท่านั้น | ไม่ | ฉากกั้นเชิงประจุระหว่างเพื่อนบ้าน |

> วัดด้วยมัลติมิเตอร์ยืนยันว่าตำแหน่ง NC เหล่านั้นเปิดวงจรจริงบนบอร์ด *ของคุณ*
> ก่อนจะต่อลงกราวด์ ในตาราง Table 18 ของ UM2592 ระบุว่าเป็น NC แต่การต่อกราวด์
> ลงตำแหน่งที่กลายเป็น GPIO คือการลัดวงจร

#### ในแผนผังวงจร ต้องเขียนอะไรลงบน J7

ทั้ง 38 ตำแหน่งต้องมีการตัดสินใจอย่างตั้งใจ และ "ต่อกราวด์ให้ขาว่างเพื่อความเรียบร้อย"
เป็นคำตอบที่ **ผิด** สำหรับ 22 ตำแหน่ง แบ่งเป็นสี่กลุ่ม:

| ตำแหน่ง | จำนวน | เขียนอะไร | เหตุผล |
|---|---:|---|---|
| 3, 5, 9, 11, 16, 17, 19, 20, 21, 23, 25 | 11 | **ชื่อเน็ต** | สัญญาณตามข้อตกลง (§2) รวมทั้ง GND return ทั้งสอง |
| 6, 10, 18, 24, 34 | 5 | **GND** | เป็น NC บน Nucleo การต่อกราวด์ที่ปลายนี้จึงปลอดภัย และได้ guard เชิงประจุมาด้วย |
| 1, 12, 13, 14, 15, 26, 27, 28, 29, 30, 31, 33, 36 | 13 | **ธง no-connect** | เป็นขา MCU จริงที่เราไม่ใช้ ปล่อยลอยไว้ |
| 2, 4, 7, 8, 22, 32, 35, 37, 38 | 9 | **ธง no-connect** | RF switch, TCXO, AVDD, AGND, VCP, 5V_USB_CHGR — ต่อกราวด์ตัวใดตัวหนึ่งคือทำบอร์ดพัง |

**ห้ามต่อกราวด์ให้ขา MCU ที่ไม่ได้ใช้เด็ดขาด** เพราะมันคือ GPIO:
ถ้าเฟิร์มแวร์สั่งให้ขานั้นเป็น push-pull ระดับสูงเมื่อไร ก็คือการลัดวงจรทันที
และตำแหน่ง 26/28/30 คือ LED ของผู้ใช้ ซึ่งจะกินกระแสตลอดเวลา
การปล่อยลอยคือคำตอบที่ถูก เพราะขาเหล่านั้นถูกตั้งค่าและเป็นของ Nucleo ไม่ใช่ของบอร์ดนี้

**ห้ามแตะกลุ่ม ⛔ ไม่ว่ากรณีใด รวมถึงการต่อกราวด์** การต่อกราวด์ที่ CN10-7 (`AVDD`)
คือการลัดแรงดันอ้างอิงของ ADC แล้ว `battery_read_mv()` จะไม่มีความหมายอีกต่อไป;
CN10-22 (`PB0`) คือไฟเลี้ยง TCXO ของภาควิทยุ; CN10-2/4/38 คือขาควบคุม RF switch;
CN10-32 คือ `AGND` ซึ่งเป็นกราวด์คนละตัวและต้องไม่นำกระแสกลับของสายแพเส้นนี้

**ใช้ธง no-connect ให้ชัดเจน อย่าปล่อยขาว่างเปล่า ๆ** ใน KiCad หรือ Altium
ขาที่ลืมต่อกับขาที่ตั้งใจไม่ต่อ หน้าตาเหมือนกันบนแผ่นแบบ มีแต่ธงเท่านั้นที่บันทึกเจตนา
และยังทำให้ ERC เงียบ เพื่อที่การลืมต่อ *จริง ๆ* จะโผล่มาเป็น error
แทนที่จะจมอยู่ในคำเตือน 22 อันที่คุณฝึกตัวเองให้มองข้ามไปแล้ว

> ตำแหน่งที่ต้องตรวจซ้ำก่อนสั่งผลิตคือตำแหน่ง **6** เพราะมันคือคีย์ (§1):
> ขาของมันถูกตัดออกที่ฝั่ง Nucleo และรูของมันถูกอุดในซ็อกเก็ต ดังนั้นเส้นนี้ตายที่ฝั่ง
> brain อยู่แล้วไม่ว่าทางใด — ซึ่งเป็นเหตุผลว่าทำไมจึงปลอดภัยที่จะต่อกราวด์ที่ฝั่งนี้
> ให้วัดยืนยันว่า 6, 10, 18, 24 และ 34 เปิดวงจรจริงบนบอร์ด *ของคุณ* ก่อนต่อกราวด์;
> การต่อกราวด์ลงตำแหน่งที่กลายเป็น GPIO คือการลัดวงจร

**`SENS_GATE` คือ PA8** (CN10-16) มันอยู่ในกลุ่ม DQ พอดี เกตกับสายที่มันจ่ายไฟให้
จึงเดินทางไปในสายแพเส้นเดียวกัน; ฟังก์ชันสำรองของขานี้ไม่ได้ถูกใช้ในดีไซน์นี้;
และ STM32WL ไม่มี boot strap ที่ขานี้ (BOOT0 คือ PH3 ส่วน nBOOT1 เป็น option byte)
มันจึงรีเซ็ตมาเป็นอินพุตลอย — ซึ่งตรงกับที่พูลอัพเกต 100 k ต้องการพอดี
เพื่อกดรางไฟให้ปิดไว้ก่อนเฟิร์มแวร์เริ่มทำงาน

**PA10 ถูกเว้นไม่ใช้โดยเจตนา** แม้จะเป็นขา 1-Wire ที่ดีมากก็ตาม เพราะมันอยู่บน
**CN7** ไม่ใช่ CN10 และสายเส้นเดียวไม่คุ้มกับการเพิ่มสายแพสัญญาณอีกเส้น

**I2C อยู่ที่ PA11/PA12** (CN10-5 / CN10-3) ทางเลือกอื่นแย่กว่า: I2C1 คือ PA9/PA10
(PA9 เป็นโพรบไปแล้ว) และ I2C3 คือ PB10/PB11 (PB10 เป็นโพรบ ส่วน PB11 คือ **LED3**
ของ Nucleo ซึ่งจะไปคร่อมอยู่บน SDA และกินกระแสทุกครั้งที่รับส่งข้อมูล)

> **มีป้ายชื่อหนึ่งจุดที่ต้องตรวจสอบ** Table 17 ของ UM2592 เรียก PA11/PA12 ว่า
> `I2C1_SDA`/`I2C1_SCL` แต่ไฟล์ `PeripheralPins.c` ของ STM32duino ซึ่งเป็นของ ST เอง
> และนิยามบอร์ดของ Zephyr ต่างระบุว่าเป็น **I2C2** เฟิร์มแวร์ไม่ได้รับผลกระทบทั้งสองทาง
> — STM32duino หาอินสแตนซ์จากตารางขา ไม่ใช่จากชื่อ — แต่ถ้าต้องรู้อินสแตนซ์จริง
> เพื่อพอร์ตแบบ bare-HAL ให้ไปดูตาราง alternate-function ของ RM0453
> แทนที่จะเชื่อแหล่งใดแหล่งหนึ่ง

> **SCL อยู่ระหว่างสายควบคุม RF switch ทั้งสองเส้นพอดี** (CN10-2 `PC4` และ
> CN10-4 `PC5`) ซึ่งเส้นเหล่านั้นเป็นปลายเปิดที่ฝั่ง front-end
> ที่ยอมรับได้ก็เพราะการแยกกัน *ในเชิงเวลา* เท่านั้น: เฟิร์มแวร์อ่านเซนเซอร์ทุกตัว
> ปิดรางไฟ แล้วจึงค่อยจ่ายไฟให้ภาควิทยุ บัส I2C จึงไม่เคยทำงานขณะที่สายเหล่านั้นสวิตช์
> **ห้ามสลับลำดับนี้ใน `main.cpp`** ถ้าวันหนึ่งจำเป็นต้องใช้ I2C พร้อมกับการส่งวิทยุ
> ให้กรีดแยกเส้นที่ 1–4 ออกจากสายแพ

### ผังตำแหน่งขา morpho CN10

นี่คือภาพที่ควรถือไว้ข้างบอร์ดขณะเดินสายขั้ว front-end — เป็นข้อมูลชุดเดียวกับ
ตารางด้านล่าง เพียงแต่จัดวางตามตำแหน่งจริงของขั้วต่อ

คำอธิบายสัญลักษณ์: `[+]` = front-end ต่อสายเส้นนี้ · `[K]` = คีย์ (ตัดขา อุดรูซ็อกเก็ต) ·
`[g]` = guard (ต่อ GND ที่ฝั่ง front-end เท่านั้น ห้ามที่ฝั่ง Nucleo) ·
`[X]` = ห้ามต่อ · `[!]` = ใช้ได้ แต่ให้อ่านหมายเหตุ · (ว่าง) = ปล่อยเส้นลอยที่ฝั่ง front-end

```
                  CN10 - 2x19 morpho, 2.54 mm
        Nucleo component side up. Odd pins are one row, even the other.
        Confirm pin 1 against the board's own silkscreen before wiring --
        this drawing fixes the ORDER, not which end of the board it starts.

        [+] front-end wires it      [K] key: clip pin, plug socket hole
        [g] guard: GND at the FRONT-END end only, never at the Nucleo
        [X] do NOT connect          [!] usable, but read the note
            (blank) leave the conductor floating at the front-end

   front-end                MCU     odd  even MCU     front-end
   ------------------------ ------- ---- ---- ------- ------------------------
       B1 button            PA0       1 o  o 2   PC4     [X] RF FE_CTRL1
   [+] I2C_SCL              PA12      3 o  o 4   PC5     [X] RF FE_CTRL2
   [+] I2C_SDA              PA11      5 o  o 6   NC      [K] KEY - clip this pin
   [X] VREF+ - do not load  AVDD      7 o  o 8   5V_USB_CHGR
   [+] GND return 1 of 2    GND       9 o  o 10  NC      [g] guard
   [+] DQ_P0                PA5      11 o  o 12  PC6         B3 button
       spare                PA6      13 o  o 14  PC0         spare
       spare                PA7      15 o  o 16  PA8     [+] SENS_GATE
   [+] DQ_P1                PA4      17 o  o 18  NC      [g] guard
   [+] DQ_P2                PA9      19 o  o 20  GND     [+] GND return 2 of 2
   [+] DQ_P3                PC2      21 o  o 22  PB0     [X] VDD_TCXO
   [+] DQ_P4                PC1      23 o  o 24  NC      [g] guard
   [+] DQ_P5                PB10     25 o  o 26  PB9         LED2
       spare                PB8      27 o  o 28  PB15        LED1
       spare                PB5      29 o  o 30  PB11        LED3
   [!] also TRACESWO        PB3      31 o  o 32  AGND    [X] not a signal return
       spare                PB12     33 o  o 34  NC      [g] guard
   [X] VCP TX               PB6/PA2  35 o  o 36  PA1         B2 button
   [X] VCP RX               PB7/PA3  37 o  o 38  PC3     [X] RF FE_CTRL3
```

### ตารางขา morpho CN10

ถอดความจาก **UM2592 Rev 1, Table 18** และตรวจสอบซ้ำกับไฟล์ PDF ด้วยสคริปต์
ขั้ว morpho ทั้งสองเป็นแบบ 2×19 ระยะ 2.54 มม.; ขาเลขคี่อยู่แถวหนึ่ง ขาเลขคู่อยู่อีกแถว
สัญญาณที่โหนดนี้ใช้จะเป็น **ตัวหนา** ✅; เครื่องหมาย ⛔ คือตำแหน่งที่ front-end
ต้องไม่ต่อ ส่วนตาราง CN7 อยู่ใน [ภาคผนวก A](#ภาคผนวก-a--st-morpho-cn7-ไม่ได้ใช้กับสายสัญญาณ)

| คี่ | ชื่อ | การใช้งาน | คู่ | ชื่อ | การใช้งาน |
|----:|---|---|---:|---|---|
| 1 | PA0 | ปุ่ม B1 — ปล่อยว่าง | 2  | PC4 | ⛔ RF switch FE_CTRL1 |
| 3 | **PA12**  | ✅ `I2C_SCL` | 4 | PC5 | ⛔ RF switch FE_CTRL2 |
| 5 | **PA11**  | ✅ `I2C_SDA` | 6 | NC | 🔑 **คีย์: ตัดขานี้** |
| 7 | AVDD | ⛔ VREF+ — ห้ามโหลด | 8 | 5V_USB_CHGR | ปล่อยว่าง |
| 9 | **GND** | ✅ GND return 1 จาก 2 | 10 | NC | guard (GND ที่ฝั่ง front-end เท่านั้น) |
| 11  | **PA5** | ✅ `DQ_P0` | 12 | PC6 | ปุ่ม B3 — ปล่อยว่าง |
| 13  | PA6 | สำรอง | 14 | **PC0** | ✅ `S88_RX` (LPUART1 RX) |
| 15  | **PA7** | ✅ `S88_DE` (ทิศทาง RS-485) | 16 | **PA8** | ✅ `SENS_GATE` |
| 17  | **PA4** | ✅ `DQ_P1` | 18 | NC | guard (GND ที่ฝั่ง front-end เท่านั้น) |
| 19  | **PA9** | ✅ `DQ_P2` | 20 | **GND** | ✅ GND return 2 จาก 2 |
| 21  | **PC2** | ✅ `DQ_P3` | 22 | PB0 | ⛔ VDD_TCXO |
| 23  | **PC1** | ✅ `S88_TX` (LPUART1 TX) | 24 | NC | guard (GND ที่ฝั่ง front-end เท่านั้น) |
| 25  | **PB10**  | ✅ `DQ_P5` | 26 | PB9 | LED2 — ปล่อยว่าง |
| 27  | **PB8** | ✅ `DQ_P4` (ย้ายจาก PC1) | 28 | PB15  | LED1 — ปล่อยว่าง |
| 29  | PB5 | สำรอง | 30 | PB11 | LED3 — ปล่อยว่าง |
| 31  | **PB3** | ✅ `VBAT_SENSE` (ADC1_IN2) | 32 | AGND | ⛔ กราวด์อนาล็อก ไม่ใช่เส้นกลับสัญญาณ |
| 33  | PB12 | สำรอง (ช่วยกันซ็อกเก็ตกลับด้าน) | 34 | NC | guard (GND ที่ฝั่ง front-end เท่านั้น) |
| 35  | **PB6** | ✅ `DBG_TX` (USART1 TX) | 36 | PA1 | ปุ่ม B2 — ปล่อยว่าง |
| 37  | **PB7** | ✅ `DBG_RX` (USART1 RX) | 38 | PC3 | ⛔ RF switch FE_CTRL3 |

> **ข้อผิดพลาดในเอกสารต้นทาง** UM2592 Rev 1 พิมพ์ขา CN10 ตำแหน่ง 37 ว่า "PB6 / PA3"
> แต่ที่ถูกคือ **PB7 / PA3** เพราะ PB6 อยู่ที่ขา 35 ไปแล้ว และ PB7 ไม่ปรากฏที่อื่นเลย
> ในตารางที่คำนำของมันเองระบุว่ามี I/O ของ MCU *ครบทุกขา* บน morpho อีกทั้งหมายเหตุ
> เหนือตารางนั้นก็ระบุว่า D0/D1 คือ USART1 บน **PB6 และ PB7** ไฟล์ variant ของ
> STM32duino ซึ่งเป็นของ ST เองก็ตรงกัน (`D0 = PB7` และ `PA3` "อาจอยู่ที่ D0")
> ตารางด้านบนใช้ค่าที่แก้ไขแล้ว

ยังเหลือขา I/O สำรองอีกสามขา (**PA6, PB5, PB12**) เผื่องานรุ่นถัดไปต้องใช้ —
และ **ไม่มีขาไหนทำ ADC ได้เลย** `PinMap_ADC` วาง ADC1 ไว้ที่ PA10–PA15, PB1–PB4,
PB13, PB14 ซึ่งในจำนวนนั้นมีเพียง **PB3** ที่อยู่บน CN10 และยังไม่ถูกใช้
(PA11/PA12 คือคู่ I2C, PA13/PA14 คือ SWD, ที่เหลืออยู่บน CN7 หรือไม่ได้ต่อออกมา)
นั่นคือเหตุผลที่ `VBAT_SENSE` ต้องไปอยู่ที่ PB3 และเหตุผลที่ **ไม่มีอินพุตอนาล็อก
เหลืออีกแล้ว** ถ้ารุ่นถัดไปต้องการอีกหนึ่งช่อง ต้องไปเอาจาก CN7

### ห้ามเดินสายไปที่ขาเหล่านี้

ทุกตำแหน่งต่อไปนี้เข้าถึงได้จริงบน CN10 ดังนั้น front-end ต้องหลีกเลี่ยงมันด้วยเจตนา
ไม่ใช่ด้วยข้อจำกัดทางกายภาพ:

| ตำแหน่ง | สัญญาณ | เหตุผล |
|---|---|--- |
| CN10-2, -4, -38 | PC4, PC5, PC3 | **RF switch** FE_CTRL1/2/3 — ภาควิทยุเป็นเจ้าของ |
| CN10-22 | PB0 | **VDD_TCXO** — ไฟเลี้ยงตัวอ้างอิงของภาควิทยุ |
| ~~CN10-35, -37~~  | PB6, PB7 | **ใช้แล้ว** — `DBG_TX`/`DBG_RX`; ดูหมายเหตุด้านล่าง |
| CN10-7 | AVDD / VREF+ | **แรงดันอ้างอิง** การโหลดขานี้ทำให้ `battery_read_mv()` เพี้ยน |
| CN10-32 | AGND | กราวด์อนาล็อก — ห้ามใช้เป็นเส้นกลับสัญญาณ |
| ~~CN10-31~~ | PB3 | **ใช้แล้ว** — `VBAT_SENSE` เสียแค่ TRACESWO เท่านั้น |
| CN10-1, -36, -12  | PA0, PA1, PC6 | ปุ่มผู้ใช้ B1/B2/B3 — มีสวิตช์ + พูลอัพติดตั้งอยู่แล้ว |
| CN10-26, -28, -30 | PB9, PB15, PB11  | LED ผู้ใช้ — LED คร่อมสาย 1-Wire ทำให้ใช้ไม่ได้ |
| CN7-13/15 | PA13, PA14 | **SWD** — เว้นไว้ให้ดีบักเกอร์ |

SWD ที่ CN7-13/15 เข้าถึงได้ ดังนั้น front-end จะเดินสายดีบักออกไปยัง test header
ก็ได้ถ้าต้องการ — เพียงแต่อย่าเดินผ่านสายแพ CN10

> **ทำไม CN10-35/37 ถึงเลิกเป็นขาต้องห้าม** เดิมมันเป็น ⛔ เพราะเข้าใจว่าเป็น
> ST-LINK VCP ซึ่งไม่จริง: **PA2/PA3 ไม่ได้ออกมาที่ morpho เลย** (ดูภาคผนวก A —
> ไม่มีอยู่ใน CN7) และทั้งหมายเหตุของ UM2592 เองกับไฟล์ variant ของ STM32duino
> ต่างระบุว่า **D0/D1 = USART1 บน PB6/PB7** ที่ตำแหน่งเหล่านั้น ส่วน `/PA2`, `/PA3`
> ในตาราง 18 คือ *ทางเลือกผ่าน solder bridge* ไม่ใช่ค่าเริ่มต้น และเมื่อ §5
> จ่ายไฟ `3V3` เข้าที่ CN6-4 โดยตรง ST-LINK จึง **ไม่ได้รับไฟโดยเจตนา** —
> "ฟีเจอร์โปรแกรมและดีบักใช้ไม่ได้ เพราะ ST-LINK ไม่ได้รับไฟ" — VCP จึงใช้งาน
> หน้างานไม่ได้อยู่แล้ว ล็อกดีบักจึงใช้ PB6/PB7 ออกไปที่เฮดเดอร์ 3 ขาของตัวเอง
> แล้วต่อ USB-serial adapter เอา **ให้ตรวจสอบ solder bridge บนบอร์ดจริงก่อนออกแบบ
> PCB** — นี่เป็นจุดเดียวในเอกสารนี้ที่อ้างอิงค่าเริ่มต้นของ bridge แทนการวัดจริง

> **ข้อควรระวัง รูปแบบเดียวกับกรณี SCL** `DBG_RX` ที่ CN10-37 อยู่ติดกับ
> **CN10-38 = PC3** (RF switch FE_CTRL3) ต่างจากกรณี I2C ตรงที่ดีบัก UART *อาจ*
> ทำงานขณะภาควิทยุสวิตช์ เพราะการล็อกเกิดระหว่าง TX มันคือ 115200 baud เทียบกับ
> สายควบคุมที่ช้ามาก ความเสี่ยงจึงต่ำ — แต่อย่าย้ายอะไรที่เร็วกว่านี้มาไว้ที่
> CN10-37 และถ้าเห็นไบต์ล็อกเพี้ยนเฉพาะตอนส่งอัปลิงก์ นี่คือสาเหตุ

### จุดต่อไฟที่ CN6

| ขา | ชื่อ | การใช้งาน |
|----:|---|-----|
| 1 | NC | — |
| 2 | IOREF | — |
| 3 | NRST | — |
| 4 | **3V3** | ✅ **ไฟ 3.3 V จาก buck เข้า** |
| 5 | 5V | — |
| 6 | **GND** | ✅ เส้นกลับของไฟเลี้ยง |
| 7 | **GND** | ✅ เส้นกลับของไฟเลี้ยง |
| 8 | VIN | อินพุต 7–12 V, ไม่ได้ใช้ |

ให้ใช้ **ซ็อกเก็ต 1×8 ครอบเต็มขั้ว** โดยต่อสายจริงเฉพาะตำแหน่ง 4, 6 และ 7
ซ็อกเก็ตที่สั้นกว่าจะเลื่อนไปตามแถวได้ และอาจเอา `V3V3_MCU` ไปลงที่ `NRST` หรือ `5V`
ส่วนตัวที่ยาวเต็มขั้วทำแบบนั้นไม่ได้ `CN7-16` เป็นเน็ต 3V3 เดียวกันถ้าอยากจ่ายไฟ
จากฝั่ง morpho แทน — แต่ก็ต้องใช้ซ็อกเก็ตยาวเต็มขั้วเช่นกัน มิฉะนั้นก็กลับไปเจอ
ขั้วต่อที่เลื่อนได้อีก

---

## 3. วงจร front-end ของเซนเซอร์

มีสองโดเมนการวัดที่เป็นอิสระต่อกันแต่ใช้รางไฟที่ถูกสวิตช์ร่วมกัน: **โพรบ 1-Wire**
(อยู่นอกบอร์ด บนสาย) และ **เซนเซอร์อากาศ I2C** (อยู่บนบอร์ด) ทั้งสองไม่มีอะไร
เกี่ยวข้องกันทางไฟฟ้าเลยนอกจาก `VSENS` และ GND

### โพรบ 1-Wire — หกช่องเหมือนกันทุกประการ

หนึ่งสายต่อหนึ่งโพรบแบบจุดต่อจุด **ไม่ใช้บัสร่วม** และนี่คือการตัดสินใจเชิงออกแบบ
ไม่ใช่อุบัติเหตุทางประวัติศาสตร์:

- มันคือสิ่งที่ทำให้ **SKIP ROM** ของไดรเวอร์ถูกต้องตามหลัก — ไม่ต้องค้นหา ROM
  ไม่ต้องจดรหัส ROM ไม่มีปัญหา "แอดเดรสไหนคือโพรบขาเข้า" ตัวตนของโพรบคือ
  "เสียบอยู่ที่ขั้วไหน" เท่านั้น
- ทั้งหกตัวแปลงค่า **พร้อมกัน**: `main.cpp` สั่งเริ่มแปลงทุกตัว รอครั้งเดียว แล้วค่อยอ่าน
  โพรบหกตัวใช้เวลาแปลง 750 มิลลิวินาทีครั้งเดียว ไม่ใช่หกครั้ง
- **โพรบที่ลัดวงจรหรือน้ำเข้าจะพังแค่ตัวเอง** ถ้าอยู่บนบัสร่วม มันจะลากอีกห้าตัวไปด้วย
  — ซึ่งเมื่ออยู่บนเสากลางทุ่ง นั่นคือความต่างระหว่าง "ค่าเสียหนึ่งตัว" กับ "โหนดตายทั้งตัว"

ต้นทุนคือขา 6 ขา (เหลือว่างอยู่ 15 ขา) และชุดอุปกรณ์พาสซีฟ 6 ชุด — สามชิ้นต่อช่อง
บน PCB และอีกหนึ่งชิ้นที่ตัวโพรบ

เขียนเป็นรายการการเชื่อมต่อ (connection list) เพราะแผนผัง ASCII ของวงจรนี้
ลงเอยด้วยการลากขาของตัวเก็บประจุ 100 nF ตัดผ่านสาย DQ เสมอ ซึ่งอ่านแล้วเหมือน
เป็นจุดต่อทั้งที่ไม่ใช่:

```
   ONE channel, n = 0..5.  Repeat SIX times.
   "DQ node" is the front-end net between the series resistor and the connector.

   ON THE FRONT-END PCB
     VSENS      --[4.7k]--   DQ node        pull-up, on the SWITCHED rail
     MCU DQ_Pn  --[100R]--   DQ node        series damping
     DQ node    --[TVS ]--   GND            bidirectional, <50 pF

   ACROSS THE CABLE   (3 conductors; DQ twisted with GND)
     VSENS      -----------  probe V   (VDD)
     DQ node    -----------  probe DQ  (data)
     GND        -----------  probe G   (GND)

   AT THE PROBE  (far end of the cable)
     probe V    --[100nF]--  probe G        <-- VDD to GND.
                                                NOT to DQ. See below.
```

**ต่อหนึ่งช่องคือสามชิ้นบน PCB และหนึ่งชิ้นที่โพรบ:** พูลอัพ 4.7 kΩ หนึ่งตัว
ตัวต้านทานอนุกรม 100 Ω หนึ่งตัว และ TVS หนึ่งตัวบนบอร์ด บวกกับ **100 nF หนึ่งตัว
ที่ปลายไกลของสาย คร่อมขา VDD และ GND ของโพรบตัวนั้น**

> **100 nF ไม่เคยแตะสาย DQ และถ้าเอาไปต่อตรงนั้นบัสจะตายสนิท ไม่ใช่แค่แย่ลง**
> 100 nF เทียบกับพูลอัพ 4.7 kΩ ให้ค่า RC เท่ากับ **470 µs** แต่ช่วงอ่านของ 1-Wire
> ต้องการให้สายกลับขึ้นสูงภายในราว **9 µs** หลังปล่อย ซึ่ง ณ จุดนั้นแรงดันจะขึ้นไปได้
> เพียง **2 % ของ VDD**; แม้แต่หน้าต่างตรวจ presence ที่ 70 µs ของสัญญาณรีเซ็ต 480 µs
> ก็ขึ้นได้แค่ 14 % จะไม่มีอะไรตอบกลับเลย เทียบให้เห็นภาพ: เอกสารนี้จำกัด *TVS*
> บนโหนดเดียวกันไว้ที่ **< 50 pF** — 100 nF คือ **2000 เท่า** ของงบนั้น
> ค่าคาปาซิแตนซ์เดียวที่ DQ ยอมให้มีได้คือสิ่งที่สายเคเบิลพามาอย่างหลีกเลี่ยงไม่ได้
> ที่ระยะ **5–10 ม.** ค่านั้นคือ **250–530 pF** ซึ่งพูลอัพ 4.7 kΩ ดันขึ้นถึงระดับสูง
> ที่ถูกต้องได้ใน **1.6–3.0 µs** — อยู่ในงบ 9 µs โดยมีระยะเผื่อ 3 เท่า
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
