wsarachai/smartfarm/water-temp-node/docs/hardware-interface-s88.md

# water-temp-node — hardware interface spec

> ⚠ **SUPERSEDED — 2026-09.** This is the **Senseair S88 revision**: CO2 over
> Modbus/RS-485 on an ungated 5 V rail. Kept verbatim because it is a complete,
> costed design and because the S88 GH remains the fallback if the CO2 range
> requirement ever widens past the SCD41's specified 400–5000 ppm.
> The current spec is [`hardware-interface.md`](hardware-interface.md), whose
> revision 2.0 replaces the S88 with a **Sensirion SCD41 on I2C**, deletes the
> entire RS-485 subsystem and the 5 V rail with it, and puts the CO2 sensor back
> behind `SENS_GATE`. **Do not build from this file.**

The real (non-breadboard) build is **two PCBs joined by a cable**:
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
