wsarachai/smartfarm/web-server/wireframes/smart_farm_AI-Analytics/screen.png

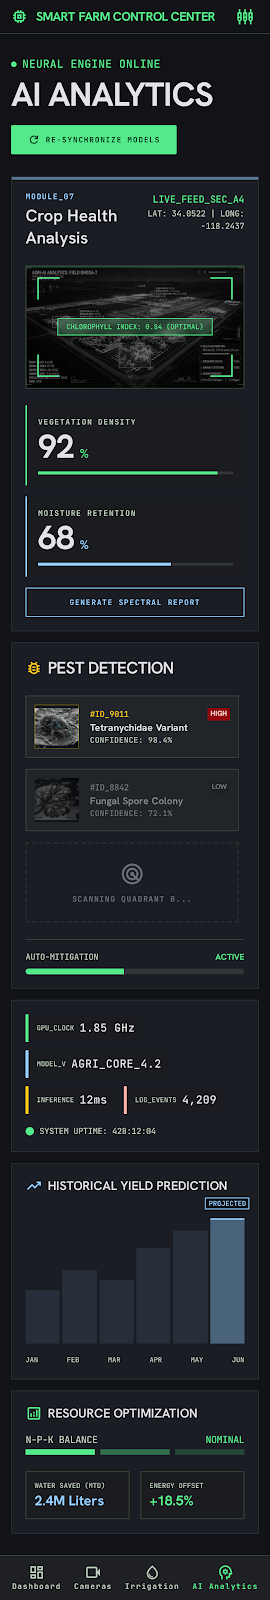
web-server/wireframes/smart_farm_AI-Analytics/screen.png
