wsarachai/smartfarm/web-server/wireframes/smart_farm_irrigation/screen.png

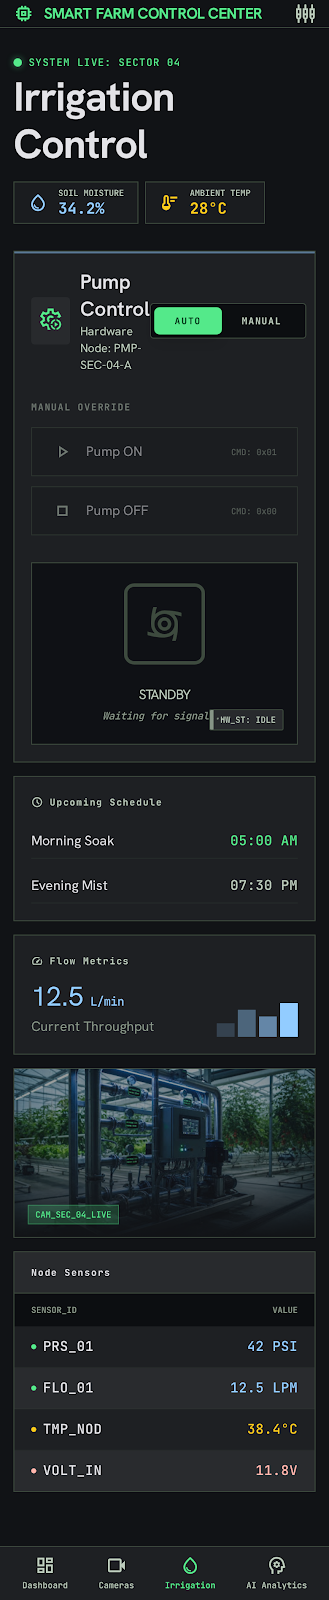
web-server/wireframes/smart_farm_irrigation/screen.png
