wsarachai/smartfarm/water-temp-node/docs/parts-list-th.md

# รายการอุปกรณ์ — water-temp-node (โหนด + gateway)

รายการซื้อของสำหรับสร้างโหนดจริงหนึ่งตัว พร้อม gateway หนึ่งตัว ตั้งแต่ขั้น
prototype บนโพรโตบอร์ดจนถึงบอร์ด PCB ที่ติดตั้งในโรงเรือน

> **เอกสารนี้เป็นรายการซื้อ ไม่ใช่สเปก** เหตุผลทางวิศวกรรมของทุกค่าอยู่ใน
> [`hardware-interface.md`](hardware-interface.md) และเบอร์ชิ้นส่วนที่ใช้แทนกันได้
> อยู่ใน [`sourcing-th.md`](sourcing-th.md) ถ้าตัวเลขสองที่ไม่ตรงกัน
> **ให้ยึด `hardware-interface.md`**

## วิธีอ่านตาราง

- **จำนวน** — จำนวนที่ใช้จริงในงาน
- **สำรอง** — จำนวนที่ควร**ซื้อเพิ่ม**จากช่องจำนวน (ไม่ใช่ยอดรวม) ตั้งตามความเสี่ยง:
  ชิ้นส่วนที่บัดกรีพลาดแล้วเสีย, ของที่หายง่าย, ของที่สั่งใหม่แล้วรอนาน
- **มีแล้ว?** — ช่องว่างสำหรับติ๊กเอง หลายรายการในนี้น่าจะมีอยู่แล้ว
  (รีโปมีร่องรอยว่าเคยใช้ DS18B20, ST-Link, หัวแร้ง มาแล้ว) **เช็คก่อนซื้อ**
- **ลิงก์** — เป็นลิงก์**ค้นหา**ตามเบอร์ชิ้นส่วน ไม่ใช่หน้าสินค้าที่ยืนยันแล้ว
  ราคาและสต็อกเปลี่ยนทุกสัปดาห์ จึงไม่บันทึกไว้ที่นี่โดยตั้งใจ

## สมมติฐานที่ใช้คำนวณจำนวน

| เรื่อง | ค่าที่ใช้ | ที่มา |
|---|---|---|
| โพรบวัดน้ำ | **6 ตัว** สายยาว **10 ม.** ต่อตัว (กรณีแย่สุดของช่วง 5–10 ม.) | §6 |
| กิ่ง I2C | **4 กิ่ง** สายยาว **5 ม.** ต่อกิ่ง (เพดานตายตัว) | §6 |
| ไฟ 24 V | **ใช้ร่วมกับฟาร์ม** — แตะที่**ขั้วแบตเตอรี่** ไม่ใช่ขั้ว LOAD | §5 กับดักข้อ 3 |
| โหนด | 1 ตัว + gateway 1 ตัว | — |

---

## ก. บอร์ดหลักและ gateway

| no | รายการ | จำนวน | ใช้ทำอะไร | สำรอง | มีแล้ว? | ลิงก์ |
|---:|---|---:|---|---:|:---:|---|
| 1 | **NUCLEO-WL55JC1** | 2 | ตัวโหนด 1 + gateway 1 — **ต้องเป็น JC1 ไม่ใช่ JC2** (JC2 เป็นรุ่น 434 MHz ใช้กับ AS923 ไม่ได้) | 0 | ☐ | [Digi-Key TH](https://www.digikey.co.th/en/products/result?keywords=NUCLEO-WL55JC1) |
| 2 | เสาอากาศ 923 MHz ขั้ว SMA | 2 | ต่อ CN12 ของแต่ละบอร์ด | 1 | ☐ | ThaiEasyElec / Lazada |
| 3 | สาย USB micro-B | 2 | flash + จ่ายไฟ ST-LINK ตอนพัฒนา / gateway ต่อเข้า Jetson ถาวร | 1 | ☐ | ทั่วไป |

> **gateway เสียบ USB ค้างไว้กับ Jetson** ที่รัน `bridge` → web-server
> ส่วนโหนดในโรงเรือนรับไฟ 3.3 V จาก J8 เข้า CN6-4 และ **ไม่ได้จ่ายไฟให้ ST-LINK**
> ซึ่งเป็นเหตุผลที่ต้องมีดีบักพอร์ตแยกที่ J13

---

## ข. Prototype ขั้นที่ 1 — โพรโตบอร์ด

เป้าหมายคือพิสูจน์ว่าเซนเซอร์แต่ละตัวคุยได้ ก่อนบัดกรีอะไรทั้งสิ้น

> **ข้อจำกัดที่ต้องรู้ล่วงหน้า:** โพรโตบอร์ดรับกระแสพุ่ง 205 mA ของ SCD41 และ
> สาย 5 เมตรไม่ไหว และพาสีฟหลวมจะทำให้ I2C ที่ปลายสายล้ม **ขั้นนี้ให้ต่อสายสั้น
> บนโต๊ะเท่านั้น** เรื่องสาย 5 เมตรเป็นงานของขั้นที่ 2

| no | รายการ | จำนวน | ใช้ทำอะไร | สำรอง | มีแล้ว? | ลิงก์ |
|---:|---|---:|---|---:|:---:|---|
| 4 | โพรโตบอร์ด 830 จุด | 2 | ตัวหนึ่งวางโมดูล I2C อีกตัววางฝั่งไฟ/โพรบ | 1 | ☐ | ThaiEasyElec / ArduinoAll |
| 5 | สายจัมเปอร์ ผู้-เมีย 20 ซม. (ชุด 40 เส้น) | 2 ชุด | จาก morpho CN10/CN6 ของ Nucleo ลงโพรโตบอร์ด — **Nucleo เป็นขาผู้ ต้องใช้ปลายเมีย** | 1 ชุด | ☐ | ThaiEasyElec |
| 6 | สายจัมเปอร์ ผู้-ผู้ (ชุด 40 เส้น) | 1 ชุด | เดินภายในโพรโตบอร์ด | 1 ชุด | ☐ | ThaiEasyElec |
| 7 | สายจัมเปอร์ เมีย-เมีย (ชุด 40 เส้น) | 1 ชุด | ต่อโมดูลเซนเซอร์ที่มีขาผู้เข้าหากัน | 1 ชุด | ☐ | ThaiEasyElec |
| 8 | **โมดูล TCA9548A** (I2C mux) | 1 | แทน U3 ที่เป็น TSSOP-24 — บัดกรีมือไม่ไหวในขั้นนี้ | 1 | ☐ | ThaiEasyElec / Lazada |
| 9 | **โมดูล/บอร์ดแตก SHT45** | 3 | แทน `SHT45-AD1B` ที่เป็น DFN-4 ขนาด 1.5×1.5 มม. — **ต้องเป็นเบอร์ลงท้าย AD1B (แอดเดรส 0x44)** ถ้าได้ BD1B มาจะเป็น 0x45 และเฟิร์มแวร์ไม่เจอ | 1 | ☐ | [Digi-Key TH](https://www.digikey.co.th/en/products/result?keywords=SHT45-AD1B) / SEK-SHT4x |
| 10 | **Sensirion `SEK-SCD41-SENSOR`** | 1 | หัว CO2 แบบมีบอร์ดแตกและสายมาให้ — VDD/VDDH เชื่อมมาแล้ว มีพูลอัพแล้ว ขา 2.54 มม. **นี่คือรูปแบบที่แนะนำสำหรับงานวิจัย** ไม่ต้อง reflow LGA | 0 | ☐ | [Digi-Key TH](https://www.digikey.co.th/en/products/result?keywords=SEK-SCD41-SENSOR) |
| 11 | **DS18B20 กันน้ำ สแตนเลส 3 สาย** | 6 | โพรบวัดอุณหภูมิน้ำ P0–P5 — **ซื้อล็อตเดียวกันทั้งหมด** สำคัญกว่ายี่ห้อ | 2 | ☐ | ArduinoAll / Cytron TH |
| 12 | ตัวต้านทาน 4.7 kΩ 1/4W THT | 6 | พูลอัพ DQ ของโพรบทั้งหก | 10 | ☐ | ทั่วไป |
| 13 | ตัวต้านทาน 2.2 kΩ 1/4W THT | 8 | พูลอัพ SDA/SCL ฝั่งปลายทาง 4 กิ่ง — **2.2k ไม่ใช่ 4.7k** ค่าผิดจะผ่านบนโต๊ะแล้วล้มตอนต่อสายจริง | 10 | ☐ | ทั่วไป |
| 14 | ตัวต้านทาน 10 kΩ / 100 kΩ / 100 Ω THT | 5 แต่ละค่า | 10k = RESET ของ mux (ห้ามลอย), 100k = พูลอัพเกต Q1, 100 Ω = อนุกรม DQ | — | ☐ | ทั่วไป |
| 15 | คาปาซิเตอร์เซรามิก 100 nF THT | 20 | ดีคัปปลิ้งทุกจุด + ที่ปลายโพรบทั้งหกและที่เซนเซอร์ทุกตัว | 10 | ☐ | ทั่วไป |
| 16 | อิเล็กโทรไลต์ **100 µF low-ESR** 16 V | 2 | แหล่งสำรองกระแสพุ่ง SCD41 — **low-ESR เป็นสเปก** เพราะมันเป็นขาชันต์ของฟิลเตอร์ริปเปิลด้วย | 3 | ☐ | ทั่วไป |
| 17 | **USB-serial adapter 3.3 V** (CP2102/CH340) | 1 | อ่านดีบักล็อกจาก J13 — **จำเป็น** เพราะโหนดจริงไม่จ่ายไฟ ST-LINK จึงใช้ VCP ไม่ได้ | 1 | ☐ | ThaiEasyElec |

---

## ค. Prototype ขั้นที่ 2 — แผ่นปรุ

ขั้นนี้คือขั้นที่**เดินสาย 5 เมตรจริงและป้อนไฟ 24 V จริง** ซึ่งเป็นสองอย่างที่
โพรโตบอร์ดทำแทนไม่ได้ ใช้โมดูลเดิมจากขั้นที่ 1 ต่อ ไม่ต้องซื้อซ้ำ

| no | รายการ | จำนวน | ใช้ทำอะไร | สำรอง | มีแล้ว? | ลิงก์ |
|---:|---|---:|---|---:|:---:|---|
| 18 | แผ่นปรุอเนกประสงค์ 2 หน้า 9×15 ซม. | 2 | ประกอบวงจรถาวรชั่วคราว — 2 หน้าเพราะมีกราวด์ให้เดินสองด้าน | 2 | ☐ | ThaiEasyElec |
| 19 | สายทองแดงแข็งเบอร์ 24–26 AWG (ม้วน) | 1 ม้วน | เดินลายบนแผ่นปรุ | — | ☐ | ทั่วไป |
| 20 | Pin header ตัวผู้ 1×40 2.54 มม. | 10 | ขาโมดูลและจุดต่อ | 5 | ☐ | ทั่วไป |
| 21 | Female header 1×40 2.54 มม. | 6 | **ทำซ็อกเก็ตให้โมดูล** เพื่อถอดเปลี่ยนได้ อย่าบัดกรีโมดูลติดแผ่นตาย | 3 | ☐ | ทั่วไป |
| 22 | **Traco `TSR 1-2433`** | 1 | เรกูเลเตอร์ 3.3 V ตัวเดียวของทั้งบอร์ด — SIP-3 เสียบแผ่นปรุได้เลย **ห้ามใช้รุ่นปรับค่าได้** เพราะ ±2 % จากโรงงานคือสิ่งที่กัน MCU ตายที่ 3.6 V | 1 | ☐ | [Digi-Key TH](https://www.digikey.co.th/en/products/result?keywords=TSR%201-2433) |
| 23 | บอร์ดแปลง SOT-23 → DIP | 2 | สำหรับ Q1 (`AO3401A`) | 3 | ☐ | Lazada / อาลีเอ็กซ์เพรส |
| 24 | บอร์ดแปลง SOT-223 → DIP | 1 | สำหรับ Q2 (`DMP6023LE`) | 2 | ☐ | Lazada / อาลีเอ็กซ์เพรส |
| 25 | เทอร์มินอลบล็อกแบบสกรู 3 ขา 3.5 มม. | 6 | จุดต่อโพรบ P0–P5 บนแผ่นปรุ | 2 | ☐ | ThaiEasyElec |
| 26 | เทอร์มินอลบล็อกแบบสกรู 4 ขา 3.5 มม. | 4 | จุดต่อกิ่ง I2C ทั้งสี่ | 2 | ☐ | ThaiEasyElec |

---

## ง. ชิ้นส่วนบอร์ด `STM32WL_FE` — บอร์ดที่ไม่ได้สร้าง (§4a)

> ⛔ **อย่าสั่งของจากหมวดนี้** หมวดนี้เป็นของ `STM32WL_FE` ซึ่งเป็นบอร์ด SMD
> ที่วาดไว้ให้โรงงานผลิตและ**ไม่เคยสั่งผลิต** บอร์ดที่จะสร้างจริงคือ
> `STM32WL_PT` ซึ่งกัดเองที่บ้านด้วยชิ้นส่วนแบบมีขา —
> **ให้ใช้หมวด ง-PT ถัดจากหมวดนี้ไปแทน**
>
> เก็บหมวดนี้ไว้เพราะสองอย่าง: ข้อ 28 กับ 32 ยังใช้ได้ (ยังเป็น SMD บนบอร์ด PT
> โดยตั้งใจ) และเหตุผลของแต่ละบรรทัดยังอธิบายว่าทำไมของแทนใน ง-PT ต้องมีคุณสมบัติ
> แบบนั้น ที่มาของเรื่องสองบอร์ดอยู่ใน
> [`hardware-interface-proto.md`](hardware-interface-proto.md)

ทั้งหมดเป็น **SMD** ซื้อเมื่อพร้อมสั่งผลิตบอร์ดแล้วเท่านั้น

| no | รายการ | จำนวน | ใช้ทำอะไร | สำรอง | มีแล้ว? | ลิงก์ |
|---:|---|---:|---|---:|:---:|---|
| 27 | สั่งผลิต PCB front-end (JLCPCB/PCBWay) | 5 | ขั้นต่ำการสั่งมักเป็น 5 แผ่นอยู่แล้ว | — | ☐ | jlcpcb.com |
| 28 | **AO3401A** SOT-23 (Q1) | 1 | เกตตัดไฟรางเซนเซอร์ — เลือกที่ **R_DS(on) ที่ V_GS = −2.5 V** ไม่ใช่ที่ −4.5 V | 4 | ☐ | [Digi-Key TH](https://www.digikey.co.th/en/products/result?keywords=AO3401A) |
| 29 | **DMP6023LE-13** SOT-223 (Q2) | 1 | กันต่อกลับขั้ว 24 V — **ต้องเป็น 60 V** ห้ามใช้ AO3401A แทนเพราะเป็นพาร์ต 30 V | 2 | ☐ | [Digi-Key TH](https://www.digikey.co.th/en/products/result?keywords=DMP6023LE-13) |
| 30 | **BZX84C12** ซีเนอร์ 12 V SOT-23 (D10) | 1 | แคลมป์เกต Q2 — **ไม่ใช่ของเลือกได้** ถ้าไม่มี V_GS จะถึง −32 V ชนขีดจำกัด ±20 V | 4 | ☐ | [Digi-Key TH](https://www.digikey.co.th/en/products/result?keywords=BZX84C12) |
| 31 | **SMBJ33A** TVS (D9) | 1 | คร่อมอินพุต 24 V ต่อ**หลัง** Q2 ซึ่งเป็นสิ่งที่ทำให้ใช้ตัวทิศทางเดียวได้ | 2 | ☐ | [Digi-Key TH](https://www.digikey.co.th/en/products/result?keywords=SMBJ33A) |
| 32 | **CDSOD323-T05LC** TVS 1 pF (D1–D6) | 6 | ป้องกันสาย DQ ทั้งหก — ค่าคาปาซิแตนซ์ต่ำคือประเด็น ปฏิเสธเบอร์ที่ดาต้าชีตไม่บอกค่านี้ชัด | 4 | ☐ | [Digi-Key TH](https://www.digikey.co.th/en/products/result?keywords=CDSOD323-T05LC) |
| 33 | **TCA9548APWR** TSSOP-24 (U3) | 1 | บัสสวิตช์ 8 ช่อง ใช้ช่อง 0–3 | 2 | ☐ | [Digi-Key TH](https://www.digikey.co.th/en/products/result?keywords=TCA9548APWR) |
| 34 | **Traco `TSR 1-2433`** (U7) | 1 | ตัวจริงบนบอร์ด (ตัวในข้อ 22 อยู่บนแผ่นปรุ) | 1 | ☐ | [Digi-Key TH](https://www.digikey.co.th/en/products/result?keywords=TSR%201-2433) |
| 35 | ตัวต้านทาน 0805 ชุดคละค่า | 1 ชุด | ต้องมี **4.7k ×8, 2.2k ×8, 100 Ω ×7, 100k, 10k, 470k, 300k 1 %, 30k 1 %** — 100 Ω เจ็ดตัวไม่ใช่หก: R9–R14 หกตัวบนสาย DQ **บวก R2** ตัวอนุกรมของ `SENS_GATE` (สเปกให้ช่วง 100R..1k แผนผังใช้ 100R) | — | ☐ | ThaiEasyElec |
| 36 | คาปาซิเตอร์ 0805 ชุดคละค่า | 1 ชุด | ต้องมี **100 nF ×6, 1–10 µF** | — | ☐ | ThaiEasyElec |
| 37 | **C11 และ C19 — Nichicon `UVR1J101MPD`** 100 µF / 63 V, φ8 × 11.5 มม., ระยะขา 3.5 | **2** | **ชิ้นเดียวกันทั้งสองตำแหน่ง** C11 = บัลค์ 24 V, C19 = `C_IN` ของ U7 — ทั้งคู่อยู่บนโหนด `24V_PROT` ที่ต้อง **63 V ไม่ใช่ 50 V** เพราะ D9 แคลมป์ได้ถึง 53.3 V ส่วน 22 µF ของ Traco เป็นค่า**ต่ำสุด** และ X7R 1210 ที่ไบอัส 24–29 V เหลือความจุไม่ถึงครึ่ง **มีขั้ว — ต่อกลับด้านระเบิด** | 2 | ☐ | [Digi-Key TH](https://www.digikey.co.th/en/products/result?keywords=UVR1J101MPD) |
| 38 | — | — | *(รวมกับข้อ 37 แล้ว — เดิมแยกเป็น C19 22 µF/50 V X7R 1210 กับ C11 100 µF/63 V)* | — | — | — |
| 39 | C21 — 22 µF / 16 V X7R | 1 | `C_OUT` **ไม่ใส่ก็ได้** โมดูลไม่ต้องการ ใส่เผื่อกระแสกระชากตอน LoRa TX | 1 | ☐ | ทั่วไป |

---

## ง-PT. ชิ้นส่วนบอร์ด `STM32WL_PT` — บอร์ดที่กัดเอง (§4a-proto)

**นี่คือหมวดที่ใช้สั่งของจริง** ทดแทนหมวด ง ทั้งหมวด ค่าทางไฟฟ้าทุกค่าเหมือนเดิม
ไม่มีอะไรเปลี่ยน — ที่เปลี่ยนคือ **แพ็กเกจ** (SMD → มีขา) กับ **ภาคเรกูเลเตอร์**
(โมดูล Traco ตัวเดียว → โมดูล DFR0570 + พรีเรกูเลเตอร์เชิงเส้น 7 ตัว) เหตุผลทั้งหมด
อยู่ใน [`hardware-interface-proto.md`](hardware-interface-proto.md) §2 และ §4

เลขข้อขึ้นต้นด้วย **P** เพื่อไม่ให้ชนกับเลขเดิมของเอกสาร — ข้อ 1–71 ยังหมายถึงสิ่งเดิม

| no | รายการ | จำนวน | ใช้ทำอะไร | สำรอง | มีแล้ว? | ลิงก์ |
|---:|---|---:|---|---:|:---:|---|
| P1 | **วัสดุและเครื่องมือกัดบอร์ด — ทั้งชุดอยู่ใน [`pcb-home-etch.md`](pcb-home-etch.md) Stage 0** | 1 ชุด | แทนข้อ 27 (สั่งผลิต PCB) ทั้งข้อ ไม่คัดลอกมาที่นี่เพราะรายการนั้นเป็นส่วนหนึ่งของกระบวนการ 14 ขั้น **สามอย่างที่ห้ามลดสเปก:** ดีบุกน้ำ (liquid tin), ดอกสว่าน **1.0 มม.** (ซื้อเผื่อหลายดอก มันเจาะสองในสามของทั้งบอร์ด) และ**แท่นสว่าน** — เจาะมือเปล่าที่ระยะ 2.54 มม. ไม่สำเร็จ | — | ☐ | — |
| P2 | **IRF9540N** TO-220 (Q2) | 1 | กันต่อกลับขั้ว 24 V แทน DMP6023LE-13 — **−100 V** ผ่านกฎ ≥60 V ของ §5 สบาย R_DS(on) 0.117 Ω ที่ V_GS −10 V และ D10 แคลมป์เกตไว้ที่ −12 V จึงเปิดเต็ม **ระวังแท็บคือขาเดรน มีไฟ** | 2 | ☐ | [Digi-Key TH](https://www.digikey.co.th/en/products/result?keywords=IRF9540N) |
| P3 | **P6KE33A** DO-15 (D9) | 1 | TVS อินพุต 24 V แทน SMBJ33A — ตระกูลเดียวกันแบบมีขา 600 W ทิศทางเดียว standoff 33 V **แคลมป์ 53.3 V** ซึ่งเป็นตัวเลขที่ทำให้ C11 ต้องเป็น 63 V | 2 | ☐ | [Digi-Key TH](https://www.digikey.co.th/en/products/result?keywords=P6KE33A) |
| P4 | **1N4742A** ซีเนอร์ 12 V 1 W DO-41 (D10) | 1 | แคลมป์เกต Q2 แทน BZX84C12 — **ไม่ใช่ของเลือกได้** ถ้าไม่มี V_GS ถึง −32 V ชนขีดจำกัด ±20 V DO-41 มีสองขาจึงไม่มีกับดักเรียงขาแบบ SOT-23 แต่**คาดสีคือแคโทด และยังต้องไปที่ขาซอร์สของ Q2** | 4 | ☐ | [Digi-Key TH](https://www.digikey.co.th/en/products/result?keywords=1N4742A) |
| P5 | **IRF740** TO-220 (Q3) | 1 | ตัวผ่านของพรีเรกูเลเตอร์ **ของใหม่บนบอร์ดนี้** ต่อเป็นซอร์สฟอลโลเวอร์ ใช้ IRF640N (200 V) แทนได้ | 1 | ☐ | [Digi-Key TH](https://www.digikey.co.th/en/products/result?keywords=IRF740) |
| P6 | **ฮีตซิงก์หนีบ TO-220** | 1 | ของ Q3 — มันทิ้งกำลังเป็นความร้อนตามนิยามของวงจรเชิงเส้น มีอยู่ในรายการ Stage 0 แล้วเช่นกัน | 1 | ☐ | ทั่วไป |
| P7 | **BC547** TO-92 (Q4) | 1 | ตัวตรวจกระแสของวงจรจำกัดกระแส ~130 mA **ของใหม่** — **เบสกับอีมิตเตอร์คร่อม R42 ใส่กลับด้านแล้วไม่มีการจำกัดกระแสเลย** และผิดแบบนี้ไม่มีอาการจนกว่าจะเกิดไฟฟ้าลัดวงจร | 4 | ☐ | ทั่วไป |
| P8 | **1N4750A** ซีเนอร์ **27 V** 1 W DO-41 (D11) | 1 | อ้างอิงแรงดันเกต Q3 **ของใหม่** — ตัวที่ตรึงอินพุตโมดูลไว้ที่ ~21–23 V ไม่ว่าแบงก์จะขึ้นไปเท่าไร | 2 | ☐ | [Digi-Key TH](https://www.digikey.co.th/en/products/result?keywords=1N4750A) |
| P9 | **1N4744A** ซีเนอร์ **15 V** 1 W DO-41 (D12) | 1 | แคลมป์เกต–ซอร์สของ Q3 **ของใหม่** — **27 V กับ 15 V หน้าตาเหมือนกันบนบอร์ดที่ไม่มีซิลค์สกรีน** ถ้าสลับกัน D12 จะไม่แคลมป์อะไรเลย แยกของสองอย่างนี้ตั้งแต่ตอนแกะถุง | 2 | ☐ | [Digi-Key TH](https://www.digikey.co.th/en/products/result?keywords=1N4744A) |
| P10 | **DFRobot DFR0570** (U7) | 1 | เรกูเลเตอร์ 3.3 V แทน Traco TSR 1-2433 — **ผ่านกฎ "ห้ามเป็นรุ่นปรับค่าได้"** ของข้อ 3 ท้ายเอกสาร เพราะ 3.3 V เป็นค่าจากโรงงาน ไม่มีตัวหมุน โมดูลเป็นพาร์ต 28 V ซึ่ง**ปลอดภัยได้ก็เพราะพรีเรกูเลเตอร์เท่านั้น** — ห้ามใส่โมดูลนี้โดยข้าม Q3/D11 | 1 | ☐ | DFRobot / Lazada |
| P11 | **โมดูล TCA9548A breakout `SKU-0260-1`** (U3) | 1 | บัสสวิตช์ 8 ช่อง ใช้ช่อง 0–3 แทนชิป TSSOP-24 เปล่า ซึ่งระยะขา 0.65 มม. กัดเองไม่ได้ **`VIN` ของโมดูลต้องไปที่ `VSENS` ห้ามไปที่ 3V3 ถาวร** — เป็นสายเส้นที่สำคัญที่สุดของชิ้นนี้ | 1 | ☐ | Lazada / อาลีเอ็กซ์เพรส |
| P12 | **ซ็อกเก็ตเฮดเดอร์ตัวเมีย 2.54 มม.** | พอสำหรับ 2×12 และ 8 รู | ให้โมดูล P10 กับ P11 **เสียบแล้วถอดออกได้** — บนบอร์ดที่ไม่มีโซลเดอร์มาสก์ การบัดกรีโมดูลตายลงไปเลยแปลว่าวันที่ต้องเปลี่ยนคือวันที่บอร์ดจบ | 1 ชุด | ☐ | ThaiEasyElec |
| P13 | **ตัวต้านทาน axial ¼ W ชุดคละค่า** | 1 ชุด | ค่าเดียวกับข้อ 35 ทุกค่า: **4.7k ×8, 2.2k ×8, 100 Ω ×7, 100k, 10k, 470k, 300k 1 %, 30k 1 %** บวก **22k ×1** (R41 ไบอัส D11 — ของใหม่) | — | ☐ | ThaiEasyElec |
| P14 | **ตัวต้านทาน 4.7 Ω ½ W** (R42) | 1 | ตัวตรวจกระแสคู่กับ Q4 **ของใหม่ และเป็นตัวเดียวบนบอร์ดที่ไม่ใช่ ¼ W** — ¼ W ไม่พอ | 2 | ☐ | ทั่วไป |
| P15 | **คาปาซิเตอร์เซรามิก 100 nF ระยะขา 5 มม.** | 4 | C2, C8, C10 และ **C22** (soft-start เกต Q3 — ของใหม่) | 4 | ☐ | ThaiEasyElec |
| P16 | **C1 — เซรามิก 10 µF ระยะขา 5 มม.** | 1 | บัลค์ของราง `VSENS` **ค่านี้ยังไม่สรุป** — เพดานรวมคือ 10 µF และตอนนี้ C1 กินเต็มโควตา ถ้าวัดคาปาบนโมดูล P11 ได้เกิน 1 µF ต้องลดตัวนี้ลง (`build-sheet-proto.md` §1) ซื้อ 4.7 µF ติดไว้ด้วยหนึ่งตัวจะได้ไม่ต้องรอ | 1 (4.7 µF) | ☐ | ทั่วไป |
| P17 | **C11 — Nichicon `UVR1J101MPD`** 100 µF / **63 V** φ8 × 11.5 มม. ระยะขา 3.5 | **1** | บัลค์บนโหนด `24V_PROT` — **63 V ไม่ใช่ 50 V** เพราะ D9 แคลมป์ได้ถึง 53.3 V **ตัวเดียว ไม่ใช่สองตัวเหมือนข้อ 37 เดิม** | 1 | ☐ | [Digi-Key TH](https://www.digikey.co.th/en/products/result?keywords=UVR1J101MPD) |
| P18 | **C19 — 100 µF / 35 V** อิเล็กโทรไลต์ φ8 ระยะขา 3.5 | 1 | **ย้ายตำแหน่งแล้ว** ตอนนี้อยู่บนโหนด `24V_PRE` เป็นบัลค์อินพุตของโมดูล จึงเป็น 35 V ไม่ใช่ 63 V และ**เป็นคนละตัวกับ C11** — ข้อ 37 เดิมที่บอกว่า "ชิ้นเดียวกันทั้งสองตำแหน่ง" ใช้ไม่ได้แล้ว | 1 | ☐ | ทั่วไป |
| P19 | **C21 — 22 µF / 16 V** อิเล็กโทรไลต์ ระยะขาเดิม 2.0 — **ดัดขาออกเป็น 5.08 มม. ตอนใส่** | 1 | `C_OUT` **ไม่ใส่ก็ได้** โมดูลไม่ต้องการ ใส่เผื่อกระแสกระชากตอน LoRa TX | 1 | ☐ | ทั่วไป |

**ที่ยกมาจากหมวดอื่นโดยไม่เปลี่ยน:**

- **ข้อ 28 `AO3401A`** (Q1) และ **ข้อ 32 `CDSOD323-T05LC`** (D1–D6) — **ยังเป็น SMD
  บนบอร์ดนี้โดยตั้งใจ** ไม่ใช่เพราะลืมแปลง แต่เพราะไม่มีพาร์ตแบบมีขาตัวไหนที่
  คาปาซิแตนซ์ต่ำพอสำหรับ TVS หกตัวบนสาย DQ หรือเปิดเต็มที่ V_GS = −3.3 V ได้
  (`hardware-interface-proto.md` §5) สองตัวนี้บัดกรีลงแผ่นทองแดงเปล่าได้อยู่ —
  SOD-323 กับ SOT-23 ระยะขายังกว้างพอ
- **หมวด จ ทั้งหมด (ข้อ 40–51)** — ขั้ว Phoenix, สายแพร, ฟิวส์ 5×20 T2A, สาย Cat5
  ไม่มีข้อไหนขึ้นกับแพ็กเกจ ใช้ตามเดิมได้ทั้งหมวด

> ⚠ **คำเตือนเรื่อง V_oc ท้ายหมวด จ ยังใช้ได้ แต่คนเจ็บเปลี่ยนตัว** บอร์ดนี้โมดูล
> ไม่เห็นแรงดันแบงก์แล้ว พรีเรกูเลเตอร์กันไว้ให้ — แต่ถ้าคอนโทรลเลอร์ปล่อย V_oc
> ของแผง (~44 V) มาค้างที่ `24V_PROT` **D9 คือตัวที่ตาย** เพราะ P6KE33A เป็นอุปกรณ์
> สำหรับทรานเชียนต์ ไม่ใช่สำหรับแรงดันเกินแบบต่อเนื่อง **ยังต้องวัดแรงดันแบงก์
> ตอนเที่ยงจริงก่อน bring-up ขั้นที่ 1 เหมือนเดิม**

---

## จ. ขั้วต่อ สายไฟ และของที่หัววัด

| no | รายการ | จำนวน | ใช้ทำอะไร | สำรอง | มีแล้ว? | ลิงก์ |
|---:|---|---:|---|---:|:---:|---|
| 40 | **สาย Cat5/Cat5e UTP** (ไม่ชีลด์) | **90 ม.** | 6 โพรบ × 10 ม. = 60 ม. + 4 กิ่ง I2C × 5 ม. = 20 ม. + เผื่อ 10 ม. **เลือก UTP ไม่ใช่ STP** — ชีลด์เพิ่มค่าคาปาซิแตนซ์ต่อเมตรเกือบเท่าตัว ซึ่งเป็นคุณสมบัติเดียวที่ค่าพูลอัพทั้งหมดขึ้นอยู่กับมัน | 20 ม. | ☐ | ทั่วไป |
| 41 | ขั้วต่อสกรูถอดได้ 3 ขา (Phoenix MC 1,5/3-ST-3,5 หรือเทียบเท่า) + เฮดเดอร์ | 6 ชุด | ขั้วโพรบบน PCB — **ต้องถอดได้** เพราะออกแบบเผื่อการรื้อต่อสายใหม่ในโรงเรือนด้วยมือเปียก | 2 | ☐ | [Digi-Key TH](https://www.digikey.co.th/en/products/result?keywords=1840379) |
| 42 | ขั้วต่อสกรูถอดได้ 4 ขา (MC 1,5/4-ST-3,5) + เฮดเดอร์ | 4 ชุด | J9–J12 — **สี่กิ่งใช้ขั้วเดียวกันหมด พาร์ตเดียว พินเอาต์เดียว** `V / SDA / SCL / G` | 2 | ☐ | [Digi-Key TH](https://www.digikey.co.th/en/products/result?keywords=1840382) |
| 43 | Box header 2×19 มีกรอบ 2.54 มม. (J7) | 1 | ปลายสายแพรฝั่ง front-end | 1 | ☐ | ทั่วไป |
| 44 | สายแพร 38 เส้น + ซ็อกเก็ต IDC 2×19 | 2 ซ็อกเก็ต, ยาว ≤30 ซม. | สายสัญญาณไป CN10 — **ตัดขา CN10-6 แล้วอุดรูที่ตรงกัน** เพื่อทำคีย์กันเสียบกลับด้าน | 2 | ☐ | ThaiEasyElec |
| 45 | ขั้วต่อ 2 ขามีคีย์ JST-XH (J8) | 1 ชุด | 3.3 V จาก U7 ไป CN6-4/6 — **แยกจากสายแพรโดยตั้งใจ** เพื่อให้กรณีเสียบกลับด้านแย่สุดคือ GPIO ลงกราวด์ ไม่ใช่ไฟเข้า GPIO | 2 | ☐ | ทั่วไป |
| 46 | ซ็อกเก็ต 1×8 2.54 มม. | 2 | ครอบ CN6 เต็มแถว ใช้จริงแค่ขา 4/6/7 — **ใช้เต็มแถวเพื่อไม่ให้เสียบเหลื่อมช่อง** | 2 | ☐ | ทั่วไป |
| 47 | Pin header 1×3 (J13) | 1 | ดีบัก UART | 2 | ☐ | ทั่วไป |
| 48 | ขั้วต่อ 2 ขา ≥5 A มีคีย์ (J14) | 1 | อินพุต 24 V | 1 | ☐ | ทั่วไป |
| 49 | **ฟิวส์กระบอก 5×20 มม. 2 A แบบหน่วงเวลา (T) + รังฟิวส์** | 1 ชุด | F1 — **เลือกด้วยค่า I²t ≥0.5 A²s ไม่ใช่ด้วยแอมป์** กระแสกระชากตอนเสียบไหลผ่านบอดี้ไดโอดของ Q2 ราว 0.1 A²s ซึ่งฟิวส์ 1206 "slow-blow" 2 A บางเบอร์อยู่ตรงเส้นพอดี แบบกระบอกยังเปลี่ยนบนเสาได้ด้วย | 5 | ☐ | ทั่วไป |
| 50 | สายไฟ DC 18 AWG 2 แกน | 10 ม. | จาก**ขั้วแบตเตอรี่**ของแบงก์ฟาร์มมาที่กล่อง | — | ☐ | ทั่วไป |
| 51 | เบรกเกอร์/ฟิวส์ DC ที่ฝั่งแบงก์ | 1 | ตัดตอนที่ต้นทาง — แยกจาก F1 บนบอร์ด | 1 | ☐ | ทั่วไป |

> ⚠ **แตะที่ขั้วแบตเตอรี่ ห้ามแตะขั้ว LOAD ของ charge controller** (§5 กับดักข้อ 3)
> รุ่นนี้ **ไม่มี UVLO** โดยตั้งใจ — ขั้ว LOAD จะตัดไฟโหนดทิ้งตอนแรงดันตก ทำให้
> ข้อมูลหายในช่วงที่อยากได้มากที่สุด และโหนดรายงาน `VBAT_SENSE` ได้ต่ำถึง 6.5 V อยู่แล้ว
>
> ⚠ **ก่อน bring-up ขั้นที่ 1 ให้วัดแรงดันแบงก์ตอนเที่ยงจริง** โมดูล Traco ทนได้ 36 V
> ถ้าคอนโทรลเลอร์ตัวที่มีอยู่ปล่อย V_oc ของแผงผ่านมา (~44 V) โมดูลพัง นี่คือข้อจำกัด
> ที่รู้ตัวของรุ่น 1.0 และป้องกันได้ด้วยการวัดเท่านั้น

### ของที่ปลายสาย (§4b)

| no | รายการ | จำนวน | ใช้ทำอะไร | สำรอง | มีแล้ว? | ลิงก์ |
|---:|---|---:|---|---:|:---:|---|
| 52 | กล่องเล็กมีช่องระบายอากาศ | 3 | ครอบ SHT45 แต่ละตัว หันเซนเซอร์ลง กันน้ำหยดแต่**ห้ามปิดสนิท** | 1 | ☐ | ทั่วไป |
| 53 | **Radiation shield** แบบครีบซ้อน | 1 | **เฉพาะ SHT45 ตัวนอกโรงเรือน (ช่อง 2)** ถ้าไม่มี ค่าอ้างอิงจะสูงเกินจริง 10–15 °C กลางแดดไทย และกลายเป็นข้อมูลที่หลอกมากกว่าไม่มี **สามตัวในโรงเรือนไม่ต้องใช้ — ในนั้นมืด** | 0 | ☐ | ThaiEasyElec / พิมพ์ 3D เอง |
| 54 | กล่องระบายอากาศกันละอองน้ำ สำหรับหัว CO2 | 1 | **ช่องแพร่แก๊สหันลงล่าง** ให้หยดน้ำหยดทิ้งแทนที่จะขังบนทางเดินแสง **ห้ามปิดสนิท** และ**ห้ามอยู่ในแนวหัวพ่นหมอก** | 1 | ☐ | ทั่วไป |
| 55 | เมมเบรน PTFE/Gore | 1 | ปิดช่องแพร่แก๊สของหัว CO2 — ให้ CO2 ผ่านแต่ไม่ให้น้ำเหลวผ่าน | 2 | ☐ | Lazada |
| 56 | ตัวต้านทาน ~220 Ω 1/4W | 2 | **ฮีตเตอร์กันฝ้าที่หัว CO2 — วางแพดไว้แต่ยังไม่ใส่** ใส่ก็ต่อเมื่อล็อกจุดน้ำค้างจาก SHT45 บอกว่าจำเป็น (+1.2 Wh/วัน) | — | ☐ | ทั่วไป |

---

## ฉ. กล่องและงานติดตั้ง

| no | รายการ | จำนวน | ใช้ทำอะไร | สำรอง | มีแล้ว? | ลิงก์ |
|---:|---|---:|---|---:|:---:|---|
| 57 | กล่องกันน้ำ IP65 ~250×200×100 มม. | 1 | ใส่ทั้งสองบอร์ด **ตั้งนอกโรงเรือน** — ขนาดถูกกำหนดโดยจำนวนสายเข้า 11 เส้น ไม่ใช่โดยขนาดบอร์ด | 0 | ☐ | ทั่วไป |
| 58 | เคเบิลแกลนด์ PG7/PG9 | 11 | 6 โพรบ + 4 กิ่ง I2C + 1 ไฟเข้า | 4 | ☐ | บ้านหม้อ / คลองถม |
| 59 | เสารองไนลอน M3 + สกรู | 8 ชุด | ยึดบอร์ดทั้งสอง | 4 | ☐ | ทั่วไป |
| 60 | เคเบิลไทร์ + ตัวรัดสาย | 30 | **รัดภายใน 30 มม. จากทุกจุดที่สายเข้า** | — | ☐ | ทั่วไป |
| 61 | ซองกันชื้น (desiccant) | 4 | กล่อง front-end ไม่ต้องระบายอากาศเพราะไม่มีอะไรในนั้นวัดอากาศ แต่ถ้าเปิดกล่องบ่อยในอากาศชื้นควรมีไว้ | — | ☐ | ทั่วไป |
| 62 | ป้ายมาร์กเกอร์ติดสาย / ปลอกเลข | 2 ชุด | **ติดทั้งสองปลายของทุกกิ่ง** — สี่ขั้วเหมือนกันหมดและสายเกือบเหมือนกัน สลับ J10/J11 แล้วข้อมูลยัง "ดูสมเหตุสมผล" ส่วนสลับ J12 คือส่งกระแส 205 mA ลงสายผิดเส้นโดยไม่มีอะไรฟ้อง | — | ☐ | ทั่วไป |

---

## ช. เครื่องมือ

| no | รายการ | จำนวน | ใช้ทำอะไร | สำรอง | มีแล้ว? | ลิงก์ |
|---:|---|---:|---|---:|:---:|---|
| 63 | **ออสซิลโลสโคป ≥50 MHz 2 ช่อง** | 1 | **bring-up ขั้นที่ 21–22 บังคับ** — ขั้น 22 วัดริปเปิลที่หัว CO2 ให้ต่ำกว่า 30 mV (ข้อกำหนดในดาต้าชีต ไม่ใช่คำแนะนำ) และขั้น 21 ยืนยันว่ากระแสพุ่ง 205 mA ไม่ทับการแปลงค่า DS18B20 ทั้งสองความผิดพลาดเงียบสนิท เซนเซอร์ยังตอบและยังผ่าน CRC | 0 | ☐ | Rigol DHO800 / Siglent SDS800X |
| 64 | **แหล่งจ่ายไฟปรับค่าได้ 0–30 V จำกัดกระแสได้** | 1 | bring-up ขั้น 1–4: ป้อน 24.0 V, กวาดแรงดันเช็ค `VBAT_SENSE`, และ**กลับขั้วจงใจ**เพื่อพิสูจน์ว่า Q2 ไม่ได้ใส่กลับด้าน ซึ่งเป็นความผิดพลาดเดียวที่ผ่านการทดสอบขั้วถูกทุกข้อ | 0 | ☐ | ทั่วไป |
| 65 | มัลติมิเตอร์ | 1 | อ่านค่าที่ TP ทั้งหมด | 1 | ☐ | ทั่วไป |
| 66 | หัวแร้งปรับอุณหภูมิ + ปลายแหลม | 1 | ประกอบแผ่นปรุและ SMD | — | ☐ | ทั่วไป |
| 67 | ตะกั่ว 0.6 มม. + ฟลักซ์ + วิกดูดตะกั่ว | — | งานบัดกรีทั่วไปและแก้ไข | — | ☐ | ทั่วไป |
| 68 | ปืนลมร้อน | 1 | **จำเป็นเฉพาะถ้าเลือกทำหัว CO2 จาก LGA เปล่า** ถ้าใช้ `SEK-SCD41-SENSOR` ตามที่แนะนำ ก็ไม่ต้องมี | — | ☐ | ทั่วไป |
| 69 | คีมย้ำหางปลา + คีมปอกสาย | 1 | ทำสายทั้ง 11 เส้น | — | ☐ | ทั่วไป |
| 70 | แว่นขยาย/กล้องจุลทรรศน์ USB | 1 | ตรวจงานบัดกรี TSSOP-24 และ SOT-23 | — | ☐ | ทั่วไป |
| 71 | ST-Link V2 แยก | 1 | **เฉพาะกรณีไม่อยากใช้ ST-LINK บนบอร์ด Nucleo** ปกติไม่ต้อง เพราะ NUCLEO มีในตัว | — | ☐ | ThaiEasyElec |

---

## ลำดับการซื้อ

สเปกวางแผนไว้ให้ซื้อเป็นระลอก และเหตุผลไม่ใช่เรื่องเงิน แต่เป็นเรื่องข้อมูล —
**หัว CO2 ติดตั้งเป็นอย่างสุดท้าย** หลังจากล็อกของ SHT45 บอกแล้วว่ากลางโรงเรือน
มีอุณหภูมิ ความชื้น และเหนืออื่นใด **จุดน้ำค้าง** เป็นอย่างไร เพราะนั่นคือสิ่งที่
ตัดสินว่าต้องใส่ฮีตเตอร์กันฝ้าหรือไม่

| ระลอก | ซื้ออะไร | ทำไม |
|---|---|---|
| **1** | ข้อ 1–17 | ทดสอบว่าเซนเซอร์ทุกตัวคุยได้บนโต๊ะ |
| **2** | ข้อ 18–26, 40–51, 63–71 | ประกอบแผ่นปรุ เดินสายจริง ป้อนไฟ 24 V จริง |
| **3** | **ข้อ P1–P19**, 28, 32, 57–62 | กัดบอร์ดและประกอบของจริง **รวมทั้ง J12 กับ R39/R40 ตั้งแต่แรก** เพื่อไม่ต้องรื้อแก้ทีหลัง — **ไม่ใช่ข้อ 27–39** ซึ่งเป็นของบอร์ด `STM32WL_FE` ที่ไม่ได้สร้าง |
| **4** | ข้อ 52–56 | หลังอ่านล็อกแล้ว — และ**ใส่ตัวต้านทานฮีตเตอร์ก็ต่อเมื่อล็อกบอกว่าต้องใส่** |

---

## สามอย่างที่พลาดแล้วเงียบ

รวมไว้ตรงนี้เพราะเป็นเรื่องที่ **ซื้อผิดแล้วยังใช้งานได้** จนกระทั่งไม่ได้

1. **`SHT45-AD1B` ไม่ใช่ `-BD1B`** ตัวหลังเป็นแอดเดรส 0x45 ประกอบเสร็จแล้วสแกนไม่เจอ
2. **พูลอัพ I2C ฝั่งปลายทางเป็น 2.2k ไม่ใช่ 4.7k** ค่า 4.7k ผ่านฉลุยบนสายสั้นบนโต๊ะ
   แล้วเริ่ม NACK เป็นครั้งคราวเมื่อต่อสาย 5 เมตรจริง
3. **โมดูล 3.3 V ต้องเป็นรุ่นแรงดันคงที่ ห้ามเป็นรุ่นปรับค่าได้ที่มีตัวหมุน** ตัวหมุน
   ที่ถูกปัดโดนระหว่างประกอบสามารถส่ง 3.6 V ขึ้นไปเข้า CN6-4 และฆ่า STM32WL ได้
   ค่า ±2 % จากโรงงานคือสิ่งที่กันเหตุนี้

และหนึ่งอย่างที่พลาดแล้ว**ดัง** — **ห้ามใช้ `AO3401A` แทน `DMP6023LE` ที่ตำแหน่ง Q2**
ตัวแรกเป็นพาร์ต 30 V อยู่บนอินพุต 24 V ที่ขึ้นถึง 29.2 V และเจอทรานเชียนต์จาก D9 ได้ถึง 53.3 V
