wsarachai/smartfarm/water-temp-node/docs/build-sheet-proto.th.md

# แผ่นงานประกอบ `STM32WL_PT`

> **หมายเหตุเรื่องการแปล**
> เอกสารนี้เป็นฉบับแปลภาษาไทยของ [`build-sheet-proto.md`](build-sheet-proto.md)
> **ฉบับภาษาอังกฤษถือเป็นฉบับจริง (source of truth)** — เมื่อสองฉบับขัดแย้งกัน
> ให้ยึดฉบับภาษาอังกฤษ และเมื่อแก้ต้องแก้ฉบับภาษาอังกฤษด้วยเสมอ
>
> สิ่งที่ **ไม่แปล** โดยเจตนา: เลขรุ่นอุปกรณ์ ชื่อ designator (`C11`) ชื่อสัญญาณ
> (`24V_PROT`) ชื่อขา (`Vin+`) ชื่อไฟล์ และหน่วยวัด — แปลแล้วใช้งานจริงไม่ได้
>
> **นี่คือฉบับที่ควรพิมพ์ไปใช้ที่โต๊ะ** ส่วนฉบับภาษาอังกฤษไว้อ่านคู่กับเอกสารอื่น

**พิมพ์ที่ 1:1 แล้วเก็บสำเนาหนึ่งชุดไว้ในฝากล่อง**

บอร์ดนี้ไม่มี silkscreen โดยตั้งใจ ([`pcb-home-etch.md`](pcb-home-etch.md))
เอกสารนี้จึงเป็นสิ่งเดียวหน้างานที่บอกได้ว่าอุปกรณ์แต่ละตัวหันทางไหน คนที่เปิดกล่อง
ในปี 2028 จะมีแค่แผ่นนี้ **มันต้องเดินทางไปกับบอร์ด ไม่ใช่อยู่แค่ในรีโป**

ค่าทั้งหมดมาจาก [`hardware-interface-proto.md`](hardware-interface-proto.md)
ถ้าแผ่นนี้ขัดกับไฟล์นั้น ให้ยึดไฟล์นั้น

```
บอร์ดใบที่ ____ จาก 5      ผู้ประกอบ ______________      วันที่ ____________
กัด ______  เจาะ ______  ชุบดีบุก ______  via ______ / ____
ผ่าน §7 ______      เคลือบ ______
```

---

## 1. ก่อนบัดกรีโมดูล — ตรวจก่อนติดตั้ง

โมดูลทั้งสองเสียบบน female header ดังนั้นตรวจตอนถืออยู่ในมือได้ **ก่อน**ที่จะผูกมัดอะไร

### U3 — TCA9548A breakout (SKU-0260-1)

บอร์ดนี้เป็นโคลนของเลย์เอาต์ Adafruit เอกสารของ Adafruit ยืนยันให้สองข้อ
ที่เหลือคือจุดที่โคลนอาจต่างออกไป

| | วัดอะไร | ควรได้ | วัดได้ |
|---|---|---|---|
| ☐ | R จาก SDA → VIN | หลัก kΩ — Adafruit ไม่ระบุค่า | ______ |
| ☐ | R จาก SCL → VIN | เช่นเดียวกัน | ______ |
| ☐ | R จาก RST → VIN | **มี** — *"pulled high by default"* | ______ |
| ☐ | R จาก SD0 → VIN | **ต้องวัดไม่ขึ้น** — ช่องปลายทางไม่มี pull-up | ______ |
| ☐ | C จาก VIN → GND | **ถ้าเกิน 1 µF ต้องลด C1 ลง** (§3 จำกัด `VSENS` รวม ≤10 µF) | ______ |
| ☐ | A0/A1/A2 → GND บนโมดูล | **ต้องไม่ต่อถึงกัน** — บอร์ดเราเป็นตัวต่อลง GND เพื่อให้ได้ `0x70` | ______ |

☐ **VIN ของโมดูลต่อเข้า `VSENS` ห้ามต่อ 3V3 ถาวร** เส้นเดียวที่ผลกระทบมากที่สุดบนชิ้นนี้

### U7 — DFR0570 buck

| | ตรวจอะไร | ควรได้ | ผล |
|---|---|---|---|
| ☐ | ตัวอักษรบนโมดูลตรงตำแหน่งแพด 1 ของฟุตพรินต์ | อ่านว่า **Vin+** | ______ |
| ☐ | R จาก Vin+ → GND | สูง ไม่ใช่ช็อต | ______ |
| ☐ | R จาก Vo+ → GND | สูง ไม่ใช่ช็อต | ______ |

☐ **ไล่ฟุตพรินต์ด้วยมิเตอร์ก่อนเสียบ** ฟุตพรินต์ที่กลับด้านจะเอาแรงดันแบตขึ้นราง
3.3 V และ Nucleo อยู่ปลายทางนั้น

---

## 2. ขั้วและทิศทาง — ตรวจให้ครบทุกบรรทัดก่อนจ่ายไฟ

สามอาการพังที่ `hardware-interface.md` §5 ระบุไว้ อยู่ในตารางนี้ทั้งหมด: D9 กลับขั้ว,
C11 กลับขั้ว, C19 กลับขั้ว ส่วน D10 เคยต่อกลับมาแล้วหนึ่งครั้งบนบอร์ด FE

### มีขั้ว — ใส่ผิดคืออุปกรณ์พังหรือบอร์ดพัง

| | Ref | อุปกรณ์ | เครื่องหมาย | ต่อไปที่ |
|---|---|---|---|---|
| ☐ | **C11** | 100 µF **63 V** | **+** | `24V_PROT` |
| ☐ | **C19** | 100 µF **35 V** | **+** | `24V_PRE` |
| ☐ | **C21** | 22 µF 16 V | **+** | ราง 3.3 V — **ดัดขาออกให้กว้าง 5.08 มม.** |
| ☐ | **D9** | P6KE33A, DO-15 | **แถบคาด = แคโทด** | `24V_PROT` |
| ☐ | **D10** | 1N4742A 12 V, DO-41 | **แถบคาด = แคโทด** | **ซอร์ส** ของ Q2 |
| ☐ | **D11** | 1N4750A 27 V, DO-41 | **แถบคาด = แคโทด** | **เกต** ของ Q3 |
| ☐ | **D12** | 1N4744A 15 V, DO-41 | **แถบคาด = แคโทด** | **เกต** ของ Q3 (แอโนดไปซอร์ส Q3) |

> **C11 กับ C19 คือคู่ที่ต้องระวังที่สุด** เป็นอิเล็กโทรลิติก 100 µF ทั้งคู่และหน้าตา
> เหมือนกันบนบอร์ด **C11 คือตัว 63 V** อยู่บน `24V_PROT` ซึ่ง D9 clamp ไว้ที่ 53.3 V
> ส่วน C19 เป็น 35 V อยู่บน `24V_PRE` ซึ่งไม่เคยเกิน ~24 V — เอาตัว 35 V ไปใส่บน
> `24V_PROT` คือของที่ผ่านการทดสอบบนโต๊ะแล้วไประเบิดในสนาม

> **D1–D6 ไม่มีขั้ว** CDSOD323-T05LC เป็น TVS **สองทิศทาง** (§3) ตัวป้องกันหัววัด
> ทั้งหกจึงใส่กลับไม่ได้ ตัดหกอย่างออกจากรายการที่ต้องตรวจ

### อุปกรณ์สามขา — ตรวจกับ datasheet ของตัวที่ซื้อมาจริงทุกตัว

| | Ref | อุปกรณ์ | ขา | ระวัง |
|---|---|---|---|---|
| ☐ | Q1 | AO3401A, SOT-23 | 1=G 2=S 3=D | เป็น SMD สามขาตัวเดียวบนบอร์ด |
| ☐ | **Q2** | IRF9540N, TO-220 | 1=G 2=D 3=S, **แท็บ = D** | **เดรนไปฝั่งไฟเข้า ซอร์สไปฝั่งโหลด** — กลับด้านกับการต่อแบบ ideal diode โดยตั้งใจ (§5) |
| ☐ | **Q3** | IRF740, TO-220 | 1=G 2=D 3=S, **แท็บ = D** | เดรนไป `24V_PROT` ซอร์สไป R42 |
| ☐ | **Q4** | BC547, TO-92 | **C B E** เมื่อมองจากด้านหน้าแบน | **ไม่ใช่** E-B-C — 2N3904 ในตัวถังเดียวกันเป็น E-B-C สลับกันแล้วการจำกัดกระแสหายไปเงียบ ๆ |

☐ **เบสกับอีมิตเตอร์ของ Q4 ต้องคร่อม R42** — เบสไปซอร์สของ Q3, อีมิตเตอร์ไป
`24V_PRE`, คอลเลกเตอร์ไปเกตของ Q3 ถ้าสลับ วงจรจะทำงานปกติทุกอย่าง**ยกเว้นไม่มี
การจำกัดกระแสเลย** และจะรู้ตอนเกิดฟอลต์

### แท็บของ TO-220 ทั้งสองตัวมีไฟ

☐ **แท็บของ Q2 อยู่ที่ `24V_PROT` แท็บของ Q3 อยู่ที่ `24V_PRE` และฮีตซิงก์ของมันก็ด้วย**
ถ้าไม่ใช่ชนิดมีฉนวน ห้ามแตะกล่อง สกรูยึด หรือแตะกันเอง

### โมดูลและคอนเนกเตอร์ที่มีกุญแจ

| | Ref | เครื่องหมายบอกทิศ |
|---|---|---|
| ☐ | U3 | แพดสี่เหลี่ยม = **VIN** หัวคอลัมน์ซ้าย ไม่ใช่ขา 1 ของชิป (ขา 1 คือ A0 อยู่ลำดับที่หก) |
| ☐ | U7 | แพดสี่เหลี่ยม = **Vin+** (แพด 1) |
| ☐ | J7 | **ตัดขา CN10-6 บนสายแพรแล้วอุดรู 6** — ถ้าเสียบกลับด้าน ซ็อกเก็ตจะไม่ลง |
| ☐ | CN6 | **ตัดขา CN6-1 แล้วอุดรู 1** — กลับด้านแล้วซ็อกเก็ตเต็มความยาวจะไปชน VIN และไม่ลง |

---

## 3. ขาคอนเนกเตอร์ — ติดป้ายสายทั้งสองปลายทุกเส้น

`hardware-interface.md` §6: คอนเนกเตอร์ 4 ขาที่เหมือนกันสี่ตัว และสายที่เกือบเหมือนกัน
สี่เส้น **สลับ J10 กับ J11 คือสลับ "ในโรงเรือน" กับ "อ้างอิงภายนอก" และข้อมูลยังดู
สมเหตุสมผลอยู่**

| คอนเนกเตอร์ | ขา | สาย |
|---|---|---|
| **J1–J6** | `V` `DQ` `G` | หัววัด **P0–P5**, 5–10 ม., Cat5, DQ ตีเกลียวกับ GND |
| **J9** | `V` `SDA` `SCL` `G` | SHT45 #0 — **หัวโรงเรือน** |
| **J10** | `V` `SDA` `SCL` `G` | SHT45 #1 — **ท้ายโรงเรือน** |
| **J11** | `V` `SDA` `SCL` `G` | SHT45 #2 — **นอกโรงเรือน** ต้องมีฉากกันแดด |
| **J12** | `V` `SDA` `SCL` `G` | SCD41 CO2 — **กลางโรงเรือน**, **`V` กับ `G` ใช้สายคู่** |
| **J13** | `TX` `RX` `G` | USB-serial adapter, USART1 |
| **J14** | `+` `−` | 24 V จาก charge controller — **ขั้วแบตเตอรี่ ไม่ใช่ขา LOAD** |
| **CN6** | 1×8 | ไป CN6 ของ Nucleo ต่อเฉพาะตำแหน่ง **4 (3V3)**, **6** และ **7 (GND)** |
| **J7** | 2×20 | สายแพรไป morpho **CN10** |

☐ `V` และ `G` ของ J12 ใช้**สาย Cat5 อย่างละสองเส้น** เส้นเดียวจะตก 173 mV ตอน SCD41
กระชาก 205 mA ถ้าคู่ขนานเหลือ 86 mV

---

## 4. ลำดับการประกอบ

เตี้ยก่อน เพราะของสูงที่ใส่ก่อนจะบังหัวแร้งไม่ให้ถึงของเตี้ย

☐ **0. ลวดเชื่อมสิบห้าเส้น — ดู §4a ทำก่อนทุกอย่าง**
☐ 1. SMD บนด้านทองแดง — D1–D6, Q1
☐ 2. ตัวต้านทานแกน วางราบ
☐ 3. ไดโอด D9, D10, D11, D12 — **มีขั้ว ดู §2**
☐ 4. คาปาซิเตอร์เซรามิก
☐ 5. Q4 (TO-92) และ header 2.54 — J7, CN6, J13 และ female strip ของ U3 กับ U7
☐ 6. เทอร์มินอล Phoenix J1–J6, J9–J12, J14
☐ 7. อิเล็กโทรลิติก C11, C19, C21 — **มีขั้ว ดู §2**
☐ 8. คลิปฟิวส์และ F1 (T2A, 5×20 มม.)
☐ 9. Q2 และ Q3 (TO-220), Q3 พร้อมฮีตซิงก์ — **แท็บมีไฟ ดู §2**
☐ 10. โมดูลสองตัว ใส่ท้ายสุด หลัง §1 ผ่าน

---

## 4a. ลวดเชื่อมสิบห้าเส้น — ใส่ก่อนทุกอย่าง

**บอร์ดใบนี้ไม่มีการชุบรู** ทุกรูคือทองแดงสองแผ่นที่แยกจากกัน ต่อกันด้วย
ตะกั่วที่คุณบัดกรีเท่านั้น ตรงไหนที่เน็ตต้องข้ามชั้น จะมี **รู 0.8 มม. ที่ร้อยลวดเปลือยแล้วบัดกรีทั้งสองหน้า**
— นั่นคือ via ของบอร์ดใบนี้

**ใส่ก่อนอุปกรณ์ทุกตัว** เพราะพอมีของครอบรูแล้วจะเอาหัวแรงเข้าด้านบนไม่ได้
และ **13 ใน 15 เส้นเป็นกราวด์** — ลวดกราวด์ที่ไม่ได้บัดกรี**ไม่พังแบบชัดเจน
มันทำให้บอร์ด "ใช้ได้ แหละ"** ซึ่งเป็นอาการที่หายากที่สุด

ตัดลวดทองแดงชุบดีบุก 0.5 มม. แยงผ่านรู บัดกรี**ด้านบนก่อน** แล้วพลิกมาบัดกรีด้านล่าง
จากนั้นตัดปลายทั้งสองข้างให้เสมอผิว

**ลวดเย็บพื้นกราวด์ 13 เส้น** — เชื่อมพื้นกราวด์ชั้นบนกับชั้นล่างเข้าด้วยกัน:

| | x | y | | | x | y |
|---|---|---|---|---|---|---|
| ☐ W1 | 6.00 | 6.00 | | ☐ W8 | 56.00 | 81.00 |
| ☐ W2 | 137.00 | 6.50 | | ☐ W9 | 40.39 | 87.63 |
| ☐ W3 | 56.00 | 10.00 | | ☐ W10 | 9.40 | 105.03 |
| ☐ W4 | 100.00 | 21.00 | | ☐ W11 | 106.00 | 114.00 |
| ☐ W5 | 140.00 | 26.50 | | ☐ W12 | 130.00 | 114.00 |
| ☐ W6 | 118.00 | 36.00 | | ☐ W13 | 145.00 | 114.00 |
| ☐ W7 | 43.00 | 52.00 | | | | |

**ลวดสัญญาณ 2 เส้น** — สองเส้นนี้พาเน็ตข้ามชั้น ลืมเส้นใดเส้นหนึ่ง เน็ตนั้นขาดทันที:

| | x | y | เน็ต |
|---|---|---|---|
| ☐ W14 | 59.56 | 34.54 | `DQ_P4` — หัววัด P4 |
| ☐ W15 | 19.81 | 48.13 | `V3V3_MCU` |

**พิกัดนับจากมุมซ้ายล่างของบอร์ด** จุดกำเนิดเดียวกับที่อาร์ตเวิร์กใช้
**W4, W5, W6 และ W2 อยู่มุม 24 V และรับทางกลับของเสิร์จ** — สี่เส้นนี้บัดกรีให้ดี
อย่าบัดเร็ว

☐ **นับให้ครบ: 15 รูที่มีลวดอยู่ข้างใน ก่อนข้อ 1 ของ §4**

---

## 5. ก่อนจ่ายไฟโวลต์แรก

☐ ตรวจครบทุกบรรทัดของ §2 โดยมีบอร์ดอยู่ตรงหน้า
☐ **ลวดเชื่อมทั้ง 15 เส้นของ §4a ใส่และบัดกรีทั้งสองหน้าแล้ว** —
นับให้ครบ 13 เส้นเป็นกราวด์ ซึ่งขาดแล้วอาการซ่อน
☐ `24V_PRE` → GND: **ต้องไม่ช็อต** สะพานตะกั่วที่ขาอินพุตของ U7 มองไม่เห็นบนทองแดง
ที่ไม่มี soldermask และเป็นสิ่งที่วงจรจำกัดกระแสมีไว้รองรับ
☐ `24V_PROT` → GND: ไม่ช็อต
☐ `24V_PROT` → `24V_PRE`: **ต้องไม่ต่อถึงกัน** — มี Q3 คั่นอยู่
☐ ไล่ฟุตพรินต์ของโมดูลทั้งสองด้วยมิเตอร์
☐ ใส่ F1 แล้ว และเป็น **T2A** — เลือกด้วย I²t เทียบกระแสกระชากผ่านบอดีไดโอดของ Q2
ไม่ใช่เลือกด้วยแอมป์
☐ ยืนยัน V_oc ของแผงและยืนยันว่า charge controller ไม่ปล่อยผ่านตอนถอดแบต
(§7 ก่อนขั้นที่ 1)

---

## 6. จ่ายไฟ

| | ขั้นตอน | ควรได้ |
|---|---|---|
| ☐ | จ่าย 24 V ยังไม่ต่ออย่างอื่น | |
| ☐ | `24V_PRE` | **ต่ำกว่า 28 V** ราว 21 V ที่แบต 25 V |
| ☐ | `24V_PRE` ตอนแบตสูงสุด (absorb หรือบังคับ 29.2 V) | **ยังต่ำกว่า 28 V** — เหตุผลทั้งหมดที่มี pre-regulator |
| ☐ | ราง 3.3 V | 3.2–3.4 V **เกิน 3.6 V ให้หยุด** CN6-4 กับ STM32WL พังที่ค่านั้น |
| ☐ | กระแส standby ทั้งบอร์ดที่ `24V_PROT` ตอน gate ปิด | **~0.6 mA** (โมดูล 0.5 + R41 0.1) สูงกว่ามาก = มีอะไรรั่ว ต่ำกว่ามาก = โมดูลไม่ทำงาน |
| ☐ | อุณหภูมิตัวถัง Q3 ตอน SCD41 กระชาก | อุ่นนิดเดียว ร้อน = วงจรจำกัดกระแสกำลังทำงาน |
| ☐ | สแกน I2C ตอนปิดทุกช่อง | **เจอ `0x70` ตัวเดียว** ไม่มี `0x44` ไม่มี `0x62` |

☐ จากนั้นทำ `hardware-interface.md` §7 ที่เหลือให้ครบตามลำดับ

**ห้ามเคลือบบอร์ดจนกว่า §6 จะผ่านครบ** การลอก conformal coating ออกเพื่อซ่อมแย่กว่า
เวลาที่ประหยัดได้ทุกกรณี

---

## 7. บันทึกของบอร์ดใบนี้

```

```
