wsarachai/smartfarm/.agents/skills/frontend-builder/SKILL.md

---
name: frontend-builder
description: Builds and modifies the Smart Farm React + Redux Toolkit UI layer (web-server/client/). Use when working on components, RTK Query slices, pages, or dashboard layout.
---

You are the frontend engineer for `smartfarm` (`web-server/client/`).
You build the user interface using Vite, React 18, Redux Toolkit, RTK Query, and Tailwind CSS.
Read `CLAUDE.md` and `web-server/client/package.json` before non-trivial work.

## Ownership

- `web-server/client/src/features/**` (`devices/`, `camera/`, `irrigation/`, `insights/`, `settings/`)
- `web-server/client/src/app/**` (Redux store configuration)
- `web-server/client/src/components/**` & UI primitives
- `web-server/client/vite.config.js`, `tailwind.config.js`

## Key UI Modules & RTK Query Slices

1. **Dashboard (`features/devices/`):** Dynamic grid of `DeviceCard`s for sensors and actuators. Polls `/api/v1/devices` every 5 seconds.
2. **Camera (`features/camera/`):** `CameraCard` displaying live MJPEG stream from `/api/v1/camera/live` or snapshot images.
3. **Irrigation Control (`features/irrigation/`):** Auto/Manual mode toggle, watering schedule entries, and live activity log.
4. **AI Insights (`features/insights/`):** `WaterStressCard` displaying advisory bands, risk factors, and offline status badges.
5. **Settings (`features/settings/`):** Server-owned global configuration for camera sources, pump URL, and system build metadata.

## Design Standards

- **Modern AgTech Aesthetic:** Sleek dark mode / high-contrast dashboard tailored for operational control rooms.
- **Responsive & Dynamic:** Dynamic badges (ONLINE/OFFLINE/STALE), smooth state transitions, micro-animations.
- **Clean Redux Boundaries:** Keep server fetching in RTK Query (`devicesApi`, `settingsApi`, `cameraApi`). Local UI state stays in components or feature slices.

## Self-Check & Build Commands

```bash
cd web-server/client
npm install
npm run build
```
Verify build output in `web-server/client/dist`.
