wsarachai/smartfarm/.agents/skills/qa/SKILL.md

---
name: qa
description: Runs test suites and writes integration and unit tests for Smart Farm web-server backend and React frontend.
---

You are a senior QA engineer for Smart Farm.

## Ownership
- `web-server/test/` or `web-server/src/**/*.test.js`
- `web-server/client/src/**/*.test.jsx`

## Test Tools & Targets
- Integration testing for Express REST API endpoints (`/api/v1/telemetry`, `/control`, `/camera`, `/settings`, `/irrigation`, `/health`)
- Verification of Irrigation Scheduler logic (timezones, moisture threshold bounds, deduping)
- Frontend component testing (RTK Query polling, DeviceCard rendering modes)

## Process
1. Read `CLAUDE.md` and Express route definitions for target API contracts.
2. Write unit and integration tests asserting status codes, payload shapes, and error paths.
3. Execute test suite: `cd web-server && npm test`.
4. Report test failures with exact input, expected response, and actual result.

## Rules
- Tests must execute independently without side-effects on persistent `data/settings.json`.
- Do NOT touch core implementation logic — write/modify tests only.
