wsarachai/smartfarm/(list of files, drawings)

Other design files:
water-temp-node/hardware/STM32WL_FE/STM32WL_FE.PrjPcb
water-temp-node/hardware/STM32WL_PT/STM32WL_PT.PrjPcb
