wsarachai/smartfarm/(commit log)

2026-06-26 Add Jetson Orin Nano docker and VNC configurations
2026-06-26 Reorganize README and docker-compose files for Jetson setup
2026-06-26 Update README and docker-compose for Jetson setup; add verification notebooks
2026-07-02 Scaffold smartfarm web-server: Dockerized Express + React/Redux dashboard
    Adds the initial blueprint for the Smart Farm Web Control Center per
    web-server/CLAUDE.md: a unified Express server serving telemetry/control
    APIs and a statically-built React+Redux Toolkit dashboard, packaged as a
    multi-stage Docker build for Jetson-class ARM64 hardware.
2026-07-02 Add health endpoint + Docker healthcheck; use npm install in build
    - Add GET /api/v1/health returning status/uptime/deviceCount/timestamp
    - Mount health router above static/SPA fallback in server.js
    - Add dependency-free compose healthcheck (node http.get probe)
    - Switch Dockerfile npm ci -> npm install (no committed lockfiles)
    - Document the new endpoint in CLAUDE.md
2026-07-02 Add ESP32-CAM integration with live streaming and status monitoring
    - Implement camera API with endpoints for frame ingestion, live stream, and status.
    - Create CameraCard component for displaying camera feed and status in the dashboard.
    - Update Redux store to manage camera state and integrate with RTK Query for polling.
    - Enhance CSS for camera display and status indicators.
    - Modify server and Docker configuration to support camera functionality.
2026-07-03 fix: remove unused jetson and nvdli-data files
2026-07-03 Add ESP32-CAM IP Camera project files and initial implementation
    - Created .vscode/extensions.json to recommend PlatformIO IDE extension.
    - Added README.md with project overview, setup instructions, and troubleshooting tips.
    - Introduced secrets.example.h for WiFi and OTA configuration, ensuring sensitive data is git-ignored.
    - Configured platformio.ini for ESP32-CAM with OTA support and dual app slots.
    - Implemented app_httpd.cpp for HTTP server handling, including MJPEG streaming and control UI.
    - Defined camera_pins.h for AI-Thinker ESP32-CAM pin mapping.
    - Developed main.cpp to initialize camera, connect to WiFi, and manage OTA updates.
2026-07-03 Add ap-server: ESP-WROOM-32 SoftAP + DHCP + status page
    PlatformIO/Arduino firmware (board esp32dev) that runs a WPA2 SoftAP with
    the core's DHCP server and a live status page at 192.168.0.1 listing each
    client's MAC and leased IP. Re-implements the AP+DHCP behavior of
    esp-idf-iot/web-server on Arduino, matching esp32cam conventions.
    Defaults mirror the reference wifi_app.h (SSID MJU-SmartFarm-AP,
    192.168.0.1/24, ch 1, max 5) so sensor-node firmware associates unchanged.
    Config in committed include/ap_config.h (no secrets.h). Also documents the
    ESP32 firmware projects in CLAUDE.md.
2026-07-03 ap-server: move AP to 192.168.1.1 as a distinct network
    Change the SoftAP subnet from 192.168.0.x to 192.168.1.x (AP/gateway at
    192.168.1.1, DHCP leases 192.168.1.2+). Combined with the MJU-SmartFarm-AP-II
    SSID, this is now a standalone AP deliberately distinct from the ESP-IDF
    reference (MJU-SmartFarm-AP @ 192.168.0.1), so docs no longer claim
    reference/sensor-node compatibility. main.cpp logic reads addressing from
    ap_config.h; only its comments changed.
    [ap_config.h, main.cpp]
2026-07-03 ap-server: reserve 192.168.1.1-.99, lease DHCP from .100
    Override the SoftAP DHCP address pool via esp_netif_dhcps_option so client
    leases start at 192.168.1.100, keeping .1-.99 free for static servers (the AP
    stays at .1). Pool end is derived as DHCP_POOL_FIRST_HOST + AP_MAX_CONNECTIONS
    - 1 and guarded by a static_assert; only DHCP_POOL_FIRST_HOST is configurable
    in ap_config.h, with start/end IPs computed onto AP_IP's /24. Status page and
    boot log now show the reserved band and DHCP pool.
    dhcps_lease_t holds lwip ip4_addr_t, so addresses are set with IP4_ADDR().
    Builds clean on arduino-esp32 2.0.17 (esp32dev).
2026-07-03 ap-server: MAC->IP reservations via custom DHCP server + web UI
    The built-in ESP DHCP server exposes no MAC-reservation API (and is
    precompiled into the framework lwIP lib, so unpatchable), so stop it and run
    our own on UDP/67, polled from loop(). Reserved MACs get a fixed .2-.99
    address; unknown MACs get a dynamic .100-.109 lease. Reservations are managed
    from a web UI (dashboard with one-click Reserve + delete, /edit form with
    validation) and persisted in NVS via Preferences, surviving reboots.
    New modules: reservations.{h,cpp} (NVS store + MAC helpers) and
    dhcp_server.{h,cpp} (DISCOVER/OFFER/REQUEST/ACK/NAK/RELEASE). Raise
    AP_MAX_CONNECTIONS to 10; add DHCP_LEASE_SECS, MAX_RESERVATIONS.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
    [ap_config.h, dhcp_server.cpp, dhcp_server.h, main.cpp, reservations.cpp, reservations.h]
2026-07-03 esp32cam: obtain IP via DHCP from ap-server + log lease details
    Drop the static WiFi.config() so ap-server's DHCP server assigns the address,
    set the hostname before begin() (so ap-server labels the camera "esp32cam"),
    and log a full block on connect: MAC, obtained IP, gateway, subnet, DNS. The
    MAC lets you add a reservation in ap-server for a fixed address.
    Also mark the static-IP block optional/legacy in secrets.example.h, refresh
    the README, and update local ports (COM6) and the OTA target (192.168.1.3).
    [main.cpp, secrets.example.h]
2026-07-03 ap-server: fix DHCP replies (subnet broadcast) + diagnostics
    Replies were sent to 255.255.255.255, which has no route on an AP-only netif,
    so every OFFER/ACK failed with EHOSTUNREACH (118) and clients never got a
    lease ("unable to connect"). Send to the subnet-directed broadcast
    (apIp | ~netmask, e.g. 192.168.1.255) instead — it routes via the AP netif and
    still reaches every associated station at L2.
    Also hold tentatively-offered leases for 15s so two clients mid-handshake
    aren't offered the same address (was causing NAKs), and add serial diagnostics
    (socket bind, per-packet RX/TX, station-count heartbeat) for bring-up. Pin the
    board to COM9.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
    [dhcp_server.cpp, main.cpp]
2026-07-03 esp32cam: log IP/web-UI status, add heartbeat, fix silent monitor
    Make boot logging explicit and truthful:
    - connectWiFi() verifies DHCP actually assigned an IP (WL_CONNECTED can precede
    GOT_IP) and logs "DHCP OK — IP obtained" or "DHCP FAILED".
    - startCameraServer() now returns bool and logs each server's start result;
    setup() reports "web UI ready" only if the control server actually bound
    (previously it printed "ready" unconditionally).
    - Add a 15s [status] heartbeat (uptime/IP/RSSI/heap) so the monitor shows
    proof-of-life and the current IP even when attached long after boot.
    Fix the silent-monitor issue on the ESP32-CAM-MB (CH340): monitor_rts=0 /
    monitor_dtr=0 so the monitor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
    [app_httpd.cpp, main.cpp]
2026-07-03 Add wireframes and design documentation for Smart Farm Irrigation Dashboard
    - Created initial screen design for Smart Farm Dashboard (screen.png).
    - Added design specifications in DESIGN.md, including color palette, typography, layout, and component guidelines.
    - Implemented HTML structure for Irrigation Control Center with responsive design and interactive elements.
    - Included visual feedback mechanisms for pump control and telemetry data display.
    - Added a new screen design for Smart Farm Irrigation (screen.png).
2026-07-03 web-server: implement dashboard from smart_farm_dashboard wireframe
    Build the "Ceres Edge" dark dashboard (offline-ready): Tailwind via Vite with
    tokens ported from the wireframe, self-hosted fonts (@fontsource), lucide-react
    icons, and Recharts — all bundled, no CDN.
    - AppShell (top nav + mobile bottom nav; only DASHBOARD wired, rest inert),
    StatusHeader wired to /health, pulsing LED indicators.
    - SensorCard per sensor device (metricMeta map: icon/unit for known keys,
    generic fallback), ControlCard actuator toggle -> /control, compact
    CameraStatusCard, and a labeled-PREVIEW AiInsightCard.
    - TrendChart: real Recharts area chart fed by a client-side ring buffer
    (historySlice) since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
2026-07-03 web-server: implement Cameras page from smart_farm_camera wireframe
    Add react-router-dom and a second route (/cameras); the AppShell nav is now
    functional (Dashboard + Cameras active, Irrigation/AI still inert), and the
    dashboard camera card's VIEW links to it.
    CamerasPage: live MJPEG /stream viewport with scanline + grid-bg and a real
    LIVE/STALE/OFFLINE HUD (badge, CAM_ID, viewers, last-frame age) + fullscreen;
    Capture Image downloads /frame.jpg and adds it to a client-side session gallery
    (Recent Captures), Open Snapshot opens the raw frame; Node Metrics shows only
    backend-backed fields (status/last-frame/size/viewers) with a note that
    RSSI/CPU/FPS need firmware telemetry; sensor chips fr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
2026-07-03 docker: switch from alpine to slim image for client build to avoid npm issues on ARM
2026-07-03 web-server: implement Irrigation page from smart_farm_irrigation wireframe
    Adds pump AUTO/MANUAL mode + manual override controls (via the existing
    generic /api/v1/control), a Node Sensors table and Flow Metrics sparkline
    fed by a paired main-pump-node telemetry device, and a live camera preview,
    wired into a new /irrigation route. No new backend endpoints or persistence
    needed — mode and node telemetry ride on the existing generic
    device/metrics model.
2026-07-03 web-server: implement AI Analytics page from smart_farm_AI-Analytics wireframe
    Adds a clearly-labeled SIMULATED inference telemetry feature, since no real
    ML/inference engine exists in this project. Backend exposes a stateless
    GET /api/v1/analytics/latest (values are pure functions of process.uptime(),
    no timers, no persistence, matching deviceStore/frameStore's reactive-only
    style). Frontend polls it into a capped ring buffer (mirrors historySlice)
    and renders AI Engine Stats chips + a real-time confidence trend chart, all
    visibly badged SIMULATED/gold rather than the "online" green language used
    for real device data. Wired into a new /analytics route and nav link.
    Dropped from the wirefra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
2026-07-03 Add DHT22 sensor and soil moisture ADC functionality
    - Implement DHT22 sensor reading in dht22.c and dht22.h, including checksum verification and data extraction for temperature and humidity.
    - Create soil moisture ADC handling in soil_moisture_adc.c and soil_moisture_adc.h, including calibration and voltage-to-percent mapping.
    - Introduce sensor_task.c and sensor_task.h to manage periodic sensor readings and HTTP POST requests for telemetry data.
    - Add WiFi station mode management in wifi_sta.h, allowing connection handling and reconnection logic.
    - Define task settings in task_settings.h for FreeRTOS task configurations.
    - Implement unit tests for DHT22 checksum validation and soil moistur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
2026-07-03 feat: initialize pump-zone project with ESP-IDF and PlatformIO
    - Add .gitignore to exclude build artifacts and secrets
    - Create CMakeLists.txt for project configuration
    - Add README.md with project description and setup instructions
    - Implement configuration header (pump_config.h) for GPIO and HTTP settings
    - Add secrets example header (secrets.example.h) for WiFi credentials
    - Configure PlatformIO with platformio.ini for ESP32 development
    - Define sdkconfig.defaults for reproducible build settings
    - Implement main application logic in main.c
    - Create relay control functionality in relay.c and relay.h
    - Implement RGB LED control in rgb_led.c and rgb_led.h
    - Set up HTTP server for relay contr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
2026-07-03 feat: add SettingsPage for camera configuration and implement camera settings management
2026-07-04 fix: update IP address range in README and configuration files to use 192.168.0.x
    [ap_config.h, dhcp_server.cpp]
2026-07-04 fix: update README and secrets.example.h to clarify DHCP usage and remove static IP configuration
    [app_httpd.cpp, secrets.example.h]
2026-07-04 Update README and camera settings
2026-07-04 pump-zone: add health endpoint and improve HTTP request handling logs
2026-07-04 feat: implement pump control features including API integration, settings management, and UI components
2026-07-04 fix(sensor-zone): correct web-server host + add DEVICE_ID for telemetry
    The migrated sensor-zone joins the AP on 192.168.0.x but still POSTed
    telemetry to the stale 192.168.1.2 (missed in the 192.168.1.x -> .0.x
    migration), so data never reached the web-server. Point WIFI_SERVER_HOST
    at 192.168.0.2:3000 (matches the camera + current topology).
    Also add DEVICE_ID to secrets(.example).h and use it as the telemetry
    device_id, so the node shows on the dashboard as a friendly name
    ("zone-a", matching seed-demo.js) instead of esp32-<MAC>. Drop the
    MAC-derivation code + esp_mac.h include.
    GPIO map verified byte-identical to legacy esp-idf-iot/sensor-node
    (DHT GPIO32, soil ADC_CHANNEL_6, RGB 25/26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
    [secrets.example.h]
2026-07-04 feat(camera): live MJPEG proxy + reliable relay default for the Cameras page
    The Cameras page went black on the deployed server because it streamed
    from a direct-to-camera URL (custom mode) / a pull proxy the browser or
    the Jetson couldn't reach, while the working path is the same-origin PUSH
    relay that /irrigation already uses.
    - Add GET /api/v1/camera/live (src/store/cameraLive.js): the server pulls
    the camera's :81 MJPEG once and fans it out to all viewers same-origin
    (single upstream connection, auto-reconnect, NO SIGNAL on hard-down).
    Camera source via CAMERA_STREAM_URL env. Useful where the server can
    reach the camera's :81; kept as the relay fallback.
    - Default the Cameras pa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
2026-07-04 revert(esp32cam): push interval back to 10000ms
    The 2000ms interval destabilized capture on the power-marginal ESP32-CAM
    (persistent "capture failed" — sensor brownout under frequent UXGA capture
    + WiFi POST bursts). Interval doesn't affect image quality, only cadence,
    so revert to the original 10s for reliable full-quality frames.
    [secrets.example.h]
2026-07-05 feat(pump-zone-esp01): ESP-01/01S Arduino drop-in for the main pump
    Add pump-zone-esp01/: an ESP8266 (ESP-01/01S) firmware that replaces the
    ESP32 pump-zone as the main irrigation-pump controller. ESP-IDF has no
    ESP8266 target, so this is a rewrite on the Arduino stack (ESP8266WebServer
    + ArduinoJson + ESP8266WiFi) keeping the exact /api/v1/relay contract, so the
    Node hub/dashboard need no code changes.
    - Relay on GPIO0 (direct drive, active-high default), forced OFF at boot.
    - Single onboard GPIO2 LED blink codes replace the RGB status LED.
    - Local safety cutoff (dead-man timer, 5 min default, re-armed on each "on").
    - ArduinoOTA (forces pump OFF before flashing) for painless field updates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
    [main.cpp, pump_config.h, relay.cpp, relay.h, secrets.example.h, status_led.cpp, status_led.h]
2026-07-05 docs(camera): document web-server <-> esp32cam protocol + endpoints
    Add web-server/docs/camera-protocol.md covering the two paths (camera
    PUSH snapshot -> /api/v1/camera/frame, and server PULL live proxy of the
    camera :81 MJPEG via /api/v1/camera/live), with a Mermaid diagram,
    endpoint contracts, file:line refs, and tunables.
2026-07-05 docs(camera): add v2 longevity redesign spec (no deep sleep)
    Capture the agreed redesign of the web-server <-> esp32cam integration:
    mains-powered so deep sleep is rejected; instead stay awake with the
    sensor idle between 60s snapshots, slideshow-only live (retire /live),
    a RAM ring of N=90 frames, pull-based config from a host-mounted JSON
    file, health telemetry via /api/v1/telemetry, and a three-layer reboot
    strategy (watchdog + local uptime fallback + server-driven trend-relative
    heap reboot with anti-flap guards). Supersedes camera-protocol.md v1.
2026-07-05 feat(camera-v2): derive stale threshold from snapshot cadence (#1)
    The v2 camera pushes on a duty cycle (default 60s), so the fixed 15s
    liveness window would read every snapshot-cadence camera as offline.
    Derive stale = CAMERA_SNAPSHOT_INTERVAL_MS x CAMERA_STALE_FACTOR (2.5),
    tolerating one dropped push but flipping to STALE after ~2 in a row.
    Bump the firmware push-interval default to 60s.
    Refs #1
    [secrets.example.h]
2026-07-05 feat(camera-v2): retire /live pull-proxy, slideshow-only live (#2)
    The v2 camera no longer runs a continuous :81 MJPEG stream, so there is
    nothing for the server to pull. Remove GET /api/v1/camera/live and
    store/cameraLive.js, drop the CAMERA_STREAM_URL env, and simplify the
    client: the live viewport streams only from the same-origin slideshow
    relay (/stream); RELAY_LIVE_URL and its relay-mode fallback are removed.
    Refs #2
2026-07-05 feat(camera-v2): RAM ring history + frames API + timeline scrubber (#3)
    Generalize the single-slot frameStore into an N-frame RAM ring (default
    90, CAMERA_RING_SIZE) keyed by a monotonic seq; every push appends and
    evicts the oldest, while the latest still backs /frame.jpg and /stream.
    Add GET /api/v1/camera/frames (metadata, newest-first) and
    GET /api/v1/camera/frames/:seq (one JPEG, 404 once evicted).
    Client: replace the client-session RecentCaptures gallery and the manual
    Capture button with a single server-backed timeline scrubber (slider +
    thumbnail strip, LIVE snap-back, seq-addressed so it survives eviction)
    and a "Download current frame" action.
    Refs #3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
2026-07-05 feat(camera-v2): camera health telemetry + real Node Metrics (#4)
    Camera POSTs {free_heap, rssi, uptime_s, fw_version} to the existing
    /api/v1/telemetry endpoint each cycle as device_id "esp32cam", so it
    surfaces as a normal device card with no new server infra. #ifndef
    guards keep an older secrets.h compiling (empty TELEMETRY_URL disables).
    Dashboard Node Metrics now shows real RSSI / free heap / uptime /
    firmware, replacing the "not yet reported" stub.
    Refs #4
2026-07-05 feat(camera-v2): pull-based camera config from host-mounted JSON (#5)
    Server-owned camera behavior config the camera pulls each cycle and the
    dashboard writes. New store/cameraConfig.js persists to a host-mounted
    JSON file (CAMERA_CONFIG_PATH, default /data/camera-config.json) via
    atomic temp+rename, seeding defaults from env when absent, with range
    validation and a ring_size x max-frame-bytes RAM guard. New GET/POST
    /api/v1/camera/config; stale threshold + ring capacity now track the
    live config. docker-compose mounts ./data:/data.
    Camera: GET /config each cycle (ArduinoJson) and apply interval /
    framesize / quality / enabled deltas; config is fetched even while
    disabled so it can be re-en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
2026-07-05 feat(camera-v2): server-driven health reboot + watchdog + DEGRADING (#6)
    Server: new store/cameraHealth.js tracks per-camera post-boot baseline
    heap and reboots/day (reset at local midnight via the Jetson RTC), fed
    from the telemetry route. It commands a reboot when free heap falls
    below 50% of baseline, guarded by uptime > 1h and <= 3 reboots/day;
    past the cap it stops rebooting and flags DEGRADING instead of looping.
    The decision rides in the transient `reboot` field of GET /config and
    the `degrading` field of /status.
    Camera: obey `reboot:true` after reading the config body; arm the task
    watchdog (30s, fed each loop) for acute hangs; keep a local uptime
    fallback reboot for when the serve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
    [main.cpp]
2026-07-05 docs(camera-v2): mark redesign implemented; resolve open items
    Update status to implemented (#1-#6), record the resolutions of the
    §10 open items (framesize applied live, heap-driven reboot shipped in
    place of the quiet-hour trigger, RAM ceiling enforced), and add firmware
    bring-up caveats (ArduinoJson dep, new secrets keys, watchdog timing).
2026-07-05 test(seed-demo): seed camera-v2 frames + health telemetry
    Extend the demo seeder to push a valid JPEG into the frame ring and
    report ESP32-CAM health (heap/rssi/uptime/fw) as device_id esp32cam, so
    the Cameras page slideshow/scrubber/Node Metrics and the health tracker
    have data. Heap stays above the reboot floor so the demo never trips a
    health reboot.
2026-07-05 feat(pump-zone-esp01): add device watchdog (hang + lost-link recovery)
    The pump node had no recovery path if the device itself misbehaved. Add
    src/watchdog.{cpp,h} with two layers:
    - Acute-hang watchdog: arm the ESP8266 software watchdog (WDT_TIMEOUT_MS,
    8s) and feed it each loop; a wedged loop stops feeding and the chip
    resets (the ~8s hardware watchdog backstops it).
    - Lost-link recovery: if WiFi stays disconnected past WIFI_RECOVER_MS
    (2 min) the node can't be commanded OFF, so force the pump OFF and
    reboot to recover the link/DHCP. Sits below PUMP_MAX_RUN_MS and
    complements WiFi.setAutoReconnect().
    Both windows are tunable in include/pump_config.h (WIFI_RECOVER_MS=0
    disables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
    [main.cpp, pump_config.h, watchdog.cpp, watchdog.h]
2026-07-05 feat(pump): report sensorless pump node as "n/a" instead of fake data
    The pump hardware has no onboard sensors, but the Irrigation page's Node
    Sensors table + Flow Metrics showed fabricated numbers (from the seed).
    Make the pump node still report ("sending data") with every sensor
    reading as "n/a":
    - pump.js mirror() also upserts main-pump-node with n/a readings, so the
    real deployment shows the node reporting-but-n/a whenever the pump is
    polled (no firmware change; the pump has no sensors to add).
    - seed-demo sends the node as n/a rather than fake pressure/flow/temp/
    voltage numbers.
    - Irrigation Node Sensors always lists the known keys (n/a when not a
    number, dimmed); Flow Metrics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
2026-07-06 feat(web-server): persist all Settings-page config to server-side JSON
    The Camera Source and Pump Control blocks on the Settings page lived
    per-browser in localStorage; only the camera device config was durable.
    Move both to global, server-owned config persisted to data/settings.json
    (atomic write, env-seeded defaults, loaded at boot) so they survive
    restart and are shared by every client — matching camera-config.json.
    - add settingsStore.js (generic { cameraSource, pump } store) + GET/POST
    /api/v1/settings (partial patch, deep-merge, server-authoritative validate)
    - pump relay reads url + autoOffMinutes from settings; client posts { state }
    only and /status drops the target arg
    - cli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
2026-07-06 feat(dashboard): order device widgets by category
    The dashboard sensor grid rendered devices in arbitrary Map insertion
    order, so real sensors, the pump node, and the camera were interleaved.
    Sort them into a stable category order: sensor -> pump -> camera -> other,
    then alphabetically by device_id within each bucket.
    Classification stays hardware-agnostic (deviceCategory.js): only pump/camera
    are keyword-special-cased; any other device reporting a numeric reading
    counts as a sensor and sorts first, so new sensor types need no code changes.
2026-07-06 feat(camera): expose frames to AI container via HTTP pull (ETag/304)
    For AI inference, the AI container pulls camera images from the web-server
    over a shared docker network instead of writing frame files to the SD card
    — frames stay in the existing RAM ring, honoring the no-SD-wear principle.
    - GET /api/v1/camera/frame.jpg gains ETag(=seq) + Last-Modified + X-Frame-Seq
    and answers If-None-Match with 304, so the AI only infers on new frames;
    /status now exposes seq too.
    - docker-compose.yaml: add a shared bridge network (smartfarm-net) the AI
    service joins to reach the server at http://web-server:3000.
    - docker-compose.ai.yaml overlay (Jetson-only, runtime: nvidia): runs the
    prebui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
2026-07-06 fix(compose): let AI overlay run as its own command via external network
    Running `docker compose -f docker-compose.ai.yaml up` alone failed with
    "service ai refers to undefined network smartfarm-net" because the network
    was only defined in the base file. Give smartfarm-net an explicit name in the
    base and declare it `external` in the overlay, so the base creates it and the
    overlay attaches — the two can be brought up as independent commands (base
    first). Docs updated to the two-step flow.
2026-07-06 feat(irrigation): real editable AUTO-mode schedule with moisture guard
    AUTO mode was a cosmetic toggle + static schedule preview. Make it a real
    server-run watering scheduler (the pump firmware has no clock).
    - settingsStore: new irrigation section { auto, timezone, moistureThreshold,
    entries[{id,label,start,durationMinutes,days,enabled}] } with validation
    - scheduler: ~20s tz-aware tick (Intl, DST-safe), fires matching entries,
    moisture-guarded (skip if avg soil_moisture >= threshold; run if unknown),
    per-day dedup, no catch-up on missed minutes
    - pumpControl: extracted shared relay + auto-off timer + state mirroring so the
    route and scheduler share one command path; a run ends via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
2026-07-06 feat(irrigation): log every pump action and show an Activity Log
    Record each actuation + decision (manual ON/OFF, scheduled ON, auto-off,
    moisture-guard skips, and failed/unreachable attempts) with its source and
    outcome, and display them on the Irrigation page.
    - store/pumpLog.js: bounded in-memory ring (default 500, env PUMP_LOG_MAX)
    atomically persisted to /data/pump-log.json on each append, loaded at boot;
    best-effort writes so logging never breaks actuation. Pump actions are
    sparse, so per-event writes are negligible SD wear.
    - pumpControl.command() threads source/label and logs on/off success+failure;
    armTimer() logs the auto-off tagged with the run it ended; scheduler logs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
2026-07-06 feat(insights): rule-based Water Stress Estimation; retire AI simulator
    First AI feature (see docs/ai-features-roadmap.md): a real, transparent
    rule-based water-stress advisory over existing sensor telemetry — no model,
    no dataset, no image pipeline.
    - insights/waterStress.js: risk low/medium/high/unknown from soil moisture
    (required + fresh) with a hot&dry / cool&humid evaporative-demand adjust;
    temp/humidity optional. current() recomputes fresh per read (badge tracks
    telemetry), smoothed against a ~60s-tick ring
    - waterStressStore.js: persisted risk history (/data/water-stress-history.json),
    appended every ~5 min (coarse cadence, modest SD writes), loaded at boot
    - settingsStore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
2026-07-06 feat(insights): Canopy Coverage (feature 2) — HSV green-pixel %
    Second AI feature and first VISION insight (see docs/ai-features-roadmap.md):
    % green canopy via classical HSV thresholding (no model), on the smartfarm-ai
    service architecture — same orchestrator pattern as water stress.
    - smartfarm-ai: canopy.py (PIL+numpy: downscale -> HSV mask -> canopyPercent +
    factors + green-mask preview PNG); ai_service.py POST /canopy (raw JPEG body
    + HSV params as query).
    - web-server: src/insights/canopy.js orchestrator grabs the latest RAM frame,
    POSTs it to CANOPY_SERVICE_URL, smooths, caches (+ mask in RAM), persists
    history, degrades (aiOnline; no fresh frame -> unknown). canopyStore.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
2026-07-06 feat(insights): Disease Detection (feature 3) — PlantVillage CNN, on-demand
    Third and final roadmap AI feature: a pretrained PlantVillage classifier
    (default MobileNetV2, config-driven) that labels a frame healthy vs disease.
    On-demand only (inference is heavy — no background tick). Same smartfarm-ai
    orchestrator architecture as water stress + canopy.
    - smartfarm-ai: disease.py config-driven loader (models/model_config.json +
    disease.pth, torch imported LAZILY on first call) -> whole-frame 224 +
    ImageNet norm -> softmax -> top-k; honest "model not loaded" when absent.
    ai_service.py POST /disease. download_model.sh + gitignored models/ (weights
    fetched at deploy, never committed;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
2026-07-06 feat(disease): weight converter for Daksh159 PlantVillage MobileNetV2
    Turn the placeholder download into a real, verified setup for the community
    checkpoint (torchvision MobileNetV2, 38 PlantVillage classes, ImageNet norm).
    - convert_weights.py: loads models/mobilenetv2_plant.pth into a torchvision
    MobileNetV2, normalizes it (handles full-model / wrapped / DataParallel
    state_dicts), re-saves a clean state_dict in LEGACY format (readable by the
    Jetson's old torch), and writes model_config.json with the correct label
    order from class_names.json (downloads it if missing). Run inside the
    container: docker exec smartfarm-ai python3 /smartfarm-ai/convert_weights.py
    - download_model.sh: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
2026-07-06 fix(disease): ASCII-only converter output (Py3.6 container stdout)
    The container's Python 3.6 stdout is ASCII, so an em-dash in a warning crashed
    with UnicodeEncodeError before the (non-fatal) class-count mismatch could be
    handled. Make all output ASCII and print a clear diagnostic of
    checkpoint-classes vs class_names.json-labels + head type.
2026-07-07 fix(seed-demo): drop dead pump `mode` field to match current UI
    AUTO/MANUAL is now server-global (settings.irrigation.auto); the UI no
    longer reads a per-device `mode`, so seeding `mode: 'auto'` was stale
    data. Keep `running` (the field the Irrigation pump panel still reads).
2026-07-07 feat(dashboard): reorder widgets pump -> camera -> sensor -> trend -> ai
    Restructure Dashboard.jsx so blocks flow in reading order: pump, water
    stress, sensor cards, full-width trend chart (grouped with the sensor
    data it plots), then camera + disease, then other actuators. Keeps live
    status/controls up top for a control center rather than an analytics-
    first layout.
2026-07-07 feat(i18n): bilingual TH/EN scaffold + translate dashboard
    Add a zero-dep i18n layer (context + en/th JSON + useT hook), default
    Thai with English fallback, per-browser localStorage persistence, and a
    header language toggle beside the Settings gear. Bundle Noto Sans Thai
    as a per-glyph fallback across all font stacks so Latin stays in
    Hanken/JetBrains and Thai renders correctly.
    Translate the header nav and the full Dashboard (sensor/control/camera/
    pump cards, metric labels, status words). Device IDs, ON/OFF, units, and
    the product title stay English by design; server-generated strings are
    out of scope. Remaining pages (irrigation, cameras, insights, settings)
    follow the same pattern next.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
2026-07-07 feat(i18n): translate the Irrigation page
    Translate IrrigationPage (pump control panel/visual, flow metrics, node
    sensors table, header chips), ScheduleEditor (schedule form, status
    readout, day labels, timezone), and ActivityLog (log-line templates via
    a t-aware describe()). Backend-supplied error/note/reason text stays
    English per scope.
2026-07-07 feat(i18n): translate the Cameras page
    Translate CamerasPage — status bar, live viewport HUD labels, history
    scrubber, node metrics rows, sensor chips, and action buttons. Source
    labels and firmware-metric labels localized; device IDs, units (dBm/KB),
    RSSI, and CAM_ID tokens stay English per scope.
2026-07-07 feat(i18n): translate the Settings page
    Translate all Settings sections — camera source, camera device control,
    pump, water-stress thresholds, canopy HSV, disease confidence, and
    About/System Info — plus save/reset buttons and error messages. Field
    keys map to a nested settings.* dictionary; technical placeholders,
    URLs, resolution codes, and build values stay as-is.
    This completes the bilingual TH/EN sweep across every dashboard page.
2026-07-07 fix(irrigation): spin pump icon on scheduled (auto-mode) runs
    PumpVisual gated the fan animation on `mode === 'manual'`, so a pump
    started by the schedule (auto mode) showed a static icon labeled
    "Standby". Spin and show "Running" whenever the relay is actually on,
    regardless of mode; keep Standby/Stopped for the idle auto/manual cases.
2026-07-07 feat(settings): live HSV range preview for Canopy Detection
    Add a reactive swatch below the canopy inputs: a hue spectrum bar with
    the selected [hueMin,hueMax] window bracketed, plus a strip of that hue
    range drawn at the chosen sat/val floor (exact HSV->RGB) so the two
    floor values become visible. Updates as you type; shows a validation
    hint while hueMin >= hueMax. TH/EN captions added.
2026-07-20 Add Jetson enclosure fan controller implementation
    - Introduced control logic for fan operation based on thermal readings and DHT22 sensor data.
    - Implemented DHT22 sensor reading functionality with multi-threading for real-time data acquisition.
    - Created Fan class to manage GPIO operations for the external fan, including state management and dwell time enforcement.
    - Developed logging utility for error and info messages.
    - Implemented network communication for telemetry data posting and override fetching.
    - Added thermal zone reading functionality to monitor system temperatures.
    - Created a systemd service file for managing the daemon lifecycle.
    - Included unit tests for control logic to e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
    [config.cpp, config.hpp, control.cpp, control.hpp, dht22.cpp, dht22.hpp, fan.cpp, fan.hpp]
2026-07-21 Add DS3231 host timekeeping scripts and Jetson host-setup docs
    The RTC sync was configured by hand directly on the Jetson and existed
    nowhere else — unrecoverable after a reflash. This captures it in the
    repo, in a python/ tree kept separate from the C++ daemon since it is
    one-shot host provisioning rather than part of the control loop.
    Fixes carried over from the hand-written /usr/local/bin/ds3231_sync.py:
    - Check the oscillator-stopped flag. A flat backup cell made the chip
    return 2000-01-01, which the original set as the system clock and
    RemainAfterExit=yes then pinned for the whole boot — breaking TLS,
    apt, telemetry timestamps and the irrigation scheduler's weekday
    math. N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
    [ds3231.py, ds3231_sync.py, ds3231_writeback.py]
2026-07-21 Fix CMake usage for JetPack 4.x (CMake 3.10.2)
    target_link_directories() is 3.13+, so configure failed outright on the
    Jetson with "Unknown CMake command". Replaced with directory-scoped
    link_directories() placed before the target, which is what 3.10 has.
    The daemon is compiled on the target, so 3.10.2 is a hard floor rather
    than a preference. Also corrected three newer invocations that would
    have failed immediately after configure:
    cmake --build -j <N> 3.12 -> cmake --build build -- -j$(nproc)
    cmake --install 3.15 -> make -C build install
    ctest --test-dir 3.20 -> cd build && ctest
    in the README and the VS Code build task, and listed them as banned at
    the top of CM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
2026-07-21 Fix remaining CMake 3.13+ invocations for JetPack 4.x
    cmake -S . -B build is 3.13+, so on the Jetson's 3.10.2 "build" was
    parsed as the source directory and configure failed before it started.
    Same release as target_link_directories(), missed in the previous pass.
    Switched the documented build, the tests comment and the VS Code tasks
    to the classic in-build-dir form (mkdir build && cd build && cmake ..,
    then make -j). README now carries the full table of banned newer forms
    rather than the three that happened to surface first.
    Verified building on the target.
2026-07-21 Correct GPIO pin map against real hardware
    The line offsets were placeholders that had never been checked on the
    board. gpioinfo on the target shows line 194 (header pin 15), documented
    as the fan output, is held by the SD card-detect driver ("cd" [used]) --
    libgpiod would have refused the request at daemon startup, and driving
    it risks the boot device.
    Fan moves to line 200 / header pin 31 ("GPIO11"), verified unused. Plain
    GPIO with no alt-function, and it leaves the PWM-capable line 38 free in
    case the relay is later replaced with a variable-speed fan.
    DHT22 settles on line 149 / header pin 29 ("GPIO01"), also verified
    unused, replacing the 216 placeholder.
    Also records the known-free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
2026-07-21 Fix unit ExecStart path and report GPIO failures with detail
    ExecStart pointed at /usr/sbin/jetson-ctrl, but CMAKE_INSTALL_PREFIX
    defaults to /usr/local, so make install puts the binary in
    /usr/local/sbin. The service could never have started as shipped --
    it failed 203/EXEC and Restart=always turned that into a 2-second
    restart loop. /usr/local is the right prefix for locally-built software
    on Ubuntu, so the unit moves to match.
    fan.cpp threw a bare "cannot request output line" with no chip, offset
    or errno, which made an EBUSY from a placeholder offset pointing at the
    SD card-detect line indistinguishable from a wiring fault. All three
    failure paths now name gpiochip:offset and strerror,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
    [fan.cpp]
2026-07-21 Add a config.json parameter manual, fix compiled-in GPIO defaults
    docs/config-reference.md documents every key: defaults, which top-level
    objects are required, the validation rules that reject an edit, and the
    reasoning behind the numbers -- why there are two independent triggers,
    why the on/off gap is a deadband, why dht22_min_interval_ms cannot go
    below 2000, and that enclosure_air_on_c should be set from the least
    heat-tolerant part in the box rather than from the Nano.
    Also records the traps this bring-up hit: active_high must be
    bench-tested because fail-to-ON makes an inverted setting look like
    working hardware, and control_tick_ms interacts with WatchdogSec=15.
    config.hpp still carr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
    [config.hpp]
2026-07-21 Update device_id in config.example.json to match the unit identifier
2026-07-21 Set active_high false: the relay module is active-low
    Identified by the fan running whenever the daemon was stopped. An
    unclaimed GPIO reverts to input and floats or pulls low, which an
    active-low relay IN reads as asserted -- so the module energises exactly
    when nothing is driving it.
    active_high: false makes logical ON drive line 200 low, which is what
    actually closes this relay. No code change: fan.cpp already maps
    logical->electrical through active_high_.
    Consequence recorded in host-setup.md: the fan runs during any window
    where the daemon does not hold the line, including between power-on and
    jetson-ctrl starting.
2026-07-21 Update status: running on the target
    The daemon and the DS3231 scripts are no longer unverified scaffold.
    Confirmed by hand on the Jetson: builds under CMake 3.10.2, the DHT22
    bit-bang decodes cleanly (23.8 C / 66.2 %, enclosure_stale false), 2/2
    thermal zones resolve, the fan line drives a real active-low relay and
    sits off at rest, and telemetry reaches the web-server. The RTC scripts
    are installed and the chip migrated to UTC.
    States what remains unproven rather than implying it is all done:
    unattended reboot, the remote override path, and any sustained run --
    plus, for the RTC, a reboot with the network unplugged, which is the
    only test that actually exercises what the DS3231 is for.
    R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
2026-07-21 Record that clocks and the built-in fan stay on auto
    /etc/rc.local ran jetson_clocks and pinned the built-in fan to PWM 128
    at boot. Found by content search after the constant builtin_fan_pwm in
    telemetry gave it away; removed on the target.
    jetson_clocks disabled DVFS, so the Nano ran at maximum frequency and
    near-maximum heat permanently -- while control.temp_on_c was chosen
    against a normally-scaling SoC. The echo 128 was also not what it
    appeared: one-shot, with thermal-fan-est still bound to the pwm-fan
    cooling device, so the governor overwrote it as soon as a trip point was
    crossed. The manual value held only while the box was cool and yielded
    exactly when it got hot.
    Both contradict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
2026-07-21 Fix cpufreq sysfs path, add governor and cooling-device checks
    The verification snippet used /sys/devices/cpu/... which does not exist;
    the real path is /sys/devices/system/cpu/. Also checks scaling_governor
    and scaling_min_freq, which are the actual tell for whether DVFS is back
    -- jetson_clocks sets the performance governor and raises the frequency
    floor to the ceiling, so the governor name says more than a single
    current-frequency reading.
    Notes that target_pwm 0 on a cool box is auto mode working rather than
    missing (the Nano's fan trip points sit near 50 C), with a
    cooling_device listing to confirm the governor actually has a handle on
    the fan.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
2026-07-21 Set active_high true for the external fan configuration
2026-07-24 Add RHYX M21-45 (GC2145) camera module support
    The RHYX M21-45 is a GC2145 with no hardware JPEG encoder, so the
    OV3660 profile's PIXFORMAT_JPEG makes esp_camera_init() fail with
    ESP_ERR_NOT_SUPPORTED and boot-loop. Add a second module profile that
    captures RGB565 and compresses in software, selectable via a macro in
    camera_module.h (or -DCAMERA_MODULE_RHYX_M21_45 / the esp32cam_rhyx env).
    - camera_module.h: per-module compile-time profiles (pixel format, XCLK,
    framesize ceiling, fb config, quality scale).
    - camera_frame.{h,cpp}: sensor-agnostic JPEG grab that hides the hardware
    vs software encode path; owns the framesize ceiling and quality mapping.
    - Software path uses fb_count=2 + GR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
    [app_httpd.cpp, camera_frame.cpp, camera_frame.h, camera_module.h, main.cpp]
2026-07-24 Fix flash LED never lighting on Arduino-ESP32 core v3
    Core v3 made the LEDC API pin-based (ledcWrite(pin, duty)); v2 was
    channel-based (ledcWrite(channel, duty)). setupLedFlash()/control_handler
    wrote LED_LEDC_CHANNEL (2) on v3, which addresses GPIO2 instead of the
    flash LED on GPIO4, so it never lit. Write the pin on v3 via a new
    LED_LEDC_TARGET macro; v2 path unchanged.
    [app_httpd.cpp]
2026-07-24 Reinit camera on framesize change for both modules
    The OV3660's live set_framesize wasn't taking effect (resolution
    wouldn't switch). Instead of relying on live re-windowing, do a full
    deinit+reinit at the new size on both the hardware-JPEG and software
    paths — the one path that reliably changes resolution on any sensor.
    To keep reinit safe (it frees the frame-buffer pool), the grab now
    copies the JPEG into an owned PSRAM buffer and returns the camera
    buffer before releasing its lock, so no buffer is ever checked out
    across a reinit. Reinit re-applies the module tuning and current
    quality afterward (a reinit resets the sensor).
    [camera_frame.cpp]
2026-07-27 Fix disease detection: TFLite backend for armv7l + random-backbone bug
    Disease detection was returning "model not loaded" on the Raspberry Pi, and
    would have returned garbage even once loaded. Three separate defects:
    1. No inference runtime on the Pi. PyTorch publishes zero 32-bit ARM wheels
    on PyPI, so `import torch` can never succeed on an armv7l host. disease.py
    now has two backends selected by model_config.json's "runtime" (inferred
    from the weights extension): "torch" (.pth) for Jetson/x86, and "tflite"
    (.tflite) for the Pi. The Dockerfile installs tflite-runtime==2.14.0 — the
    newest release with a cp311 armv7l wheel, whose manylinux_2_34 floor is met
    by bookworm's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
2026-07-27 Thread the AI service and surface failed Analyze in the UI
    Clicking Analyze appeared to do nothing. The endpoint itself was fine (6/6
    successful probes), but two defects combined to make a transient failure
    indistinguishable from a dead button.
    Silent failures: analyzeDisease's onQueryStarted swallowed errors, and both
    DiseasePanel and DiseaseCard destructured only { isLoading } from the
    mutation. On failure the cached headline stayed put and the button simply
    re-enabled, with nothing shown to the user. Both now read isError and render
    a message (disease.analyzeFailed, en + th), and call reset() on click so a
    retry starts clean. The empty catch stays -- it deliberately preserves the
    last go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
2026-07-30 Add new agents for Smart Farm project and enhance AI model validation
    - Introduced `frontend-builder` agent for managing the React + Redux Toolkit UI layer.
    - Added `library-extractor` agent to extract reusable modules from Smart Farm.
    - Created `log-analyzer` agent for investigating production issues via log analysis.
    - Implemented `network-investigator` agent to analyze IoT network communications.
    - Developed `performance-reviewer` agent to evaluate code efficiency on Jetson Nano hardware.
    - Established `qa` agent for running test suites and writing integration/unit tests.
    - Added `security-reviewer` agent to assess code for IoT security vulnerabilities.
    - Created `test-reviewer` agent to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
2026-07-30 Add environment configuration and sensor interfaces for Jetson Nano and Raspberry Pi 3B
2026-07-30 Enhance README and template documentation for Raspberry Pi 3B configuration
2026-07-30 feat: Implement enclosure fan controller (edge-ctrl)
    - Add DHT22 sensor reading functionality with multi-threading for reliable temperature and humidity sampling.
    - Introduce Fan class to manage GPIO for the external fan, enforcing minimum on/off dwell times to prevent chatter.
    - Implement logging functionality for better debugging and monitoring.
    - Create main control loop to handle thermal readings, fan control decisions, and telemetry reporting.
    - Add network communication for telemetry and remote override capabilities.
    - Include unit tests for control logic to ensure reliability and correctness.
    - Set up systemd service for automatic management and monitoring of the daemon.
    - Remove old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
    [config.cpp, config.hpp, control.cpp, control.hpp, dht22.cpp, dht22.hpp, dht22.py, ds3231.py]
2026-07-30 feat: Update DHT22 and Relay interfaces for Edge Devices with auto-detection and enhanced error handling
    [dht22.py, ds3231_sync.py, relay.py]
2026-07-30 feat: Enhance error handling and line detection in DHT22 and Relay interfaces
    [dht22.py, relay.py]
2026-07-30 feat: Enhance GPIO chip detection and diagnostics in DHT22 and Relay interfaces
2026-07-30 feat: Update DHT22 and Relay interfaces for improved GPIO chip detection and error handling
    [dht22.py, relay.py]
2026-07-30 feat: Enhance GPIO chip detection and fallback mechanisms in DHT22 and Fan interfaces; add auto-fallback for thermal zones
2026-07-30 feat: Add support for libgpiod v2 in DHT22 and Fan interfaces; enhance GPIO handling and initialization
2026-07-30 feat: Add configuration files for Jetson Nano and Raspberry Pi 3B; update install script to use new templates
2026-07-30 feat: Add pre-configured templates for Raspberry Pi 3B and Jetson Nano; enhance README and hardware spec documentation
2026-07-30 chore: remove obsolete firmware build workflows for esp32cam, pump-zone, and sensor-zone
2026-07-30 feat: implement sorting functionality for sensor metrics and update localization strings
2026-07-30 feat: enhance TrendChart component with slot indicators and custom tooltip functionality
2026-07-31 feat: enhance sorting logic in SensorCard; switch to label-based comparison for metrics
2026-08-17 feat: scaffold smartfarm-cloud Amplify Gen2 + Next.js project
    Cognito-gated dashboard, DynamoDB telemetry table (90-day TTL via raw
    CDK construct), IoT Core ingestion rule + least-privilege hub policy,
    and Lambda functions for telemetry ingest / history read / pump
    command via Device Shadow.
2026-08-17 feat: add AWS IoT bridge for real-time telemetry + cloud pump control
    Hub-side half of the cloud pipeline: publishes every telemetry update
    to AWS IoT Core (mutual-TLS MQTT, plain `mqtt` client — avoids the
    native aws-crt dependency aws-iot-device-sdk-v2 requires, a poor fit
    for old Jetson/RPi glibc baselines) and executes Device Shadow delta
    commands. Pump commands route through the existing pumpControl.command()
    safety path (auto-off timer, pump-log, irrigation-AUTO guard); other
    devices fall through to the existing deviceStore.applyCommand(). Chains
    onto telemetryStore's existing listener rather than replacing it, since
    deviceStore.setTelemetryListener is single-slot. Missing/invalid AW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
2026-08-17 docs: add /docs architecture spec; fix cloud/hub shadow contract mismatch
    Adds docs/architecture.md (whole-system reference: layers, components,
    data flows, design principles) and docs/aws-cloud-bridge.md (the new
    AWS pipeline's design detail and wire contract).
    Writing the wire-contract section surfaced a real bug: awsIotBridge.js
    expected shadow deltas shaped {state:{command:{device_id,action}}}, but
    smartfarm-cloud's sendPumpCommand actually writes desired state keyed
    by device_id ({state:{desired:{[deviceId]:{state}}}}), which AWS IoT
    delivers as {state:{[deviceId]:{...}}} in the delta — not re-wrapped.
    As shipped, a cloud pump command would have silently done nothing on
    the hub. Fixe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
2026-08-17 docs: add step-by-step AWS IoT Core provisioning guide
    docs/aws-iot-setup.md walks through registering a hub as an IoT Thing,
    generating its X.509 cert, attaching smartfarm-hub-policy, finding the
    account's data-plane endpoint, and configuring web-server's AWS_IOT_*
    env vars — with CLI commands to verify both the telemetry and command
    paths end-to-end, plus a troubleshooting table. Cross-linked from
    architecture.md and aws-cloud-bridge.md. Also gitignores web-server/certs/
    since this doc has users put their private key there.
2026-08-17 fix: add explicit .ts extensions to amplify/ relative imports
    ampx sandbox's CDK Assembly step runs amplify/*.ts through Node's own
    native TypeScript loader (not tsx/esbuild), which — unlike bundlers —
    does not resolve extensionless relative specifiers, causing
    "Cannot find module '.../amplify/auth/resource' imported from
    .../amplify/backend.ts" on every sandbox deploy attempt. Confirmed the
    mechanism with a minimal two-file repro under `node a.ts` before
    touching this code, and confirmed the fix by running backend.ts
    directly through Node afterward (resolves cleanly, stops only at the
    expected "no CDK context" point that only ampx's real sandbox process
    gets past). Added allowImportingT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
2026-08-17 fix: pass CfnPolicy.policyDocument as an object, not a JSON string
    CDK's CfnPolicy L1 construct serializes policyDocument into the
    CloudFormation template itself and expects a plain object — the
    JSON.stringify(...) wrapper failed its runtime prop validation with
    "Supplied properties not correct for CfnPolicyProps: policyDocument
    ... should be an 'object'" during CDK Assembly. Removed the
    stringify; the object literal is unchanged otherwise.
2026-08-17 docs: correct AWS IoT setup guide from live end-to-end debugging
    Walked a real deployment through Step 10 and found the doc itself was
    wrong in two ways:
    - Told readers to use `npm start`, which never loads .env (no
    --env-file flag) — only `npm run dev` does, matching this project's
    existing convention for every other .env-configured value.
    - The "repeated connection error" troubleshooting row assumed a visible
    error message. Verified empirically (openssl s_client for TLS,
    aws iot list-thing-principals for authorization) that a cert not
    attached to its Thing produces a *silent* reconnect loop instead —
    TLS always succeeds with any valid AWS-issued cert, but
    ${iot:Connectio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
2026-08-17 fix: grant iot:Publish on shadow/update in the hub IoT policy
    Verified end-to-end (Step 11 of the setup guide) with a real deployed
    policy and a real hub connection: sending a Device Shadow command
    connected fine, received the delta fine, but then the connection
    dropped into a fast permanent reconnect loop the instant a command was
    processed.
    Root cause: the policy granted iot:UpdateThingShadow/iot:GetThingShadow
    on a topic ARN — those are Data Plane REST/HTTPS API actions (correctly
    used by smartfarm-cloud's dashboard-api Lambda via UpdateThingShadowCommand,
    which calls the HTTPS API), not MQTT actions. Over MQTT, publishing to
    $aws/things/{thing}/shadow/update requires iot:Publish speci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
2026-08-17 docs: document the shadow/update iot:Publish permission bug
    Cross-reference the fix from the previous commit into both docs: the
    wire-contract/provisioning section in aws-cloud-bridge.md now spells
    out exactly which MQTT actions the hub policy grants and why, and
    aws-iot-setup.md's troubleshooting table adds the fast-permanent-
    reconnect-loop-after-first-command symptom with its fix.
2026-08-17 fix: scope IoT policy/rule names per environment to support multiple deploys
    Ahead of connecting Amplify Hosting: the HubIotPolicy and
    TelemetryIngestRule used hardcoded literal names, but IoT policy/rule
    names are unique per AWS account+region, not scoped per CloudFormation
    stack like a normal logical ID. That would collide the instant a
    second environment exists — e.g. this keng sandbox alongside an
    Amplify-Hosting-triggered "main" branch pipeline-deploy, each its own
    stack — causing the second deploy to fail outright on resource
    creation.
    Suffix both names with the stack's own name (already unique per
    Amplify environment by convention), sanitized for the rule name's
    alphanumeric+unde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
2026-08-17 fix: move amplify.yml to repo root in monorepo format
    Amplify Hosting build failed: "CustomerError: Monorepo spec provided
    without \"applications\" key". Configuring the app root as
    smartfarm-cloud (necessary since this repo has other top-level
    projects) puts Hosting into monorepo mode, which looks for the build
    spec at the REPO ROOT in a different shape — a top-level
    `applications:` list, each entry carrying its own `appRoot` — not the
    single-app version/backend/frontend format that lived inside
    smartfarm-cloud/amplify.yml.
    Moved the spec to the repo root with the correct wrapper (unchanged
    build commands otherwise) and removed the old file so there's only one
    spec to keep in sync. Upd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
2026-08-18 fix: use npm install instead of npm ci in Amplify Hosting build
    npm ci failed on the build with "Missing: X from lock file" for a
    long list of packages, all tracing back to @aws-cdk/toolkit-lib's own
    transitive deps (archiver, chalk, fs-extra, cdk-from-cfn, etc.) —
    pulled in by @aws-amplify/backend-cli, not by the aws-cdk devDependency
    itself (which turns out to ship pre-bundled with zero runtime deps of
    its own, a red herring at first).
    Reproduced locally: regenerated the lockfile from a fully clean state
    (cache cleared, node_modules + lockfile deleted) multiple times, and
    npm ci failed identically against every fresh regeneration — ruling out
    a stale/out-of-sync lockfile. This is npm'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
2026-08-18 feat: wire AWS IoT cert/env config into docker-compose.yaml
    Mounts ./certs read-only into /app/certs (matching WORKDIR /app in the
    Dockerfile) and passes AWS_IOT_ENDPOINT/AWS_IOT_THING_NAME through via
    ${...} substitution from the .env file docker compose auto-loads from
    its own directory — the same .env docs/aws-iot-setup.md already has
    users fill in for `npm run dev`, so one file covers both paths. Cert/
    key/CA paths are fixed relative paths matching the volume mount, not
    per-deployment overridable like ENDPOINT/THING_NAME.
    Removed docker-compose-new.yaml: a stale early draft (missing the
    /data volume, smartfarm-net network, and most env vars the real
    compose file has) that predates the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
2026-08-18 fix: update sensor task to use last known temperature and humidity values on read failure
    [main.c, sensor_task.c, task_settings.h]
2026-08-18 fix: publish one telemetry message per device, matching ingest-telemetry's contract
    Found by inspecting actual DynamoDB rows: every ingested item had
    metrics: {} and no deviceId at all. publishTelemetry() was sending one
    MQTT message per update carrying {hubId, at, devices: [...]} (the
    whole deviceStore array), but ingest-telemetry/handler.ts's
    TelemetryRuleEvent expects a flat {hubId, device_id, timestamp,
    metrics} per message — it reads event.device_id/event.metrics, which
    only exist on that shape. The array-wrapped version silently produced
    garbage rows on every single publish since it was first deployed; MQTT
    publish succeeding says nothing about whether the consumer's shape
    expectatio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
2026-08-18 fix: read fieldName from the actual pipeline-function event shape
    Dashboard showed "Cannot read properties of undefined (reading
    'fieldName')" on every query/mutation. Confirmed via CloudWatch logs
    (every single invocation of dashboard-api errored identically) and via
    `aws appsync get-function` on the deployed pipeline function's request
    mapping template: Amplify Gen2's a.handler.function() wires this Lambda
    in as an AppSync pipeline function, which sends
    {typeName, fieldName, arguments, identity, source, request, prev} as
    TOP-LEVEL event keys — not nested under `info` the way
    AppSyncResolverHandler (a *direct* Lambda resolver type) assumes. The
    handler was written against the wrong type f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
2026-08-20 feat: replace AWS cloud bridge with self-hosted MQTT + Postgres stack
    Drops Amplify Gen2 (Cognito, DynamoDB, Lambda, AppSync, IoT Core) entirely in
    favor of a self-hosted Docker Compose stack (Mosquitto + Postgres + Next.js)
    on itsci-data.local, reachable via a Cloudflare Tunnel and gated by
    Cloudflare Access instead of an in-app login. The hub's bridge is rewritten
    as src/cloud/mqttBridge.js — plain username/password wss:// instead of
    mutual-TLS X.509 + Device Shadow, fire-and-forget commands instead of
    desired/reported diffing. See docs/mqtt-cloud-bridge.md for the full design.
2026-08-20 fix: remove Dockerfile COPY of a public/ dir that doesn't exist in this project
    Caught on the first real build on itsci-data.local — this project has no
    public/ folder (not required by Next.js), so the COPY step failed the build.
2026-08-20 fix: exclude mqtt from Next.js server bundling to fix keepalive timeout loop
    Caught live on itsci-data.local: the dashboard's MQTT connection was cycling
    connect -> "TypeError: t.mask is not a function" -> keepalive timeout ->
    reconnect every ~15-30 min, silently dropping telemetry during each gap.
    webpack bundling ws (mqtt's WebSocket transport) breaks its frame-masking
    implementation, which relies on Node's native require() resolution. The hub
    side (plain Node, no bundler) never hit this, which is what pointed at
    Next.js's server bundling rather than a real network/broker issue.
2026-08-20 fix: pass NEXT_PUBLIC_HUB_ID as a Docker build arg, not a runtime env var
    NEXT_PUBLIC_* vars are inlined into the client-side bundle at `next build`
    time; docker-compose's `environment:` only sets vars for the running
    container, which the already-built browser bundle never sees. The browser
    was silently querying hubId=default-hub (the code's fallback) the whole
    time, while manual curl tests with an explicit ?hubId= masked the bug by
    not depending on it. Confirmed live: dashboard showed "No telemetry" and no
    pump entry despite the API genuinely having data under hubId=rasp-01.
2026-08-21 feat: add fan icon to PumpControlCard for visual indication of pump status
2026-08-25 feat: add water-temp-node LoRa sensor + lora-gateway (WL55, AS923)
    New NUCLEO-WL55JC1 battery sensor node measuring hot/cold water temperature
    (2x DS18B20) and battery level, sending compact binary telemetry over raw
    point-to-point AS923 LoRa, then deep-sleeping (Stop2 + RTC, 15 min, uplink-only).
    Power to the DS18B20 rail is gated by an A0341 P-MOSFET during sleep; battery is
    read via VREFINT (no external parts).
    Since the web-server only ingests HTTP/JSON on the WiFi LAN, add a second WL55 as
    a receive-only lora-gateway plus a standalone Node.js serialport bridge:
    node (LoRa) -> gateway (WL55 RX) -> bridge.js (USB CDC -> HTTP) -> web-server:3000
    - STM32Cube HAL (framework=stm32cube),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
2026-08-25 fix: build water-temp-node + lora-gateway on STM32duino (compiles clean)
    The firmware was written for framework=stm32cube, but PlatformIO has NO stm32cube
    framework for the STM32WL family (no framework-stm32cubewl package in the official
    or maxgerhardt platforms; the nucleo_wl55jc board offers only arduino/zephyr), so
    it could never build. Switch both projects to framework=arduino (STM32duino),
    which IS the STM32Cube HAL underneath -- the hand-written HAL_SUBGHZ LoRa driver,
    DS18B20, and packet code compile unchanged.
    Changes:
    - framework stm32cube -> arduino; enable HAL_SUBGHZ via STM32duino's
    include/hal_conf_extra.h hook (replaces the project stm32wlxx_hal_conf.h).
    - main.c -> main.cpp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
    [battery.cpp, ds18b20.cpp, gateway_config.h, main.c, main.cpp]
2026-08-25 feat: add DS18B20 bring-up test env for STM32F103C8T6 (Blue Pill)
    While the NUCLEO-WL55JC1 boards are on back-order, add a second PlatformIO env to
    validate the DS18B20 sensor + wiring on a cheap Blue Pill, reusing the SAME
    ds18b20.cpp driver the node ships (no copy).
    - [env:bluepill_f103c8]: board=bluepill_f103c8, framework=arduino, stlink upload,
    USB CDC serial (-DUSBCON -DUSBD_USE_CDC). build_src_filter compiles only
    ds18b20.cpp + src/test/ds18b20_test_main.cpp; the WL55 env filters out src/test/.
    - src/test/ds18b20_test_main.cpp: reads two probes (hot=PB6, cold=PB7, direct 3V3,
    no MOSFET gate) once/sec, prints over USB CDC with FAULT(no presence)/(crc)
    detail, blinks PC13 on a g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
2026-08-25 feat: DS18B20 test — semihosting-over-SWD env, internal-pullup fallback, all-zero guard
    Hardware bring-up on the STM32F103C8T6 revealed two gaps, both fixed here (and
    verified: both probes now read real room temp ~24 C over SWD, no external parts):
    - Semihosting output env: on a clone Blue Pill whose native USB wouldn't
    enumerate, add [env:bluepill_f103c8_semihosting] (-DUSE_SEMIHOSTING). The test
    main prints via ARM semihosting (BKPT 0xAB / SYS_WRITE0) viewed in the OpenOCD
    console over the ST-Link — no USB, UART, or adapter needed. Test main refactored
    to a unified out() that is USB CDC or semihosting per the env.
    - Internal pull-up fallback: with no external 4.7k on hand, gat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
    [ds18b20.cpp, ds18b20_test_main.cpp]
2026-08-25 chore: enable semihosting in the F103 debug session (VSCode-friendly)
    Add `debug_extra_cmds = monitor arm semihosting enable` to the
    bluepill_f103c8_semihosting env so starting a PlatformIO debug session (F5)
    streams the DS18B20 readings into the VSCode Debug Console over SWD — no manual
    OpenOCD command needed.
2026-08-25 docs: document semihosting test flow; make F103 banner reflect pull-up mode
    - README: DS18B20 F103 section now covers both output paths (USB CDC vs
    semihosting over SWD) with CLI + VSCode (F5/Debug Console) steps, the
    internal-pull-up fallback, and the all-zero-scratchpad driver note.
    - ds18b20_test_main.cpp: startup banner prints "internal ~40k pull-up" vs
    "external 4.7k pull-up" per DS18B20_INTERNAL_PULLUP (was hardcoded 4.7k).
2026-08-25 feat: add SX1278 (SX127x) external LoRa bench self-test env for F103
    While the WL55 boards are on back-order, add a standalone SX1278 module + SPI
    wiring check on the Blue Pill (separate from the WL55's internal SX126x driver).
    - src/sx1278.{h,cpp}: minimal SX127x LoRa driver over Arduino SPI (reset, SPI
    probe, LoRa config, blocking TX, RX poll). Takes freq_hz (also works for a
    high-band SX1276). NOTE: SX1278 is 433 MHz -> cannot reach the 923 MHz gateway.
    - src/test/sx1278_test_main.cpp: reset -> read RegVersion (expect 0x12) -> config
    433 MHz SF9/BW125/CR4-5 -> TX a beacon every ~3s (SX1278_RX_MODE to listen).
    - [env:bluepill_f103c8_sx1278]: semihosting output over SWD. Wiring NSS=P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
    [sx1278.cpp, sx1278.h, sx1278_test_main.cpp]
2026-08-26 feat: Raspberry Pi LoRa receiver + F103 node sender (433 MHz prototype path)
    Adds a single-box alternative to the WL55 gateway: an SX1278 on the Pi's SPI0
    receives node frames directly and POSTs telemetry — for the 433 MHz prototype
    while the WL55 boards are on back-order.
    - lora-pi-receiver/ (Python, standalone; web-server UNCHANGED):
    * sx127x.py — SX1278 driver over spidev + gpiozero (port of node sx1278.cpp)
    * lora_packet.py — decode of the 12-byte frame (port of lora_packet.h),
    unit-tested byte-compatible (incl. crc8(0x00*11)==0, CRC/length rejection)
    * receiver.py — RX -> decode -> map node_id->device_id -> POST (stdlib urllib)
    * lora-pi-receiver.service (systemd),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
2026-08-26 docs: document apt/venv install for the Pi receiver (Bookworm PEP 668)
    Raspberry Pi OS Bookworm blocks system-wide `pip install`
    (externally-managed-environment). Document the apt path (python3-spidev /
    python3-gpiozero / python3-lgpio — all Debian-packaged, no venv needed) as the
    primary, with a --system-site-packages venv as the isolated alternative, in the
    README setup and requirements.txt.
2026-08-26 feat: standalone F103 node env (no semihosting) + record verified end-to-end
    Add [env:bluepill_f103c8_node_standalone] — the same DS18B20 -> 12-byte frame ->
    SX1278 TX node but WITHOUT -DUSE_SEMIHOSTING, so it runs autonomously on any
    USB/battery power (semihosting BKPT faults with no debugger; out() falls back to
    a harmless UART Serial). Flash once, then just power the board. Builds clean
    (Flash 29.5%).
    The full 433 MHz prototype is now hardware-verified end to end: F103 node ->
    SX1278 -> Pi SX1278 (SPI) -> lora-pi-receiver/receiver.py -> web-server (HTTP 2xx),
    dashboard water-temp-01 temps matched the node exactly at RSSI ~-64 dBm /
    SNR ~13 dB. Recorded in CLAUDE.md.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
2026-08-26 fix: correct systemd unit paths + make .env optional for the Pi receiver
    The unit pointed at /opt/smartfarm/... and required EnvironmentFile, so
    `systemctl enable --now` failed ("unavailable resources") on a ~/workspace clone
    with no .env. Point WorkingDirectory/EnvironmentFile at a real clone path, run as
    User=pi (in spi+gpio groups by default), and make .env optional (leading '-') so
    it starts on the defaults.
2026-08-26 fix: make Pi receiver tolerant of systemd EnvironmentFile inline comments
    systemd's EnvironmentFile keeps inline "# comments" in the value (unlike a
    shell), so a `.env` copied from the example crashed int() on
    `LORA_BW_CODE=7 # 7 = 125 kHz`. Two fixes:
    - .env.example: move all comments to their own lines (never after a VALUE).
    - receiver.py: _clean()/env_int() strip a trailing inline comment + whitespace
    before int()/json parsing, so either .env format works.
    [receiver.py]
2026-08-26 feat: add BME280 (air temp/humidity/pressure) to the F103 node via frame v2
    Adds an ambient BME280 to the Blue Pill node alongside the two DS18B20 water
    probes. It sits on I2C2 (PB10=SCL/PB11=SDA) because I2C1/PB6-7 is the DS18B20 bus;
    read via the Adafruit BME280 lib, addr 0x76.
    - lora_packet.h: ADD v2 (magic 0xA2, 18 bytes) = v1 first 10 bytes + air_temp
    (i16 c-degC), humidity (u16 %x100), pressure (u16 hPa x10), new flag bits, and
    lora_packet_pack_v2(). v1/12-byte is UNCHANGED, so the WL55 923 MHz path is
    untouched — only the F103+BME280 433 path sends v2.
    - node_sender_main.cpp: read BME280 (Wire2 on PB11/PB10) + pack v2. Both node envs
    get lib_deps = Adafruit BME280.
    - lora-p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
2026-08-26 feat: add sea-level pressure (pressure_msl) to the Pi receiver
    New ALTITUDE_M env (default 0 = off). When set, receiver.py reduces the BME280
    station pressure to mean sea level (temperature-corrected formula using the
    frame's air_temp, else 15C standard) and reports it as `pressure_msl` alongside
    the raw `pressure`. Verified: 966.1 hPa @310m/23.65C -> 1001.1 hPa MSL; no-op at 0m.
    [receiver.py]
2026-08-26 docs: DS18B20 long-run (10-20m) guidance; MAX485 is not for the 1-Wire line
    Answers the "can we use MAX485 to extend the DS18B20?" question: no — a MAX485
    (directional differential UART transceiver) cannot sit on a 1-Wire line
    (bidirectional open-drain, direction reverses mid-bit-slot). For 10-20 m, plain
    1-Wire per Maxim AN148 is correct.
    - README: new "Long DS18B20 runs (up to ~20 m)" section — external ~2.2k pull-up
    (not internal ~40k), twisted-pair DQ+GND, 3-wire power, optional series R;
    escalation to DS2483/DS2480B line-driver or remote-MCU+RS-485 only past ~30 m.
    - platformio.ini: comment the two node envs marking that DS18B20_INTERNAL_PULLUP
    is bench/short-bus only — for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
2026-08-27 feat(water-temp-node): external 4.7k DS18B20 pull-up + bus diagnostics
    The bench DS18B20 bus is rewired with an external 4.7k pull-up (DQ->3V3
    per probe), so ds18b20_init() now takes the GPIO_NOPULL path.
    Because that choice has flipped between internal and external several
    times, it is no longer duplicated per env: `ds18b20_pullup` in
    [bluepill_base] is the single switch every F103 env interpolates (empty =
    external resistor, -D DS18B20_INTERNAL_PULLUP = internal ~40k bench
    fallback). The WL55 env is deliberately outside it -- the real node always
    has its resistors.
    Adds bus diagnostics, after a rewire silently held both DQ lines low:
    - ds18b20_read_scratchpad(): the raw 9-byte read, no v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
    [ds18b20.cpp, ds18b20.h, ds18b20_dump_main.cpp, node_sender_main.cpp]
2026-08-27 docs(water-temp-node): hardware interface spec for the two-PCB build
    The real (non-breadboard) node is fixed as two PCBs: the NUCLEO-WL55JC1
    as the brain, and a custom front-end PCB stacked above it on the morpho
    CN7/CN10 headers (2x19 male, 2.54 mm) via two 2x19 sockets.
    docs/hardware-interface.md specifies that joint:
    - The stack and its mechanics -- socket strips at both long edges, M3
    standoffs, stack height, and an antenna keep-out cut in the front-end.
    Includes keying: two symmetric 2x19 headers mate rotated 180 degrees
    just as happily as the right way round, which puts VBAT on a signal
    pin, so one position is depopulated as a hard key.
    - The six signals crossing the connecto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
2026-08-27 feat(water-temp-node): add SHT45 + SCD41 (CO2) via LoRa frame v3
    Adds two I2C sensors to both node builds: an SHT45 (air temp/humidity,
    0x44) and a Sensirion SCD41 (photoacoustic NDIR CO2, 0x62).
    Frame v3 (magic 0xA3, 20 bytes) appends co2 to v2's layout. v1 and v2 are
    byte-unchanged and lora_packet_unpack() now accepts all three, so an older
    node in the field keeps working against a current gateway.
    Drivers are hand-rolled from the datasheets over a shared sensirion_i2c
    helper (16-bit BE words each followed by CRC-8 poly 0x31/init 0xFF - not
    the frame's lora_crc8), so the WL55 env still has zero lib_deps.
    SHT45 supersedes the BME280 for air temp/humidity; the BME280 keeps
    pressure only.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
2026-08-27 feat(water-temp-node): front-end becomes an ARDUINO shield; SENS_GATE PA8 -> PB2
    Switches the front-end PCB from a morpho-stacking board (CN7/CN10) to an
    ARDUINO Uno V3 shield (CN6/CN8/CN9/CN5).
    PA8 is one of the few MCU pins the Nucleo brings out ONLY to the morpho
    headers - UM2592 Table 17 exposes just 24 I/Os and PA8 is not among them -
    so a shield physically cannot reach it. SENS_GATE moves to PB2 (A1,
    CN8-2): its sole alternate function is ADC1_IN4, the STM32WL has no boot
    strap there (BOOT0 is PH3, nBOOT1 is an option byte), and it sits on the
    CN6/CN8 edge so the FET, its 100k and the battery input stay in one
    corner - which is what you want for a 205 mA switch.
    Firmware change is th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
2026-08-29 feat(water-temp-node): 6 DS18B20 probes + 3 SHT45; front-end cabled to CN10
    Three changes that share the same files, so they land together.
    1. Six DS18B20 probes (was two) -- LoRa frame v4, 28 bytes
    One pin per probe, SKIP ROM: they convert in PARALLEL, so six probes
    cost one 750 ms wait, not six, and a shorted probe takes down only
    itself. Probes 0/1 keep the v1 wire slots and their HOT/COLD flags, so
    the dashboard's temp_hot/temp_cold history stays one continuous series.
    2. Front-end is now a large custom PCB joined by a CABLE (was a shield)
    Six probe connectors + the I2C parts do not fit an Uno outline. All 12
    logic signals ride one 2x19 IDC ribbon on morpho CN10; batt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
    [gateway_config.h, lora_packet.h, lora_packet.py, main.cpp, node_config.h, node_sender_main.cpp, receiver.py, tca9548a.cpp]
2026-08-29 docs(water-temp-node): name verified TVS parts for the DQ lines
    Adds the three candidates checked against the <50 pF / V_RWM >= 3.6 V spec,
    with LCSC prices and stock as of Aug 2026:
    Bourns CDSOD323-T05LC 5.0 V 1.0 pF SOD-323 ~$0.47 <- recommended
    onsemi ESD9B5.0ST5G 5.0 V 15 pF SOD-923 ~$0.018 <- budget, tiny
    BORN BSD3C031L2 3.3 V 1.4 pF SOD-323 ~$0.06 <- REJECTED
    The rejection is the useful row: everything about BSD3C031L2 is good except
    that VSENS reaches 3.6 V on a fresh cell, above its rated standoff, and its
    200 nA leakage is only guaranteed at 3.3 V. That is exactly the failure the
    V_RWM >= 3.6 V line exists to catch.
    Also records three things the bare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
2026-08-29 docs(water-temp-node): clarify GND returns vs guards on the CN10 ribbon
    "signal return A" / "signal return B" read as two different nets. They are
    one net -- GND -- reached at two positions, CN10-9 and CN10-20. Renamed to
    "GND return 1 of 2" / "2 of 2" everywhere, and added a short section stating
    the distinction the ribbon actually depends on:
    Return (CN10-9, CN10-20) grounded BOTH ends, carries return
    current, keeps the loop area small
    Guard (CN10-6/10/18/24/34, NC) grounded at the FRONT-END only, carries
    no return current, works capacitively
    Also notes why CN10-32 AGND is not a third return: digital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
2026-08-29 docs(water-temp-node): say what to draw on every J7 pin in the schematic
    "Float or ground the spares?" has three different answers on CN10, and
    grounding is wrong for 22 of the 38 positions. Adds a table that accounts
    for all 38 exactly once:
    11 contract signals (incl. both GND returns) -> the net
    5 NC on the Nucleo (6,10,18,24,34) -> GND, guard at this end
    13 unused MCU pins -> no-connect flag, float
    9 RF switch / TCXO / AVDD / AGND / VCP / 5V -> no-connect flag, never
    Never ground an unused MCU pin: it is a GPIO, and firmware driving it
    push-pull high then shorts it (26/28/30 are the user LEDs and would sink
    current continuously). Neve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
2026-08-30 docs(water-temp-node): add Thai translation of the hardware interface spec
    New file docs/hardware-interface.th.md, a full translation of the hardware
    spec. The English file stays the SOURCE OF TRUTH and now links to the Thai
    one saying so -- the firmware comments cite the English path, and a spec
    with two live versions needs one side to win when they drift.
    Translation policy, stated in the file's own header:
    - NOT translated, deliberately: part numbers, pin names (PA8), signal names
    (SENS_GATE), connector positions (CN10-16), code identifiers, file paths
    and units. Translating those makes them unusable against the schematic,
    the datasheets and the firmware.
    - ALL 7 ASCII diagrams ar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
2026-08-30 docs(water-temp-node): verify AO3401A against the 250 mA load; fix part number
    The gate FET was never in doubt on current -- it is over-specified by more
    than an order of magnitude -- but two things in the doc were wrong.
    1. "A0341" is not a real part number. It is AO3401 with the letter O read as
    a digit zero, and it had propagated into CLAUDE.md, README.md,
    node_config.h, main.cpp and both copies of the hardware spec. Corrected to
    AO3401A everywhere (8 sites). The README's ASCII gate diagram now says
    "Q1" instead of the part name, so the box stops needing to be re-aligned
    every time the part changes; the part is named in the prose beside it.
    2. I_DSS was budgeted at the 25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
    [main.cpp, node_config.h]
2026-08-30 Add CLAUDE documentation for pump-zone, sensor-zone, water-temp-node, and web-server
    - Introduced pump-zone: PlatformIO/ESP-IDF port for ESP-WROOM-32 to control irrigation pump with HTTP server.
    - Added sensor-zone: PlatformIO/ESP-IDF port for ESP-WROOM-32 to read DHT22 and soil moisture, posting telemetry to Node web-server.
    - Created water-temp-node: PlatformIO/Arduino firmware for NUCLEO-WL55JC1, a battery-powered LoRa multi-probe water-temperature and air/CO2 sensor node.
    - Established web-server: Node.js/Express hub with React/Redux dashboard, including new API endpoints for device management, health checks, camera feeds, and AI features.
2026-08-30 feat: Add sourcing documentation for Thailand components
    - Created sourcing-th.md to provide manufacturer part numbers and substitution guidelines for components used in the water-temp-node project, specifically for sourcing from Thailand.
    - Included details on local suppliers and recommendations for ordering parts in stages.
    refactor: Update node_config.h for S88 CO2 sensor integration
    - Removed SCD41 references and replaced with Senseair S88 LP CO2 sensor configuration.
    - Adjusted GPIO assignments and clarified the purpose of various pins.
    - Updated comments to reflect changes in sensor architecture and communication protocols.
    fix: Modify battery voltage reading to accommodate 24V bank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
    [battery.cpp, battery.h, ds18b20.cpp, main.cpp, node_config.h]
2026-08-31 Update hardware documentation for water-temp-node
    - Revised I2C scanning procedure and clarified the absence of SCD41.
    - Enhanced details on power supply components, including buck converters U6 and U7, with emphasis on ripple injection and component specifications.
    - Added specific part numbers and alternatives for inductors and capacitors, ensuring clarity on requirements for both rails.
    - Included detailed explanations on the feedback divider differences for U6 and U7, and the importance of ripple injection values.
    - Updated sourcing information for components, emphasizing the need for proper voltage ratings and specifications.
2026-09-01 Update hardware documentation for clarity and accuracy
    - Revised the schematic details for the S88 sensor interface, specifying U7 3.3V instead of VBAT.
    - Clarified the copper trace routing instructions for power connections.
    - Enhanced component specifications for Q2, including the correct part number and additional details on gate clamping.
    - Updated the fuse specification to emphasize I²t ratings and preferred types.
    - Added detailed explanations regarding the Q2 FET orientation and its implications for reverse polarity protection.
    - Included additional test points and their significance in troubleshooting.
2026-09-02 docs(water-temp-node): hardware rev 1.0 — replace LM5164 discrete bucks with Traco TSR 1 modules
    U6/U7 were two TI LM5164 constant-on-time converters with a hand-tuned
    Type-3 ripple-injection network, ~30 passives and a shared 16 V UVLO
    divider. Too much to get right on a first board, so revision 1.0 swaps
    them for off-the-shelf Traco TSR 1-2450 (5 V) and TSR 1-2433 (3.3 V)
    modules: 36 V input, 1 A, ±2 %, SIP-3 78xx footprint, no external
    network. The DFRobot DFR0570/0571 that were first proposed are 28 V
    parts and a 24 V bank sits at 28.8–29.2 V every afternoon, so any
    substitute must be rated ≥36 V.
    What the swap gives up, all written down in §5 "The buck modules":
    - ≥60 V part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
2026-09-02 docs(water-temp-node): close the TSR 1 open items against the datasheet
    All four ⚠ markers from the rev 1.0 power-stage rewrite are resolved from
    the Traco TSR 1 datasheet (rev. 2026-07-02) and Digi-Key TH (2026-09-02):
    - Pinout confirmed 1 = +Vin, 2 = GND, 3 = +Vout; Traco's "no PCB traces
    under the converter" added as layout rule 4
    - No-load input current is 1 mA typ per module (no max published), so the
    energy budget drops to ~1.15 Wh/day for the pair and ~3.8 Wh/day total;
    bring-up step 1 still measures it
    - No absolute-maximum input is published beyond the 36 V operating limit,
    but the datasheet requires an external 22 µF / 50 V input capacitor for
    Vin > 32 V — C12/C19 c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
2026-09-02 fix(water-temp-node): correct the S88 Modbus driver and document the sensor properly
    The S88 register map was never read; node_config.h carried placeholders and
    s88.cpp guessed. Verified against Senseair TDE14367 rev 5, TDE15154 rev 1,
    PSP14281 rev 4, PSP15075 rev 3 and PSP14808 rev 2.
    The driver was wrong in a way that would have shipped:
    - CO2 is INPUT register IR4 (0x0003) read with function 0x04. The driver used
    function 0x03, which at that address is the pressure holding register.
    - Slave address 0x68 was invented. 0xFE ("any sensor") is what Senseair's own
    examples use and is correct on this single-drop link; the factory individual
    address is in HR20 and is not published.
    - The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
    [main.cpp, node_config.h]
2026-09-02 feat(water-temp-node): hardware rev 2.0 — CO2 is an SCD41 on I2C; RS-485 and the 5 V rail are deleted
    The deployment is a mushroom house (โรงเรือนเพาะเห็ด): dark, 90-95 %RH, misted,
    15-30 C, CO2-rich by design. Nothing in the repo said so, and much of the spec had
    been written for a plant greenhouse — sun loads, radiation shields, crops drawing
    CO2 down in daylight. The Senseair S88 LP chosen in 2026-08 is an 0-85 %RH part
    whose RH limit derates to 45 % at 50 C, so it had to go.
    The CO2 sensor is now a Sensirion SCD41 on I2C at 0x62, mux channel 3, on a 5 m
    22 AWG cable to mid-house at crop level. It is 2.4-5.5 V, so it runs from the same
    3.3 V as everyth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
2026-09-02 docs(water-temp-node): make the spec describe the board, not the one it replaced
    Rev 2.0 landed with the S88 threaded through the whole spec — thirty mentions in
    the English file — because most sections were written as "the S88 did X, the
    SCD41 does Y". That is the wrong shape for a build document: a reader following
    it to lay out a board should be told what this board is, not what an older one
    was. Rewritten so the current design is stated directly.
    One genuine leftover: the §2 signal table still referred to `V5_S88` by name, a
    net this revision does not generate.
    Sections rewritten to stand on their own — the CRC argument, the four reasons an
    NDIR sensor usually needs continuous p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
2026-09-03 Refactor node configuration and SCD41 handling for improved clarity and accuracy
    - Updated comments in node_config.h to clarify the status of DQ_P4 and the CO2 sensor's power requirements.
    - Revised I2C sensor bus description to include SCD41 and its connection details.
    - Adjusted SCD41 documentation in scd41.h to reflect changes in power-up timing and measurement accuracy, emphasizing the importance of discarding the first reading after power cycling.
    - Enhanced explanations regarding the sensor's operational characteristics and power management strategies.
2026-09-03 docs(water-temp-node): add detailed PCB drawing instructions for Altium Designer 17
2026-09-03 docs(water-temp-node): update PCB documentation with recovery steps and library management
2026-09-04 Add sourcing documentation updates and new footprint generation script
    - Updated sourcing-th.md with detailed component specifications and clarifications for C11, C19, F1, and J14.
    - Introduced MakeFootprints.pas script to automate the creation of custom footprints not covered by vendor libraries.
    - Created WaterTempNode_Scripts.PrjScr project file to facilitate the execution of the MakeFootprints script within Altium.
2026-09-04 feat: add MakeFootprints script and project configuration for PCB footprint generation
2026-09-04 docs(water-temp-node): update PCB documentation with schematic audit results and layout guidelines
2026-09-08 Add documentation for home etching process and update sourcing details for connectors
    - Created a new document detailing the home etching process for the STM32WL prototype, outlining materials, design rules, and step-by-step instructions.
    - Updated sourcing information in sourcing-th.md for J7 and CN6 connectors to reflect changes in specifications and part numbers, including notes on keying and compatibility.
2026-09-08 feat(water-temp-node): add STM32WL_PT, the self-etched board, and bring both Altium projects into the repo
    Renames the finished front-end board WaterTempNode_FE -> STM32WL_FE (after the
    MCU, now that a second board exists) and adds STM32WL_PT: the same circuit in
    through-hole packages, etched double-sided at home, which replaces the SMD board
    as the deployed node. No board had been ordered, so the rename was free.
    Both Altium projects move from C:\Users\Public\Documents\Altium\Projects\ into
    the repo, where they are versioned for the first time. Vendor libraries are
    promoted to hardware/Lib/ and shared by both projects. History/ and Project
    Outputs/ stay ignored; ST's 35 MB mb1389_bdp refer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
    [Buck-regulator.SchDoc, FrontEnd-rev1-superseded.SchDoc, FrontEnd-signals.SchDoc, I2C-sensors.SchDoc, STM32WL_FE-BOM.csv, STM32WL_FE.PcbDoc, STM32WL_FE.PcbLib, STM32WL_FE.PrjPcb]
2026-09-08 chore(water-temp-node): track Altium text sources only, untrack the binaries
    Drops the .SchDoc, .PcbDoc, .SchLib, .PcbLib, .Cam, .pdf and .step files and the
    whole of hardware/Lib/ from tracking, and ignores them. What stays is the text:
    .PrjPcb and .OutJob (INI), .Dat, .PrjScr, the .pas footprint scripts, the BOM
    csv, and the documentation.
    The files are untouched on disk -- this is git rm --cached, not a deletion.
    Consequence worth knowing: the schematic and the PCB are no longer recoverable
    from this repository. The .PrjPcb records which documents a project is made of
    and where its libraries are, but not what is drawn on them. Back the drawings up
    somewhere else.
    Blobs committed in 527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
    [Buck-regulator.SchDoc, FrontEnd-rev1-superseded.SchDoc, FrontEnd-signals.SchDoc, I2C-sensors.SchDoc, STM32WL_FE.PcbDoc, STM32WL_FE.PcbLib, STM32WL_PT.PcbDoc, STM32WL_Pt.PcbLib]
2026-09-08 docs(water-temp-node): add the Thai build sheet
    Thai mirror of build-sheet-proto.md, following the convention of the existing
    .th.md files: the English file stays the source of truth, and part numbers,
    designators, signal names, pin names and units are left untranslated because a
    translated `24V_PROT` is not something you can look for on a board.
    This is the mirror that matters most of the four. The build sheet is the only
    one of these documents that gets used with the board in your hands, in a
    workshop, and it is the only thing on site that says which way round C11 goes --
    this board has no silkscreen. It is the copy that should be printed and put in
    the enclosure lid.
    Checked for structu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
2026-09-08 docs(water-temp-node): add the Thai etch process, and close its own open item
    Thai mirror of pcb-home-etch.md, the second of the two documents that get read at
    a bench rather than at a desk. Same convention as the others: English stays the
    source of truth; designators, signal names, layer names, Altium menu paths and
    units are left untranslated.
    Its cross-references point at the Thai build sheet rather than the English one,
    so the two bench documents form a closed Thai pair -- someone printing them out
    never has to switch languages mid-stage.
    Also removes the "Not yet written" section from the English file: build-sheet
    -proto.md exists now, and so does this mirror. Replaced with a pointer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
2026-09-08 docs(water-temp-node): teach CLAUDE.md that there are two boards now
    CLAUDE.md is loaded into context for every session that touches this directory,
    so a stale claim here is not a documentation problem -- it is wrong information
    delivered to every future session automatically. It described the Traco TSR
    1-2433 as the node's regulator and named DFR0570 as a part to avoid, both of
    which stopped being true of the deployed board.
    Adds a two-board paragraph up front: STM32WL_FE is the SMD design, never
    ordered; STM32WL_PT replaces it as the deployed node, same circuit and same
    fifteen-signal contract, through-hole, hand-etched. Only §4a and §5 of the spec
    differ, and hardware-interface-proto.m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
2026-09-08 docs(water-temp-node): add D10 to the 24V_PROT netlist table
    The node table in §5 listed D9, C11, C19, U7 and R24 but not D10, and D10's
    cathode is on that node: Q2 is a P-FET wired drain-to-supply, so its source is
    the load side, and the load side is 24V_PROT. Found by the user while checking a
    net pin count against the table -- not by any tool.
    The omission is worth more than the fix. This table opens by saying it exists
    because "polarity is where this node gets destroyed", and D10 reversed is one of
    the destruction modes the repo has already recorded once: §1 of pcb-altium.md
    describes it being drawn backwards on the FE board, where cathode at the gate
    instead of the source turns a 12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
2026-09-09 chore(water-temp-node): drop the libraries STM32WL_PT stopped using
    The proto sheets no longer carry a DMP6023LE-13, an SMBJ33A or a test pad:
    Q2 became an IRF9540N, D9 a P6KE33A, and the test-point question was settled
    the way the spec always had it (none this revision, and on bare copper every
    pad is a test point anyway). Those libraries were deliberately kept attached
    until the parts were actually swapped -- pcb-altium.md 2.1a -- and that has
    now happened, so they come off.
    STM32WL_PT.SchLib joins the project in the same pass. It holds the one symbol
    this board had to draw for itself: the eight-pin DFR0570, numbered to match
    the footprint rather than collapsed to three pins.
    BZX84C12 is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
    [STM32WL_PT.PrjPcb]
2026-09-09 docs(water-temp-node): tick the PT work order, and record the R23 bug
    The schematic work order had every box unticked while the drawing was in fact
    nearly finished, so the document had stopped describing the board. This pass
    reads the three .SchDoc files back -- a netlist derived from them, not a
    memory of doing the work -- and ticks what the files actually say: all 69
    footprints on the -PT set as their current model, the whole pre-regulator
    block wired pin for pin, C19 moved to 24V_PRE at 35 V with C11 left on
    24V_PROT at 63 V, U7's symbol drawn, both modules placed.
    It also records the one thing that reading found. R23 wired U3's RESET to
    GND, a pull-down on an active-low pin, where the s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
2026-09-09 chore(water-temp-node): close out the STM32WL_PT schematic
    BZX84C12 follows DMP6023LE-13 and SMBJ33A off the project -- it was the one
    left because it is two files whose names do not match their folder,
    diode-nc_pin.SchLib and SOT-23.PcbLib. What stays attached is now exactly
    what is still placed: CDSOD323-T05LC for D1-D6, AO3401A for Q1, TCA9548APWR
    for U3's symbol, and the project's own two libraries.
    The compile warning is answered at the pin rather than by lowering the rule:
    a Generic No ERC on U3 pin 3 on both boards, because a pull-up feeding an
    input will always read as no driving source and turning the check off
    project-wide would hide the day an input really is undriven.
    STM32WL_F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
    [STM32WL_PT.PrjPcb]
2026-09-09 docs(water-temp-node): a buying list for the board that gets built
    The parts list still described STM32WL_FE -- 0805 passives, a TSSOP mux, a
    Traco TSR, DMP6023LE-13, BZX84C12, SMBJ33A -- and section ง was about to be
    ordered from. Nine of its lines would have bought the wrong package and eight
    parts that exist only on the board being built were not in any list at all:
    the whole pre-regulator (Q3, Q4, D11, D12, R41, R42, C22) plus C19, which
    stopped being the same part as C11 when it moved to 24V_PRE at 35 V.
    So section ง is banner-marked as the board that was never ordered, kept
    rather than deleted -- items 28 and 32 are still right, because D1-D6 and Q1
    stay SMD on purpose, and its pe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
2026-09-09 docs(water-temp-node): the import trap, and 69 of 69 across to the board
    C11, C19 and F1 failed the first import with Footprint Not Found, and the
    reason is worth a note rather than a fix: their models carried an explicit
    path to WaterTempNode_FE.PcbLib, a library from before the projects moved
    into the repo and long gone from disk. The lands themselves were in
    STM32WL_Pt.PcbLib all along.
    They are exactly the three whose footprint name did not change. C11, C19 and
    F1 were already through-hole on the FE board, so the -PT pass asked them for
    a name they already had, nothing was edited, and not editing them preserved
    the binding. Which means the audit this document already carried -- every
    co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
2026-09-09 docs(water-temp-node): where to pick the board up from
    A stopping point, written for whoever opens this next -- which is the same
    person, a week later, which is the case this kind of note is actually for.
    What the board already has, all read back out of the .PcbDoc rather than
    remembered: 69 components on the right lands, the artwork placed (so
    DrawArtworkPT must not run again -- CheckBoardPT is the safe way to ask), the
    three import rooms deleted, and six design rules whose values are recorded
    here in mm because Altium stores them in mil. W_POWER's priority is called
    out: it sits above Width, and a W_POWER below Width is a rule that silently
    does nothing.
    MinimumAnnularRing 0.45 mm is mar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
    [STM32WL_PT.PrjPcb]
2026-09-10 docs(water-temp-node): re-audit the PT board, and record the Q1 pad bug
    Read STM32WL_PT.PcbDoc, the three .SchDoc files and both PCB ECO logs back
    after the 2026-09-10 afternoon edits. Everything the morning's entry claimed
    still holds: six design rules with the right values, origin at 20/20 mm,
    FID1-3 and both scale bars present, no rooms, and Bug 1's fix reading back as
    three GND ports and four Bar ports on the I2C sheet.
    Q1's symbol was swapped from the vendor AO3401A (G=1 S=2 D=3) to MOSFET-P from
    Miscellaneous Devices (D=1 G=2 S=3), while the footprint stayed SOT23-3-M,
    whose pads carry the AOS drawing's numbers. The schematic still reads right;
    the three nets now land one pad round fr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
2026-09-10 feat(water-temp-node): place all 69 parts on the STM32WL_PT floorplan
    PlacePartsPT.pas, the placement counterpart to SetupBoardPT.pas. Three
    runnables: CheckPlacementPT (safe), PlaceFloorplanPT, DrawKeepoutsPT.
    It locks the sixteen positions section 6 calls not negotiable - J1-J7,
    J9-J14, CN6, U3, U7 - because J1..J6 are P0..P5 and swapping two silently
    relabels which end of the greenhouse a reading came from, with nothing
    downstream reporting an error. The other 53 land on a starting floorplan,
    grouped with what they belong to and cleared against the 0.5 mm rule,
    meant to be dragged while routing.
    Every box was checked against the footprints in MakeFootprintsPT.pas:
    nothing off the 160 x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
2026-09-10 docs(water-temp-node): narrow the Bug 2 fix, and the trap inside it
    Read Q1's model and pin records back. Three things change the job:
    - The footprint is already right and already current (SOT23-3-M,
    ISCURRENT=T). Only the pin numbering is wrong.
    - A stray E3 model - a TO-92 land - rode in with MOSFET-P and sits on Q1
    as a non-current alternative. Delete it.
    - The two symbols are different shapes: AO3401A puts all three pins on
    the right edge, MOSFET-P puts the gate on the left. Restoring the
    vendor symbol breaks all three wires, which is probably why the swap
    happened in the first place.
    So the section now recommends restoring AO3401A on its merits rather than
    on reflex, and spe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
2026-09-10 docs(water-temp-node): Bug 2's pin numbering is fixed, and what it cost
    The 14:49 ECO reads correctly: NetQ1_1 on Q1-1 with R1-1 and R2-2,
    V3V3_MCU on Q1-2, VSENS on Q1-3. The nets are on the part's own pins
    again and STM32WL_FE never diverged.
    Two things the same ECO turned up:
    - AO3401A.SchLib carries its own PCB model, so restoring the symbol
    REPLACED the land: SOT23-3-M -> SOT-23-3L_AOS, the vendor's nominal
    IPC footprint, on the one part the spec already calls the board's
    real exception at 0.95 mm pitch. Second time a library binding has
    silently swapped a land here - section 6 did it to C11, C19 and F1 by
    pointing at a library that is gone, this one by pointing at one that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
2026-09-10 docs(water-temp-node): close Bug 2, verified out of the saved board
    The 14:55 ECO put Q1's land back (SOT-23-3L_AOS -> SOT23-3-M) and the
    PcbDoc was saved at 14:56. Checked against the saved file rather than
    against the ECO that claimed it, because the 14:49 round is exactly the
    case where those two disagreed:
    Q1 land SOT23-3-M
    Q1 gate net NetQ1_1, and NetQ1_2 is gone from the file
    Components 69, footprint tally unchanged across all 19 lands
    Rooms none, whatever the ECO logged
    Rules all six, MinimumAnnularRing still 0.45 mm
    The schematic now carries one PCB model for Q1, current, with no
    MODELDATAFILE0 - so it resolves as Any, which is section 6's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
2026-09-10 fix(water-temp-node): flatten PlacePartsPT's nested procedure
    DrawKeepoutsPT failed at run time with "Can't access top level variable".
    The cause was PutKeepoutBox's nested Seg procedure reaching for `Board`,
    its enclosing routine's parameter - natural Pascal, and something
    Altium's DelphiScript cannot run. The error's wording points at globals
    and its cause is the nesting.
    Split into a flat PutKeepoutSeg(Board, ...). SetupBoardPT.pas and
    MakeFootprintsPT.pas were already flat throughout, which is why neither
    ever hit this; the header now says to keep it that way.
    Claude-Session: https://claude.ai/code/session_01FyLfeWhaiDQdJczCNjr2CR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
2026-09-10 fix(water-temp-node): clear the placed board's DRC, and stop hand-typing footprints
    PlaceFloorplanPT and DrawKeepoutsPT ran clean. Verified out of the saved
    board: 69 components at exactly the scripted coordinates and rotations,
    the 16 intended locks, 12 keep-out tracks in three closed rectangles, no
    duplicates.
    Altium's DRC then found two ComponentClearance violations, Q2 against
    R38 and Q2 against D9. TO220-VERT-STAG's silk body runs +1.60 to +6.30
    ABOVE its pad row, so the part is 10.4 x 9.6 mm, not the 7.5 x 4.4 its
    pads suggest - and the pre-flight geometric check carried a hand-typed
    box that said the smaller number. Same failure as Bug 2 one level up: a
    hand-typed model of a part tha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
2026-09-10 fix(water-temp-node): check pads too - C21's land is a short circuit
    The saved board (20:56) has the two ComponentClearance violations gone and
    R38/D9 at their new positions, so that fix landed. But the DRC is not
    clear: the file carries 305 violation records, and one is a short circuit.
    RADIAL-D5-P20 puts two 2.2 mm pads on a 2.0 mm pitch, so they OVERLAP by
    0.20 mm. That is C21, the 22 uF on the 3.3 V rail, and its two pads are
    the rail and ground - on a hand-etched board the land itself shorts 3.3 V
    to GND. Make_RadialCan takes the pitch as a parameter but hard-codes the
    pad at 2.2 mm; RADIAL-D8-P35 gets away with it at 3.5 mm pitch and the
    5 mm can does not. Not yet fixed - it needs a d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
2026-09-10 fix(water-temp-node): C21's land was a short, and the TO-220 stagger was short too
    C21 goes to a 5.08 mm land with its leads bent out - the trick
    CERAMIC-P508 already uses - so no part changes and no rule is waived. At
    2.0 mm pitch there is no pad that is both wide enough for a 0.45 mm ring
    and far enough for 0.5 mm clearance, so trimming the pad was never an
    option. Make_RadialCan now carries the minimum safe pitch (2.7 mm) in its
    header, since it takes pitch as a parameter and hard-codes the pad.
    TO220-VERT-STAG's stagger goes 2.0 -> 2.5 mm. The stagger exists to solve
    exactly this and did not, because pad 1 is square: its corner reaches
    further than a round pad's edge, so the diagonal of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
2026-09-10 docs(water-temp-node): the footprint rebuild, step by step with gates
    Two footprints changed, so the library is rebuilt and the board
    re-imported. Written as an ordered work order with a check at the end of
    each step, in the same shape as pcb-home-etch.md's stages.
    Calls out the step most likely to be missed: C21 lives on
    Buck-regulator.SchDoc and its model still names RADIAL-D5-P20, which the
    rebuild deletes - so it imports as Footprint Not Found unless the model
    is repointed to RADIAL-D5-P508 with PCB Library set to Any.
    Also says not to re-run DrawKeepoutsPT, to untick Add Rooms, to reload
    the script tab before running it, and to read the DRC report rather than
    the Messages panel - each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
2026-09-10 fix(water-temp-node): the module keep-outs were in violation of themselves
    The three Clearance violations left on the board are mine, not a build
    mistake. DrawKeepoutsPT drew each module's rectangle on its BODY OUTLINE,
    which passes 1.53 mm from U3's own outer pad centres - so with a 0.95 mm
    pad radius the module's own pads sat 0.46 mm from the keep-out drawn to
    protect it, against a 0.5 mm rule, from the moment it was drawn.
    Widening the tracks in the scale-bar step made it 0.33 mm and easier to
    see; it was never the cause.
    Section 6 asks that no track cross UNDER the module, and a track cannot
    get in among the pad columns anyway - so the rectangles now span between
    the columns, inset to c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
    [STM32WL_PT.PrjPcb]
2026-09-10 docs(water-temp-node): an ECO does not update a footprint that kept its name
    Step 5 of the rebuild order was wrong and said the re-import would update
    Q2 and Q3. It does not, and it does not say so.
    Design > Update PCB Document compares the schematic to the board - the
    netlist and footprint NAMES. It does not compare the board's footprint
    geometry against the library. C21 came across because its name changed,
    RADIAL-D5-P20 -> RADIAL-D5-P508. TO220-VERT-STAG kept its name and only
    its pads moved, so nothing looked different and the old 2.0 mm stagger
    stayed on the board - which is exactly the two Clearance violations still
    standing after the rebuild.
    Read back out of Pads6 to confirm: C21 o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
2026-09-10 docs(water-temp-node): the PT board is placed and DRC-clean
    Verified out of STM32WL_PT.PcbDoc: 69 components at the scripted
    position, rotation and lock state; the 16 intended locks; C21 on
    RADIAL-D5-P508 with pads at +-2.54; Q2/Q3 stagger -2.5 mm, so the library
    geometry is finally on the board; 12 keep-out tracks at 0.25 mm in three
    closed inset rectangles with no duplicates; 8 copper artwork tracks at
    0.50 mm; all six design rules with MinimumAnnularRing still 0.45.
    DRC leaves TDisconnectedSubnets (the board is unrouted) and
    TMaxMinPadRndHoleSize x2 (F1's reamed 1.5 mm holes, documented in
    MakeFootprintsPT.pas). ShortCircuit, Clearance, ComponentClearance,
    MinWidthStubTrack, SilkToSilk a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
2026-09-10 docs(water-temp-node): the routing order, and the via budget recounted
    Adds a routing sequence for this placement - 24 V corner first (3 mm and
    least steerable), then V3V3_MCU, then VSENS treated as a third power net
    because it is 32 pads, then the six probe channels as parallel drops from
    J7, then I2C, then leftovers, then pour and stitch.
    Recounts Stage 1's pad figures off the placed board rather than leaving
    the estimates: 217 through-holes, 135 (62%) under a component body, 36 of
    those GND - was 210 / 123 (59%) / 25. The breakdown is J7 7, U3 4, U7 4,
    CN6 2, one each for six probe connectors, four I2C branches, J13 and J14,
    and seven capacitor grounds. Rule 4's argument for pouring both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
2026-09-10 docs(water-temp-node): GND is poured, not routed - and the ratsnest lies about it
    Hit while routing: a track from C11's negative to U3 runs into a keep-out
    rectangle. Those two share GND and nothing else - C11 is on 24V_PROT, U3
    runs on VSENS - so there was never a track to draw.
    GND is 47 pads, the biggest net on the board, and Altium draws a
    connection line for each one, which reads like 47 tracks waiting. Rule 4
    is that GND arrives as copper poured on both faces; the pour satisfies
    them and the lines disappear.
    Checked against the placed board: all 47 GND pads sit outside the three
    keep-outs, none within half a pad of an edge, so the pour reaches every
    one. The module rectangles being i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
2026-09-11 fix(water-temp-node): Bug 3 - Q2 and Q3 are wired through their gates
    Found starting phase A. Both TO-220s carry generic Miscellaneous Devices
    symbols - MOSFET-P and MOSFET-N - numbered D=1 G=2 S=3, against
    TO220-VERT-STAG whose pads follow the part and whose own description says
    TAB = PIN 2 = DRAIN. IRF9540N and IRF740 are 1=G 2=D(tab) 3=S.
    So 24V_RAW drives Q2's GATE at the full 18-32 V bank against a +-20 V
    V_GS maximum - the exact failure R38 and D10 exist to prevent, arriving
    through the pin they protect. No channel path input to output, so the
    board never powers up and Q2 dies on first connection. Q3's gate sits on
    24V_PROT, which D9 clamps at up to 53.3 V. Both tabs move to their gat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
2026-09-11 docs(water-temp-node): how to draw the IRF9540N and IRF740 symbols
    Step by step for Bug 3's fix, in the project's own STM32WL_PT.SchLib.
    The one non-obvious instruction is to lay the pins out in the SAME
    geometry as the stock MOSFET-P - gate left, drain upper-right, source
    lower-right - while giving them the part's own numbers. Q2's wires
    already run to those three places, so the swap keeps them connected.
    Bug 2 went the other way: restoring a box-shaped vendor symbol moved
    every pin and all three wires had to be redrawn.
    Also spells out the PCB Library = Any field on the footprint model, which
    is what stops a land swapping itself later, and ends on compiling to zero
    warnings because a flo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
2026-09-11 docs(water-temp-node): Bug 3's fix did not take, and why it looked like it did
    The symbols are right - IRF9540N and IRF740 now carry G=1 D=2 S=3 and are
    attached to Q2/Q3 with TO220-VERT-STAG. But the 12:53 ECO contains no net
    changes at all, and the board's pads still hold the original mapping:
    Q2 pad 1 (gate) on 24V_RAW, pad 2 (drain/tab) on NetD10_1.
    Cause is an ambiguity in step 4 of my own instructions. The stock
    MOSFET-P/N place pins 1 = upper right, 2 = left, 3 = lower right, and the
    sheet's wires run to those places. Drawing the replacement with pin 1
    where pin 1 used to be reproduces the old mapping exactly - the symbol
    says G=1 D=2 S=3 while the netlist by number is unchanged, so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
2026-09-11 docs(water-temp-node): close Bug 3, verified out of the saved board
    The 13:06 ECO carries all four net moves in both directions and the board
    agrees pad by pad: Q2 gate on NetD10_1, drain/tab on 24V_RAW, source on
    24V_PROT; Q3 gate on NetC22_2, drain/tab on 24V_PROT, source on NetD12_1.
    So Q2 is the reverse-polarity hookup and not the ideal-diode one - drain
    to the supply, source to the load - the gate clamp reaches the gate, and
    both tabs are back on their drains, which makes section 6's warnings
    about Q2's tab and Q3's live heatsink true again.
    Board re-verified alongside: 69 components, the 16 intended locks, C21 on
    RADIAL-D5-P508, 12 keep-outs at 0.25 mm with no duplicates, 8 artwork
    t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
2026-09-11 fix(water-temp-node): Q3's keep-out had swallowed its own pads
    Found by trying to route 24V_PROT from C11 to Q3 and being refused. The
    heatsink rectangle was 16 x 16 mm centred on the part, so all three of
    Q3's pads sat inside it, and a pad inside a keep-out cannot be routed to
    at all.
    Moved to (62,36)-(78,46), below the pads rather than around them. Q3 is
    placed at 180 degrees and TO220-VERT-STAG puts its body 1.60-6.30 mm
    ABOVE the pad row, so at 180 the body - and the heatsink clipped to it -
    sits below, y 41.6-46.4, against pads at 46.8-51.7. The rectangle stops
    at 46.0 and clears pad 2 by 0.68 mm.
    check_floorplan.py now tests containment, not only distance to the edges.
    Edge distance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
2026-09-11 docs(water-temp-node): first full check of the routed board
    474 copper tracks, DisconnectedSubnets down from 157 to 6, and no
    Clearance, ShortCircuit, ComponentClearance or MinWidth violations left.
    The surge path is right: every segment in the 24 V corner is 3.00 mm -
    24V_IN x2, 24V_RAW x4, 24V_PROT x8, GND x16 - with one 1.5 mm GND segment
    left. NetF1_1 is now 24V_IN on both schematic and board, and W_POWER's
    scope was extended to cover 24V_IN and 24V_RAW, which closes a real gap:
    the surge reaches D9 through F1 and Q2, so those carry the same 11.3 A
    and the original rule did not cover them.
    W_POWER's minimum went 3.0 -> 1.5 mm. Recorded as a decision: the corner
    that the 3 mm figure was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
2026-09-11 docs(water-temp-node): step by step for resizing the hand-made vias
    Eight of them now - two VSENS ones were removed at 00:42, taking
    DisconnectedSubnets to 5. Checked every one against every track and pad
    of a different net: all eight have room to grow to 2.0 mm, tightest is
    1.19 mm to an I2C_SDA track against a 0.5 mm rule, so nothing needs
    moving first.
    Selector is HoleSize > 2mm, unambiguous because the next largest hole on
    the board is F1's 1.5 mm. With the instruction to confirm the count reads
    8 before changing anything, since the scale-bar step used a width-based
    selector that quietly caught 20 objects instead of 8.
    Spells out why Plated must be ticked: there is no plating on this b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
2026-09-11 docs(water-temp-node): the via selector query was wrong about units
    IsPad And (HoleSize > 2mm) is a syntax error in this build - the parser
    reads the 2, meets mm and reports "expected )". Query dimensions are in
    mils whatever the editor displays, so 2 mm is written 79.
    Leads with Find Similar Objects instead, which needs no query at all, and
    calls out the part that actually catches people there: Net and Layer
    default to Same in that dialog and would cut the selection to one net.
    Keeps the query as a fallback with both unit readings and says to let the
    count decide, which is what step 3 was already for.
    Claude-Session: https://claude.ai/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
2026-09-11 docs(water-temp-node): the via resize also shrank F1's fuse clips
    The eight vias came out right - 2.0 mm pad, 0.8 mm hole, +0.60 mm ring -
    and DisconnectedSubnets fell 5 to 3. But the selector caught ten objects
    and the two extra were F1's fuse clips, whose 1.5 mm holes are the one
    deliberate exception on this board. F1 went from 3.0/1.5 to 2.0/0.8, and
    a 0.8 mm hole will not take a fuse clip leg.
    Two signatures show it without opening the board: TMaxMinPadRndHoleSize
    vanished entirely when it should have fallen to 2 - those two are F1, and
    a rule going quiet is not always good news - and TUnplatedPad went 8 to
    10 rather than 8 to 0, so the Plated tick never took and F1's pads were
    dragged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
2026-09-11 docs(water-temp-node): vias and U3 keep-out both closed
    F1 reads 3.00 mm pad / 1.50 mm hole again and the hole set is back to the
    drill sizes plus F1's reamed pair. Eleven pads at 2.0/0.8 - the eight
    vias and Q4's three legs - and TUnplatedPad is gone.
    Item 2 closed as well: all three keep-out rectangles are present and no
    track crosses U3's footprint; the six branch segments were re-routed. GND
    gained copper doing it, 87 segments at 3.00 mm against 51 before.
    Notes that the rectangles were redrawn by hand and now sit slightly
    inside the script's, so DrawKeepoutsPT would lay a second set on top -
    run ClearKeepoutsPT first or leave it. Thirteen tracks rather than twelve
    because U7's left ed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
2026-09-11 docs(water-temp-node): pour GND, and two settings to fix before doing it
    Decision: pour over the routed ground, as pcb-home-etch.md rule 4 says.
    The routed tracks stay and the pour merges with them, so nothing to
    reconcile between board and process document.
    Two problems to fix first. PolygonConnect's relief spokes are 10 mil -
    0.254 mm - against a board whose minimum feature is 0.5 mm, so every
    thermal spoke on every ground pad would etch thin, ragged or missing.
    Raise to 0.6 mm with a 0.5 mm air gap.
    And the surge-return pads have to be Direct, not Relief. Section 5 asks
    for D9's anode and C11's negative on wide copper straight back to J14's
    ground pin; four 0.6 mm spokes is not that, an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
2026-09-11 docs(water-temp-node): twelve computed stitching-via positions
    Every one clears the three keep-outs and sits at least 1.5 mm from any
    pad or track of a net other than GND, computed against the routed board,
    so they can be dropped as-is. Four in the 24 V corner as rule 4 asks.
    Says the thing most likely to go wrong: a free pad placed with No Net
    inside a GND pour is an obstacle - the pour clears around it and it ties
    nothing while looking exactly like a stitching via. And that on this
    board a via is a free pad, not a via object, because it is a wire
    soldered on both faces.
    Claude-Session: https://claude.ai/code/session_01FyLfeWhaiDQdJczC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
2026-09-11 docs(water-temp-node): GATE 1 met - routed, poured, stitched, DRC clean
    DisconnectedSubnets is zero. The DRC reports one category and two
    records: MaxMinPadRndHoleSize x2, F1's reamed 1.5 mm pair, documented in
    MakeFootprintsPT.pas.
    GND is poured on both layers with dead copper removed, and both pour
    rules landed: a priority-1 Direct rule scoped to GND on D9, C11 and J14
    so the surge return is solid copper rather than four spokes, and the
    catch-all Relief raised to 0.6 mm spokes, above the board's 0.5 mm
    minimum feature. Fifteen wire links at 2.0/0.8 plated, thirteen of them
    GND stitching with four in the 24 V corner - one over rule 4's 8-12,
    which is the safe direction, and well under rule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
2026-09-11 docs(water-temp-node): put the fifteen wire links on the build sheet
    They existed on the board and in no document anyone takes to the bench.
    Now section 4a of build-sheet-proto.md and its Thai mirror - W1-W13
    ground stitching, W14-W15 signal (DQ_P4 and V3V3_MCU) - each with
    coordinates from the board's bottom-left corner and a tick box.
    Placed as step 0 of the assembly order, before the SMD parts: a component
    sitting over a hole puts its top face out of reach of an iron, and these
    have to be soldered on both faces. Section 5 gained a line to count all
    fifteen before the first volt.
    Says why it matters in the words that will land at 1 a.m. at a bench:
    thirteen are ground, and an open ground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
2026-09-11 docs(water-temp-node): bring the pick-up section up to date
    It still said "next action: placement" after placement, routing, pouring
    and GATE 1 were all done - the one section someone reads first, and the
    most stale thing in the file.
    Now a dated summary of where the board actually stands, read out of
    STM32WL_PT.PcbDoc rather than from the dialogs: 69 components, 474 copper
    tracks, GND poured both layers, 15 wire links, 24 V surge path 3.00 mm
    throughout, DisconnectedSubnets zero. Next is pcb-home-etch.md Stage 2,
    with the scale-bar measuring trap called out because it fails GATE 2 on a
    correct print.
    Keeps the two open items - section 5's module pre-fit audit, and the fact
    that check_floo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
